unlegitGurke/RC-Car/Diplomarbeit/Athena/Eidesstattliche.tex

\vspace*{0cm}
\begin{center}
\textbf{\Huge{Eidesstattliche Erklärung}}
\end{center}
\vspace{1cm}
Wir erklären an Eides statt, dass wir die vorliegende Arbeit selbstständig und ohne fremde Hilfe verfasst, andere als die angegebenen Quellen nicht benutzt und die den benutzten Quellen wörtlich und inhaltlich entnommenen Stellen als solche kenntlich gemacht haben.\\
Wir versichern, dass wir dieses Diplomarbeitsthema bisher weder im In- noch im Ausland (einer Beurteilerin oder einem Beurteiler) in irgendeiner Form als Prüfungsarbeit vorgelegt haben.

% \usepackage{array} is required
\vspace*{3cm}
\begin{center}
\begin{tabular}{
	>{\centering\arraybackslash}p{4cm}
	>{\centering\arraybackslash}p{4cm}
	>{\centering\arraybackslash}p{4cm}}
            \hrulefill         &  & \hrulefill      \\
            Felix Sandri       &  & Philipp Kaltenleitner     \vspace*{1.5cm}\\ 
            \hrulefill         &  & \hrulefill      \\
            Mert Gürel         &  & David Petrovic            \vspace*{2cm}\\
            & \hrulefill & \\
            & Ort, Datum & \\
\end{tabular} 
\end{center}
