unlegitGurke/RC-Car/Diplomarbeit/Athena/Deckblatt.tex

% Beginn - Formatierung der Titelseite

\vspace*{3pt}
\parbox[c]{80mm}{
	\begin{Large}\textbf{HTBLuVA Salzburg }\end{Large} \newline
	\textbf{Höhere Lehranstalt für Elektrotechnik} \newline
	Ausbildungsschwerpunkt: \newline Energiesysteme und Industrieelektronik
}
\hfill
\parbox[c]{60mm}{  
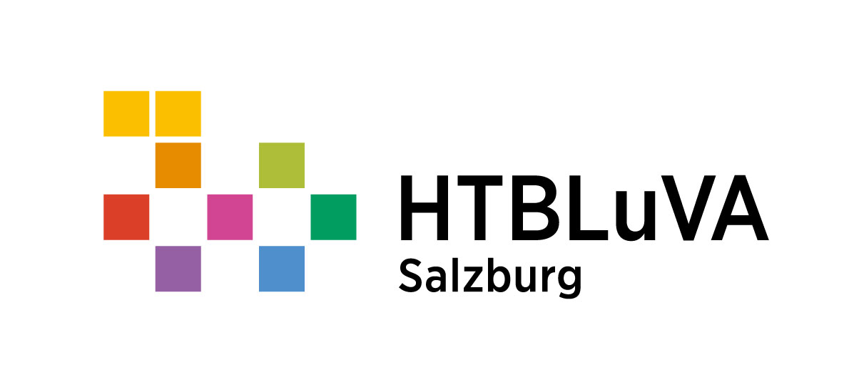
[picture p1: Diplomarbeit/Athena/Abbildungen/HTBLuVA_Salzburg_Logo_RGB.jpg]
	
}
\hrule\relax

\vspace*{30mm}
\begin{center} 
\begin{Huge}\textbf{Diplomarbeit}\end{Huge} \par \bigskip 
\begin{Large}5BHET 2023/24 \par \bigskip 
Höhere Technische Bundeslehr- und Versuchsanstalt Salzburg \par \bigskip 
Abteilung für Elektrotechnik\end{Large} 
\vspace*{20mm}

%		In der Hautpdatei nach \usepackage{a4} folgendes Einfügen:
%		\title{Entwicklung einer Diplomarbeitsvorlage}

\begin{huge}
	\makeatletter
	\textbf{\@title \\[1ex]}
	\makeatother
\end{huge}
\end{center}

\vspace{3cm}
\parbox[c]{60mm}{%
	\textbf{Ausgeführt von:}\par
	Felix Sandri\\
	Philipp Kaltenleitner\\	
	Mert Gürel\\
	David Petrovic\\
}%
\hfill%
\parbox[c]{70mm}{%
	\textbf{Betreuer}:\par
	Prof. Dipl.-Ing. Robert Fuchs\\
	Prof. Dipl.-Ing. Reinhold Benedikter\\
	BSc Simon Dantendorfer\\
	Prof. Dipl.-Ing. Timo Huemer\\
}%

\newpage
% Ende - Formatierung der Titelseite
