unlegitGurke/RC-Car/Diplomarbeit/Athena/3_Stand_der_Technik/9_Sensorik.tex

\newpage
\fancyfoot[C]{Gürel}
\section{Sensorik}
\input{./3_Stand_der_Technik/9.4_lidar.tex}

\input{./3_Stand_der_Technik/9.5_sonar.tex}

\input{./3_Stand_der_Technik/9.6_radar.tex}
	
\input{./3_Stand_der_Technik/9.7_kameras.tex}
