unlegitGurke/RC-Car/Diplomarbeit/Athena/0_Vorwort/Vorwort.tex

\chapter*{Vorwort}
	Im Rahmen der Ausbildung an der HTBLuVA Salzburg bietet die Diplomarbeit einen ersten umfassenden Einblick in wissenschaftliches und eigenständiges Arbeiten. Nur durch unser, im Laufe der letzten fünf Jahre erlentes, Wissen ist es uns möglich ein solch umfangreiches Projekt umzusetzten.  Wir sind dankbar für die herausragende Ausbildung, die uns in sämtlichen technischen Bereichen vermittelt wurde. \
			\
			Weiter bedanken wir uns bei allen Lehrpersonen, die uns im Laufe der Projektentwicklung geholfen und unterstützt haben. Besonders möchten Wir uns bei Herrn Dantendorfer sowie auch bei Herrn Maximilian Ernst Tschuchnig und Herrn Lukas Portenschlager aus der FH Salzburg für ihren Beitrag bei der Implementierung von den ROS und KI Applikationen bedanken.
			Wir hoffen, dass unsere Diplomarbeit dazu beitragen wird, das Interesse an technischen Projekten und der Elektromobilität zu wecken. Sie soll junge Menschen ermutigen, eine Ausbildung in diesem Bereich zu wählen.
