unlegitGurke/RC-Car/Diplomarbeit/Athena/3_Stand_der_Technik/11.1.4_GitHub.tex

\subsubsection{GitHub}
GitHub ist eine webbasierte Plattform für die Versionsverwaltung, die von Millionen von Entwicklern und Unternehmen weltweit genutzt wird.
Es bietet eine Vielzahl von Funktionen, darunter die Verwaltung von Repositories, Issue-Tracking, Pull-Requests, Wikis und vieles mehr. 
GitHub erleichtert die Zusammenarbeit und den Wissensaustausch zwischen Entwicklern und ermöglicht es ihnen, hochwertige Softwarelösungen effizient zu entwickeln.
