unlegitGurke/RC-Car/Diplomarbeit/Athena/3_Stand_der_Technik/9.6_radar.tex

\fancyfoot[C]{Gürel}
\subsection{Radar Sensoren}
Radar (Radio Detection and Ranging) Sensoren bestehen aus einer Sendeantenne und einer Empfangsantenne. Die Sendeantenne sendet hochfrequente elektromagnetische Wellen aus, die von Objekten reflektiert werden und von der Empfangsantenne erfasst werden. Die Zeitmessung zwischen Aussenden und Empfangen des Signals ermöglicht die Berechnung der Entfernung zum Objekt. 

Radar bietet eine effektive Möglichkeit, Entfernungen zu messen und Bewegungen zu verfolgen. Es wird häufig in der Luft- und Seefahrt, der Wetterbeobachtung, der Verkehrsüberwachung und der militärischen Anwendung eingesetzt. Im Vergleich zu LiDAR und Ultraschallsensoren bietet Radar eine größere Reichweite und ist weniger anfällig für Umwelteinflüsse wie Nebel oder Regen.
