unlegitGurke/RC-Car/Diplomarbeit/Athena/7_KI/KI.tex

\fancyfoot[C]{Gürel}
\chapter{Entwicklung KI und Sensorik}
	
	\input{./7_KI/ueberlegungen.tex}
	
	\input{./7_KI/sensorik.tex}
	
	\input{./7_KI/personenerkennung.tex}
	
	\input{./7_KI/ROS.tex}
