unlegitGurke/RC-Car/Diplomarbeit/Athena/3_Stand_der_Technik/7_Motoren.tex

\fancyfoot[C]{Sandri}
\section{Elektrische Antriebsmaschinen} \label{Motoren}
Elektrische Maschinen wandeln elektrische Energie in mechanische Energie um, indem sie das Prinzip der Lorenzkraft beziehungsweise Reluktanzkraft anwenden um einen Rotor zu rotieren. Der grundsätzliche Aufbau eines elektrischen Motors besteht grundsätzlich aus einem Stator, dem nicht-rotierendem Teil, und einem Rotor, dem sich rotierenden teil. Je nach Typ und Ausführung des Motors sind auf beiden Komponenten Wicklungen beziehungweise Dauermagnete befestigt. Bei einigen Motoren sind auch noch andere Bauteile verbaut.

\subsubsection{Lorentzkraft}
	Die Lorentzkraft wirkt auf bewegliche Lasungsträger in einem Magnetfeld. Sie wirkt senkrecht zur Bewegungsrichtung der Ladung und senkrecht zu den Feldlinien des Magnetfelds. Wie sich die Lorentzkraft verhält, lässt sich anhand folgendem Beispiel, einer Leiterschaukel erklären:

	\begin{figure}[H]
			\centering
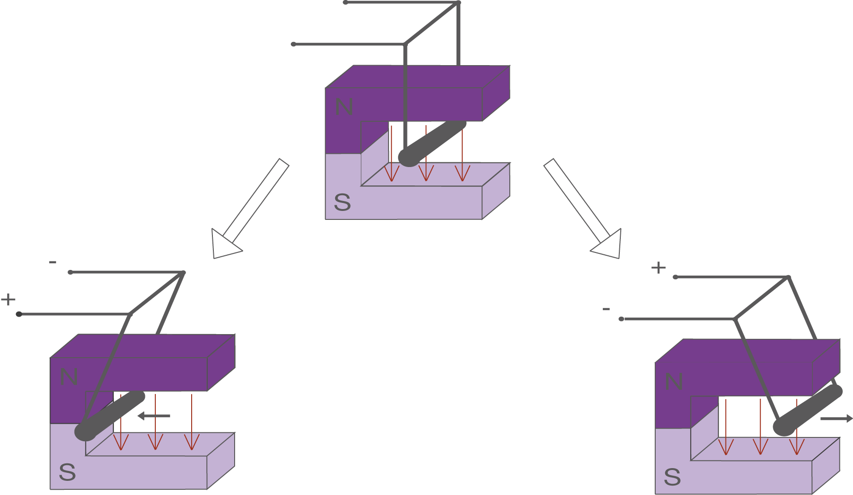
[picture p59: Diplomarbeit/Athena/3_Stand_der_Technik/Abbildungen/Leiterschaukel_1.png]
			
			\caption{Änderung der Stromrichtung Lorentzkraft\cite{schullv.de2024}}
	\end{figure}
	
	Die Richtung in welche die Leiterschaukel ausschlägt, ist zum einen Abhängig von der Richtung des Stroms und zum anderen von der Orientierung des Magnetfelds.
	
	\begin{figure}[H]
			\centering
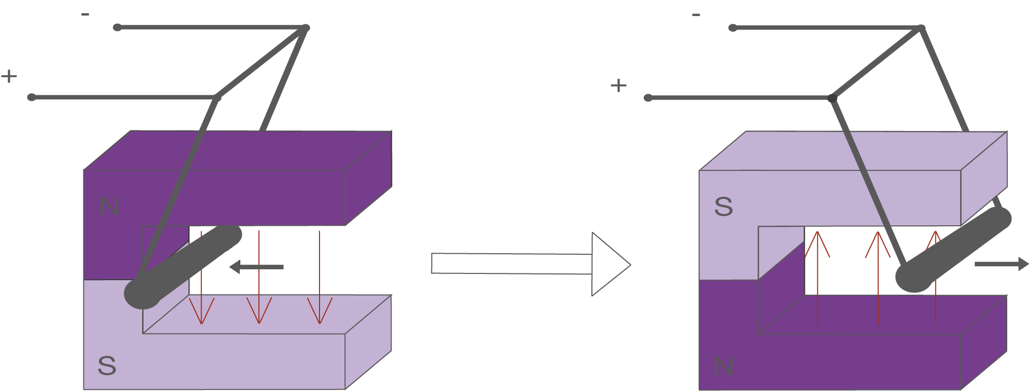
[picture p60: Diplomarbeit/Athena/3_Stand_der_Technik/Abbildungen/Leiterschaukel_2.png]
			
			\caption{Änderung des Magnetfelds Lorentzkraft\cite{schullv.de2024}}
	\end{figure}
	
	Die Richtung der Lorentzkraft kann auch durch einen einfachen Versuch, den linke Hand Versuch, ermittelt werden:
	
	\begin{figure}[H]
			\centering
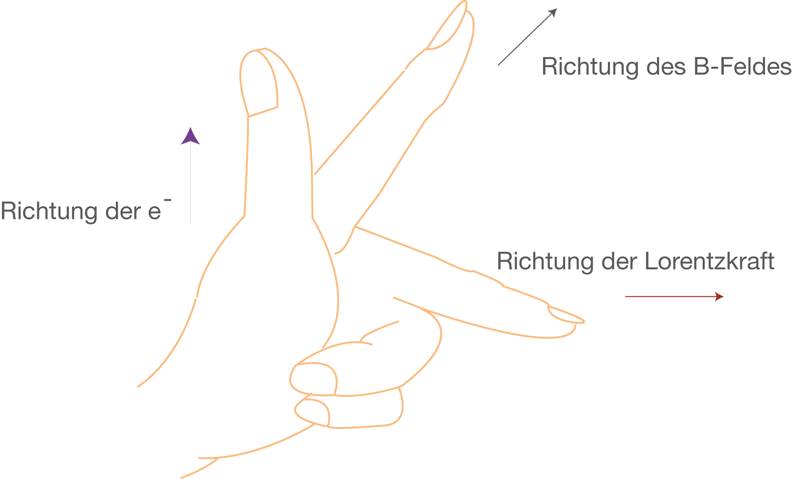
[picture p61: Diplomarbeit/Athena/3_Stand_der_Technik/Abbildungen/Lorentzkraft_1.png]
			
			\caption{Die linke Hand Regel\cite{schullv.de2024}}
	\end{figure}

	Mathematisch kann die Richtung der Lorentzkraft mihilfe des Kreuzprodukts aus der Magnetfeldrichtung und der Bewegungsrichtung der Elektronen errechnet werden:
	
	\begin{equation}
		\vec{F_{L}} = q * (\vec{v_{e}} \times \vec{B})
	\end{equation}
	
	Der Betrag kann wiefolgt errechnet werden:
	
	\begin{equation}
		F_{L} = q*v*B*\sin{\alpha}
	\end{equation}
	
	Wobei der Winkel $\alpha$ den Winkel zwischen der Bewegungsrichtung der Elektronen und der Bewegungsrichtung des Magnetfelds entspricht. Auch kann man anhand dieser Formel erkennen, dass die Lorentzkraft null wird, wenn die Bewegungsrichtung der Elektronen und die des Magnetfelds parallel verläuft.\cite{schullv.de2024}
	
	Die meisten elektrischen Maschinen funktionieren grundsätzlich aufgrund der Lorentzraft, es gibt jedoch vereinzelt Maschinen, die nur aufgrund der Reluktanzkraft funktionieren.

\subsubsection{Reluktanzkraft}

	Die Reluktanzkraft (auch Maxwellsche Kraft genannt) entsteht durch Änderung des magnetischen Widerstands. Sie wirkt immer so, dass sich der magnetische Widerstand verringert und die Induktivität steigt. Diese Kraft kann durch Veränderung des Luftspalts im magnetischen Kreis erzeugt werden.\cite{biancahoegel.de/2021}
	
	\input{./3_Stand_der_Technik/7.1_Asynchronmaschine}
	
	\input{./3_Stand_der_Technik/7.2_Gleichstrommaschine}
	
	\input{./3_Stand_der_Technik/7.3_Synchronmaschine}
	
	\input{./3_Stand_der_Technik/7.4_Positionsmessung}
	
	\input{./3_Stand_der_Technik/7.5_BLDC_Regelung}
	
	\input{./3_Stand_der_Technik/7.6_FOC_Regelung}
