unlegitGurke/RC-Car/Diplomarbeit/Athena/3_Stand_der_Technik/7.1_Asynchronmaschine.tex

\subsection{Asynchronmaschine}
	Die Asynchronmaschine ist die einfachste Form einer elektrischen Maschine. Sie wird angetrieben durch ein Drehfeld, welches durch eine mehrsträngige Wicklung im Stator erzeugt wird. Der große Vorteil des Asynchronmaschine ist ihre einfache Bauform und Funktionsweise. Auch bedarf sie nur geringer Wartung. Der große Nachteil hingegen ist jedoch seine startk an die Frequenz der Eingangsspannung gebundene Drehzahl. Im gebräuchlichen 50-Hz-Betrieb sind nur Drehzahlen von 3000U/min, 1500U/min, 1000U/min, abhängig von der Anzahl der Polpaare.
	
	\begin{equation}
		n \thickapprox f / p
	\end{equation}
	
	n $\cdots$ Motordrehzahl \newline
	f $\cdots$ Frequenz vom Netz	\newline
	p $\cdots$ Anzahl der Polpaare \newline
	
	Es gibt hauptsächlich zwei Typen der Asynchronmaschine, den Käfigläufer und den Schleifringläufer. Der Käfigläufer verwendet also Rotor eines Stahlkäfig, der Schleifringläufer hat Schleifringe, über die Wicklungen im Rotor bestromt werden.
	
	\begin{figure}[H]
			\centering
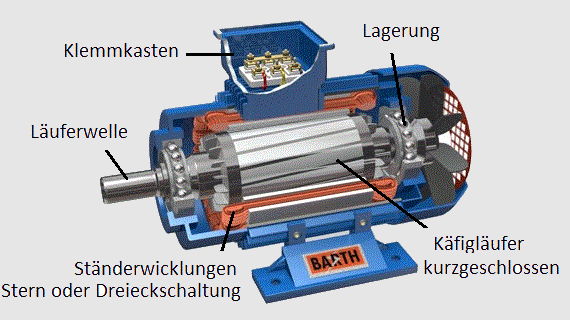
[picture p71: Diplomarbeit/Athena/3_Stand_der_Technik/Abbildungen/Asynchronmaschine_2.png]
			
			\caption{Aufbau Käfigläufer\cite{kfzaufgaben.de2024}}
	\end{figure}
	
	\begin{figure}[H]
			\centering
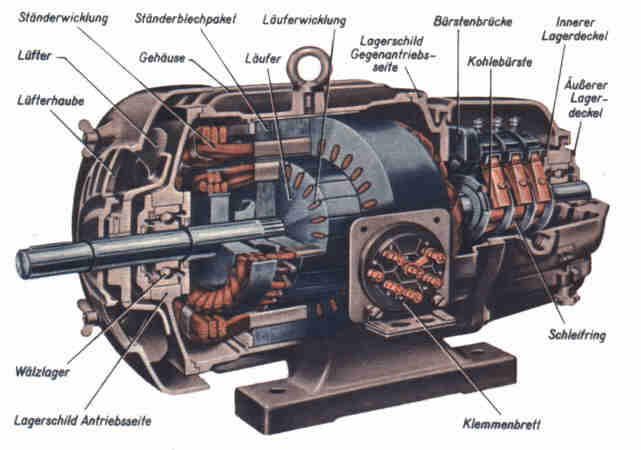
[picture p72: Diplomarbeit/Athena/3_Stand_der_Technik/Abbildungen/Asynchronmaschine_3.jpg]
			
			\caption{Aufbau Schleifringläufer\cite{wupperindustrie.de2024}}
	\end{figure}

	Betrieben wird die Asynchronmaschine indem sie an das 3-phasige 50Hz-Netz angeschlossen wird. Sie dreht sich dadurch fast synchron mit der Netzfrequenz. Asynchronmaschinen laufen ihrem Feld jedoch immer etwas hinterher, diese Eigenschaft nennt man Schlupf. Das Drehmoment- und Drehzahlverhalten kann sehr gut mittels eines Kreisdiagramms dargestellt werden.\cite{Fischer2017}
	
	\begin{figure}[H]
			\centering
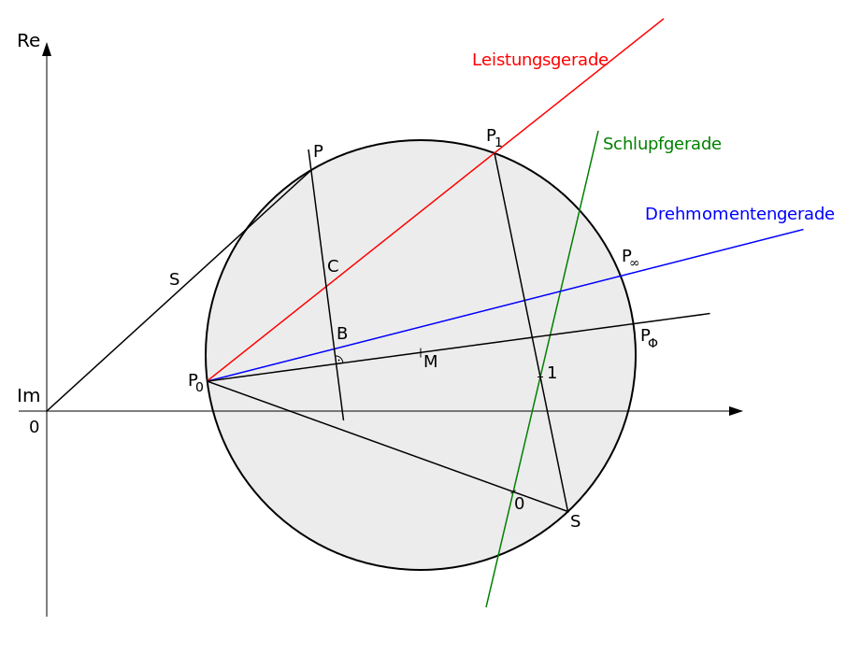
[picture p73: Diplomarbeit/Athena/3_Stand_der_Technik/Abbildungen/Kreisdiagramm_1.png]
			
			\caption{Kreisdiagram einer Asynchronmaschine\cite{Wikipedia2024}}
	\end{figure}
