unlegitGurke/RC-Car/Diplomarbeit/Athena/3_Stand_der_Technik/7.3_Synchronmaschine.tex

\subsection{Synchronmaschine}
	Die Synchronmaschien ist ähnlich wie die Asynchronmaschine aufgebaut, sie läuft jedoch immer synchron mit ihrem Drehfeld. Zur Regelung der Synchronmaschine ist ein Frequenzumrichter unbedingt nötig. Aufgrund der sinkenden Kosten von Frequenzumrichtern, wird die Synchronmaschine immer weiter verbreitet. Mithilfe eines guten Frequenzumrichters ist es möglich Drehmoment oder Drehzahl genau zu regeln. Synchronmaschinen erzeugen beim Betrieb eine elektromagnetische Kraft, welche wie ein Geneartor wirkt. Diese Kraft kann gemessen werden und nennt sich Back-EMF.\cite{zikodrive.com2024} Sie wird im sensorlosen Betrieb von Synchronmaschinen verwendet um die genaue Drehzahl der Maschien zu ermitteln. Die Synchronmaschine ist in einigen verschiedenen Bauformen verbreitet:
	
	\subsubsection{Bürstenlose Gleichstrommaschine (BLDC-Maschine)}
		Die BLDC-Maschine wird verwendet, wenn hohes Drehmoment und hohe Drehzahl benötigt wird. Der Rotor besteht aus Permanentmagneten. Die Maschine kann mithilfe einer simplen Schaltung besthend aus 6 MOSFETs einfach geregelt werden.(siehe \ref{Trapezfoermige Regelung}) Die BLDC-Maschine gibt ein Trapezförmiges Back-EMF zurück.\cite{Rode2023}
		
	\begin{figure}[H]
			\centering
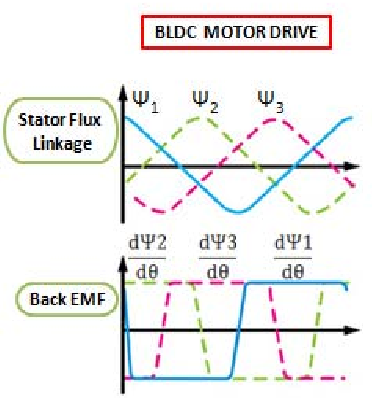
[picture p74: Diplomarbeit/Athena/3_Stand_der_Technik/Abbildungen/BLDC_Back-EMF_1.png]
			
			\caption{Back-EMF BLDC-Maschine\cite{Rode2023}}
	\end{figure}
		
	\subsubsection{Permanent erregte Synchronmaschine (PMSM-Maschine)}
		Die PMSM-Maschine isst vom Aufbau fast gleich wie die BLDC-Maschine, nur sind die Magneten im Rotor anders angeordnet. Diese Maschine kann nur mit FOC-Regelung(siehe \ref{Feldorientierte Regelung}) angesteuert werden, welche in der Regel etwas teuer und aufwändiger ist. Sie wird mithilfe von einem sinusförmigen Drehfeld geregelt und gibt auch ein sinusförmiges Back-EMF zurück. Sie ist effizienter als die BLDC Maschine und kann auch bei sehr niedrigen und sehr hohen Drehzahlen ohne Probleme verwendet werden. Sie wird verwendet wenn es nötig ist Drehzahl oder Drehmoment genau zu kontrollieren.\cite{Rode2023}
		
	\begin{figure}[H]
			\centering
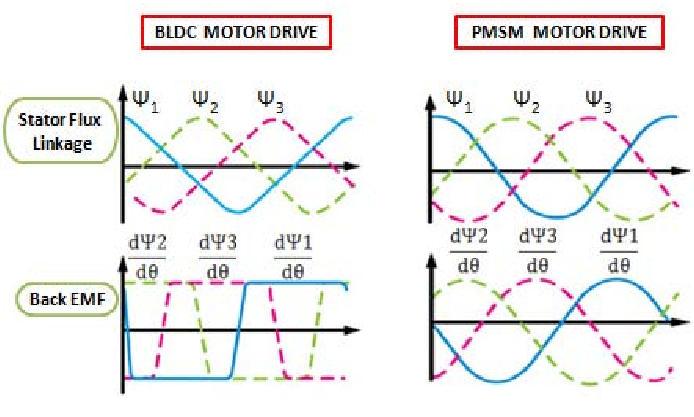
[picture p75: Diplomarbeit/Athena/3_Stand_der_Technik/Abbildungen/PMSM_Back-EMF_1.png]
			
			\caption{Back-EMF PMSM-Maschine\cite{Rode2023}}
	\end{figure}
		
	\subsubsection{Fremderregte Synchronmaschine (FSM-Maschine)}
		Die fremderregte Synchronmaschine hat nun im Rotor statt Permanentmagneten Erregerwicklungen, welche entweder durch Schleifringe oder über einen Luftspalt induziert Energie übertragen bekommen. Sie werden großteils im Generatorbetrieb eingesetzt, da die erzeugte Leistung einfach geregelt werden kann und sie über ihren gesamten Leistungsbereich sehr effizient sind.
	
	\subsubsection{Reluktanzmaschine}
		Bei der Reluktanzmaschine besteht der Rotor der Maschine aus Elektroblech. Es wird nicht wie bei üblichen Maschinen das Prinzip der Lorentzkraft sondern ausschließlich das der Reluktanzkraft angewandt. Aufgrund dessen hat dieser Motor eine eher geringe Leistungsdichte, ist aber im Gegenzug sehr günstig zu fertigen und zu kühlen.\cite{oswos.com2024}
