unlegitGurke/RC-Car/Diplomarbeit/Athena/3_Stand_der_Technik/3.1_Arten_von_Lasern.tex

\subsection{Arten von Lasern}
	Allgemein können Laser in fünf unterschiedliche Typen unterteilt werden:
	\begin{itemize}
		
		\item Gaslaser
		\item Festkörperlaser
		\item Diodenlaser
		\item Freie Elektronenlaser
		\item Farbstofflaser
		
	\end{itemize}
	Das Laseraktive Medium kann entweder durch das optische Pumpen (mit Licht), durch Strom oder durch einen chemischen Prozess angeregt werden.
	Es eignet sich jedoch nicht jeder Laser zur Materialverarbeitung.\cite{eval.at2024} Die in der Materialverarbeitung am verbreitensten Laser sind folgende:
	
	\subsubsection{CO2-Laser}
		Dies ist der in der Industrie am meist verbreiteste Gaslaser, andere Gaslaser z.B N2-Laser oder Excimerlaser haben eine ähnliche Funktionsweise, aber andere Eigenschafften. Durch Zufuhr von elektrischer Energie über Elektroden in ein Gasgemisch von ca. 70\% He, 20\% N2 und 10\% CO2 wird das Gas zunächst in ein elektrisch leitendes Plasma verwandelt, welches anschließend durch eine Reihe von Spiegeln konzentriert und fokussiert wird. Da diese Laser einen Wirkungsgrad von maximal 15\% haben, sie bei hohen Leistungen eine sehr hohe Verlustleistung, die abgeführt werden muss. sie werden deswegen im Bereich von 10 bis 200Watt zum Schneiden und gravieren von dünnen organischen Materialien wie Kunsstoffe, Holz oder Textilien verwendet.\cite{eval.at2024}
	
	\begin{figure}[H]
		\centering
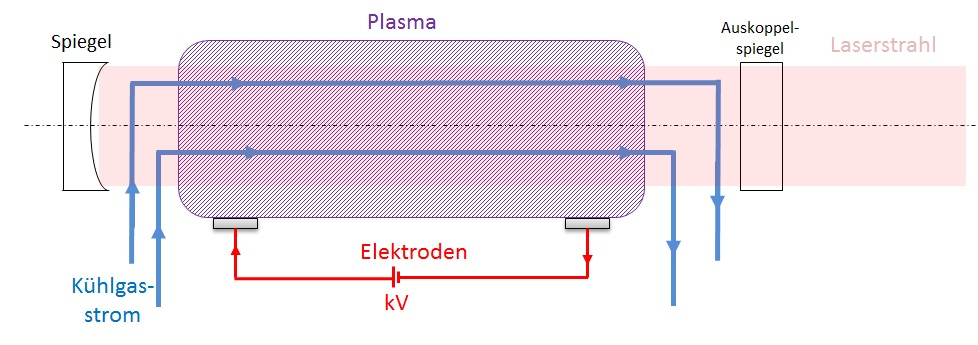
[picture p76: Diplomarbeit/Athena/3_Stand_der_Technik/Abbildungen/Gaslaser_1.jpg]
		
		\caption{Aufbau eines Gaslasers\cite{eval.at2024}}
	\end{figure}
	
	\subsubsection{HeNe-Laser}
		Der HeNe Laser ist ein Gaslaser mit ähnlicher Funktionsweise zum CO2-Laser. Ér wird meistens als Justierlaser verwendet, da er mit einer Leistung von unter 5mW einen sehr gut sichtbaren roten Laser erzeugt. Es sind auch andere Farben bzw Wellenlängen möglich.\cite{eval.at2024}
		
	\subsubsection{Nd:YAG-Laser}
		Bei diesem Laser besteht das Lasermedium aus einem Kristall, die Energiezufuhr erfolgt durch Licht. Ein Nd:YAG-Laser(Neodym-dotierter Yttrium-Aluminium-Granat-Laser) emittiert meist eine infrarote Strahlung. Die Form dieses Kristalls ist meist in Stabform z.B. mit Durchmesser von 1cm und einer Länge von 10cm. Er wird zwichen zwei Spiegeln positioniert und durch Blitzlampen oder Laserdionden angepumpt. Der mit Blitzlampen angepumpte Nd:YAG Laser is weiterhin der am meist verbreitete Festkörperlaser. Ein großer Vorteil dieses Lasers ist auch, dass er sich im Gegensatz zum CO2-Laser durch eine Glasfaßer leiten lässt und so für den Einsatz auf Roboterarmen geeignet ist.\cite{eval.at2024}
		
		\begin{figure}[H]
			\centering
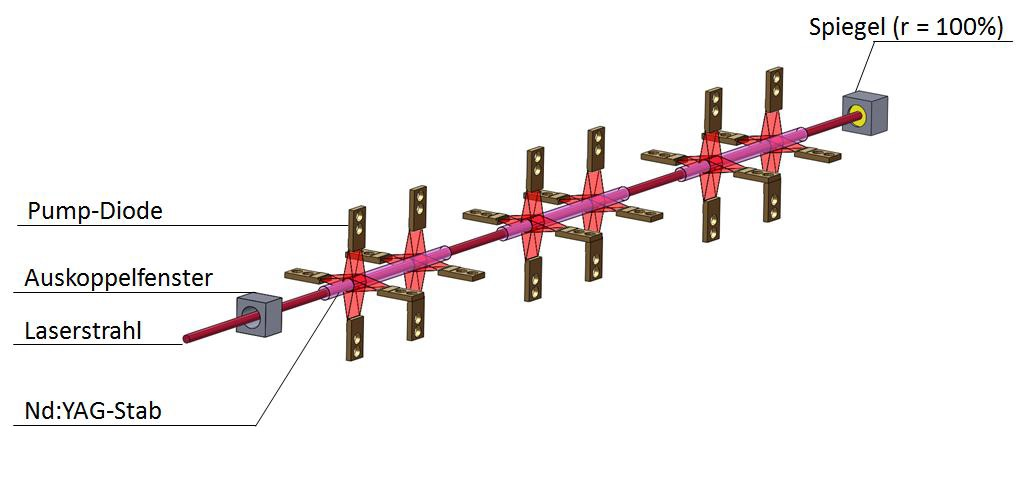
[picture p77: Diplomarbeit/Athena/3_Stand_der_Technik/Abbildungen/NdYAGlaser_1.jpg]
			
			\caption{Aufbau eines Nd:YAG-Lasers\cite{eval.at2024}}
		\end{figure}
		
	\subsubsection{Faserlaser}
		Der Faserlaser besteht aus mehreren Metern lichtleitenden Faser, die mit laseraktiven Atomen dotiert sind. Durch den geringen Durchmeser dieser,(<100micrometer) erzeugt er nur Licht höchster Strahlqualität und erreicht eine Effizienz von bis zu 30\%.\cite{eval.at2024}
		
	\subsubsection{Diodenlaser}
		Der Diodenlaser funktionier aufgrund vom Prinzip des pn-Übergangs von Halbleitern. Er hat eine sehr kompakte Bauweise und einen sehr hohen Wirkungsgrad von bis zu 50\%. Er besitzt im Vergleich zu anderen Lasern jedoch schlechter Strahlenqualität und eignet sich so eher nicht zum Schneiden.\cite{eval.at2024}
		
		\begin{figure}[H]
			\centering
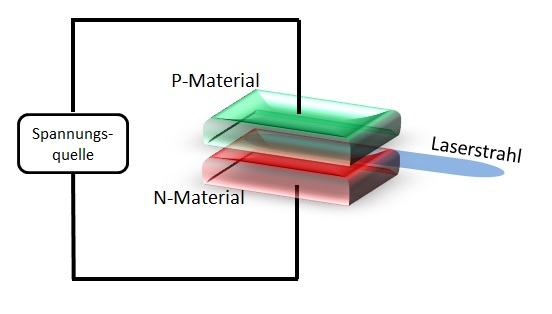
[picture p78: Diplomarbeit/Athena/3_Stand_der_Technik/Abbildungen/Diodenlaser_1.jpg]
			
			\caption{Aufbau eines Diodenlasers\cite{eval.at2024}}
		\end{figure}
