unlegitGurke/RC-Car/Diplomarbeit/Athena/3_Stand_der_Technik/3.3_Sicherheitsvorkehrungen.tex

\subsection{Sicherheitsvorkehrungen}
	Die Strahlung von Lasern kann sehr schnell für Auge und Haut gefährlich werden, deswegen gibt es einige wichtige Sicherheitsvorkehrungen, die eingehalten werden müssen.
	\begin{itemize}
		\item Laserstrahl nie auf andere Personen richten
		\item Laserstrahl nie auf direkt reflektierende Oberflächen richten
		\item Nicht in den direkten oder reflektierten Strahl blicken
		\item Keine optischen Instrumente(z.B. Lupe oder Fernglas) zur Beobachtung des Laserstrahl verwenden
		\item Niemals die Laserquelle manipulieren.
	\end{itemize}
	Lasergeräte werden außerdem vom Hersteller gemäß ihrem Gefährdungspotenzial in verschiedene Klassen eingeteilt. Maßgeblich dafür ist die DIN-Norm EN 60825-1. Die Klassen sind so eingeteilt, dass mit zunehmender Gefahr die Klassen höher wird. Diese Klassen reichen von 1 bis 4 und sind in 1, 1M, 1C, 2, 2M, 3A, 3R, 3B und 4 aufgeteilt.\cite{Strahlenschutz2024}
	
	\begin{figure}[H]
		\centering
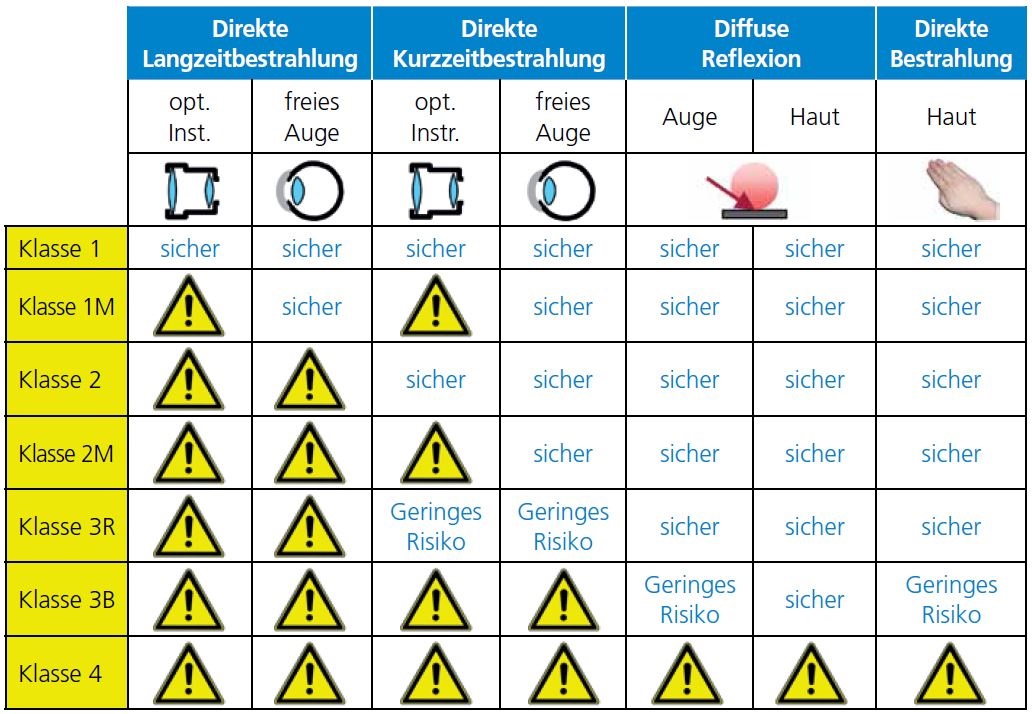
[picture p79: Diplomarbeit/Athena/3_Stand_der_Technik/Abbildungen/Laserklassen_1.jpg]
		
		\caption{Laser Sicherheitsklassen\cite{eval.at2024a}}
	\end{figure}
