unlegitGurke/RC-Car/Diplomarbeit/Athena/3_Stand_der_Technik/3_Laserschneiden.tex

\fancyfoot[C]{Sandri}
\section{Laserschneiden}
	Beim Laserschneiden können meist flache Werkstoffe verschiedenster Dicke mithilfe von einem konzentrierten Laserstrahl ohne Berührung geschnitten werden. Der Laserstrahl erhitzt dabei das Material an einem Punkt so stark, dass es sofort schmilzt oder verdampft. Mithilfe von einem Schneidgas kann das nun geschmolzene Material aus der Schnittfuge geblasen werden. Mit dieser Technik können eine Vielzahl an Materialien, wie zum Beispiel Holz, Acryl, Schaumstoff oder auch diverse Metalle wie Stahl, Edelstahl und Aluminium geschnitten werden. \cite{Trumpf2024}
	
	\input{./3_Stand_der_Technik/3.1_Arten_von_Lasern}
	
	\input{./3_Stand_der_Technik/3.2_Schneiden}
	
	\input{./3_Stand_der_Technik/3.3_Sicherheitsvorkehrungen}
