unlegitGurke/RC-Car/Daten und Überlegungen/Lipo Schutz.docx

Lipo Schutz

Lipo in Stahlbox. Aus Isolierung Lipobag.

Wenn möglich lüft dicht mit Einwegventile

Ausgang nach unten wegen druck

(wenns was bringt)
