unlegitGurke/RC-Car/Daten und Überlegungen/Sicherheitsabschaltung.docx

Antisparkswitch (https://flipsky.net/collections/new-arrival/products/flipsky-anti-spark-switch-aluminum-pcb-300a-for-electric-skateboard-ebike-scooter-robots) vor ESC schalten

Schalter von Antisparkswitch in Serie mit Optokuppler auf Raspberry PI Shield. Somit kann man alles abschalten bei Fehlfunktion.
