unlegitGurke/RC-Car/Diplomarbeit/Athena/Athena.tex

%%%%%%%%%%%%%%%%%%%%%%%%%%%%%%%%%%%%%%%%%%%%%%%%%%%%%%%%%%%%%
%% HEADER
%%%%%%%%%%%%%%%%%%%%%%%%%%%%%%%%%%%%%%%%%%%%%%%%%%%%%%%%%%%%%
\documentclass[a4paper,twoside,11pt]{report}
\usepackage{a4}

\title{Entwicklung und Fertigung eines selbstfahrenden Modellautos}
\author{Felix Sandri, Philipp Kaltenleitner, Mert Guerel, David Petrovic}

\usepackage[text={150mm,240mm},bindingoffset=1cm]{geometry}

%% Deutsche Anpassungen %%%%%%%%%%%%%%%%%%%%%%%%%%%%%%%%%%%%%
\usepackage[ngerman]{babel}
\usepackage[T1]{fontenc}
\usepackage[ansinew]{inputenc}

\usepackage{lmodern} %Type1-Schriftart für nicht-englische Texte
\usepackage{color}
\usepackage{xcolor}

\usepackage{array} %Für die Eidesstattliche Erklärung
\usepackage{float} %Fliegende Abbildungen / Objekte
\usepackage[margin=10pt,labelfont=bf,singlelinecheck=false]{caption}

\usepackage{hyperref}	%Querverweise
\usepackage{inputenc}
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

\definecolor{clr-background}{RGB}{255,255,255}
\definecolor{clr-text}{RGB}{0,0,0}
\definecolor{clr-string}{RGB}{163,21,21}
\definecolor{clr-namespace}{RGB}{0,0,0}
\definecolor{clr-preprocessor}{RGB}{128,128,128}
\definecolor{clr-keyword}{RGB}{0,0,255}
\definecolor{clr-type}{RGB}{43,145,175}
\definecolor{clr-variable}{RGB}{0,0,0}
\definecolor{clr-constant}{RGB}{111,0,138} % macro color
\definecolor{clr-comment}{RGB}{0,128,0}

\lstdefinestyle{VS2017}{
	backgroundcolor=\color{clr-background},
	basicstyle=\ttfamily\scriptsize\color{clr-text}, % any text
	stringstyle=\color{clr-string},
	identifierstyle=\color{clr-variable}, % just about anything that isn't a directive, comment, string or known type
	commentstyle=\color{clr-comment},
	%directivestyle=\color{clr-preprocessor}, % preprocessor commands
	% listings doesn't differentiate between types and keywords (e.g. int vs return)
	% use the user types color
	keywordstyle=\color{clr-type},
	keywordstyle={[2]\color{clr-constant}}, % you'll need to define these or use a custom language
	tabsize=4,
	numbers=left
}

%% Farbschema für C Code %%%%%%%%%%%%%%%%%%%%%%%%%%%%%%%%%%%%

\definecolor{gruen}{rgb}{0,0.6,0}
\definecolor{grau}{rgb}{0.5,0.5,0.5}
\definecolor{lila}{rgb}{0.58,0,0.82}
\definecolor{Hintergrund}{rgb}{0.95,0.95,0.92}
\definecolor{airforceblue}{rgb}{0.36, 0.54, 0.66}
\definecolor{brightgreen}{rgb}{0.4, 1.0, 0.0}
\definecolor{brilliantrose}{rgb}{1.0, 0.33, 0.64}

\lstdefinestyle{C_Code}{
    backgroundcolor=\color{Hintergrund},
    commentstyle=\color{gruen},
    keywordstyle=\color{magenta},
    numberstyle=\tiny\color{grau},
    stringstyle=\color{lila},
    basicstyle=\ttfamily\scriptsize,
    breakatwhitespace=false,
    breaklines=true,
    captionpos=b,
    keepspaces=true,
    numbers=left,
    numbersep=5pt,
    showspaces=false,
    showstringspaces=false,
}

%% Farbschema für Python Code %%%%%%%%%%%%%%%%%%%%%%%%%%%%%%%%

\lstdefinestyle{Python_Code}{
    backgroundcolor=\color{Hintergrund},
    commentstyle=\color{gruen},
    keywordstyle=\color{magenta},
    numberstyle=\tiny\color{grau},
    stringstyle=\color{lila},
    basicstyle=\ttfamily\scriptsize,
    breakatwhitespace=false,
    breaklines=true,
    captionpos=b,
    keepspaces=true,
    numbers=left,
    numbersep=5pt,
    showspaces=false,
    showstringspaces=false,
}

%% Farbschema für Konsole %%%%%%%%%%%%%%%%%%%%%%%%%%%%%%%%%%%%

\lstdefinestyle{Konsole}{
    backgroundcolor=\color{airforceblue},
    commentstyle=\color{green},
    keywordstyle=\color{orange},
    numberstyle=\tiny\color{brilliantrose},
    stringstyle=\color{brightgreen},
    basicstyle=\ttfamily\scriptsize,
    breakatwhitespace=false,
    breaklines=true,
    captionpos=b,
    keepspaces=true,
    numbers=left,
    numbersep=5pt,
    showspaces=false,
    showstringspaces=false,
}

\lstdefinelanguage{JavaScript}{
  keywords={typeof, new, true, false, catch, function, return, null, catch, switch, var, if, in, while, do, else, case, break},
  keywordstyle=\color{blue}\bfseries,
  ndkeywords={class, export, boolean, throw, implements, import, this},
  ndkeywordstyle=\color{darkgray}\bfseries,
  identifierstyle=\color{black},
  sensitive=false,
  comment=[l]{//},
  morecomment=[s]{/}{/},
  commentstyle=\color{purple}\ttfamily,
  stringstyle=\color{red}\ttfamily,
  morestring=[b]',
  morestring=[b]"
}

\lstdefinelanguage{CSS}{
  keywords={color,background,margin,padding,font,weight,display,position,top,left,right,bottom,list,style,border,size,white,space,min,width,height,transition,transform},
  sensitive=true,
  morecomment=[l]{//},
  morecomment=[s]{/}{/},
  morestring=[b]',
  morestring=[b]",
  alsoletter={-},
  alsodigit={.}
}

%% Rename listing to Code %%%%%%%%%%%%%%%%%%%%%%%%%%%%%%%%%%%
\renewcommand{\lstlistingname}{Code}
\renewcommand{\lstlistlistingname}{Codeverzeichnis}

%%%%%%%%%%%%%%%%%%%%%%%%%%%%%%%%%%%%%%%%%%%%%%%%%%%%%%%%%%%%%
%% DOKUMENT
%%%%%%%%%%%%%%%%%%%%%%%%%%%%%%%%%%%%%%%%%%%%%%%%%%%%%%%%%%%%%
\begin{document}

\fancyhead[RO,LE]{2023/24}
\fancyhead[C]{\leftmark} 
\fancyhead[RE,LO]{\parbox[c]{30mm}{%
    
}}

\fancyfoot[RO,LE]{\thepage}
\fancyfoot[C]{Sandri, Kaltenleitner, Gürel, Petrovic}
\fancyfoot[RE,LO]{5BHET}
\setlength{\headheight}{38pt}

%%%%%%%%%%%%%%%%%%%%%%%%% WICHTIG!
\fancypagestyle{plain}{}    %% Kapitel-Anfangsseiten habe einen Plain-Stil darum wird keine
														%% Kopf/Fußzeile angezeigt. Dieser Befehl verhindert dies
%%%%%%%%%%%%%%%%%%%%%%%%% WICHTIG!

\pagestyle{empty} %%Keine Kopf-/Fusszeilen auf den ersten Seiten.

%% Deckblatt %%%%%%%%%%%%%%%%%%%%%%%%%%%%%%%%%%%%%%%%%%%%%%%%
\input{Deckblatt} 

%% Eidesstattliche Erklärung %%%%%%%%%%%%%%%%%%%%%%%%%%%%%%%%
\newpage
\pagenumbering{Roman}
\input{Eidesstattliche}	

%% Vorwort %%%%%%%%%%%%%%%%%%%%%%%%%%%%%%%%%%%%%%%%%%%%%%%%%%
\newpage
\pagestyle{fancy}
\input{./0_Vorwort/Vorwort}

%% Abstract %%%%%%%%%%%%%%%%%%%%%%%%%%%%%%%%%%%%%%%%%%%%%%%%%
\newpage
\input{./0_Abstract/Abstract}

%% Inhaltsverzeichnis %%%%%%%%%%%%%%%%%%%%%%%%%%%%%%%%%%%%%%%
\clearpage
\tableofcontents %Inhaltsverzeichnis
\cleardoublepage %Das erste Kapitel soll auf einer ungeraden Seite beginnen.

\pagenumbering{arabic}

%% Einführung %%%%%%%%%%%%%%%%%%%%%%%%%%%%%%%%%%%%%%%%%%%%%%%
\newpage
\input{./1_Einfuehrung/Einfuehrung}

%% Einleitung %%%%%%%%%%%%%%%%%%%%%%%%%%%%%%%%%%%%%%%%%%%%%%%
\newpage
\input{./2_Einleitung/Einleitung}

%% Stand der Technik %%%%%%%%%%%%%%%%%%%%%%%%%%%%%%%%%%%%%%%%
\newpage
\input{./3_Stand_der_Technik/Stand_der_Technik}

%% Mechanik %%%%%%%%%%%%%%%%%%%%%%%%%%%%%%%%%%%%%%%%%%%%%%%%%
\newpage
\input{./4_Mechanik/Mechanik}

%% Elektronik %%%%%%%%%%%%%%%%%%%%%%%%%%%%%%%%%%%%%%%%%%%%%%%
\newpage
\input{./5_Elektronik/Elektronik}

%% Software %%%%%%%%%%%%%%%%%%%%%%%%%%%%%%%%%%%%%%%%%%%%%%%%%
\newpage
\input{./6_Software/Software}

%% Künstliche Intelligenz %%%%%%%%%%%%%%%%%%%%%%%%%%%%%%%%%%%
\newpage
\input{./7_KI/KI}

%% Ergebnisse %%%%%%%%%%%%%%%%%%%%%%%%%%%%%%%%%%%%%%%%%%%%%%%
\newpage
\input{./8_Ergebnisse/Ergebnisse}

%%%%%%%%%%%%%%%%%%%%%%%%%%%%%%%%%%%%%%%%%%%%%%%%%%%%%%%%%%%%%
%% LITERATUR UND ANDERE VERZEICHNISSE
%%%%%%%%%%%%%%%%%%%%%%%%%%%%%%%%%%%%%%%%%%%%%%%%%%%%%%%%%%%%%
\newpage
%% Ein kleiner Abstand zu den Kapiteln im Inhaltsverzeichnis (toc)
\addtocontents{toc}{\protect\vspace*{\baselineskip}}

%%%%%%%%%%%%%%%%%%%%%%%%%%%%%%%%%%%%%%%%%%%%%%%%%%%%%%%%%%%%%
%% LITERATUR UND ANDERE VERZEICHNISSE
%%%%%%%%%%%%%%%%%%%%%%%%%%%%%%%%%%%%%%%%%%%%%%%%%%%%%%%%%%%%%
%% Ein kleiner Abstand zu den Kapiteln im Inhaltsverzeichnis (toc)
\addtocontents{toc}{\protect\vspace*{\baselineskip}}

%% Literaturverzeichnis
\bibliographystyle{plain}
\bibliography{literatur}

%% Abbildungsverzeichnis
\clearpage
\addcontentsline{toc}{chapter}{Abbildungsverzeichnis}
\listoffigures

%% Tabellenverzeichnis
\clearpage
\addcontentsline{toc}{chapter}{Tabellenverzeichnis}
\listoftables

%%%%%%%%%%%%%%%%%%%%%%%%%%%%%%%%%%%%%%%%%%%%%%%%%%%%%%%%%%%%%
%% ANHÄNGE
%%%%%%%%%%%%%%%%%%%%%%%%%%%%%%%%%%%%%%%%%%%%%%%%%%%%%%%%%%%%%
\appendix
%% ==> Schreiben Sie hier Ihren Text oder fügen Sie externe Dateien ein.

%\input{Dateiname} %Eine Datei 'Dateiname.tex' wird hierfür benötigt.

\input{./9_Anhang/Anhang}

\end{document}
