unlegitGurke/RC-Car/Diplomarbeit/Athena/1_Einfuehrung/Einfuehrung.tex

\chapter{Einführung}
	
	\section{Projektteam}
	
		\begin{figure}[H]
    \centering
    \begin{minipage}[b]{0.48\textwidth}
        \centering
        
        \caption{Felix Sandri}
    \end{minipage}
    \begin{minipage}[b]{0.48\textwidth}
        \centering
        
        \caption{Philipp Kaltenleitner}
    \end{minipage}
	\end{figure}
	\begin{figure}[H]
    \centering
    \begin{minipage}[b]{0.48\textwidth}
        \centering
        
        \caption{Mert Gökay Gürel}
    \end{minipage}
    \begin{minipage}[b]{0.48\textwidth}
        \centering
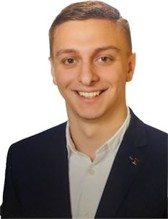
[picture p81: Diplomarbeit/Athena/1_Einfuehrung/Abbildungen/David_2.jpg]
        
        \caption{David Petrovic}
    \end{minipage}
	\end{figure}
\newpage

\section{Projektbetreuer}
	\begin{itemize}
		\item \textbf{Prof. Dipl.-Ing. Robert Fuchs} unterstützte Felix Sandri beim fertigen und implementieren des elektrischen Antriebssystems.
		\item \textbf{Prof. Dipl.-Ing. Reinhold Benedikter} war stets eine große Unterstützung während dem gesamten Verlauf des Projekts, er half beim Bestellen aller Komponenten und unterstützte Philipp Kaltenleitner erheblich beim Überarbeiten der Aufhängung und Lenkung.
		\item \textbf{BSc Simon Dantendorfer} unterstützte Mert Gürel bei Fragen bezüglich Optimierung der Software und Implementierung der ROS-Entwicklungsumgebung.
		\item \textbf{Prof. Dipl.-Ing. Timo Huemer} betreute David Petrovic bezüglich der Vorgehensweise während der Softwareentwicklung und dem Designprozess der Website.
	\end{itemize}

\section{Aufgabenteilung}

Felix Sandri
\begin{itemize}
\item Teamleitung
\item Entwicklung des Elektronischen Aufbaus
\item Antriebssystem
\item Platine
\item Softwareentwicklung Mikrocontroller
\item 3D-Druck der Bauteile
\end{itemize}

David Petrovic
\begin{itemize}
\item Kapitalbeschaffung
\item Benuteroberflächen
\item Websitendesign
\item Steuerung des Fahrzeuges
\item Interface 
\item Telemetriedatenverarbeitung
\end{itemize}

Philipp Kaltenleitner
\begin{itemize}
\item Mechanischer Aufbau
\item Design und Aufbau Antriebsstrang
\item Design und Aufbau Aufhängung
\item Design und Aufbau Lenkung
\item Design des Fharzeuges
\item  Fertigung und Zusammenbau mechanischer Bauteile
\end{itemize}

Mert Gürel
\begin{itemize}
\item Aufsetzen Hauptrechner
\item Software Entwicklung
\item ROS System
\item Kartographierung
\item Pathfinding
\item Personnenerkennung 
\end{itemize}
