unlegitGurke/RC-Car/Diplomarbeit/Athena/3_Stand_der_Technik/11.1.1_Software_Einleitung.tex

\fancyfoot[C]{Gürel}
\subsubsection{Softwareentwicklung Allgemein}
\paragraph{Planung und Entwurf: }
Die Planung und der Entwurf einer Softwarelösung bilden den Ausgangspunkt für jedes Entwicklungsprojekt.
Hierbei werden Anforderungen analysiert und spezifiziert, Architekturentscheidungen getroffen und das Design der Software definiert.
Techniken wie UML (Unified Modeling Language) werden häufig verwendet, um die Struktur und das Verhalten der Software zu modellieren und zu dokumentieren.

\paragraph{Programmiersprachen und Entwicklungsumgebungen: }
Die Wahl der Programmiersprache und der Entwicklungsumgebung beeinflusst maßgeblich die Art und Weise, wie eine Software entwickelt wird.
In Diplomarbeiten werden häufig Sprachen wie Python, Java, C++ oder JavaScript verwendet, je nach den Anforderungen des Projekts.
Entwicklungsumgebungen wie Visual Studio Code, IntelliJ IDEA oder Eclipse bieten Funktionen zur Entwicklung, Debugging und Versionsverwaltung von Softwareprojekten.
