unlegitGurke/RC-Car/Diplomarbeit/Athena/3_Stand_der_Technik/11.1.3_Versionsverwaltung.tex

\fancyfoot[C]{Gürel}
\subsubsection{Versionsverwaltung}
Versionsverwaltungssysteme ermöglichen Entwicklern, den Verlauf ihres Codes zu verfolgen, Änderungen zu verwalten und problemlos zusammenzuarbeiten. Unter den verschiedenen Optionen für Versionsverwaltung ist GitHub eine der am weitesten verbreiteten Plattformen, die von Millionen von Entwicklern weltweit genutzt wird.

\paragraph{Historie und Rückverfolgbarkeit: }
Ein zentrales Merkmal von Versionsverwaltungssystemen ist die Fähigkeit, den Verlauf aller Änderungen am Code zu verfolgen. Entwickler können durch die gesamte Historie des Projekts navigieren, um zu sehen, wer welche Änderungen vorgenommen hat und wann diese durchgeführt wurden. Dies ermöglicht eine detaillierte Rückverfolgbarkeit und erleichtert das Debugging und die Fehlerbehebung. Da nur die Veränderung am Code gespeichert wird, ist diese Art der Versionsverwaltung besonders effizient, da nicht für jede Version die komplette Datei neu gespeichert werden muss.

\paragraph{Zusammenarbeit und Teamarbeit: }
Versionsverwaltungssysteme ermöglichen eine effiziente Zusammenarbeit zwischen Entwicklern, auch wenn sie an verschiedenen Standorten arbeiten. Mehrere Entwickler können gleichzeitig am gleichen Projekt oder Code arbeiten, ohne sich gegenseitig zu stören. Durch die Möglichkeit, Branches zu erstellen und Merge-Anfragen zu stellen, können Entwickler ihre Arbeit isoliert voneinander durchführen und dann problemlos in den Hauptcode integrieren.

\paragraph{Branches und Forks: }
\textbf{Branches} sind Kopien des Codes, die unabhängig voneinander entwickelt werden können. Benutzer können Branches erstellen, um neue Funktionen zu implementieren oder Fehler zu beheben, ohne den Hauptcode zu modifizieren. Der Hauptcode wird in einem sogenannten "Master" -Branch verwaltet, während Entwickler für jede neue Funktion oder Änderung einen eigenen Branch erstellen können. Dies ermöglicht es, dass mehrere Entwickler gleichzeitig an verschiedenen Funktionen arbeiten können, ohne sich gegenseitig zu stören. Nachdem die Arbeit an einem Branch abgeschlossen ist und alle Tests erfolgreich durchgeführt wurden, kann der Branch mit dem Hauptcode (Master-Branch) fusioniert werden, um die Änderungen zu integrieren. Dieser Prozess wird als "Merge" bezeichnet und ermöglicht eine geordnete und effiziente Entwicklung von Softwareprojekten.
\begin{figure}[H]
    \centering
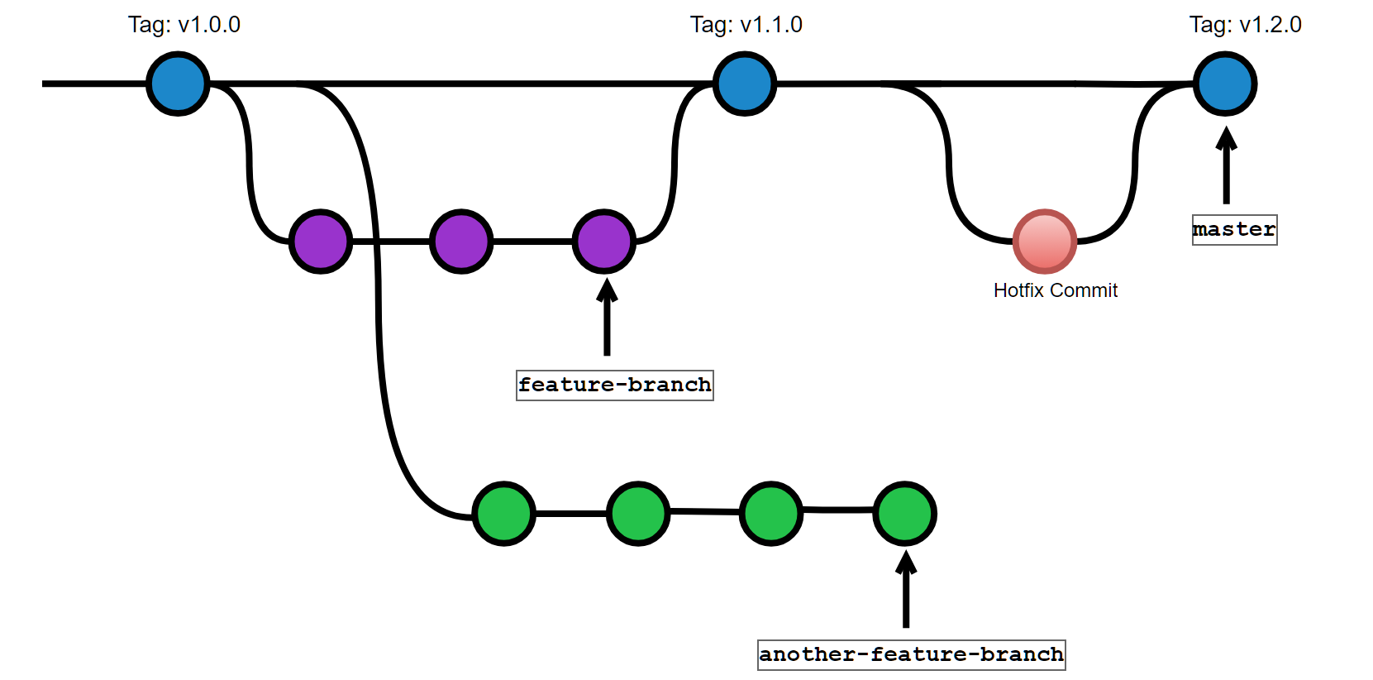
[picture p92: Diplomarbeit/Athena/3_Stand_der_Technik/Abbildungen/git_branch.png]
    
    \caption{Illustration vom aufbau einer Branch \cite{Capes2018}}
\end{figure}
\textbf{Forks} sind Kopien des gesamten Repositorys, die von einem anderen Entwickler erstellt werden. Sie ermöglichen es Entwicklern, Änderungen vorzunehmen und dann eine Merge-Anfrage zu stellen, um ihre Änderungen in das ursprüngliche Repository einzubringen. Oft werden Forks auch dafür genutzt um ein neues Projekt basierend auf dem Basisprojekt zu erstellen. Hierbei muss wieder die Lizenz beachtet werden.
