unlegitGurke/RC-Car/Diplomarbeit/Athena/3_Stand_der_Technik/11.8_CSS.tex

\subsection{CSS}

\begin{figure}[H]
			\centering
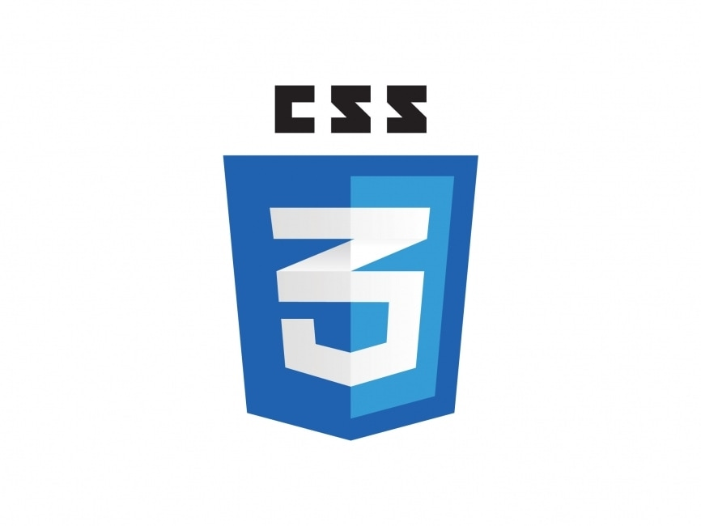
[picture p95: Diplomarbeit/Athena/3_Stand_der_Technik/Abbildungen/CSS_LOGO.jpg]
			
			\caption{CSS-Logo \cite{Wikipedia2024d}}
		\end{figure}

CSS, oder Cascading Style Sheets, ist eine Stylesheet-Sprache, die verwendet wird, um das Aussehen und die Formatierung von Webseiten zu definieren. Mit CSS können Entwickler das Layout, die Farben, Schriftarten und andere visuelle Aspekte einer Webseite gestalten. Durch die Trennung von Inhalt und Darstellung ermöglicht CSS eine konsistente und effiziente Gestaltung von Webseiten. CSS wird zusammen mit HTML verwendet, um ansprechende und benutzerfreundliche Webseiten zu erstellen.

	\subsubsection{Syntax und Struktur von CSS-Regeln} 
CSS-Regeln bestehen aus einem Selektor und einer Deklaration.
Der Selektor wählt das HTML-Element aus, das gestylt werden soll.
Die Deklaration besteht aus Eigenschaften und Werten, die das Aussehen des ausgewählten Elements definieren.\cite{ionos.de2024}

	\subsubsection{Verwendung von Selektoren zur Gestaltung von HTML-Elementen} 
Selektoren identifizieren die HTML-Elemente, auf die die CSS-Stile angewendet werden sollen.
Es gibt verschiedene Arten von Selektoren, darunter Elementselektoren, Klassenselektoren, ID-Selektoren und kombinierte Selektoren.\cite{ionos.de2024}

	\subsubsection{Grundlegende Eigenschaften und Werte für die Gestaltung von Layout und Design} 
CSS bietet eine Vielzahl von Eigenschaften und Werten zur Gestaltung von Layout und Design, wie zum Beispiel color, font-size, margin, padding, background-color usw.
Diese Eigenschaften und Werte ermöglichen es Entwicklern, die Größe, Farbe, Schriftart, Abstände und Hintergründe von HTML-Elementen anzupassen.\cite{ionos.de2024}

	\subsubsection{Layout und Positionierung} 
Positionierung von Elementen auf der Seite:
CSS ermöglicht die Positionierung von Elementen auf einer Webseite relativ zum Bildschirm oder zu anderen Elementen.
Die Positionierung kann mithilfe von Eigenschaften wie position, top, bottom, left und right gesteuert werden.
Einfache Layouttechniken wie Flexbox oder Floats:
Flexbox ist eine CSS-Layout-Technik, die das Erstellen von flexiblen und responsiven Layouts ermöglicht. Sie ermöglicht das einfache Anordnen von Elementen in einer Zeile oder Spalte und die dynamische Anpassung der Größe und Reihenfolge.
Floats sind eine ältere Layout-Technik, die verwendet werden kann, um Elemente zu einem bestimmten Bereich zu verschieben und den Textfluss um sie herum zu steuern. Sie werden oft für das Erstellen von Spaltenlayouts verwendet, obwohl Flexbox jetzt oft bevorzugt wird.
Diese einfachen Layout-Techniken ermöglichen es Entwicklern, das Design und die Anordnung von Elementen auf Webseiten zu steuern und ansprechende Layouts zu erstellen.\cite{ionos.de2024}

	\subsubsection{Stilisierung von Elementen} 
Anpassung von Farben, Schriftarten und Hintergründen:
Mit CSS können Farben, Schriftarten und Hintergründe von HTML-Elementen angepasst werden, um das Aussehen der Webseite zu verbessern.
Die Eigenschaften color, font-family, background-color und background-image sind einige Beispiele für Stileigenschaften, die verwendet werden können.
Einfache Animationen und Übergänge:
CSS ermöglicht es, Elemente auf der Seite zu animieren oder Übergänge zwischen Zuständen zu erstellen, um eine ansprechendere Benutzererfahrung zu schaffen.
Die animation- und transition-Eigenschaften werden verwendet, um einfache Animationen und Übergänge zu definieren, wie z.B. das Verschieben, Drehen oder Verblassen von Elementen.\cite{ionos.de2024}

	\subsubsection{Responsives Design} 
Grundlegende Anpassung des Layouts an verschiedene Bildschirmgrößen:
Responsives Design passt das Layout einer Webseite automatisch an verschiedene Bildschirmgrößen an.
Media Queries ermöglichen es, CSS-Regeln basierend auf den Eigenschaften des Geräts zu definieren.
Flexible Einheiten wie Prozentangaben oder relative Einheiten ermöglichen eine skalierbare Gestaltung.
Elemente können je nach Bildschirmgröße angezeigt, ausgeblendet oder umgestaltet werden.\cite{ionos.de2024}

	\subsubsection{Zusammenfassung und Zukunft} 
Zusammenfassung der wichtigsten CSS-Konzepte für die Telemetrie-Website:
Grundlegende CSS-Konzepte wie Layout, Stilisierung von Elementen und responsives Design wurden angewendet.
Mögliche Erweiterungen und Optimierungen für zukünftige Entwicklungen:
Fortgeschrittenere CSS-Techniken wie Grid Layouts könnten für komplexere Layouts verwendet werden.
Optimierung des CSS-Codes durch Bündelung und Minifizierung für verbesserte Ladezeiten.\cite{ionos.de2024}
