unlegitGurke/RC-Car/Diplomarbeit/Athena/3_Stand_der_Technik/11.5_Python.tex

\fancyfoot[C]{Gürel}
\subsection{Python}
Python ist eine interpretierte, hochrangige Programmiersprache, die für ihre Einfachheit, Vielseitigkeit und Lesbarkeit bekannt ist. Entwickelt von Guido van Rossum in den späten 1980er Jahren und erstmals veröffentlicht im Jahr 1991, hat sich Python zu einer der beliebtesten Programmiersprachen weltweit entwickelt.

\paragraph{Merkmale von Python:}

\begin{itemize}
    \item \textbf{Einfachheit:} Python legt großen Wert auf eine einfache und gut lesbare Syntax, die es Entwicklern ermöglicht, 
		Code schnell zu schreiben und zu verstehen. Dies macht Python besonders für Anfänger attraktiv. Diese Art Code zu schreiben wird auch als \textit{Pythonic} beschrieben.
		Diese kann man in jeder Pythonkonsole einsehen, indem man \textit{\textbf{import this}} eingibt.
\begin{figure}[H]
    \centering
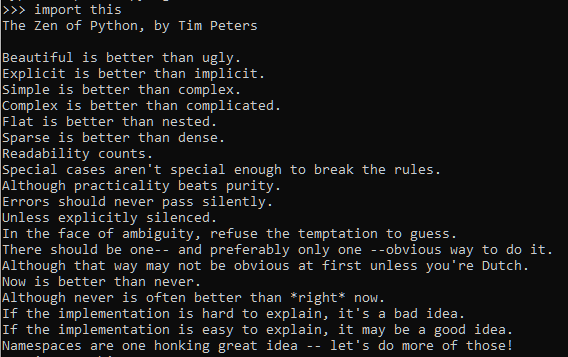
[picture p96: Diplomarbeit/Athena/3_Stand_der_Technik/Abbildungen/pythonic_way.png]
    
    \caption{Konsole, Pythonic Code}
\end{figure}
    \item \textbf{Vielseitigkeit:} Python wird in einer Vielzahl von Anwendungsbereichen eingesetzt, darunter Webentwicklung, Datenanalyse, künstliche Intelligenz, wissenschaftliches Rechnen, Automatisierung, Spieleentwicklung und mehr. Seine Vielseitigkeit und Flexibilität machen es zu einer äußerst nützlichen Programmiersprache.
    
    \item \textbf{Interpretation:} Python ist eine interpretierte Sprache, was bedeutet, dass der Code zur Laufzeit von einem Interpreter ausgeführt wird, anstatt im Voraus in Maschinencode übersetzt zu werden. Dies ermöglicht eine schnelle Entwicklung und einfache Fehlerbehebung.
    
    \item \textbf{Plattformunabhängigkeit:} Python-Code ist plattformunabhängig und läuft auf verschiedenen Betriebssystemen wie Windows, macOS und Linux. Dies bedeutet, dass Programme, die in Python geschrieben sind, ohne Änderungen auf verschiedenen Plattformen ausgeführt werden können.
    
    \item \textbf{Umfangreiche Standardbibliothek:} Python verfügt über eine umfangreiche Standardbibliothek, die eine Vielzahl von Funktionen und Modulen für verschiedene Zwecke bietet. Dadurch wird es einfacher, verschiedene Aufgaben zu erledigen, ohne zusätzliche Bibliotheken installieren zu müssen.
    
    \item \textbf{Dynamische Typisierung:} Python ist dynamisch typisiert, was bedeutet, dass Variablen nicht explizit typisiert werden müssen. Der Typ einer Variablen wird zur Laufzeit bestimmt, was die Flexibilität des Codes erhöht.
    
    \item \textbf{Aktive Community:} Python hat eine große und aktive Entwicklergemeinschaft, die ständig neue Bibliotheken, Frameworks und Werkzeuge entwickelt. Dieses reichhaltige Ökosystem trägt dazu bei, dass Python stets relevant und auf dem neuesten Stand der Technik bleibt.
\end{itemize}
