unlegitGurke/RC-Car/Diplomarbeit/Athena/3_Stand_der_Technik/6.4_Fertigung_Platine.tex

\fancyfoot[C]{Gürel}
\paragraph{Fertigung der Platine}

Die Herstellung von Platinen für den Anschluss der Elektronischen Geräte und Sensoren im Auto ist unvermeidlich. 
Die Verwendung von Platinen bietet zahlreiche Vorteile, da sie eine Vielzahl von Steckverbindungen und Komponenten aufnehmen können, 
die mit herkömmlicher Drahtverbindungen technisch nur schwer realisierbar wären.

\begin{figure}[H]
    \centering
    \begin{minipage}[b]{0.45\textwidth}
        \centering
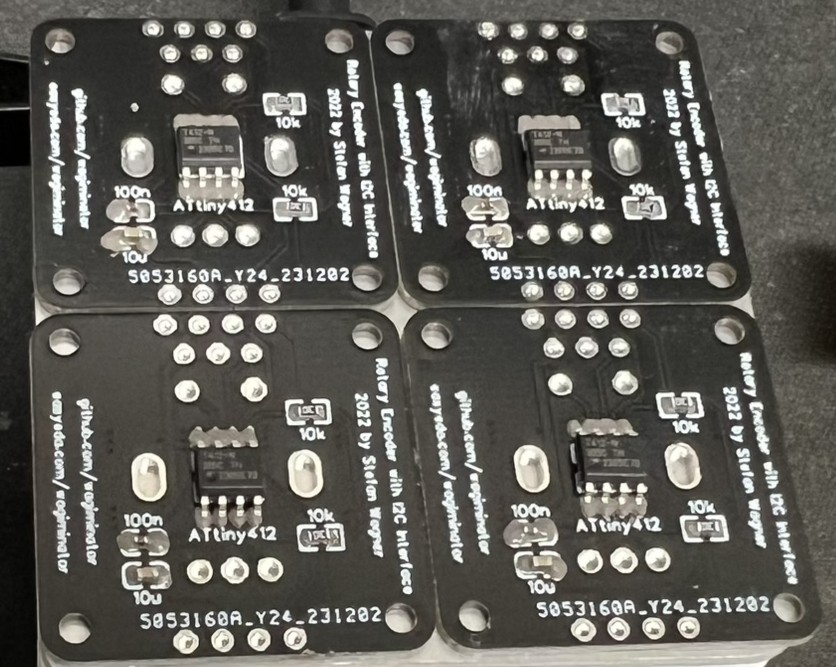
[picture p100: Diplomarbeit/Athena/3_Stand_der_Technik/Abbildungen/beispiel_bild_anfertigung_reflow.JPEG]
        
        \caption{Symbolfoto, anfertigung von bestückten Platinen}
    \end{minipage}
    \hfill
    \begin{minipage}[b]{0.45\textwidth}
        \centering
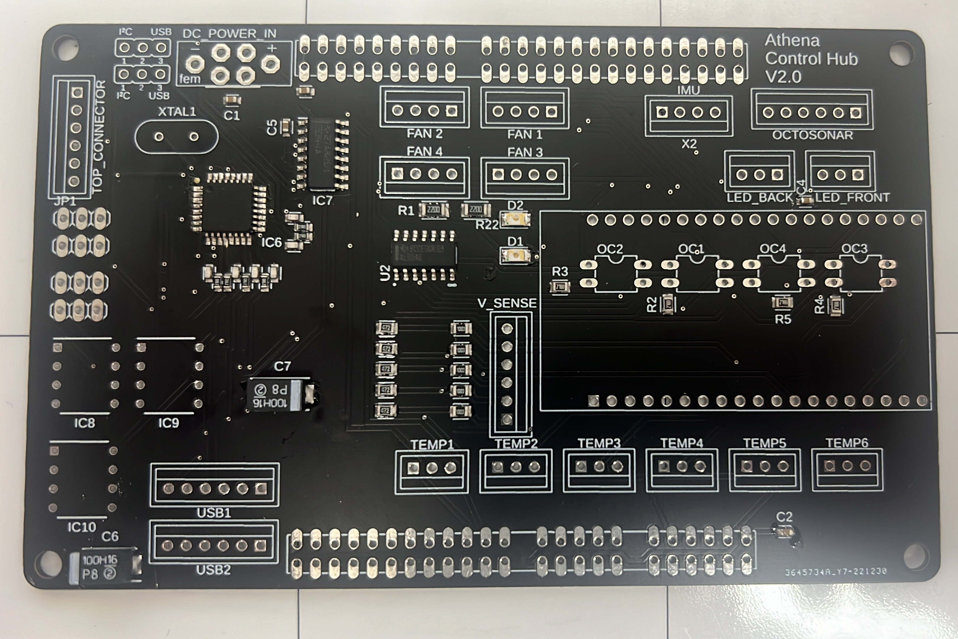
[picture p101: Diplomarbeit/Athena/3_Stand_der_Technik/Abbildungen/shield_done.jpg]
        \rotatebox{90}{}
        \caption{Symbolfoto, fertig verlötete Platine für den Bordcomputer.}
    \end{minipage}
\end{figure}
