unlegitGurke/RC-Car/Diplomarbeit/Athena/3_Stand_der_Technik/6.5_Loten_Lotkolben.tex

\fancyfoot[C]{Gürel}
\paragraph{Löten mit Lötkolben}

Beim traditionellen Löten mit einem Lötkolben können erfolgreich Komponenten bis zu der Größe 0603 (0,06 x 0,03 Zoll) verlötet werden. Allerdings gestaltet sich das Verlöten von SMD ICs als schwierig. Die Hitze des Lötkolbens führt teilweise zu Beschädigungen der ICs und zu visuellen sowie qualitativen Unregelmäßigkeiten an den Lötstellen, was die Qualität und Zuverlässigkeit der Verbindungen beeinträchtigt. Diese Probleme verdeutlichten die Notwendigkeit einer präziseren und schonenderen Löttechnik, insbesondere für empfindliche Bauteile wie SMD ICs.

Es gibt grundsätzlich zwei Unterschiede beim Lötzinn: bleihaltig und bleifrei. Bleihaltiges Lötzinn hat eine niedrigere Schmelztemperatur von etwa 190°C, was eine einfachere Handhabung ermöglicht und gute Flusseigenschaften bietet. Jedoch birgt bleihaltiges Lötzinn Gesundheitsrisiken aufgrund der Freisetzung von Bleidämpfen während des Lötprozesses.

Im Gegensatz dazu erfordert bleifreies Lötzinn eine höhere Schmelztemperatur von etwa 220°C. Diese erhöhte Temperatur kann dazu führen, dass empfindliche Komponenten während des Lötprozesses leichter beschädigt werden. Dennoch bietet bleifreies Lötzinn eine sicherere Alternative für die Gesundheit von Mensch und Umwelt, da es keine Toxine enthält.
