unlegitGurke/RC-Car/Diplomarbeit/Athena/3_Stand_der_Technik/9.5_sonar.tex

\fancyfoot[C]{Gürel}
\subsection{Ultraschallsensoren}
Ultraschallsensoren bestehen aus einem Schallwandler und einer Empfangseinheit. Der Schallwandler sendet Ultraschallwellen aus, die an Objekten reflektiert werden und von der Empfangseinheit erfasst werden. 
Tonwellen ab 20 kHz gelten als Ultraschall und können demnach nicht vom Menschen gehört werden, die Sensoren operieren unter diesem Bereich \cite{Frantzen2024}. 
Die Zeitmessung zwischen Aussenden und Empfangen des Schallsignals ermöglicht die Berechnung der Entfernung zum Objekt. 

Ultraschallsensoren bieten eine kostengünstige Lösung für die Abstandsmessung und werden häufig als Fahrzeugparkassistenz oder in der Robotik verwendet. Der generelle Anwendungsbereich ist jener, bei dem eine grobe Annäherung der Entfernung ausreicht.
