unlegitGurke/RC-Car/Diplomarbeit/Athena/3_Stand_der_Technik/9.7_kameras.tex

\fancyfoot[C]{Gürel}
\subsection{Kameras}
Kameras haben eine entscheidende Rolle in der Personenerkennung und im Bereich der Künstlichen Intelligenz (KI), insbesondere in Anwendungen wie Videoüberwachung, Gesichtserkennung und biometrischer Authentifizierung. Verschiedene Aspekte der Kamera, wie Objektiv, Fokus und Blende, beeinflussen die Leistung und Genauigkeit dieser Anwendungen.

\paragraph{Objektiv: } Das Objektiv einer Kamera bestimmt, wie Licht auf den Bildsensor fällt und beeinflusst somit die Bildqualität und Schärfe. In Anwendungen der Personenerkennung ist ein hochwertiges Objektiv wichtig, um klare und detaillierte Bilder aufzunehmen. Die Wahl des Objektivs hängt von den spezifischen Anforderungen der Anwendung ab, wie zum Beispiel dem Blickwinkel und der Entfernung zum zu erfassenden Objekt.

\paragraph{Fokus: } Der Fokus einer Kamera bestimmt, welche Teile eines Bildes scharfgestellt werden und welche unscharf bleiben. In der Personenerkennung ist ein breiter Fokusbereich von entscheidender Bedeutung, um Personen klar und deutlich zu erfassen, unabhängig von ihrer Entfernung zur Kamera. Ausserdem kann ein schneller Autofokus es der Kamera ermöglichen, sich schnell an sich bewegende Personen anzupassen und klare Bilder aufzunehmen.

\paragraph{Blende: } Die Blende einer Kamera reguliert die Menge an Licht, die auf den Bildsensor fällt, und beeinflusst somit die Belichtung und Tiefenschärfe eines Bildes. In Anwendungen der Personenerkennung ist eine angemessene Belichtung entscheidend, um klare und gut sichtbare Bilder zu gewährleisten, insbesondere bei unterschiedlichen Lichtverhältnissen. Eine variable Blende kann dabei helfen, sich an wechselnde Lichtbedingungen anzupassen und optimale Ergebnisse zu erzielen.

\paragraph{Anwendung im KI-Bereich: } Im Bereich der Künstlichen Intelligenz werden Kameras häufig für die Erfassung von Trainingsdaten verwendet, um KI-Modelle für die Personenerkennung zu trainieren. Hochauflösende Bilder, die von Kameras aufgenommen werden, dienen als Eingabe für diese Modelle, um Personen zu identifizieren und zu klassifizieren. Die Qualität der aufgenommenen Bilder, die durch die oben genannten Faktoren beeinflusst wird, trägt wesentlich zur Leistungsfähigkeit und Genauigkeit der KI-Modelle bei.
