unlegitGurke/RC-Car/Diplomarbeit/Athena/3_Stand_der_Technik/8.1_Energiespeicher.tex

\subsection{Energiespeicher}
	Das Ziel eines Energiespeichers ist es möglichst viel Energie in einem möglichst kleinen Volumen zu speichern und diese effizient aufzunehmen und abzugeben. Der Aufbau dieser Batterien besteht meistens aus zwei unterschiedlichen Elektroden und aus einem dazwischen befindlichen Elektrolyt. Die Spannung einer solchen Zelle hängt von  der Differenz der Elektronegativität der beiden Elektroden ab. Die wichtigsten Eckdaten eines Akkus sind seine Spannung in V, sein Energieinhalt in Wh, die Ladung in Ah und die Entlade- und Laderate in C($\frac{Entladestrom}{Ladung}$). Die meisten Akkus bestehen aus mehreren Zellen die in Serie oder parallel geschalten sind, um entweder Spannung oder Kapazität zu erhöhen. Daraus entstehen Bezeichnungen für Akkus wie zum Beispiel 4S2P, welches für 4 Serielle Zellen, 2 mal parallel geschalten steht. 
	
	\begin{figure}[H]
		\centering
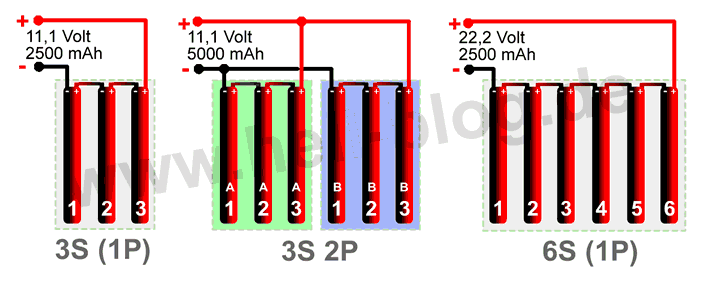
[picture p103: Diplomarbeit/Athena/3_Stand_der_Technik/Abbildungen/Akku_3.png]
		
		\caption{Serien- und Parallelschaltung von Akkuzellen\cite{heliplanet.com2024}}
	\end{figure}
	
	Bei Akkus mit mehreren Zellen ist es wichtig darauf zu achten, dass die Zellspannung der unterschiedlichen Zellen nicht variiert. Wenn eine Zelle voll geladen und eine zweite komplett entladen ist, wirkt der Akku anhand der gesamten Spannung wie als zur Hälfte geladen. Wenn jedoch eine Entladestrom fließt, wird eine Zelle unter ihre Abschaltspannung geladen, was zum Schaden der Zelle oder wie im Fall von Lithium Zellen auch zum Brand oder zur Explosion führen kann. Um diesem Problem vorzubeugen sind auf Akkus mit mehreren Zellen Balance Stecker angebracht, mithilfe von welchen die einzelnen Zellspannungen gemessen und ausgeglichen werden können. Der Ausgleich der Zellspannungen findet meistens bei jedem Ladevorgang statt.
	
	\begin{figure}[H]
		\centering
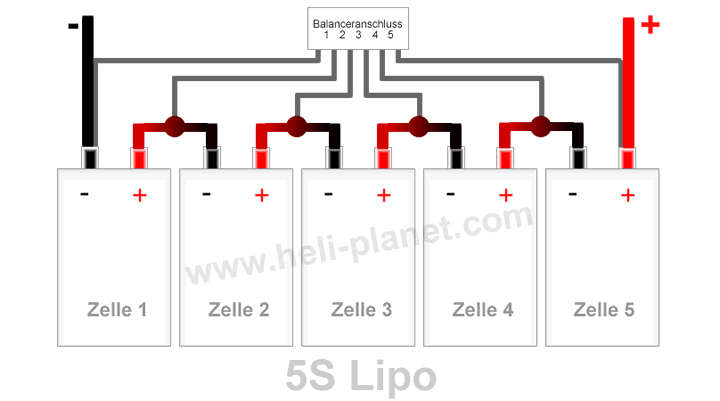
[picture p104: Diplomarbeit/Athena/3_Stand_der_Technik/Abbildungen/Akku_4.png]
		
		\caption{Balance-Stecker\cite{heliplanet.com2024}}
	\end{figure}

	\subsubsection{Alkali-Mangan-Zelle(AlMn)}
		Alkali-Mangan Batterien sind das am häufigsten verwendete Batteriesystem, sie überzeugen vorallem mit ihrer hohen Verfügbarkeit und günstigen Herstellung. Sie haben auch eine lange Haltbarkeit und ein niedrige Selbstentladung. Zu den Nachteilen zählt die geringe Entladerate, die oft unter 0,1C liegt und die begrenzte Wideraufladbarkeit. Die häufigste Form dieser Batterie ist die AA und AAA Batterie.\cite{Fricke2007} Die Zellspannung einer Alkali-Mangan-Zelle beträgt 1,5V.
		
		\begin{figure}[H]
			\centering
			
			\caption{Aufbau einer Alkali-Mangan-Zelle\cite{Fricke2007}}
		\end{figure}
	
	\subsubsection{Silberoxid-Zelle(AgO)}
		Silberoxid Zellen werden vorwiergend für sehr kleine Knopfzellen verwendet, wo hohe Energiedichte ebenso wie geringes Volumen hohe Priorität hat. Ihr Aufbau ist sehr ähnlich zu dem der Alkali-Mangan-Zelle. Da die Materialien in großen Mengen sehr teuer sind, wird sie meistens nur in geringen Kapazitäten verwendet. Die Zellspannung einer Silberoxid-Zelle beträgt 1,6V.\cite{Fricke2007} 
		
		\begin{figure}[H]
			\centering
			
			\caption{Aufbau einer Silberoxid-Zelle\cite{Fricke2007}}
		\end{figure}
	
	\subsubsection{Nickel-Cadmium-Zelle(NiCd)}
		Nicke-Cadmium-Zellen überzeugen vorallem durch ihre hohe Belastbarkeit, Schnellladefähigkeit und Kälteresistenz. Sie haben jedoch eine relativ geringe Energiedichte im Vergleich zu Lithium- oder Alkalizellen. Ein ebenso großer Nachteil is das Auftreten des Memory-Effekts, wenn die Zelle vor dem vollständigen Entladen wieder aufgeladen wird, können sich Kristalle bilden, die die Kapazität wesentlich verringern. Nickel-Cadmium-Zellen haben eine Zellspannung von 1,2V.
		
		\begin{figure}[H]
			\centering
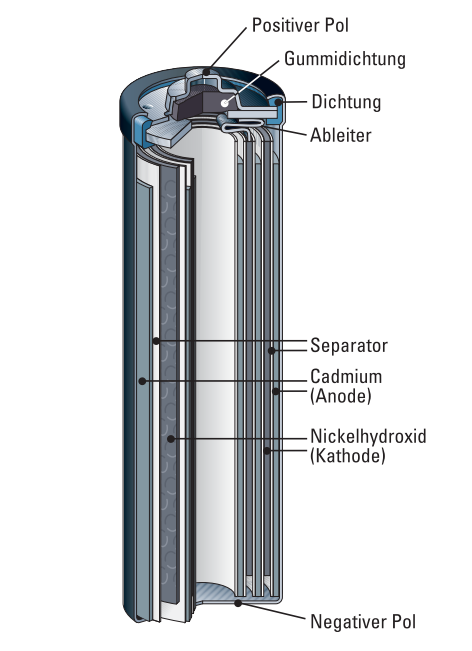
[picture p105: Diplomarbeit/Athena/3_Stand_der_Technik/Abbildungen/Akku_5.png]
			
			\caption{Aufbau einer Nickel-Cadmium-Zelle\cite{Fricke2007}}
		\end{figure}
	
	\subsubsection{Nickel-Metallhybrid-Zelle(NiMH)}
		Nickel-Metallhybrid-Zellen unterscheiden sich von Nickel-Cadmium-Zellen nur durch die negative Elektrode, welche aus einer Wasserstoff-speichernden Legierung besteht. Mittlerweile ist die Energiediche von NiMH-Zellen aufgrund von ständigen Innovationszyklen deutlich höher als die von NiCd-Zellen. NiMH-Zellen haben eine Zellspannung von 1,2V.\cite{Fricke2007}
	
	\subsubsection{Lithium-Ion-Zelle(Li-Ion)}
		Lithium-Ion-Zellen sind mittlerweile in allen Geräten von E-Autos bis zu Laptops vertreten und zählen damit zu einem der meist verbreitesten Batterie-Typen. Sie überzeugen vorallem mit ihrer extrem hohen Energiedichte und hoher Entladerate. Es sind teilweise Entladeraten von mehreren Dutzend C möglich. Die Zellspannung einer Lithium-Ion-Zelle beträgt 3,7V. Ein großer Nachteil von Lithium-Ionen Zellen ist, dass sie im Fall von Beschädigung(zum Beispiel durch externe Kräfte, Tiefentladung, oder extreme Temperaturen) entflammen können. Dabie ensteht ein sehr heiß brennender Metallbrand, welcher nur mit spezieller Ausrüstung gelöscht werden kann. Deshalb ist es bei solchen Zellen nötig die einzelnen Zellspannungen genau zu überwachen und auf einen geschützten Verbau zu setzen.
		
		\begin{figure}[H]
			\centering
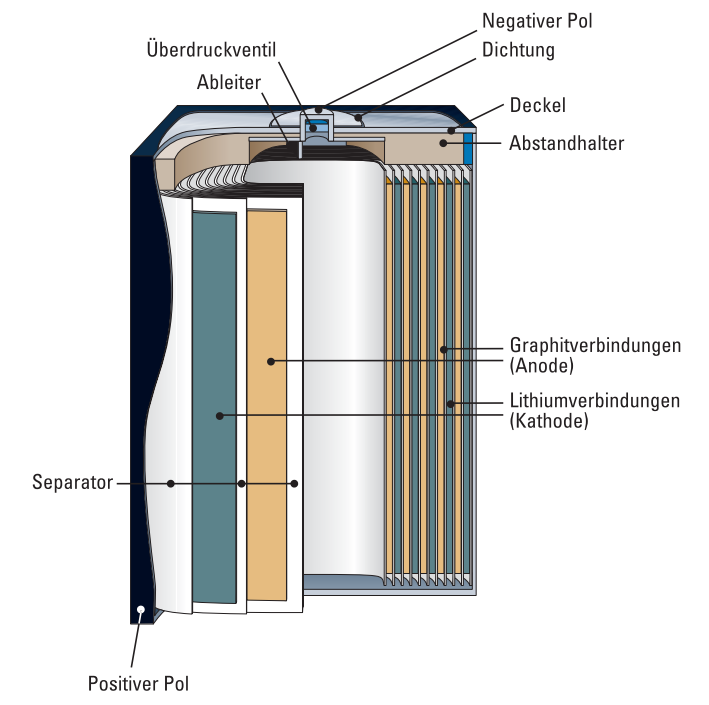
[picture p106: Diplomarbeit/Athena/3_Stand_der_Technik/Abbildungen/Akku_6.png]
			
			\caption{Aufbau einer Lithium-Ion-Zelle\cite{Fricke2007}}
		\end{figure}
	
	\subsubsection{Lithium-Polymer-Zelle(LiPo)}
		Lithium-Polymer-Zellen verfügen über eine flache Bauweise, wobei das Elektrolyt ein nicht-leitendes Polymer, welches jedoch Ionenaustausch gestattet, ist. LiPo-Zellen haben eine flachen Aufbau und eine sehr hohe Energiedichte, vergleichbar oder sogar höher als die von Li-Ion-Zellen. Auch sind sehr hohe Entladeraten möglich, weshalb sie anfangs im Modellsport sehr beliebt waren. Bei Beschädigung reagieren LiPo-Akkus oft noch schlechter als Li-Ion-Akkus. Es kann also bei falschem Gebrauch auch hier zu einem Brand kommen. Mittlerweile wurden Sicherheitstechnologien so verbessert, dass LiPos immer mehr Gebrauch in herrkömmlichen Geräten mit hoher Leistung finden.(zum Beispiel E-Bikes)
		
		\begin{figure}[H]
			\centering
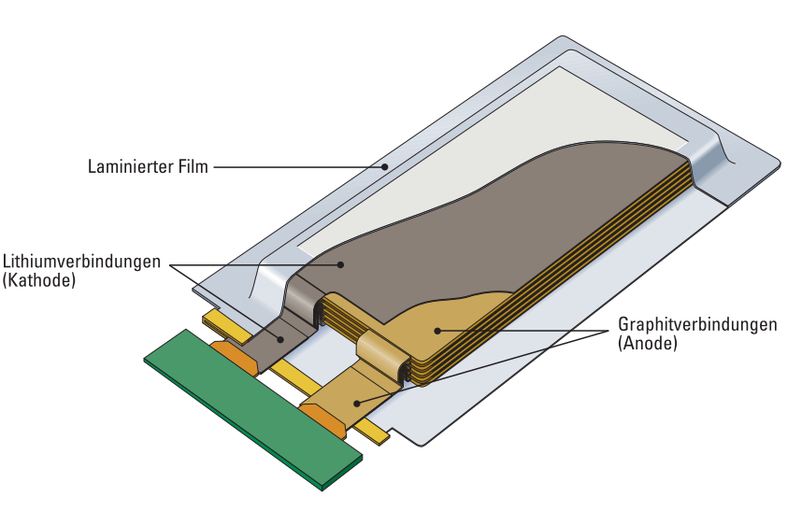
[picture p107: Diplomarbeit/Athena/3_Stand_der_Technik/Abbildungen/Akku_7.png]
			
			\caption{Aufbau einer Lithium-Polymer-Zelle\cite{Fricke2007}}
		\end{figure}
		
		\subsubsection{Lithium-Eisenphosphat(LiFePO4)}	
			LiFePo4-Akkus zeichnen sich vorallem durch ihre extrem lange Lebensauder und ihre Widerstandsfähigkeit aus. Das Risiko von Entflammung ist im Gegensatz zu anderen Lithium-Batterien auch bei den extremsten Bedingungen gering. Ihre Energiediche ist auch hoch, jedoch nicht mit der von Li-Ion oder LiPo zu vergleichen. Auch die Entladerate ist niedriger. Die Zellspannung einer LifePO4 Zelle beträgt in der Regel 3,2V.\cite{lithiumbatterytech.com2024}
