unlegitGurke/RC-Car/Diplomarbeit/Athena/3_Stand_der_Technik/2_Fraesen.tex

\fancyfoot[C]{Kaltenleitner}
\section{Fräsen und Drehen}
	Test
