unlegitGurke/RC-Car/Diplomarbeit/Athena/3_Stand_der_Technik/5.1_Aufhaengung.tex

\subsection{Aufhängung}
	Wird bei Autos über die Aufhängung oder das Fahrwerk gesprochen, so meint man damit ein System von Komponenten, welches das Fahrzeug mit den Rädern verbindet. Die Hauptaufgaben einer Aufhängung sind:
	\begin{itemize}
	\item Führung: 	Die Aufhängung ist mitverantwortlich für die richtige Führung der Räder. Bei den meisten Automobilen sind nur die Vorderreifen gelenkt. Die Hinterreifen sollten möglichst gerade geführt sein. Es muss sichergestellt sein, dass die Räder in Kurven und bei Geradeausfahrt die richtige Richtung halten.
	\item Federung: 	Die Federung sorgt dafür, dass das Auto auch bei unebenen Straßenoberflächen stabil und kontrollierbar bleibt. Sie absorbiert die Stöße und Vibrationen, die von Bodenunebenheiten hervorgerufen werden und verringert dadurch die Übertragung dieser Bewegungen auf die Karosserie des Fahrzeugs und der Insassen. Bei vereinzelten Fahrzeugen mit einer Starrachse gibt es diese nicht. 
	\item Dämpfung: Die Dämpfung reduziert die Schwingungen der Federung und verhindert, dass das Auto nach einer Unebenheit auf der Straße weiter schwingt. Sie sorgt für eine schnellere Rückkehr des Rades in seine normale Position und hilft dabei, die Kontrolle über das Fahrzeug zu behalten.
	\item Lastenverteilung: Eine gute Aufhängung hilft auch dabei, das Gewicht des Fahrzeugs gleichmäßig auf alle Räder zu verteilen, was zu einer verbesserten Traktion und einem besseren Handling führt.
	\end{itemize}
	Zusammengefasst ist die Aufgabe einer Aufhängung, eine sichere und komfortable Verbindung zur Straße herzustellen.
	
	\subsubsection{Arten von Aufhängungen}
		\paragraph{Starrachse}
		Die wohl älteste Aufhängung ist eine Starrachse. Bei einer Starrachsen-Aufhängung sind die Räder an einer einzigen Achse miteinander verbunden. Das bedeutet, dass beide Räder an der Vorder- oder Hinterachse zusammen auf- und abfedern. In den ersten Ausführungen wurde auf eine Federung komplett verzichtet. In späteren Jahren wurden zusätzlich Blattfedern verbaut. Heute wird sie Großteiles in Kombination mit einer Luftfederung gebaut. Diese Art der Aufhängung wird noch heute in vielen LKWs, Traktoren und Geländefahrzeugen verwendet. Diese Art der Aufhängung ist bekannt für ihre Einfachheit, Robustheit und gute Traktion, aber sie bietet oft einen geringeren Fahrkomfort im Vergleich zu moderneren unabhängigen Aufhängungssystemen. Die Starrachsen-Aufhängung ist also kostengünstig, einfach zu warten und bietet gute Traktion, jedoch oft auf Kosten des Fahrkomforts.\cite{Fahrwerktechnik_Grundlagen_2005} \cite{Palla2021}
	
		\begin{figure}[H]
			\centering
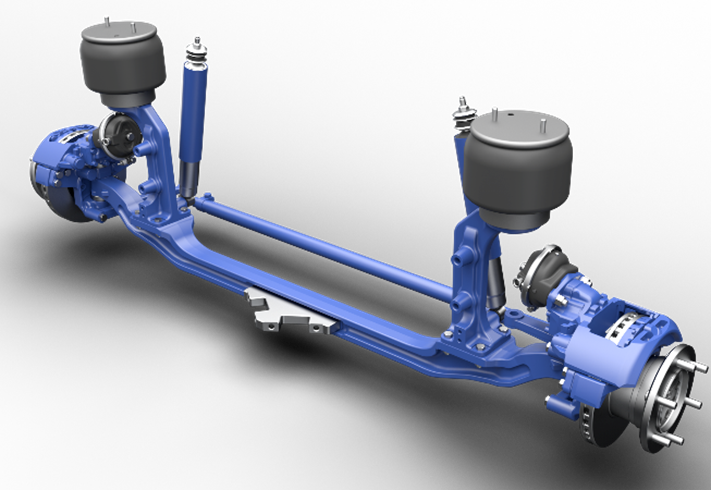
[picture p108: Diplomarbeit/Athena/3_Stand_der_Technik/Abbildungen/Starrachse_1.png]
			
			\caption{ BRIST RDD 45-175 Starrachse \cite{Bristaxle.com2023}}
		\end{figure}
		
		\begin{figure}[H]
			\centering
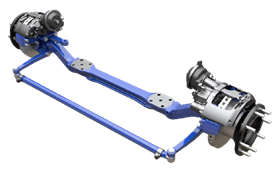
[picture p109: Diplomarbeit/Athena/3_Stand_der_Technik/Abbildungen/Starrachse_2.png]
			
			\caption{BRIST RFS 60-175 Starrachse\cite{Bristaxle.com2023}}
		\end{figure}
		
		\paragraph{Trailing Arm Suspension / Schräglenkerachse}
		Die Schräglenkerachse ist am einfachsten zu beschreiben, in dem man sie mit der Schwinge eines Motorrads vergleicht. Sie besteht aus zwei Schwingen, welche ein Stück vor der Achse drehend gelagert und mit dem Chassis verbunden sind. Ein Stoßdämpfer ist in der Nähe der Achse mit der Schwinge und dem Radkasten verbunden. Diese Art der Aufhängung wurde hauptsächlich für die Hinterachse benutzt.
Sie ist günstig in der Entwicklung und Produktion neigt jedoch dazu bei zu starken Seitenkräften zu Übersteuern, weshalb sie heute als veraltet gilt. \cite{Fahrwerktechnik_Grundlagen_2005} \cite{Palla2021}

		\paragraph{Doppelquerlenker-Radaufhängung}
		Die Doppelquerlenker-Radaufhängung ist das kostenintensivste Fahrwerkskonzept, welches oft in Fahrzeugen mit höheren Leistungsanforderungen oder einem Fokus auf Komfort und Fahrdynamik verwendet wird. Diese Aufhängung besteht aus zwei Querlenkern, die über und unter dem Radträger befestigt sind. Der Stoßdämpfer mit außenliegender Feder (manchmal auch mit Luftfederung gefertigt) wird am unteren Querlenker und an dem Domlager (Montagepunkt im Radkasten) montiert. 
In vereinzelten Fällen gibt es auch ein sogenannte Push oder Pull-Rod Systeme. Diese werden nur im Rennsport oder bei Sportwagen benutzt. Hierbei liegen die Dämpfer im inneren des Autos und werden mit Hilfe einer Umlenkung und einer Stange zu den Querdenkern geführt. Sie wird besonders gerne bei sogenannten „open-wheel-cars“ benutzt. Damit sind Fahrzeuge gemeint wo die Reifen freistehen ohne Kotflügel sind.  Eine Push oder Pull-Rod-Aufhängung ist im Bereich des Fahrwerks platzsparender, ermöglicht präzise Einstellung des Fahrwerks und besitzt bessere aerodynamische Eigenschaften. Die Produktions- und Entwicklungskosten sind jedoch sehr hoch.
Die Doppelquerlenker-Aufhängung ermöglicht die unabhängige Arbeit jedes Lenkers. Dadurch bietet sie eine präzise Steuerung der Raddynamik. Die Räder können einzeln auf Unebenheiten reagieren, ohne dass die Bewegung des einen Rades die des anderen beeinflusst. Dies verbessert nicht nur die Straßenlage und das Handling des Fahrzeugs, sondern auch den Fahrkomfort, da Stöße und Unebenheiten besser absorbiert werden.
Die Anpassungsmöglichkeiten sind ebenfalls ein Pluspunkt dieser Aufhängung. Sie unterliegt zwar der Multi-Link-Aufhängung, jedoch kann man trotzdem Parametern wie Spur, Sturz und Nachlauf verändern. Dadurch kann das Fahrzeug für verschiedene Bedingungen optimiert werden. Dies ist besonders wichtig für Fahrzeuge, die für sportliches Fahren oder Rennsportanwendungen ausgelegt sind. Ein großer Vorteil gegenüber der Macpherson-Aufhängung ist, dass sich die Doppelquerlenker-Aufhängung vollständig vertikal bewegen. Das Macpherson-System ist hierzu nicht in der Lage. Genauer erklärt im Punkt: Macpherson Aufhängung. Allerdings ist die Doppelquerlenker-Aufhängung etwas komplexer als diese und benötigt mehr Platz im Fahrzeug. Dies kann zu höheren Produktionskosten führen. Insgesamt bietet die Doppelquerlenker-Radaufhängung eine ausgezeichnete Kombination aus Fahrkomfort, Fahrdynamik und Präzision. Sie ist in Fahrzeugen zu finden, bei denen Wert auf eine hohe Leistung und eine präzise Fahrzeugkontrolle gelegt wird, wie beispielsweise Sportwagen oder Fahrzeugen der Oberklasse.\cite{Fahrwerktechnik_Grundlagen_2005} \cite{Palla2021}

	\paragraph{Macpherson Aufhängung}
	Die MacPherson-Federbein-Aufhängung ist eines der weitverbreitetsten Systeme in modernen Automobilen, das für seine Effizienz und Zuverlässigkeit bekannt ist. Bei diesem System ist jedes Rad an einem Federbein befestigt, das sowohl die Federung als auch die Dämpfungsfunktionen in einem kompakten Bauteil vereint. Im Gegensatz zur Doppelquerlenker-Radaufhängung, besitzt die MacPherson-Aufhängung nur einen Querlenker. Für die restliche Stabilisierung ist das Federbein zuständig. Durch diese Bauweise spart die MacPherson-Aufhängung Platz im Fahrzeug und reduziert gleichzeitig die Herstellungskosten. 
Jedoch weist diese Art der Aufhängung auch einige Nachteile auf. Ein Beispiel ist die konstruktionsbedingte Einschränkung, dass das Rad sich nicht vollständig vertikal bewegen kann. Die Aufhängung ist an einem unteren Arm befestigt, der seinerseits an einer Achse am Fahrzeug montiert ist und während der Bewegung seinen vertikalen Winkel ändert. Einfach ausgedrückt bedeutet dies, dass der Arm, da er an einem festen Punkt befestigt ist, sich nur in einem Bogen bewegen kann. Die Aufhängung, die am anderen Ende des Querlenkers befestigt ist, ändert ihre Neigung entsprechend, abhängig davon, wo sie sich auf dem Bogen befindet. Dies ist besonders für Sportwagen nicht von Vorteil.
Die MacPherson-Aufhängung ermöglicht eine ausgewogene Kombination aus Komfort und Fahrstabilität. Sie ist in einer Vielzahl von Fahrzeugen anzutreffen, angefangen bei kleinen Stadtautos bis hin zu größeren Limousinen und sogar in dem ein oder anderen Sportwagen, auch wenn es in diesem Fall nicht die beste Wahl ist.\cite{Fahrwerktechnik_Grundlagen_2005} \cite{Palla2021}

	\paragraph{Multi-Link-Aufhängung / Mehrlenkerachse}
	Die Multi-Link-Aufhängung besteht aus mehreren Querlenkern, die an der Radnabe und am Fahrzeugrahmen befestigt sind. Diese Lenker sind in einem komplexen System miteinander verbunden, wodurch jedes Rad unabhängig geführt und gefedert wird. Die genaue Anzahl der Querlenker kann variieren.
Dieses System ermöglicht eine präzise Einstellung der Fahrzeugdynamik. Durch die verschiedenen Lenker und die Möglichkeit, die Geometrie der Aufhängung zu optimieren, können Hersteller das Fahrverhalten leichter abstimmen. Dies führt zu verbessertem Handling, stabilerem Kurvenverhalten und einer insgesamt besseren Fahrzeugkontrolle.
Im Vergleich zur Doppelquerlenker-Aufhängung gibt es einige Unterschiede. Die Doppelquerlenker-Aufhängung verwendet ebenfalls mehrere Lenker, um jedes Rad individuell zu führen. Allerdings sind die Lenker in einem anderen geometrischen Muster angeordnet. Während die Multi-Link-Aufhängung oft mit mehreren seitlichen Lenkern arbeitet, besteht die Doppelquerlenker-Aufhängung typischerweise aus einem oberen und einem unteren Querlenker.
Ein Vorteil der Doppelquerlenker-Aufhängung ist ihre einfache Geometrie, die eine effektive Kontrolle über das Rad ermöglicht. Sie ist oft in der Lage, höhere Belastungen zu bewältigen und kann eine bessere Stabilität in geraden Linien bieten. Allerdings kann sie in der Regel nicht so fein eingestellt werden wie die Multi-Link-Aufhängung, was zu etwas eingeschränkteren Fahreigenschaften in extremen Situationen führen kann.
Zusammenfassend bietet die Multi-Link-Aufhängung eine ausgezeichnete Balance zwischen Fahrkomfort und Performance. Ihre komplexere Geometrie erlaubt eine präzisere Anpassung und bessere Traktion, während die Doppelquerlenker-Aufhängung eine robuste und effektive Lösung für viele Fahrzeugtypen darstellt, die eine zuverlässige Fahrzeugkontrolle bei höheren Belastungen erfordern. \cite{Fahrwerktechnik_Grundlagen_2005} \cite{Palla2021}

	\begin{figure}[H]
			\centering
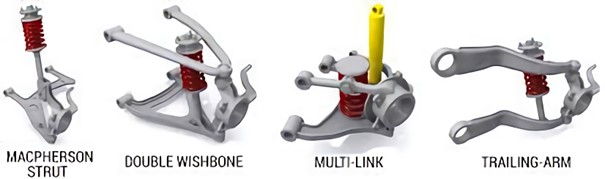
[picture p110: Diplomarbeit/Athena/3_Stand_der_Technik/Abbildungen/Aufheangungsarten_1.jpg]
			
			\caption{Verschiedene Arten von Aufhängungen \cite{Ren2021}}
		\end{figure}
