unlegitGurke/RC-Car/Diplomarbeit/Athena/3_Stand_der_Technik/7.2_Gleichstrommaschine.tex

\subsection{Gleichstrommaschine}
	Die Gleichstrommascheine besteht im Stator entweder aus Permanetmagneten, oder aus einer permanent-erregten Erregerwicklung. Der Rotor besteht aus Wicklungen, welche durch einen Kommutator (auch Stromwender genannt) und Bürsten mithilfe von Gleichspannung versorgt werden. Die Drehzahl der Maschine kann hierbei ganz einfach durch Verändern der Versorgungsspannung linear geregelt werden.\cite{Fischer2017}
	
	\begin{figure}[H]
			\centering
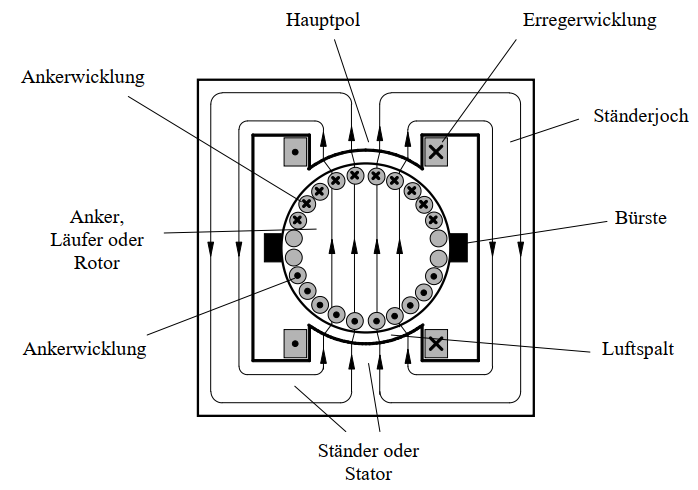
[picture p111: Diplomarbeit/Athena/3_Stand_der_Technik/Abbildungen/Gleichstrommaschine_1.png]
			
			\caption{Aufbau Gleichstrommaschine\cite{Pischtschan2024}}
	\end{figure}
	
	Vorteil der Gleichstrommaschine ist die einfache Drehzahlregelung durch Veränderung der Spannung und relativ günstige Bauweise, da keine Frequenzumrichter nötig ist. Zu den Nachteilen zählt der hohe Wartungsaufwand und Verschleiß der Maschine. Er wird aufgrund von sinkenden Preisen von Frequenzumrichtern immer weniger verwendet.
