unlegitGurke/RC-Car/Präsentation/Kurzberichte/Kurzbericht_KW23-24.docx

Kurzbericht Kalenderwoche: 23-24

Projekt: RC-Auto

Aufwand in KW: | 100 Stunden | Aufwand Vorwoche: | 75 Stunden
| | Offener Restaufwand: | 0 Stunden

Geplante Aktivitäten: Was und Wer | - Philipp Kaltenleitner: - Felix Sandri: - David Petrovic: - Mert Gürel:
Durchgeführte Aktivitäten: Was und Wer | - Philipp Kaltenleitner: 1. Bemaßung von diversen Teilen 2. Kontrolle aller Bemaßungen 3. Planung der Weiterentwicklung (nach Abgabe) - Felix Sandri: 1. Bemaßen von diversen Teilen 2. Kontrolle Bemaßungen 3. Hintergrundbilder für PowerPoint gerendert 4. Ausdrucken der Projektmappe 5. Planung der Weiterentwicklung (nach Abgabe) - David Petrovic: 1. Bemaßen von diversen Teilen 2. Projektabschlussbericht geschrieben 3. Planung der Weiterentwicklung (nach Abgabe) - Mert Gürel: 1. Bemaßen von diversen Teilen 2. PowerPoint erstellt 3. Planung der Weiterentwicklung (nach Abgabe)
Fällige / erledigte Meilensteine: | 1. 7.
Aufgetretene Probleme: | 1. Manche Dateien waren für kurze Zeit verloren, konnten wiederhergestellt werden.

Sachbestand: | Projekt läuft planmäßig ab | x
| Schwierigkeiten sind erkennbar
| Schwierigkeiten sind aufgetaucht, aber beherrscht
| Schwierigkeiten sind aufgetaucht, keine Lösung erkennbar

Termine: | Projekt läuft planmäßig ab | x
| Termine, die nicht am kritischen Weg liegen, müssen verschoben werden
| Termine, die am kritischen Weg liegen, müssen verschoben werden; Aufgabenstellung kann vermutlich zeitgerecht erledigt werden
| Aufgabenstellung kann vermutlich zeitgerecht erledigt werden

Salzburg, 21.06.2021 _________________________

Unterschrift PL

Version: V3.69-V4.11 vom 06/2021
