unlegitGurke/RC-Car/Bilder/Plakat_Athena.pdf

ABTEILUNG FÜR ELEKTROTECHNIK | 2023/24

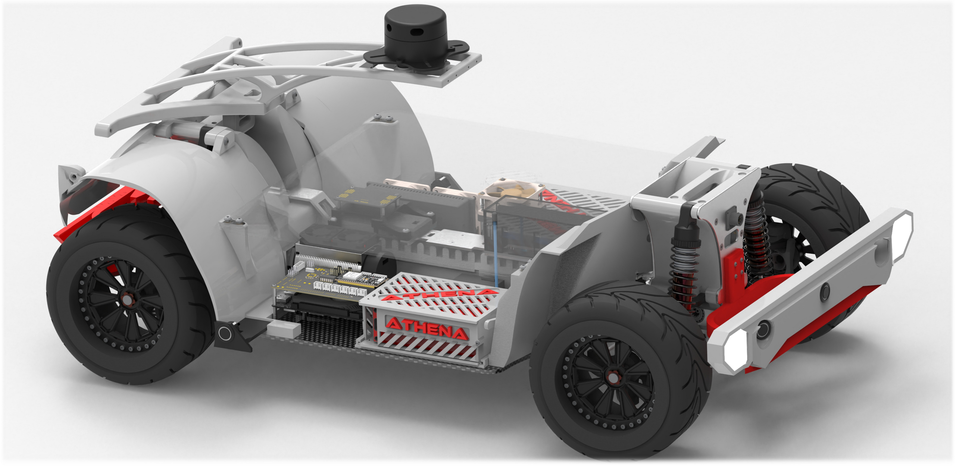
[picture p112: figure]

Felix Sandri | | Prof. Dipl.-Ing. Robert Fuchs
Philipp Kaltenleitner | Prof. Dipl.-Ing Reinhold Benedikter
Mert Gürel | | BSc Simon Dantendorfer
David Petrovic | | Prof. Dipl.-Ing Timo Huemer

# Athena
