unlegitGurke/RC-Car/Rechnungen/Ausgaben/JLCPCB_Rechnung_3.pdf

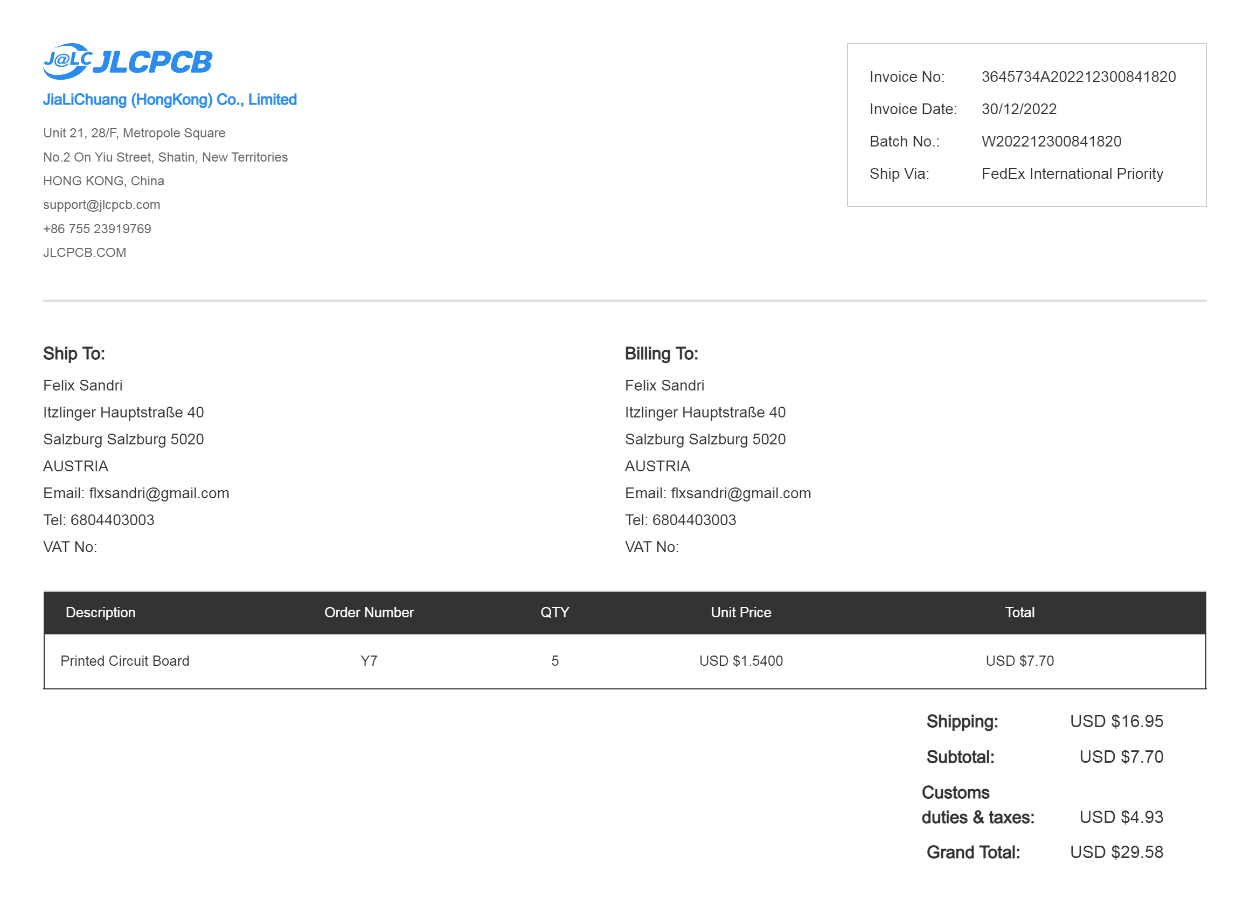
[picture p113: figure]
