unlegitGurke/RC-Car/Rechnungen/Ausgaben/JLCPCB_Rechnung_2.pdf

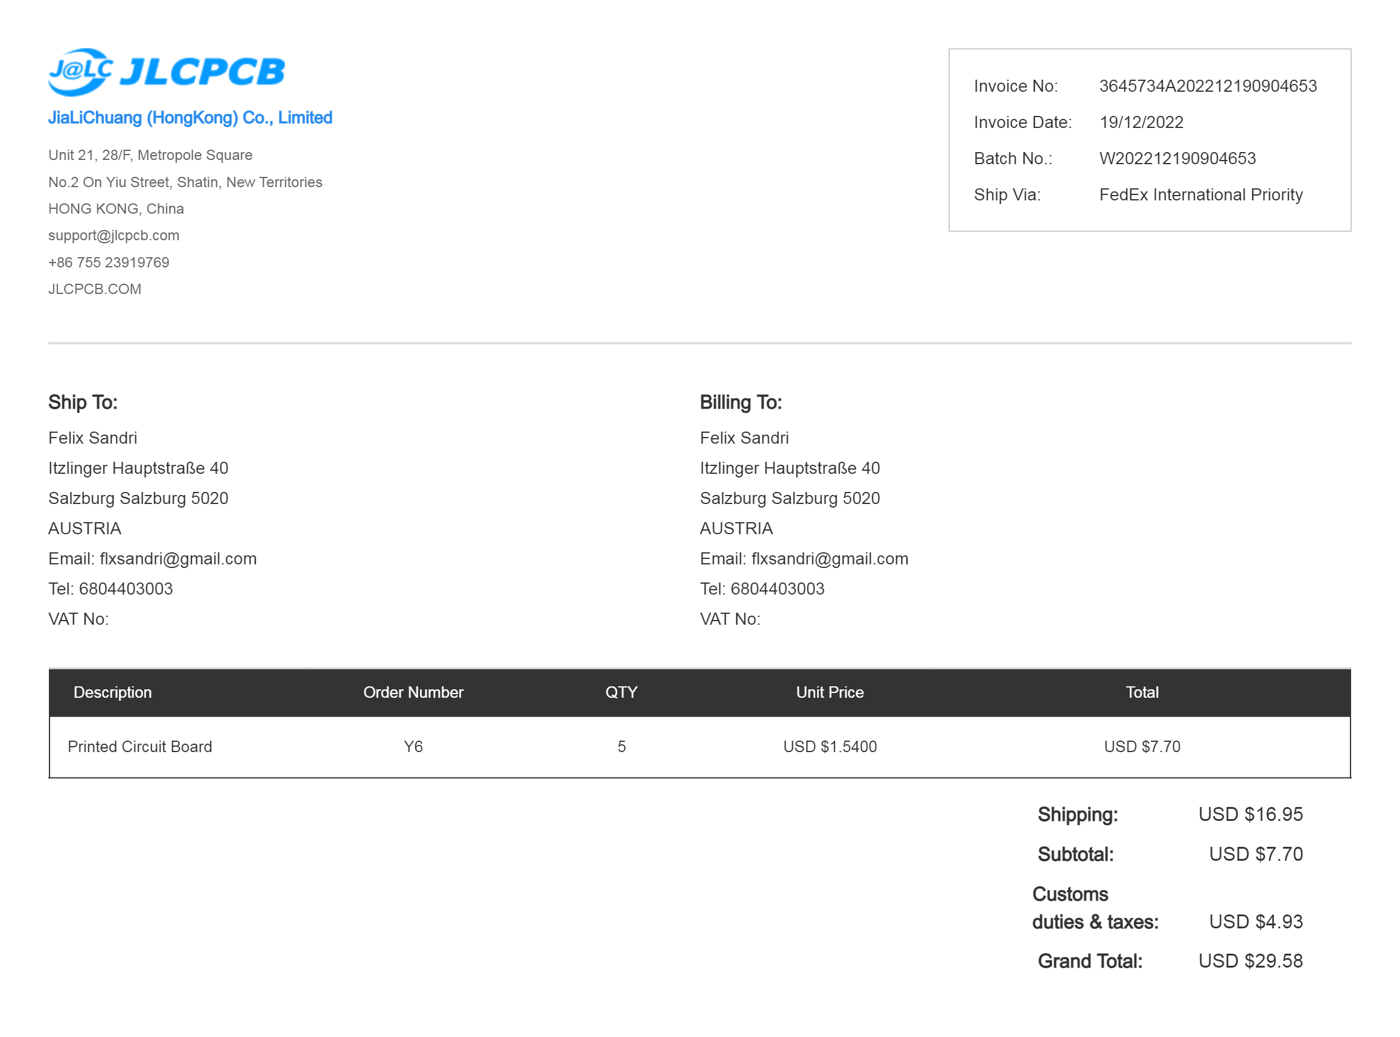
[picture p114: figure]
