unlegitGurke/RC-Car/Rechnungen/Ausgaben/Modellbau_Berlinski_Rechnung_1_08_12_2022.pdf

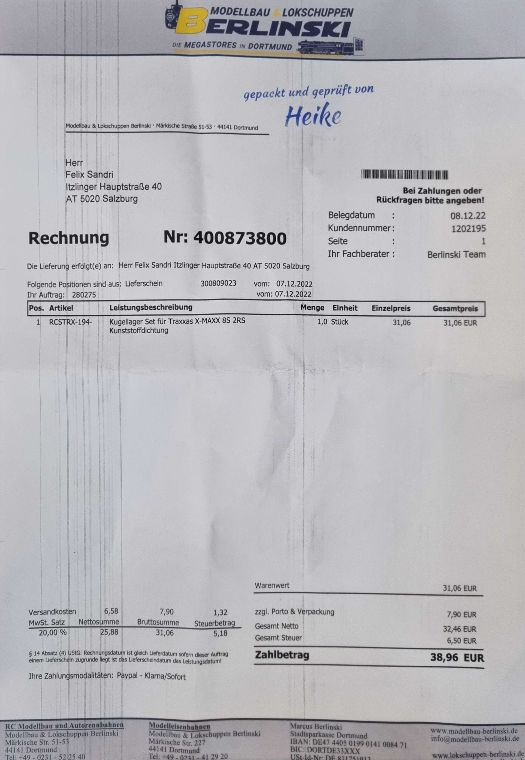
[picture p115: page 1]
