unlegitGurke/RC-Car/Rechnungen/Ausgaben/JLCPCB_Rechnung_1.pdf

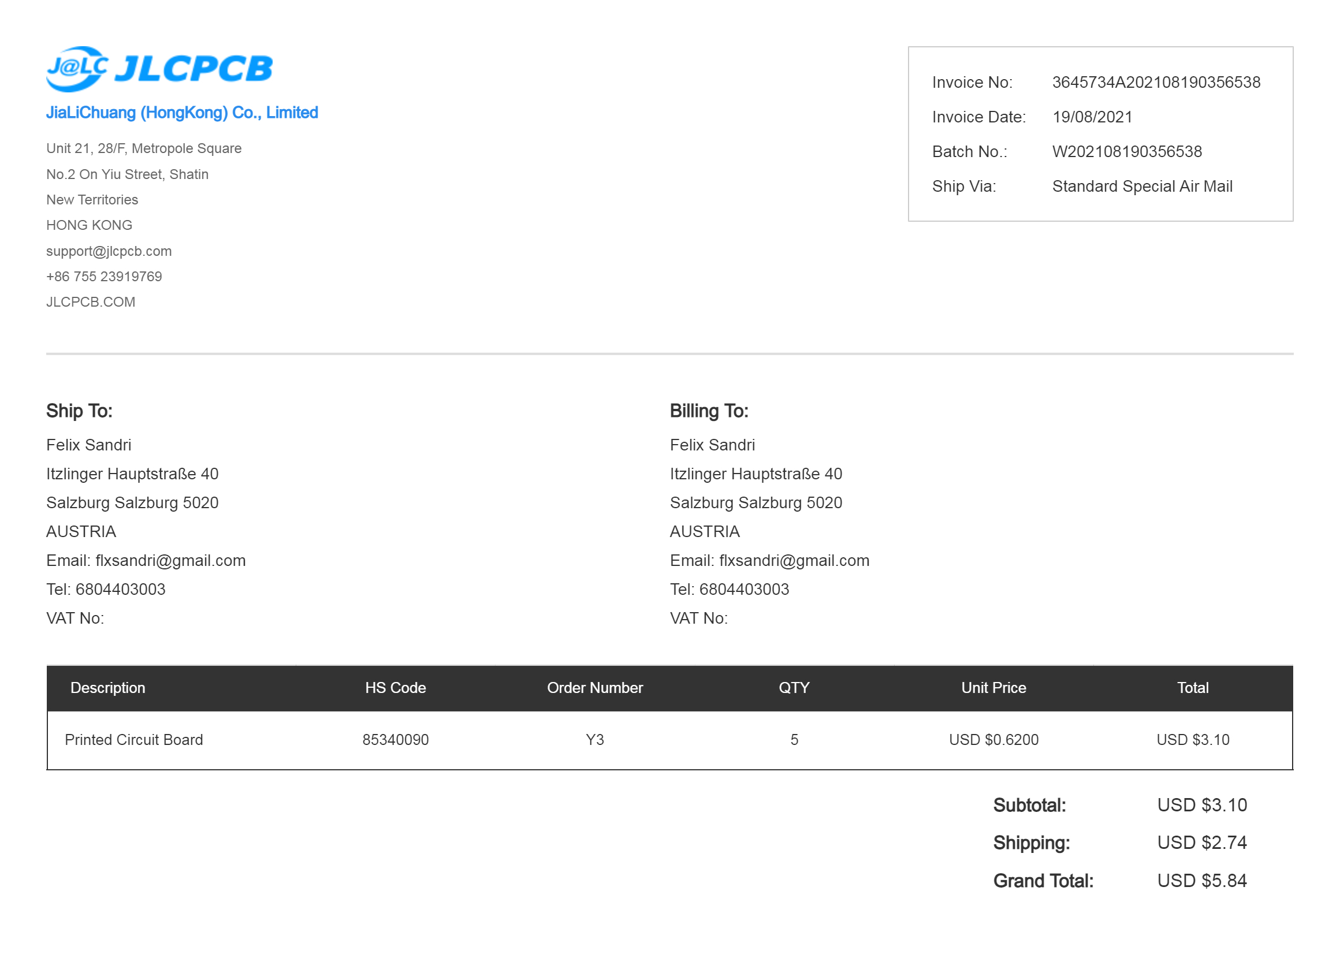
[picture p116: figure]
