unlegitGurke/RC-Car/Diplomarbeit/Athena/9_Anhang/Stromlaufplaene/Shield_0.pdf

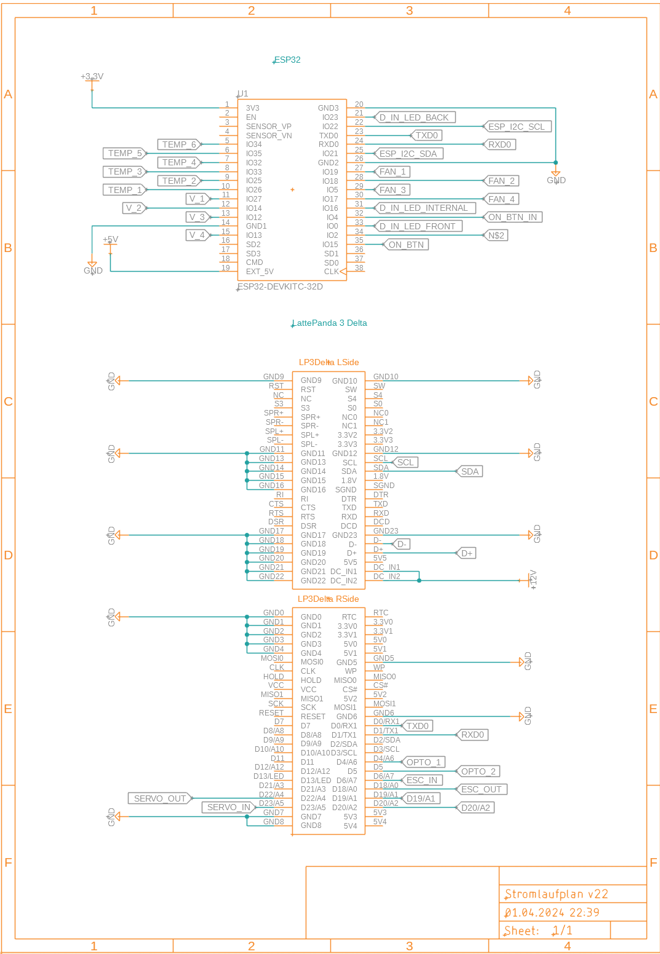
[picture p117: page 1]
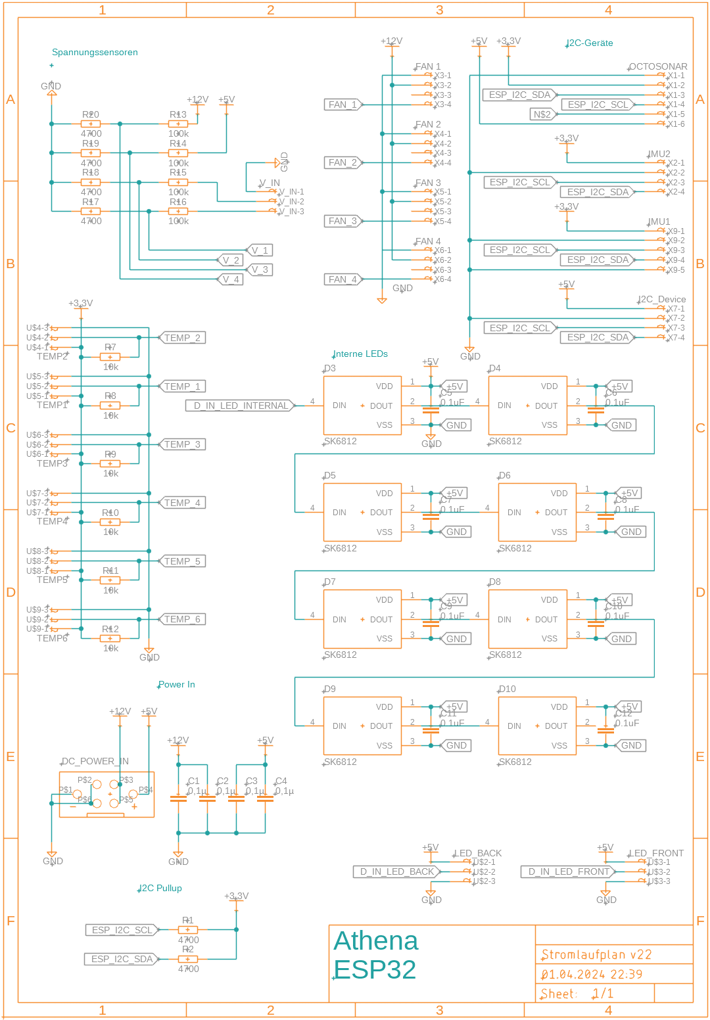
[picture p118: page 2]
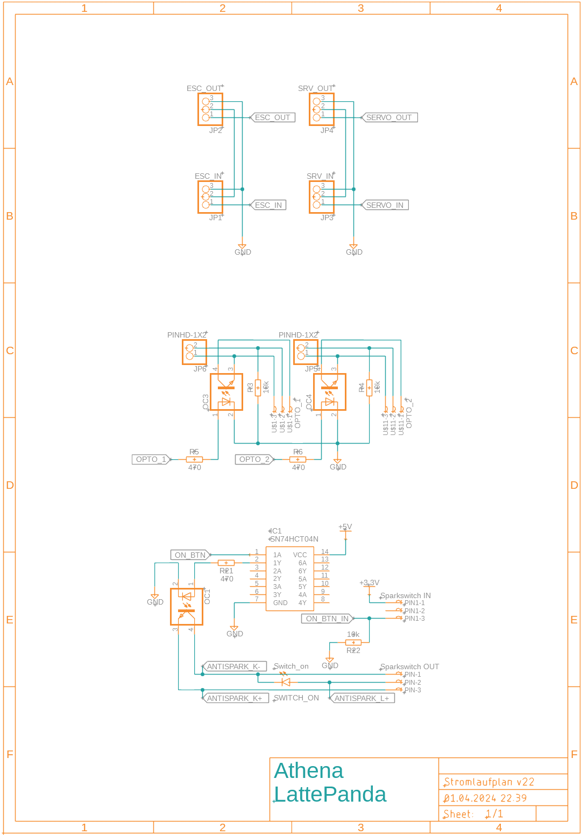
[picture p119: page 3]
