unlegitGurke/RC-Car/Chassis/Code/Python/csv-to-img/pts.xlsx

x | y
0 | 0
0 | 0
5.807796227 | 0.1600072524
5.798913012 | 0.1122946877
5.782638514 | 0.06465854154
5.776973959 | 0.01732921268
5.77092244 | -0.02990209191
5.766485316 | -0.07706096008
0 | 0
0 | 0
0 | 0
5.725095415 | -0.2812561995
0 | 0
0 | 0
5.736236269 | -0.4388621254
5.702030766 | -0.4894636978
5.668524541 | -0.5380175488
5.522215321 | -0.5743191281
5.670665795 | -0.6429587223
0 | 0
0 | 0
5.599535921 | -0.7900790112
5.589232134 | -0.8399926138
5.579228902 | -0.8914628049
5.5808404 | -0.9433020192
5.571140782 | -0.9933128798
5.56169159 | -1.044924282
0 | 0
0 | 0
5.535041031 | -1.197034251
5.468442992 | -1.2342474
5.508706668 | -1.295542721
5.484802237 | -1.343708141
5.474426317 | -1.393506151
5.442327432 | -1.437607467
5.447087762 | -1.493029216
5.451709318 | -1.547175631
5.425616746 | -1.594274222
5.429229764 | -1.648556262
5.396998779 | -1.691963868
0 | 0
1.300053142 | -0.4508192055
1.29876884 | -0.4635087478
0 | 0
0 | 0
0 | 0
0 | 0
0.8673637372 | -0.3623260174
0.8779587939 | -0.3757836138
0 | 0
0 | 0
0.5863859645 | -0.2781231498
0.5746346066 | -0.2794925171
0.5729136266 | -0.2852541993
0.5802063723 | -0.2952314267
0 | 0
0 | 0
0 | 0
0 | 0
0 | 0
5.194355907 | -2.81480561
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
