unlegitGurke/RC-Car/Chassis/Code/Python/training data/datensatz leg alt/Mappe1(Automatisch wiederhergestellt).xlsx

x | y
 |  | x | y | x | y | x | y | x | y | x | y | x | y | x | y | x | y | x | y | x | y | x | y | x | y
 |  | 0.5300206389 | 3.7052837072 | -2.046101208 | -4.163386876 | -2.586768922 | -3.711496203 | -3.064189576 | -3.21315153 | -3.475118305 | 2.380020139 | -5.92278441 | -0.6650002137 | -3.693658461 | -2.677448287 | -4.451991084 | -2.04210114 | -0.6032452311 | -5.578478007 | 1.460724679 | -5.267204219 | 3.918533522 | -1.985836132 | 5.254147573 | 0.5884761525
 |  | 0.5804310253 | 3.6582394395 | -2.098073964 | -4.109389273 | -2.642561313 | -3.670748775 | -3.112036883 | -3.16683232 | -3.435102694 | 2.430500982 | -5.841672657 | -0.5657040522 | -3.751304606 | -2.632794035 | -4.528417262 | -1.994026241 | -0.679653838 | -5.498151529 | 1.34981955 | -5.172785058 | 3.881555854 | -2.042185477 | 5.357362763 | 0.5143810817
 |  | 0.6315904136 | 3.6223504643 | -2.155433293 | -4.067151071 | -2.697116363 | -3.628360993 | -3.165728591 | -3.124558541 | -3.393548778 | 2.479725039 | -5.784844832 | -0.471152965 | -3.80442984 | -2.58579054 | -4.867678816 | -2.05837954 | -0.7581621546 | -5.448503496 | 1.281126282 | -5.235533785 | 3.995961229 | -2.340610016 | 5.45605487 | 0.4428780982
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
