unlegitGurke/RC-Car/Chassis/Code/Python/training data/datensatz leg alt/pts_1.xlsx

x | y
0 | 0
0 | 0
0 | 0
5.800223573 | 0.09491509108
5.788806298 | 0.04736070573
5.762999797 | 0.001571359341
5.780819354 | -0.04571853563
5.767253525 | -0.09280213032
5.78329599 | -0.1403948853
5.684055549 | -0.182973265
5.741320339 | -0.2318504208
5.723250489 | -0.2780360698
5.704898352 | -0.3223869857
5.686103037 | -0.3680159447
5.632037028 | -0.4108114715
5.719189352 | -0.4642372124
5.691434168 | -0.5073220732
5.672163593 | -0.5524127344
5.534196242 | -0.5847200965
5.733087385 | -0.6516201435
5.637233799 | -0.687484521
5.469786186 | -0.7125256566
5.536083223 | -0.7672718344
5.602069394 | -0.821623111
5.871114244 | -0.9085694004
5.577020194 | -0.9113983828
5.582450831 | -0.9576737992
5.552777352 | -0.9994147871
5.556207123 | -1.047032096
5.56315391 | -1.095545269
0 | 0
0 | 0
0 | 0
0 | 0
5.512473439 | -1.318659582
5.486941301 | -1.360103957
5.401046622 | -1.385811594
5.510746527 | -1.460505444
5.446530355 | -1.491279398
5.440883678 | -1.537692624
5.447322708 | -1.58774963
5.426556458 | -1.633209089
5.414426569 | -1.676368527
5.400530588 | -1.720609159
0 | 0
1.299886722 | -0.4543384642
1.297067477 | -0.465295623
1.297101349 | -0.4769192868
0 | 0
0 | 0
0 | 0
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
