unlegitGurke/RC-Car/Chassis/Code/Python/training data/datensatz leg alt/pts_2.xlsx

x | y
5.828432188 | 0.2767736886
5.816574451 | 0.2269445088
5.814382853 | 0.1744706711
5.800720948 | 0.1218237096
5.786583587 | 0.06943679674
5.711974194 | 0.01713423262
5.780896089 | -0.03468415163
5.776350131 | -0.08664634195
0 | 0
0 | 0
0 | 0
0 | 0
0 | 0
0 | 0
5.701492186 | -0.4471535307
5.6773134 | -0.4967013259
5.67759054 | -0.5482532377
5.540997575 | -0.5869669239
5.707357273 | -0.6565795019
5.63274353 | -0.6994123722
5.622256163 | -0.7495457652
5.612313378 | -0.7996882088
5.602911829 | -0.8498623205
5.581214683 | -0.8980257713
5.57192138 | -0.9480482956
5.557970313 | -0.9987858359
5.547774418 | -1.048577116
0 | 0
0 | 0
5.5194009 | -1.198380171
5.511319003 | -1.248664929
5.503752008 | -1.299130941
5.480184118 | -1.345746056
5.480066476 | -1.399717463
5.462414942 | -1.447696191
5.344058511 | -1.467923908
5.466254552 | -1.554526027
5.44532818 | -1.601679855
5.407730873 | -1.643639328
5.408940743 | -1.697328112
0 | 0
0 | 0
1.296632554 | -0.4635439017
1.298039961 | -0.4772643965
0 | 0
0 | 0
0.8668846254 | -0.3529972048
0.8664410217 | -0.3619405692
0.8669268832 | -0.3710617393
0 | 0
0 | 0
0 | 0
0.5750151647 | -0.2787087341
0.5715878231 | -0.2834279011
0.5725815388 | -0.290369431
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
