unlegitGurke/RC-Car/Chassis/Code/Python/csv-to-img/images/m1.png

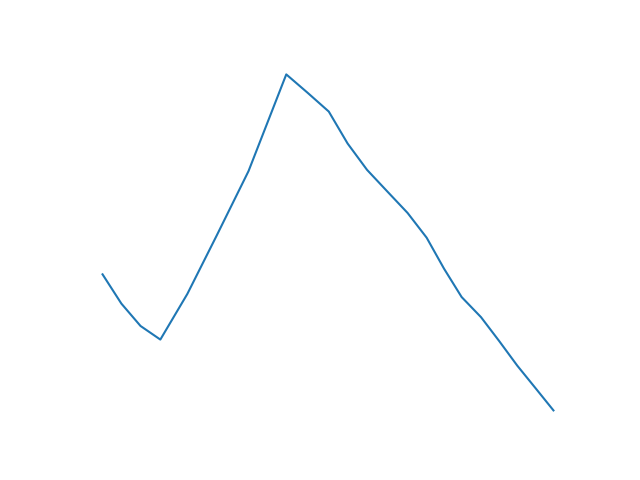
Chassis/Code/Python/csv-to-img/images/m1.png
