unlegitGurke/RC-Car/Chassis/Code/Python/csv-to-img/images/m2.png

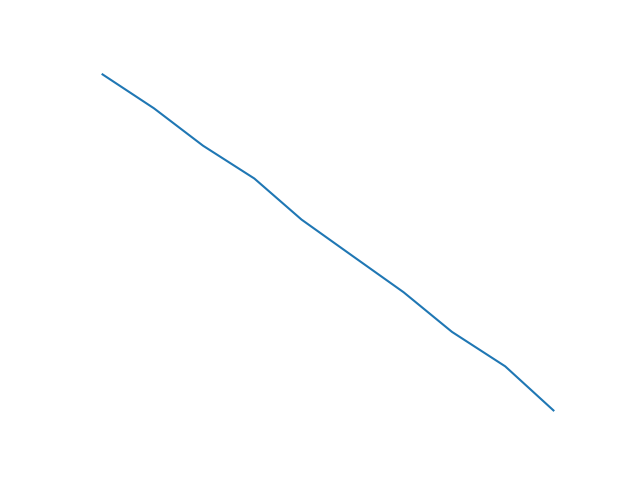
Chassis/Code/Python/csv-to-img/images/m2.png
