unlegitGurke/RC-Car/Chassis/Code/Python/csv-to-img/images/m3.png

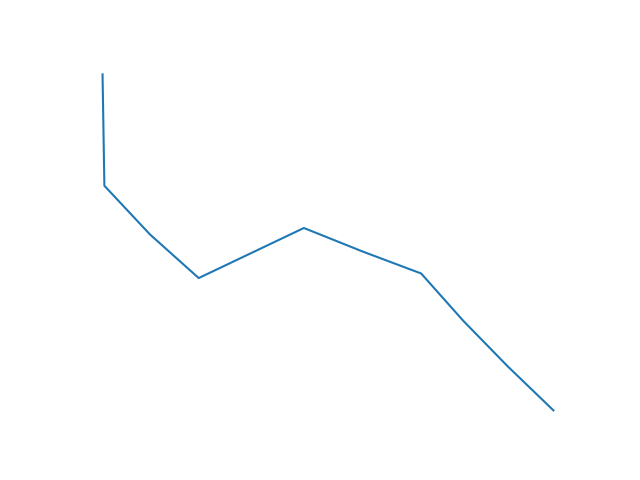
Chassis/Code/Python/csv-to-img/images/m3.png
