unlegitGurke/RC-Car/Chassis/Code/Python/csv-to-img/images/m5.png

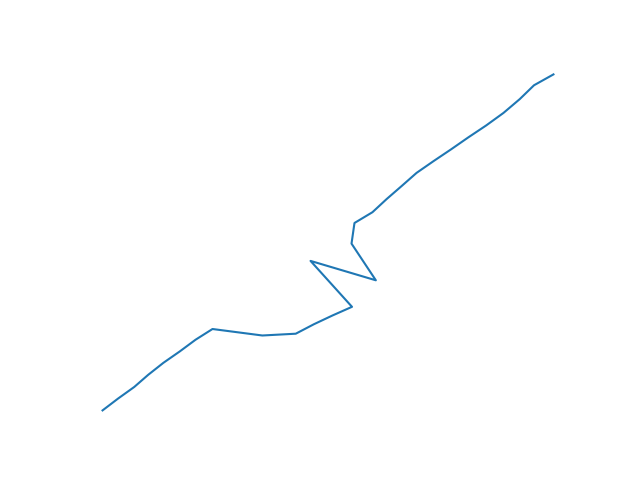
Chassis/Code/Python/csv-to-img/images/m5.png
