unlegitGurke/RC-Car/Chassis/Code/Python/csv-to-img/images/m6.png

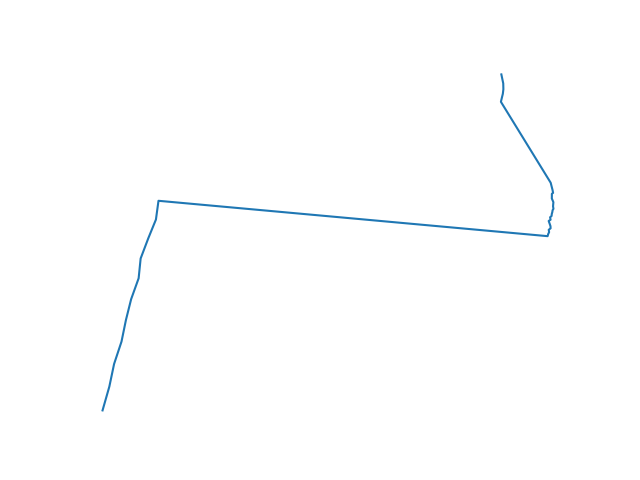
Chassis/Code/Python/csv-to-img/images/m6.png
