unlegitGurke/RC-Car/Chassis/Code/Python/csv-to-img/images/m8.png

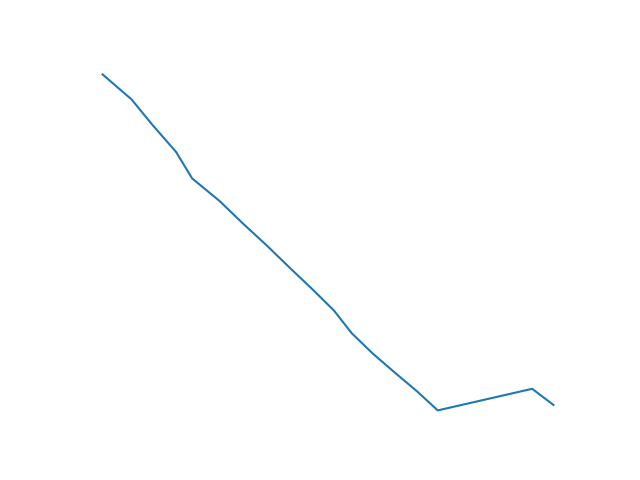
Chassis/Code/Python/csv-to-img/images/m8.png
