unlegitGurke/RC-Car/Chassis/Code/Python/csv-to-img/images/m11.png

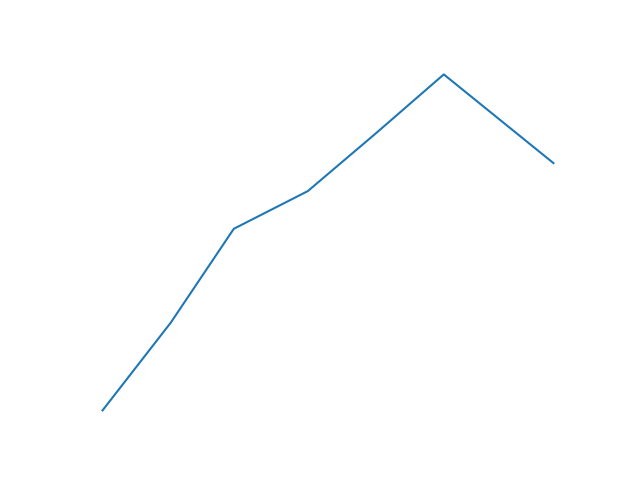
Chassis/Code/Python/csv-to-img/images/m11.png
