unlegitGurke/RC-Car/Chassis/Code/Python/csv-to-img/images/m12.png

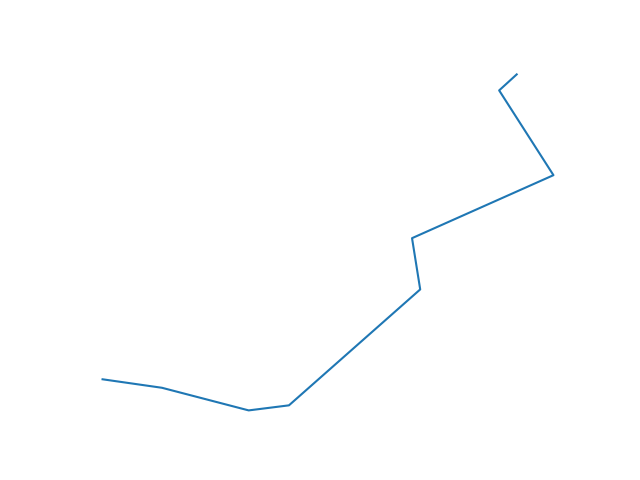
Chassis/Code/Python/csv-to-img/images/m12.png
