unlegitGurke/RC-Car/Chassis/Code/Python/training data/images_leg/train/image_12.png

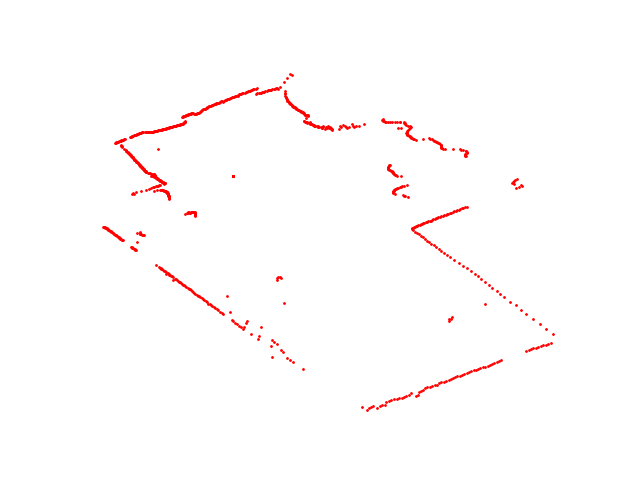
Chassis/Code/Python/training data/images_leg/train/image_12.png
