unlegitGurke/RC-Car/Chassis/Code/Python/training data/images_leg/train/image_16.png

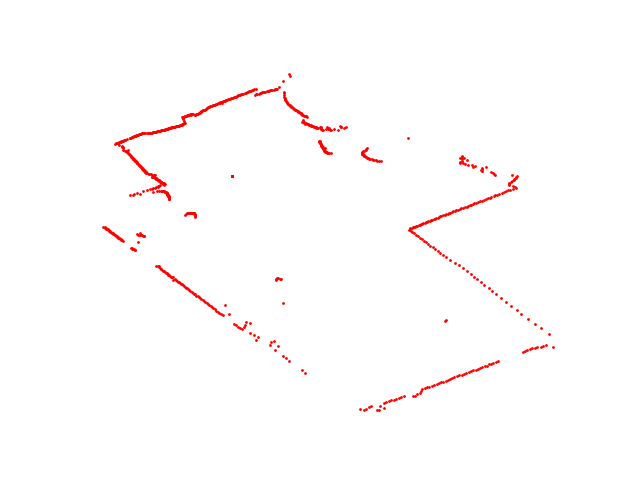
Chassis/Code/Python/training data/images_leg/train/image_16.png
