unlegitGurke/RC-Car/Chassis/Code/Python/training data/images_leg/train/image_61.png

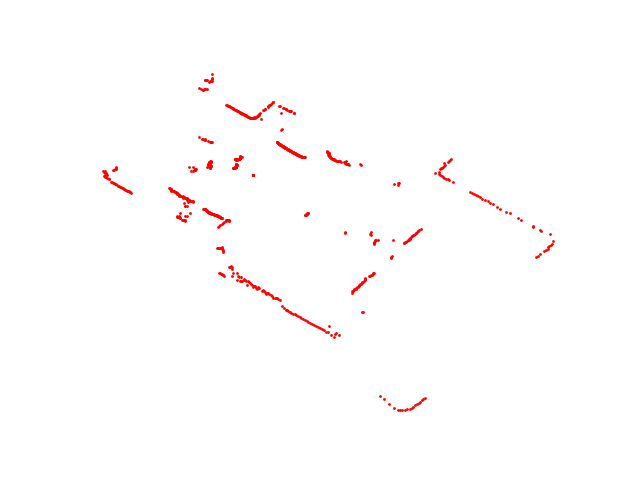
Chassis/Code/Python/training data/images_leg/train/image_61.png
