unlegitGurke/RC-Car/Chassis/Code/Python/training data/images_leg/train/image_70.png

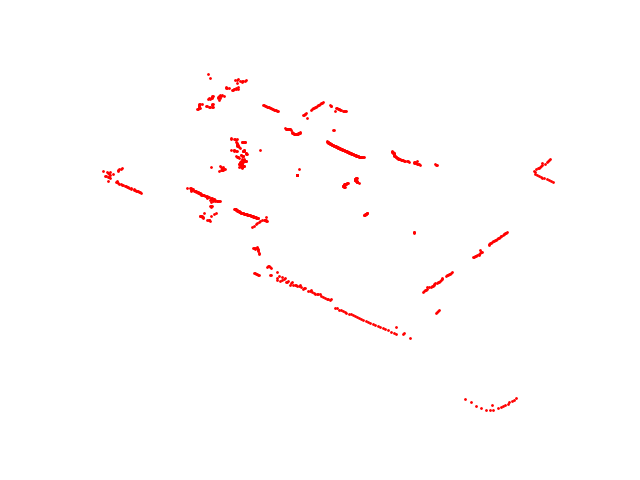
Chassis/Code/Python/training data/images_leg/train/image_70.png
