unlegitGurke/RC-Car/Chassis/Textures/Carbon_Textur.jpg

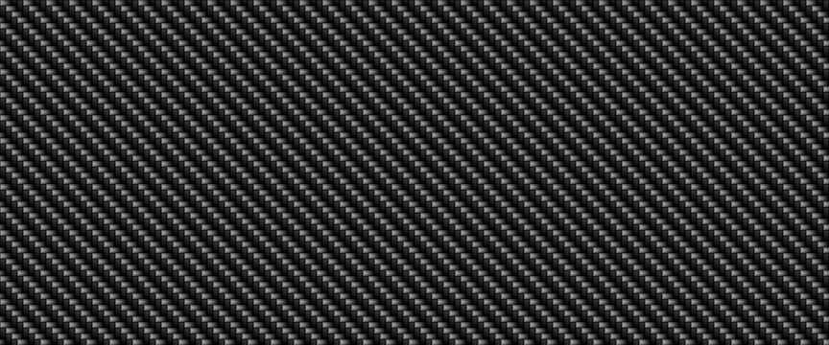
Chassis/Textures/Carbon_Textur.jpg
