unlegitGurke/RC-Car/Electronics/4-pin-pwm-connector-1.snapshot.1/4-Pin-PWM.jpg

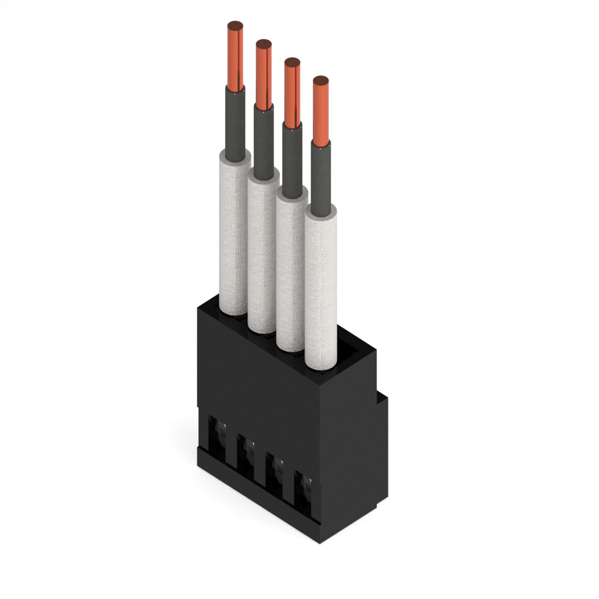
Electronics/4-pin-pwm-connector-1.snapshot.1/4-Pin-PWM.jpg
