unlegitGurke/RC-Car/Electronics/Akku/nf-a6x25-noctua-fan-60mm-1.snapshot.3/NF A6x25-1.jpg

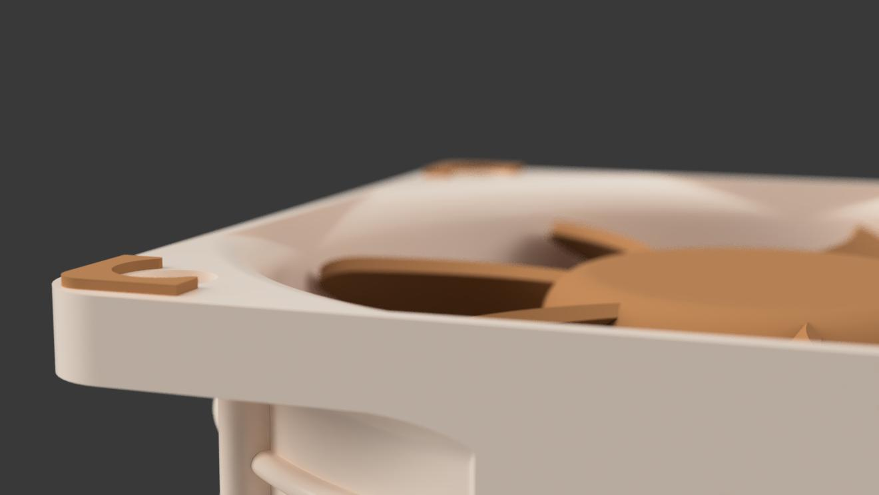
Electronics/Akku/nf-a6x25-noctua-fan-60mm-1.snapshot.3/NF A6x25-1.jpg
