unlegitGurke/RC-Car/Electronics/Akku/Zelle/Sony US21700VTC6A photo.JPG

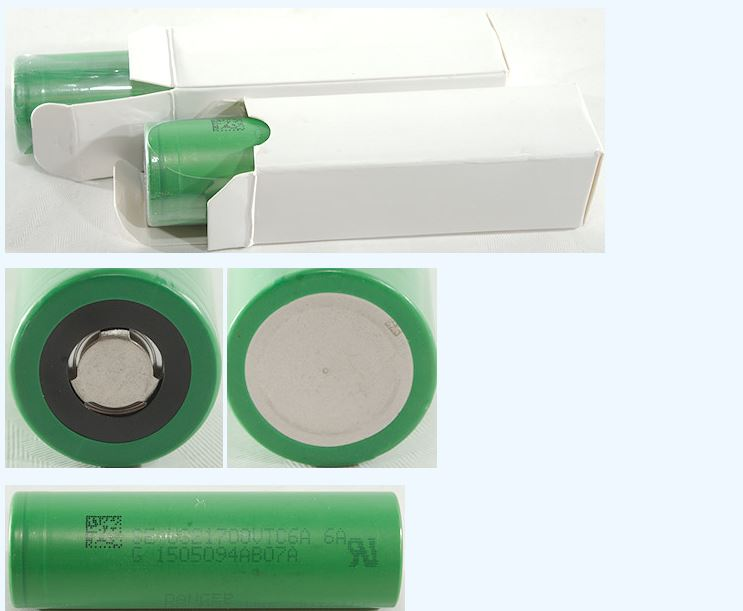
Electronics/Akku/Zelle/Sony US21700VTC6A photo.JPG
