unlegitGurke/RC-Car/Electronics/LattePanda_Shield/Platine_1.png

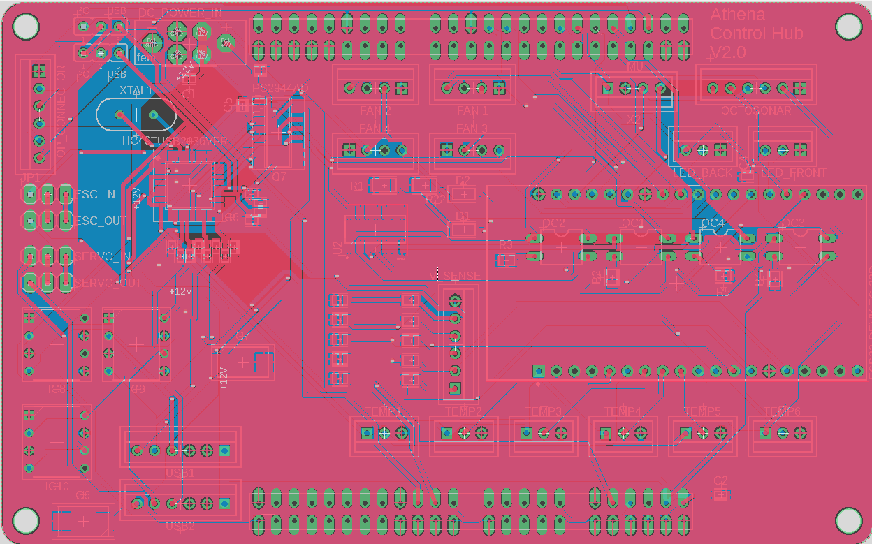
Electronics/LattePanda_Shield/Platine_1.png
