unlegitGurke/RC-Car/Electronics/LattePanda_Shield/Stromlaufplan_1.png

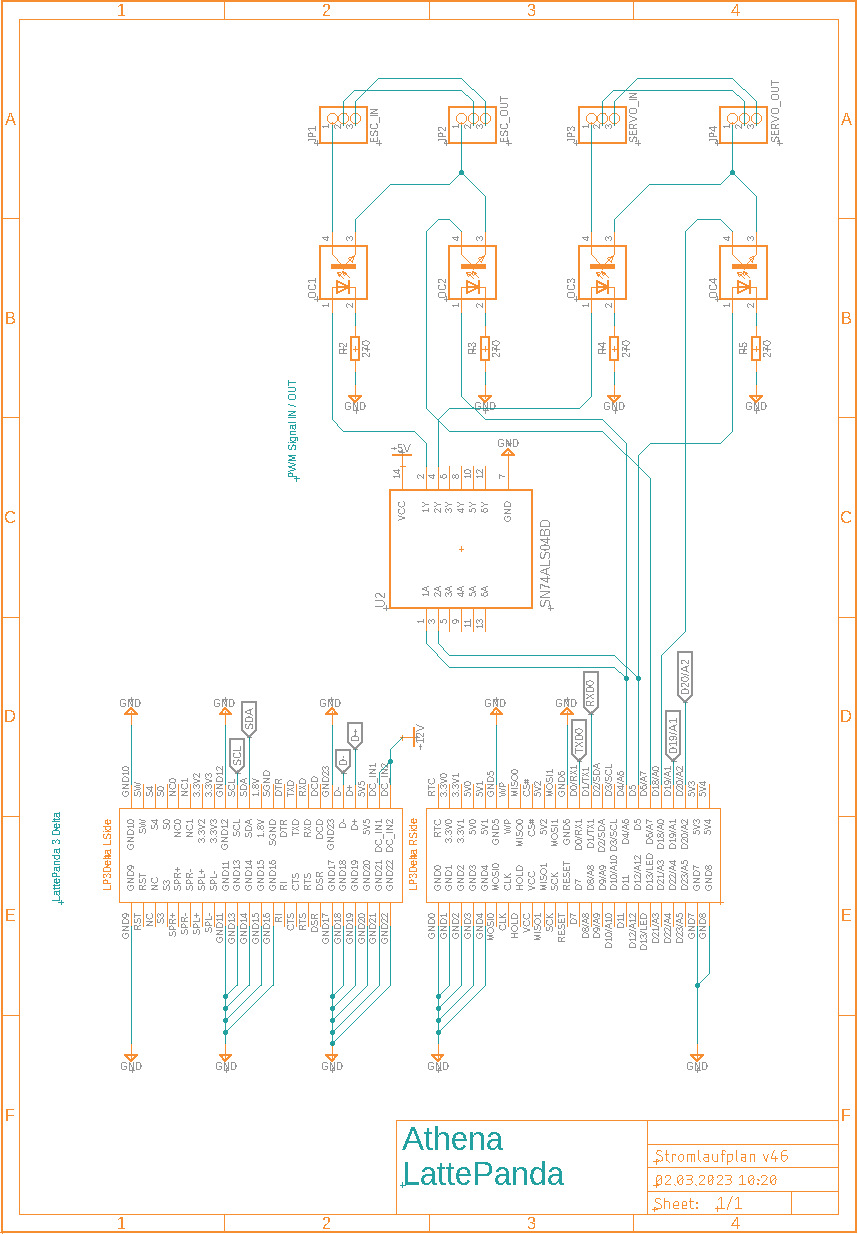
Electronics/LattePanda_Shield/Stromlaufplan_1.png
