unlegitGurke/RC-Car/Electronics/LED/Renderings/WS2812B_BLACK_60leds_per_meter_single.png

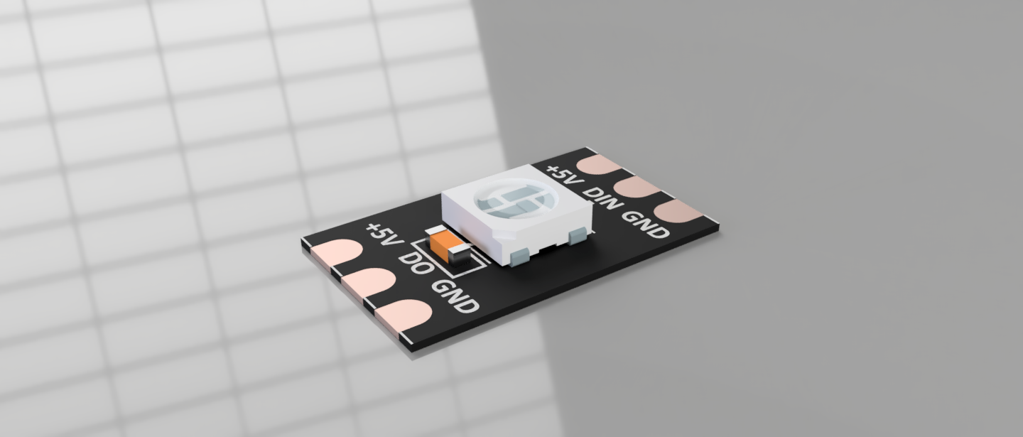
Electronics/LED/Renderings/WS2812B_BLACK_60leds_per_meter_single.png
