unlegitGurke/RC-Car/Electronics/Motor/Motor_Maße.jpg

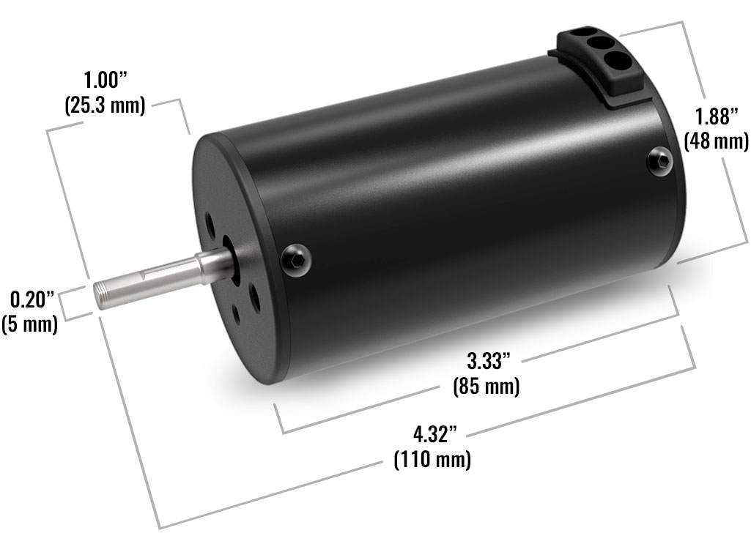
Electronics/Motor/Motor_Maße.jpg
