unlegitGurke/RC-Car/Electronics/RaspberryPI_Shield/Arduino Nano/Arduino Nano R3 ATmega 328P 3DView.JPG

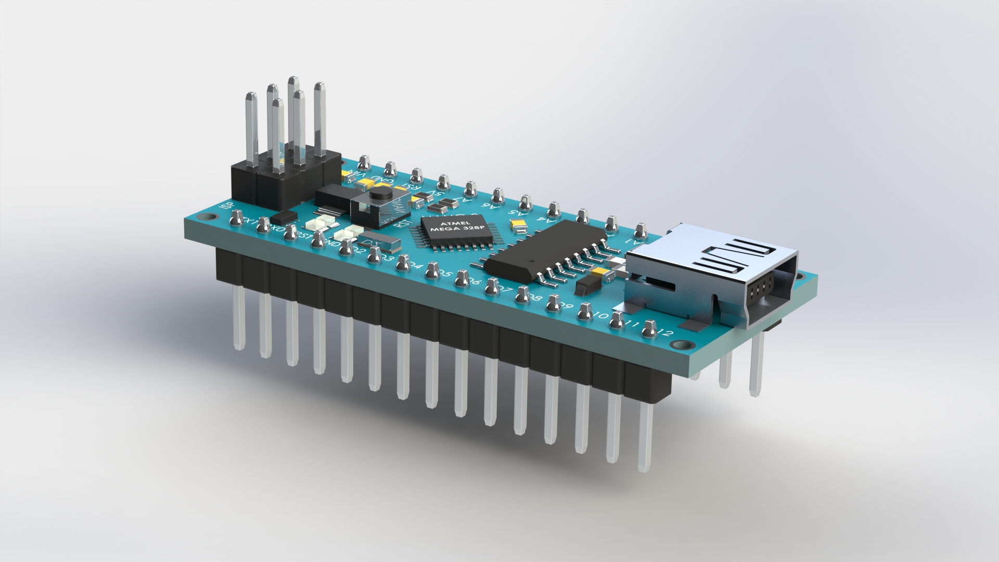
Electronics/RaspberryPI_Shield/Arduino Nano/Arduino Nano R3 ATmega 328P 3DView.JPG
