unlegitGurke/RC-Car/Electronics/RaspberryPI_Shield/Connector Pi/PBD-R.png

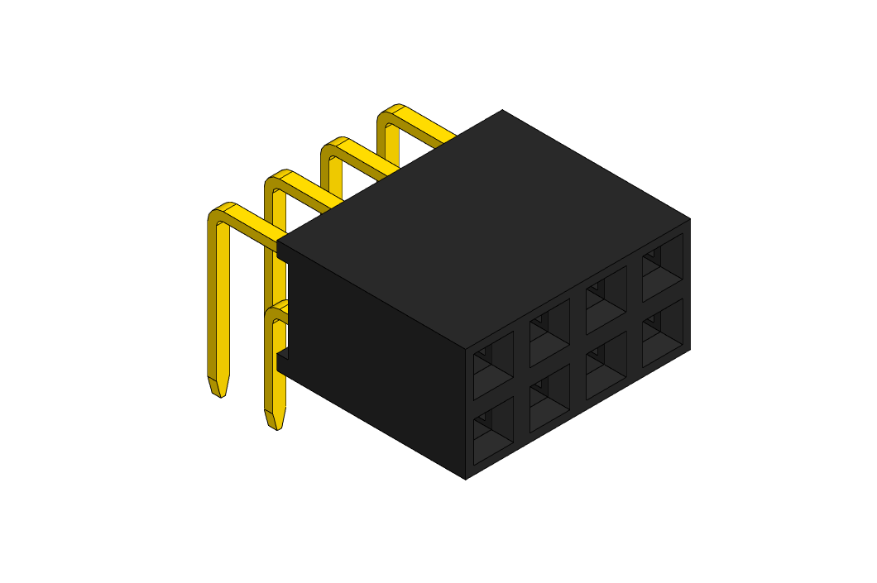
Electronics/RaspberryPI_Shield/Connector Pi/PBD-R.png
