unlegitGurke/RC-Car/Electronics/RaspberryPI_Shield/Connector Pi/PBD.png

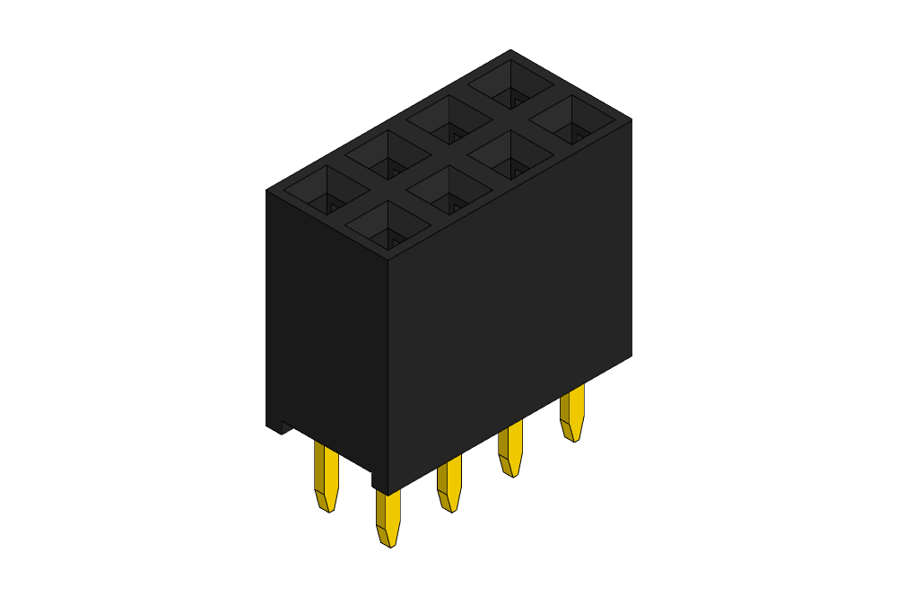
Electronics/RaspberryPI_Shield/Connector Pi/PBD.png
