unlegitGurke/RC-Car/Electronics/RaspberryPI_Shield/NEW_Shield/molex-2-54-mm-6-pines-1.snapshot.1/Molex6.jpg

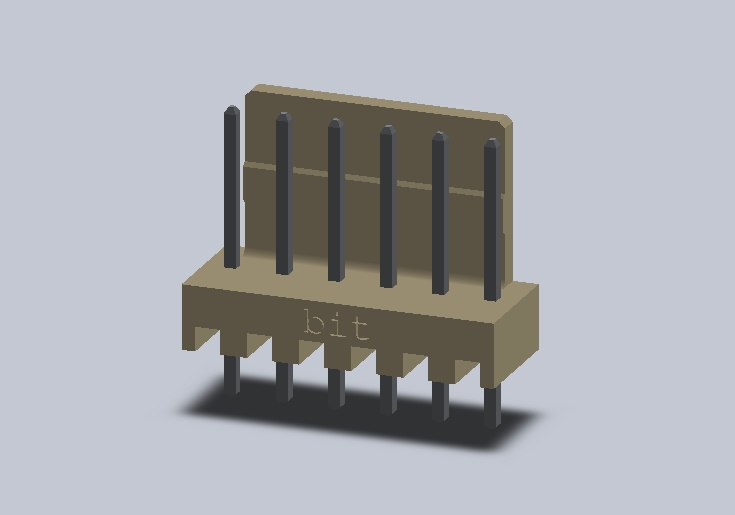
Electronics/RaspberryPI_Shield/NEW_Shield/molex-2-54-mm-6-pines-1.snapshot.1/Molex6.jpg
