unlegitGurke/RC-Car/Electronics/USB/USB Connector_Exploded.jpg

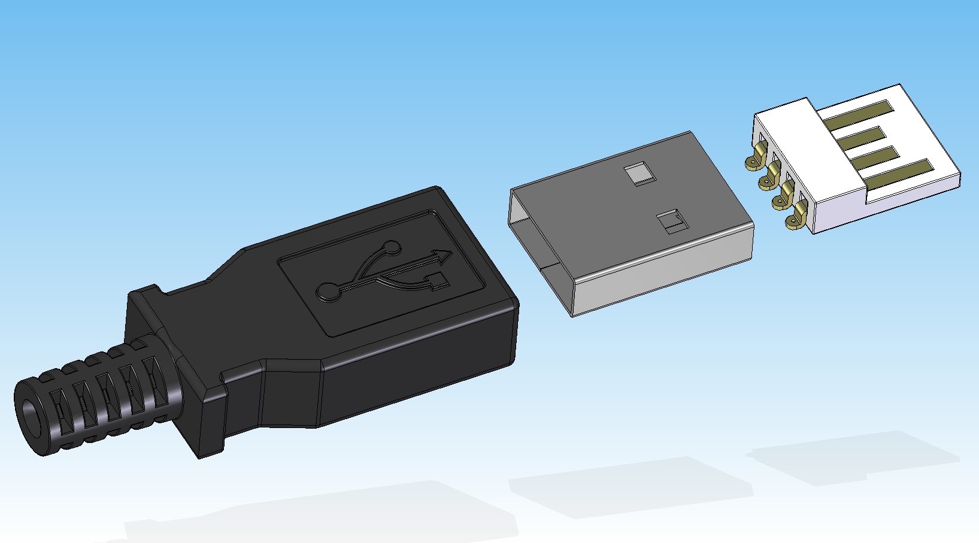
Electronics/USB/USB Connector_Exploded.jpg
