unlegitGurke/RC-Car/dataTypen_Arduino_Comms.xlsx

name | TYP | valCount | valNames | access | expected data | array data[n] | error
IMU1 6DoF | 1 | 6 | float ax, float ay, float az, float gx, float gy, float gz | 1 | float |  | 0
IMU2 3DoF | 2 | 3 | float mx, float my, float mz | 1 | float |  | 0
16 x sonar | 3 | 16 | int n_distanz | 1 | int |  | 0
volts | 4 | 5 | int n_volt | 1 | int |  | 0
temp | 5 | 6 | float? n_temp | 1 | float |  | 0
FAN | 6 | 5 | int n_pwm | 2 | int |  | 0
LED | 7 | 4 | int 00000000b,int effect, hex clr_1, hex clr_2 | 2 | int |  | 0
ERR | 0 | 4 | n/a | 2 | n/a |  | 0
IMU3 Quat | 8 | 4 | float quat1, float quat2, float quat3, float quat4 | 1 | float |  | 0
 |  |  |  | 0 |  | Read only || to ESP only | 0 | no fault
 |  |  |  | 1 |  | Write only || to LattePanda only | 1 | warning
 |  |  |  | 2 |  | Read and Write || to both | 2 | fatal error
