unlegitGurke/RC-Car/Bestellliste_Schule_V3.0.xlsx

Bestellliste
Teil | Link | Anzahl | Preis inkl. MwSt / € | Preis insg. / € | Unbedingt nötig | Notiz
8AWG Silicone Wire 2x 3m | Amazon (https://www.amazon.de/-/en/Makerfire-Silicone-Electrical-Flexible-Temperature/dp/B0B21DB6TP) | 1 | 27.22 | 27.22 | 1.00 |  | 27.22
14AWG Silicone Wire | Amazon (https://www.amazon.de/8AWG-Silicone-Electrical-Temperature-Resistant/dp/B0C53DH8W7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) | 1 | 19.15 | 19.15 | 1.00 |  | 19.15
10x 8mm Bullet Connector | Amazon (https://www.amazon.de/-/en/VUNIVERSUM-Contact-Connector-Polyolefine-Battery/dp/B08NFCBFJV) | 1 | 10.07 | 10.07 | 1.00 |  | 10.07
6x XT150 Connector | Amazon (https://www.amazon.de/-/en/Pairs-Adapter-Female-Connector-Battery/dp/B078R5RFBJ) | 1 | 12.10 | 12.10 | 1.00 |  | 12.1
8x XT90 Connector | Amazon (https://www.amazon.de/Connector-Battery-Helicopter-Quadcopter-Insulation-8-Pairs-Xt90H-Connectors/dp/B0BM9M3BCS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) | 1 | 10.07 | 10.07 | 1.00 |  | 10.07
 |  |  | Summe: | 78.61
