unlegitGurke/RC-Car/Bestellung_WG_Global.xlsx

Bestellliste
Teil | Link | Anzahl | Preis inkl. MwSt & Versand / € | Versand | Preis insg. / € | Artikelnummer | Notiz
TPPower TP5860-Sensor | TPPower (https://www.tppowerusa.com/index.php?route=product/product&path=20_27_63&product_id=311) | 1 | 295.00 | 54.95 | 349.95 | TP 5860 | Add Sensor, open vents, flat spot on shaft, 8D, 30mm shaft length
Flipsky FSESC 75200-Pro | Flipsky (https://flipsky.net/products/flipsky-75200-pro-84v-high-current-with-aluminum-pcb-based-on-vesc-for-fighting-robot-surfboard-agv-robot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) | 1 | 186.23 | 41.61 | 227.84 | Flipsky 75200 Pro
Flipsky Antisparkswitch | Flipsky (https://flipsky.net/products/flipsky-anti-spark-switch-smart-enhanced-300a-for-electric-skateboard-ebike-scooter-robots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) | 1 | 50.44 | 0.00 | 50.44 | Flipsky Anti Spark Switch Smart Enhanced 300A | Versand bei Flipsky FSESC 75200-Pro inkludiert, Style 12mm Button
Noctua NF-A6x25 5V PWM | Amazon (https://www.amazon.de/-/en/Noctua-NF-A6x25-Premium-Quiet-Version/dp/B01G20PGOQ) | 2 | 17.04 | 0.00 | 34.08 | NF-A6x25
Noctua NF-A4x20 5V PWM | Amazon (https://www.amazon.de/-/en/NF-A4x20-5V-PWM-Premium-Version/dp/B071FNHVXN) | 3 | 16.03 | 0.00 | 48.09 | NF-A4x20
Gens Ace 4s Lipo | Amazon (https://www.amazon.de/Gens-6750mAh-Steck-Hardcase-Batterie/dp/B01GDQAMA2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) | 2 | 94.78 | 0.00 | 189.56 | B-70C-6750-4S1P-HARDCASE-14
ISDT K1 Lipo Charger | Amazon (https://www.amazon.de/ISDT-Ladeger%C3%A4t-250WX2-Balance-Batterien/dp/B0919KGZ8M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) | 1 | 98.72 | 0.00 | 98.72 | B0919KGZ8M
Sunlu Filament Dryer | Amazon (https://www.amazon.de/-/en/Official-Improved-Filament-All-Round-Efficiently/dp/B09Q32FNN4) | 1 | 58.99 | 0.00 | 58.99
BambuLab PET-CF Filament 1kg | BambuStore (https://eu.store.bambulab.com/en-at/products/pet-cf?variant=44012072763611) | 2 | 91.75 | 0.00 | 183.50 | PET-CF
BambuLab PAHT-CF Filament 1kg | BambuStore (https://eu.store.bambulab.com/products/paht-cf?variant=43923846889691) | 2 | 101.99 | 0.00 | 203.98 | PAHT-CF
BambuLab TPU95A-HF Filament 1kg | BambuStore (https://eu.store.bambulab.com/en-at/products/tpu-95a-hf?variant=47305218785628) | 1 | 44.36 | 0.00 | 44.36 | TPU95-HF | Farbe: Grey
Sunlu PLA Matte | Sunlu Store (https://www.sunlu.com/collections/10th-fdm-filament-sales/products/over-6kg-bulk-sale-pla-matte-filament-neatly-wound-filament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) | 6 | 14.09 | 0.00 | 84.54 | PLA Matte Filament | 3x PLA Matte Black, 3x PLA Matte Grey, over 6kg Bundle Deal verwenden!
M.2E to B Adapter | Makerfabs (https://www.makerfabs.com/dual-edge-tpu-adapter-m2-2280-b-m-key.html) | 1 | 30.00 | 5.80 | 35.80 | MBS.MBM20102.3
 |  |  | Summe: |  | 1609.85
