unlegitGurke/RC-Car/Bestellung_Partsforstudents.xlsx

Bestellliste
Teil | Link | Anzahl | Preis inkl. MwSt & Versand / € | Preis insg. / € | Preis lt. Angebot | Preis lt Angeobt inkl MwSt | % Erhöhung | Notiz
TPPower TP5860-Sensor | TPPower (https://www.tppowerusa.com/index.php?route=product/product&path=20_27_63&product_id=311) | 1 | 346.10 | 346.10 | 480.00 | 576.00 | 66.43% | Add Sensor, open vents, flat spot on shaft, 8D, 30mm shaft length
Flipsky FSESC 75200-Pro | Flipsky (https://flipsky.net/products/flipsky-75200-pro-84v-high-current-with-aluminum-pcb-based-on-vesc-for-fighting-robot-surfboard-agv-robot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) | 1 | 235.00 | 235.00 | 280.00 | 336.00 | 42.98% | Versandkosten inkludiert
Flipsky Antisparkswitch | Flipsky (https://flipsky.net/products/flipsky-anti-spark-switch-smart-enhanced-300a-for-electric-skateboard-ebike-scooter-robots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) | 1 | 52.00 | 52.00 | 60.00 | 72.00 | 38.46%
Noctua NF-A6x25 5V PWM | Amazon (https://www.amazon.de/-/en/Noctua-NF-A6x25-Premium-Quiet-Version/dp/B01G20PGOQ) | 2 | 17.04 | 34.08 | 40.00 | 48.00 | 40.85%
Noctua NF-A4x20 5V PWM | Amazon (https://www.amazon.de/-/en/NF-A4x20-5V-PWM-Premium-Version/dp/B071FNHVXN) | 3 | 16.03 | 48.09 | 57.00 | 68.40 | 42.23%
Gens Ace 4s Lipo | Amazon (https://www.amazon.de/Gens-6750mAh-Steck-Hardcase-Batterie/dp/B01GDQAMA2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) | 2 | 80.66 | 161.32 | 190.00 | 228.00 | 41.33%
ISDT K1 Lipo Charger | Amazon (https://www.amazon.de/ISDT-Ladeger%C3%A4t-250WX2-Balance-Batterien/dp/B0919KGZ8M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) | 1 | 98.72 | 98.72 | 100.00 | 120.00 | 21.56%
Sunlu Filament Dryer | Amazon (https://www.amazon.de/-/en/Official-Improved-Filament-All-Round-Efficiently/dp/B09Q32FNN4) | 1 | 56.46 | 56.46 | 0.00 | 0.00 | -100.00%
Traxxas Dämpfer | TRAShop (https://www.trashop.eu/traxxas-daempfer-gtx-alu-rot-eloxiert-montiert-ohne-federn-trx7761r.html) | 2 | 74.95 | 149.90 | 150.00 | 180.00 | 20.08%
Traxxas Motorritzel 11Z | TRAShop (https://www.trashop.eu/traxxas-motorritzel-11-zaehne-1-0-modul-fuer-5mm-welle-trx6484x.html) | 1 | 4.95 | 4.95 | 5.00 | 6.00 | 21.21%
Traxxas Motorritzel 26Z | TRAShop (https://www.trashop.eu/traxxas-motorritzel-26-zaehne-1-0-modul-fuer-5mm-welle-trx6497.html) | 1 | 6.95 | 6.95 | 7.00 | 8.40 | 20.86%
Traxxas Differential hinten | TRAShop (https://www.trashop.eu/traxxas-differential-hinten-komplett-fuer-x-maxx-trx7881.html) | 1 | 54.95 | 54.95 | 55.00 | 66.00 | 20.11%
Traxxas Motorzahnrad 54Z | TRAShop (https://www.trashop.eu/traxxas-zahnrad-54-zaehne-stahl-breit-trx6449r.html) | 1 | 18.95 | 18.95 | 18.50 | 22.20 | 17.15%
Traxxas Antriebswellen | TRAShop (https://www.trashop.eu/traxxas-stahl-antriebswellen-set-rot-x-maxx-8s-x-maxx-antriebswellen-set-rot.htmlhttps:/www.trashop.eu/traxxas-stahl-antriebswellen-set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) | 1 | 169.95 | 169.95 | 170.00 | 204.00 | 20.04%
Traxxas Zentraldifferential | TRAShop (https://www.trashop.eu/traxxas-center-drive-torque-biasing-trx7796.html) | 1 | 68.95 | 68.95 | 70.00 | 84.00 | 21.83%
GPMRacing Cush Drive Gehäuse | TRAShop (https://www.trashop.eu/gpm-racing-alu-cush-drive-gehaeuse-schwarz-gpmer2035bk.html) | 1 | 18.95 | 18.95 | 18.50 | 22.20 | 17.15%
Traxxas Cush Drive Dämpfer | TRAShop (https://www.trashop.eu/traxxas-cush-drive-daempfer-trx7794.html) | 1 | 3.95 | 3.95 | 4.00 | 4.80 | 21.52%
BambuLab PET-CF Filament 1kg | BambuStore (https://eu.store.bambulab.com/en-at/products/pet-cf?variant=44012072763611) | 2 | 91.47 | 182.94 | 220.00 | 264.00 | 44.31%
BambuLab PAHT-CF Filament 1kg | BambuStore (https://eu.store.bambulab.com/products/paht-cf?variant=43923846889691) | 2 | 101.99 | 203.98 | 244.00 | 292.80 | 43.54%
BambuLab TPU95A Filament 1kg | BambuStore (https://eu.store.bambulab.com/en-at/collections/bambu-lab-3d-printer-filament/products/tpu-filament) | 1 | 46.38 | 46.38 | 54.00 | 64.80 | 39.72%
Sunlu PLA Matte | Sunlu Store (https://www.sunlu.com/collections/10th-fdm-filament-sales/products/over-6kg-bulk-sale-pla-matte-filament-neatly-wound-filament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) | 6 | 14.27 | 85.62 | 102.00 | 122.40 | 42.96% | 3x PLA Matte Black, 3x PLA Matte Grey, over 6kg Bundle Deal verwenden!
M.2E to B Adapter | Makerfabs (https://www.makerfabs.com/dual-edge-tpu-adapter-m2-2280-b-m-key.html) | 1 | 30.00 | 30.00 | 50.00 | 60.00 | 100.00%
 |  |  | Summe: | 2078.19 | 2375.00 | 2850.00 | 35.44%
