unlegitGurke/RC-Car/Einkaufsliste.xlsx

Teil: | Typ: | Link: | Menge: | Preis: | Preis insg.: | Gekauft:
Elektronik:
Motor: | TPPower 5860-Sensor | TPPower (https://tppower.de/epages/bd5f179c-685e-4a79-bbe0-e825a2cc9e1a.sf/sec058311cd1b/?ObjectID=32916168) | 1 | 346.1 | 346.1
ESC: | Flipsky FSESC 75200 Pro | Flipsky (https://flipsky.net/products/flipsky-75200-pro-84v-high-current-with-aluminum-pcb-based-on-vesc-for-fighting-robot-surfboard-agv-robot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) | 1 | 297.8 | 297.8
Antisparkswitch: | Flipsky Antisparkswitch | Flipsky (https://flipsky.net/products/flipsky-anti-spark-switch-smart-enhanced-300a-for-electric-skateboard-ebike-scooter-robots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) | 1 | 0 | 0
Servo: | Savöx SB-2290SG | Lindinger (https://www.lindinger.at/de/RC-Elektronik/RC-Anlagen/Servos/SAVOEX-SB-2290SG-BRUSHLESS-SERVO-7-4V-SCHWARZ-BLACK-LINE-50KG-0-11SEK/9738545) | 1 | 119.99 | 119.99
Reciever: |  |  | 1
Fernbedienung: |  |  | 1
Raspberry Pi | Raspberry Pi 4 B 4GB | Buyzero (https://buyzero.de/products/raspberry-pi-4-model-b-8gb) | 1 | 78.39 | 78.39
Ultraschallsensor | JSN-SR04T | Amazon (https://www.amazon.de/gp/product/B07Z915YCY/ref=ppx_yo_dt_b_asin_title_o00_s00?ie=UTF8&psc=1) | 8 | 9.95 | 79.6
Octosonar: | PCB | JLCPCB (https://jlcpcb.com/orderDetails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) | 1 | 5.84 | 5.84
 | SMDs | Mouser.at | 1 | 62.35 | 62.35
Linear Actuator: | Machfit 6V/9,5mm/s | Banggood (https://www.banggood.com/de/Machifit-DC-6-or-12V-21mm-Stroke-Mini-Electric-Linear-Actuator-Motor-Aluminum-Alloy-Linear-Actuators-Linear-Motor-Telescopic-Rod-L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) | 1 | 23.53 | 23.53
Motorlüfter: | AVC DV05028B12U | Banggood (https://de.aliexpress.com/item/1501415431.html?pdp_ext_f=%7B%22sku_id%22%3A%2254971727917%22%7D) | 2 | 12.59 | 25.18
Step-Down | 15A 200W | Banggood (https://de.aliexpress.com/item/32895999061.html?pdp_ext_f=%7B%22sku_id%22%3A%2265740838912%22%7D) | 1 | 4.8 | 4.8
Getriebe:
Motorritzel 26Z: | TRX6497 | TRXShop (https://www.trxshop.eu/traxxas-motorritzel-26-zaehne-1-0-modul-fuer-5mm-welle-trx6497.html) | 1 | 6.95 | 6.95
Motorritzel 18Z: | TRX6487R | TRXShop (https://www.trxshop.eu/traxxas-zahnrad-18-ritzel-1-0-modul-5mm-welle-extra-hart-trx6491r.html) | 0 | 11.95 | 0
Hauptzahnrad 54Z: | TRX6449R | TRXShop (https://www.trxshop.eu/traxxas-zahnrad-54-zaehne-stahl-breit-trx6449r.html) | 1 | 18.95 | 18.95 | plastik von philipp
Slipclutch: | TRX7789 | TRXShop (https://www.trxshop.eu/traxxas-rebuild-kit-slipper-clutch-trx7789.html) | 1 | 11.95 | 11.95 | philipp
 | TRX7788 | TRXShop (https://www.trxshop.eu/traxxas-slipper-druckplatte-und-mitnehmer-trx7788.html) | 1 | 11.95 | 11.95 | philipp
 | TRX4611 | TRXShop (https://www.trxshop.eu/traxxas-kugellager-5x11x4mm-trx4611.html) | 1 | 6.95 | 6.95
 | TRX5180 | TRXShop (https://www.trxshop.eu/traxxas-kugellager-6x13x5mm-schwarz-gummidichtung-trx5180a.html) | 1 | 4.95 | 4.95
 | TRX2576 | TRXShop (https://www.trxshop.eu/traxxas-rundkopfschrauben-3x8mm-trx2576.html) | 1 | 2.95 | 2.95 | schraubenking
 | TRX7786X | TRXShop (https://www.trxshop.eu/traxxas-input-welle-getriebe-slipper-welle-trx7786x.html) | 1 | 6.95 | 6.95 | philipp
 | TRX7785X | TRXShop (https://www.trxshop.eu/traxxas-input-zahnrad-getriebe-20-zaehne-trx7785x.html) | 1 | 4.95 | 4.95 | philipp
Center Drive | TRX7796 | TRXShop (https://www.trxshop.eu/traxxas-center-drive-torque-biasing-trx7796.html) | 1 | 68.95 | 68.95 | bearings fehlen
Zentral Kardan | TRX7755 | TRXShop (https://www.trxshop.eu/traxxas-zentral-kardan-alu-trx7755.html) | 1 | 13.95 | 13.95
Differntial Hinten | TRX7781 | TRXShop (https://www.trxshop.eu/traxxas-differential-hinten-komplett-fuer-x-maxx-trx7881.html) | 1 | 54.95 | 54.95 | innneleben und abdeckung
Differntial Vorne | TRX7780 | TRXShop (https://www.trxshop.eu/traxxas-differential-vorne-komplett-fuer-x-maxx-trx7880.html) | 1 | 59.95 | 59.95 | bearings fehlen
Drive Cup | TRX7754X | TRXShop (https://www.trxshop.eu/traxxas-drive-cup-trx7754x.html) | 4 | 13.95 | 55.8 | philipp
Antriebswelle | TRX7750X | TRXShop (https://www.trxshop.eu/traxxas-antriebswelle-stahl-constant-velocity-nur-welle-160mm-trx7750x.html) | 4 | 17.95 | 71.8 | philipp
 | TRX7751X | TRXShop (https://www.trxshop.eu/traxxas-rebuild-kit-stahl-constant-velocity-antriebswelle-trx7751x.html) | 2 | 4.95 | 9.9 | philipp
 | TRX7768A | TRXShop (https://www.trxshop.eu/traxxas-stub-achse-alu-schwarz-trx7768a.html) | 4 | 16.95 | 67.8 | philipp
 | TRX5182A | TRXShop (https://www.trxshop.eu/traxxas-kugellager-20x27x4mm-schwarz-gummidichtung-trx5182a.html) | 2 | 11.95 | 23.9
 | TRX8106A | TRXShop (https://www.trxshop.eu/traxxas-kugellager-15x24x5mm-schwarz-gummidichtung-trx5106a.html) | 2 | 8.95 | 17.9
 | TRX7756 | TRXShop (https://www.trxshop.eu/traxxas-radmitnehmer-sechskant-trx7756.html) | 2 | 3.95 | 7.9
Dämpfer | TRX7761R | TRXShop (https://www.trxshop.eu/traxxas-daempfer-gtx-alu-rot-eloxiert-montiert-ohne-federn-trx7761r.html) | 2 | 74.95 | 149.9
Federn | TRX7858 | TRXShop (https://www.trxshop.eu/traxxas-daempfer-feder-gtx-1-538-rate-trx7858.html) | 2 | 17.95 | 35.9
 |  |  |  |  | 1758.73
