unlegitGurke/RC-Car/KyoceraAVX.xlsx

Kyocera AVX RC-Car Teile
Teil | Link | Konfiguration / Angebot | Anzahl | Preis inkl. MwSt & Versand / € | Preis insg. / € | Notiz
TPPower TP5860-Sensor | tppower.de (https://tppower.de/epages/bd5f179c-685e-4a79-bbe0-e825a2cc9e1a.sf/secd70b6b8a86/) |  | 1 | 342.13 | 342.13
Flipsky 75200 ESC | flipsky.net (https://flipsky.net/products/flipsky-75200-84v-high-currentwith-aluminum-pcb-based-on-vesc-for-for-e-foil-fighting-robot-surfboard-agv-robot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) |  | 1 | 268.06 | 268.06 | Preise könnten sich laut aktuellem USD/Euro Kurs ändern, da flipsky.net in USD verrechnet, verwendeter Kurs: 1 USD = 1,02€, Stand: 02.10.2022. Es wurden 20% VAT dazugerechnet.
Flipsky Anti-Spark-Switch | flipsky.net (https://flipsky.net/products/flipsky-anti-spark-switch-aluminum-pcb-300a-for-electric-skateboard-ebike-scooter-robots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) |  | 1 | 88.37 | 88.37 | Preise könnten sich laut aktuellem USD/Euro Kurs ändern, da flipsky.net in USD verrechnet, verwendeter Kurs: 1 USD = 1,02€, Stand: 02.10.2022. Es wurden 20% VAT dazugerechnet.
Bluetooth Module VESC | flipsky.net (https://flipsky.net/products/core51822-ble4-0-bluetooth-2-4g-wireless-module-nrf51822-onboard-ws82013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) |  | 1 | 30.23 | 30.23 | Preise könnten sich laut aktuellem USD/Euro Kurs ändern, da flipsky.net in USD verrechnet, verwendeter Kurs: 1 USD = 1,02€, Stand: 02.10.2022. Es wurden 20% VAT dazugerechnet.
Versand flipsky.net | flipsky.net |  | 1 | 41.00 | 41.00 | Versandkosten für alle auf flipsky.net bestelten Teile
JSN-SR04T Ultraschallsensor | amazon.de (https://www.amazon.de/gp/product/B07Z915YCY/ref=ox_sc_act_title_1?smid=AETO64PHCI4NL&psc=1) |  | 4 | 9.95 | 39.80
Lattepanda 3 Delta | dfrobot.com (https://www.dfrobot.com/product-2594.html) |  | 1 | 370.00 | 370.00 | 370€ setzen sich aus dem Preis inkl. Versand + 20% VAT zusammen
300W 20A DC-DC Buck Converter | amazon.de (https://www.amazon.de/gp/product/B07RGWJHPZ/ref=ox_sc_act_title_1?smid=AETO64PHCI4NL&psc=1) |  | 2 | 13.10 | 26.20
30-75V - 12V Buck Converter 20A | aliexpress.com (https://de.aliexpress.com/item/1005002295226200.html?curPageLogUid=Txbkd3vq2pag) |  | 1 | 26.71 | 26.71
Differntial TRX7881 | trashop.eu (https://www.trashop.eu/product_info.php?no_boost=1) |  | 1 | 54.95 | 54.95
JetKo Tomahawk Belted Reifen | trashop.eu (https://www.trashop.eu/jetko-tomahawk-belted-extreme-reifen-auf-schwarzen-felgen-jk5801cbxmaxx.html) |  | 2 | 52.95 | 105.90
Versand trashop.eu | trashop.eu |  | 1 | 4.95 | 4.95 | Versandkosten für alle auf trashop.eu bestelten Teile
 |  |  |  | Summe: | 1398.30
