unlegitGurke/RC-Car/Schweighofer.xlsx

Der Schweighofer RC-Car Teile
Teil | Link | Anzahl | Preis / € | Preis insg. / €
Lipo 4s 4500 mAh | Schweighofer (https://www.der-schweighofer.at/LiPo-Akku-4S-148V-4500-mAh-50C-XT60-MODSTER-PowerPack-a293945) | 4 | 99.99 | 399.96
4-Kanal Fernbedienung | Schweighofer (https://www.der-schweighofer.at/MODSTER-XC4-4-Kanal-Fernsteuerung-inkl.-MODSTER-MR4R-Empfaenger-a282469) | 1 | 24.99 | 24.99
Lipo Tasche | Schweighofer (https://www.der-schweighofer.at/MODSTER-LiPo-Bag-Akku-Tasche-205-x16-x-14cm-schwarz-a293862) | 1 | 19.99 | 19.99
Savöx SB-2290SG | Savöx Shop (https://www.savox-shop.com/de/sb.html) | 1 | 119.90 | 119.90
Lipo Ladegerät | Schweighofer (https://www.der-schweighofer.at/Ladegeraet-AC-DC-SkyRC-Q200-LiPo-1-6S-10A-2x100W-2x50W-a283751) | 1 | 189.99 | 189.99
Dämpfer | Schweighofer (https://www.der-schweighofer.at/TRAXXAS-XMAXX-Daempfer-GTX-Alu-rot-eloxiert-kpl.-montiert-ohne-Federn-a228047) | 2 | 73.83 | 147.66
Federn | Schweighofer (https://www.der-schweighofer.at/XMAXX-Daempfer-Feder-natural-finish-GTX-1.199-rate-2-a228077) | 2 | 15.98 | 31.96
Motorritzel 26Z | Schweighofer (https://www.der-schweighofer.at/Ritzel-26-Zaehne-48dp-2.3mm-a116491) | 1 | 3.52 | 3.52
Kugelager | Schweighofer (https://www.der-schweighofer.at/Kugellagersatz-a181963) | 1 | 41.79 | 41.79
Radmitnehmer | Schweighofer (https://www.der-schweighofer.at/TRAXXAS-XMAXX-Radmitnehmer-Sechskant-Alu-rot-eloxiert-4-a228042) | 1 | 20.43 | 20.43
Kardanwelle TRX7755 | Trashop (https://www.trashop.eu/traxxas-zentral-kardan-alu-trx7755.html) | 1 | 13.95 | 13.95
 |  |  | Summe: | 1014.14
