unlegitGurke/RC-Car/Diplomarbeit/Athena/4_Mechanik/Abbildungen/Aufbau_Anleitung_render/Antriebsstrang_Stückliste.png

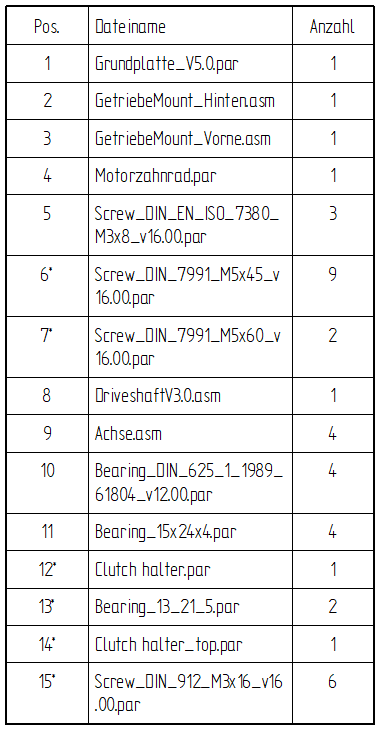
Diplomarbeit/Athena/4_Mechanik/Abbildungen/Aufbau_Anleitung_render/Antriebsstrang_Stückliste.png
