unlegitGurke/RC-Car/Electronics/Akku/Cell Cage/holder 3cell.SLDASM

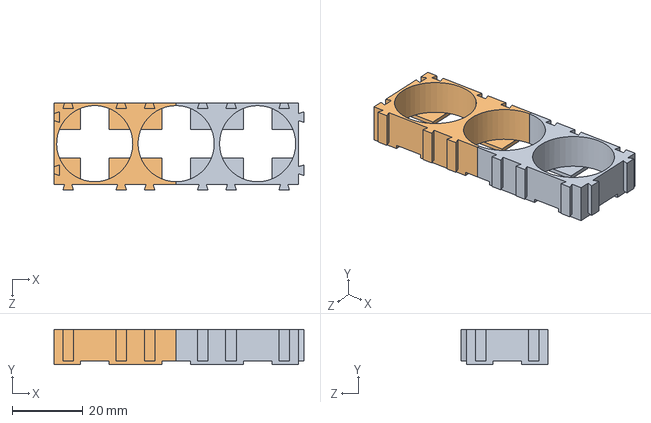
[picture p175: CAD file, 2022-01-23]
Electronics/Akku/Cell Cage/holder 3cell.SLDASM
70.6 x 10.0 x 24.6 mm
holder 21250
holder 21 hf
