unlegitGurke/RC-Car/Electronics/Buck Converter/LM2596 DC to DC Buck Converter 3 A/converterLM2596.SLDASM

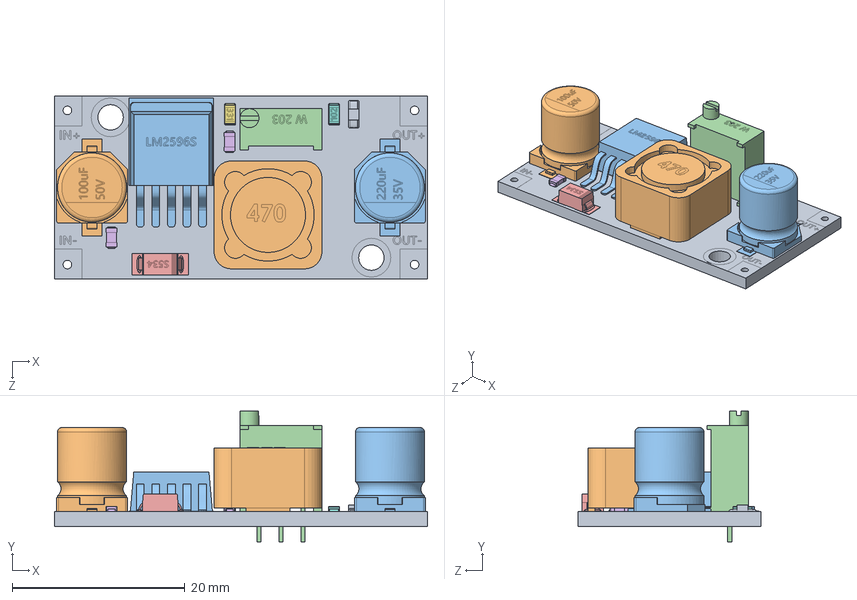
[picture p177: CAD file, 2021-02-09]
Electronics/Buck Converter/LM2596 DC to DC Buck Converter 3 A/converterLM2596.SLDASM
43.2 x 15.1 x 21.2 mm
lm2596board
smd100uF
smd220uF
TrimmerW203
smdS537diode
smdceramiccapacitor x 2
smdResistor331
smdResistor102
smdLED
smbInductor470
LM2596S
