unlegitGurke/RC-Car/Electronics/4-pin-pwm-connector-1.snapshot.1/4-Pin-PWM-female.SLDASM

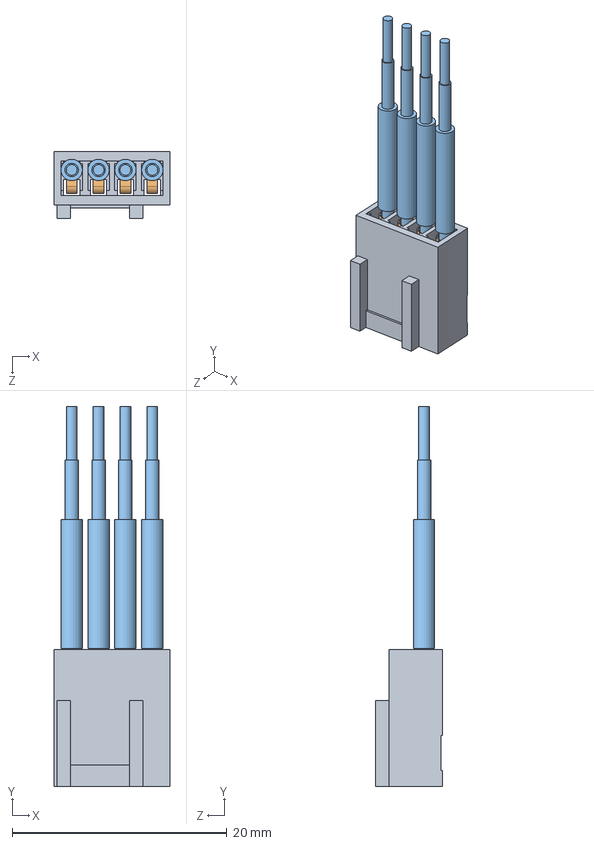
[picture p178: CAD file, 2021-12-27]
Electronics/4-pin-pwm-connector-1.snapshot.1/4-Pin-PWM-female.SLDASM
10.8 x 35.4 x 6.25 mm
4-PIN-PWM-female
PWM-Crimp x 4
Kabelstueck-500µm x 4
