unlegitGurke/RC-Car/Aufhängung/Feder_Mount_Final.stl

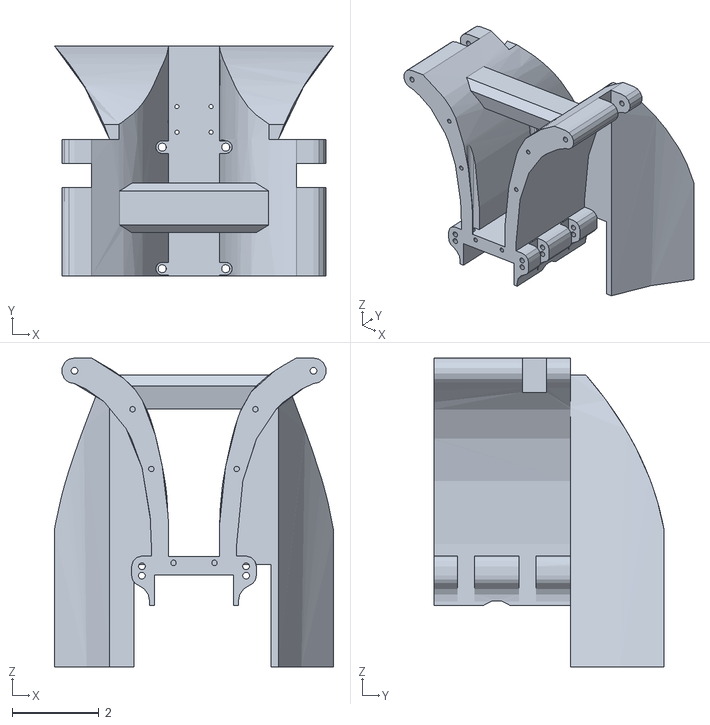
[picture p179: CAD file, 2021-04-24]
Aufhängung/Feder_Mount_Final.stl
6.44 x 5.31 x 7.13
