unlegitGurke/RC-Car/Chassis/Mounting/ruthex+Step-Data+threaded+inserts+M2-M8/files/RX-M8x12.7.step

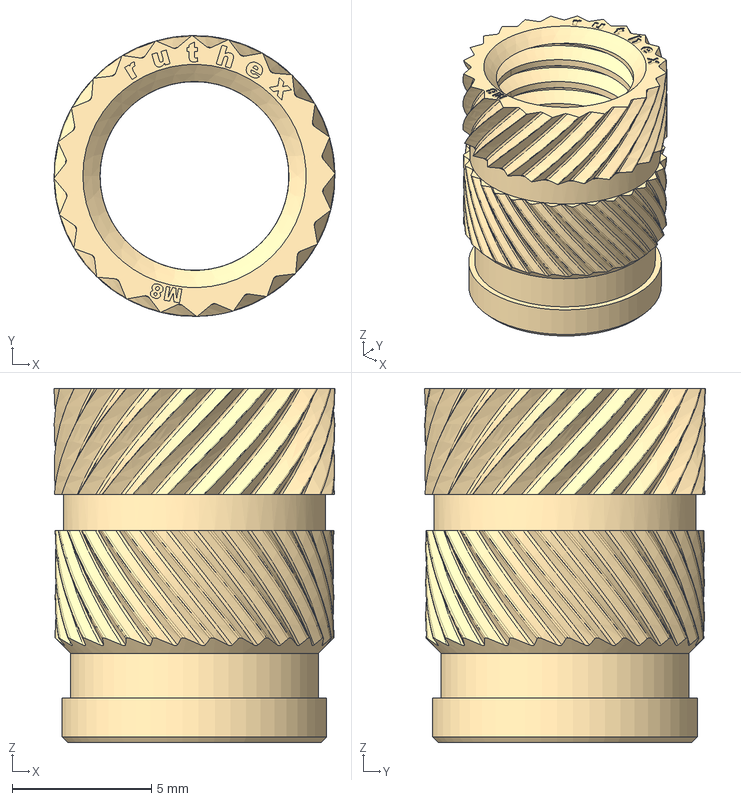
[picture p180: CAD file, 2021-10-26]
Chassis/Mounting/ruthex+Step-Data+threaded+inserts+M2-M8/files/RX-M8x12.7.step
10.1 x 10.1 x 12.7 mm
