unlegitGurke/RC-Car/Drafts/Aufhängung/Abdeckplatte_Hinten2.dxf

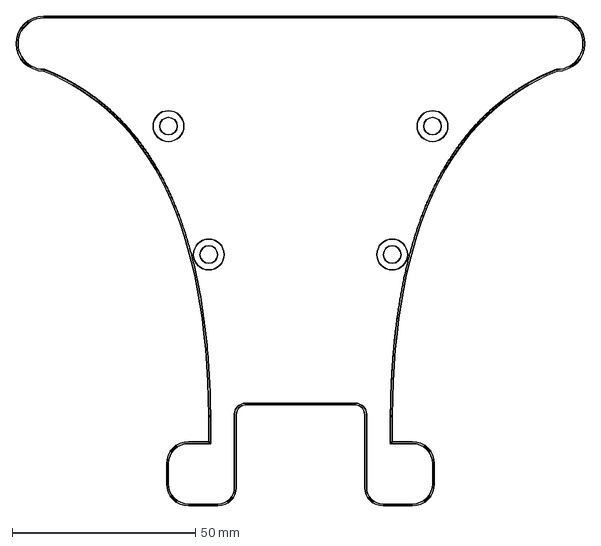
[picture p181: CAD file, 2021-06-23]
Drafts/Aufhängung/Abdeckplatte_Hinten2.dxf
155.0 x 133.5 mm
