unlegitGurke/RC-Car/Drafts/Chassis/Grundplatte_V4.0.3mf

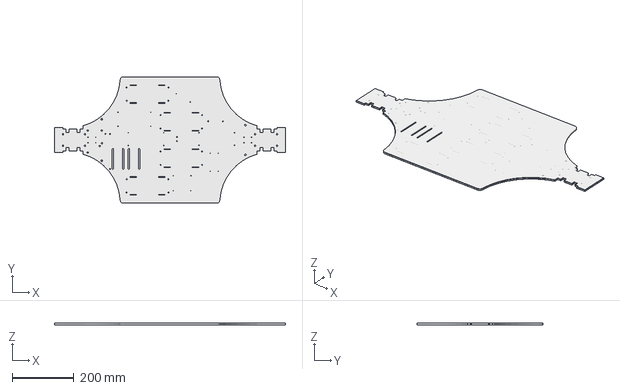
[picture p182: CAD file, 2021-06-23]
Drafts/Chassis/Grundplatte_V4.0.3mf
750.0 x 410.0 x 5.00 mm
