unlegitGurke/RC-Car/Electronics/12mm_push_button/12mm_push_button.step

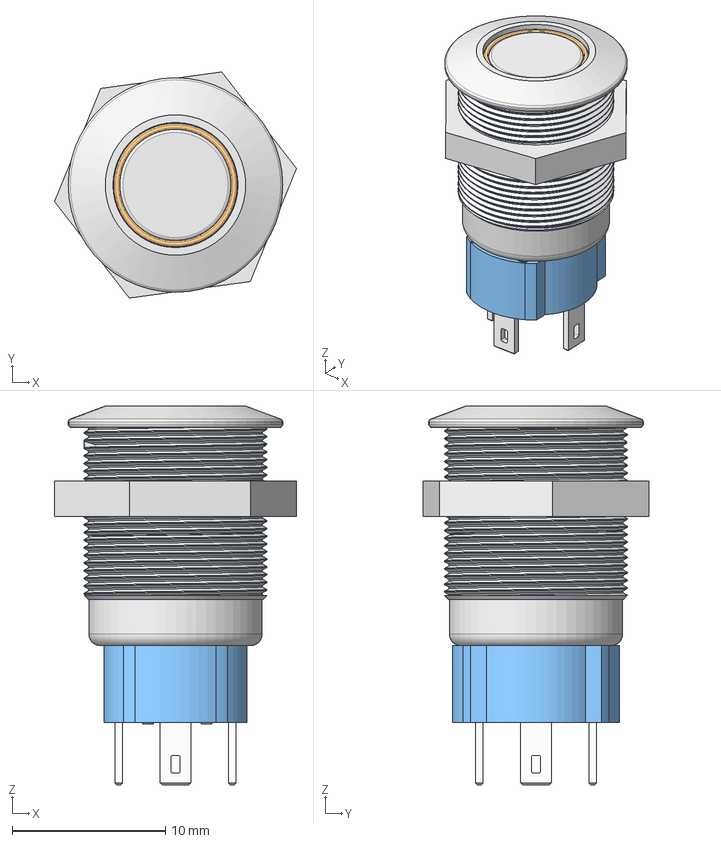
[picture p183: CAD file, 2022-01-05]
Electronics/12mm_push_button/12mm_push_button.step
15.8 x 14.8 x 24.7 mm
button
Nut
solderlug x 4
