unlegitGurke/RC-Car/Electronics/3-pin-fan-connector/fan header 2.54 3pin.STEP

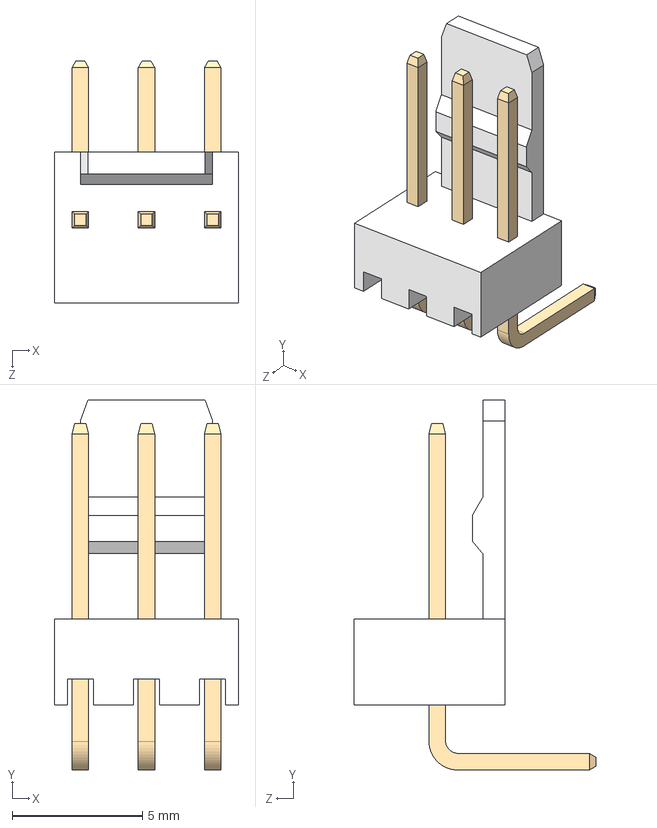
[picture p184: CAD file, 2021-12-29]
Electronics/3-pin-fan-connector/fan header 2.54 3pin.STEP
7.08 x 14.2 x 9.30 mm
