unlegitGurke/RC-Car/Electronics/4-pin-pwm-connector-1.snapshot.1/PWM-Crimp.SLDPRT

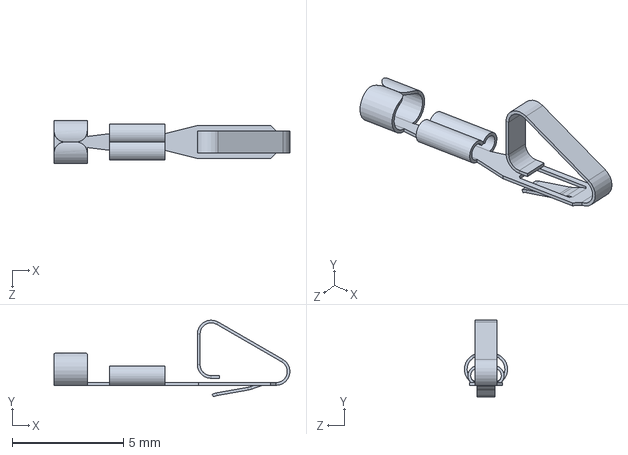
[picture p185: CAD file, 2021-12-27]
Electronics/4-pin-pwm-connector-1.snapshot.1/PWM-Crimp.SLDPRT
10.6 x 3.46 x 1.95 mm
