unlegitGurke/RC-Car/Electronics/4pin-magnetic-pogo-connector-plug-female-1.snapshot.2/Pogo_$pin_Female.step

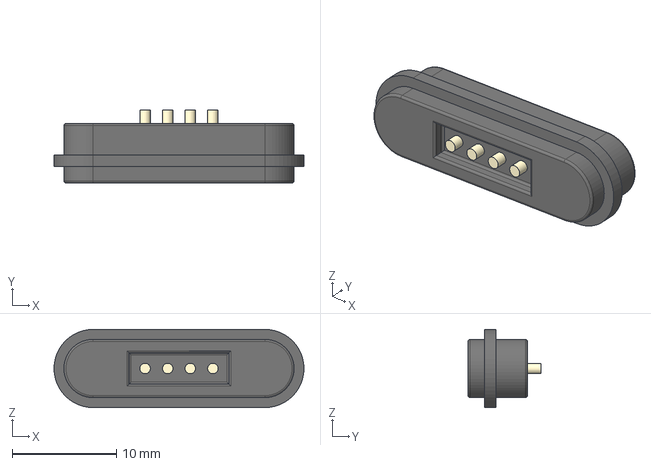
[picture p186: CAD file, 2021-10-27]
Electronics/4pin-magnetic-pogo-connector-plug-female-1.snapshot.2/Pogo_$pin_Female.step
24.0 x 7.00 x 7.50 mm
