unlegitGurke/RC-Car/Electronics/Akku/92mm-case-fan-1.snapshot.2/F9.STEP

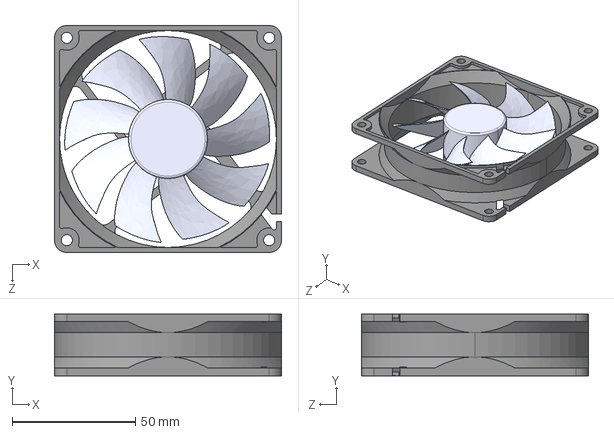
[picture p187: CAD file, 2022-01-26]
Electronics/Akku/92mm-case-fan-1.snapshot.2/F9.STEP
92.0 x 25.0 x 92.0 mm
F9 body
F9 fan
