unlegitGurke/RC-Car/Electronics/Akku/nf-a6x25-noctua-fan-60mm-1.snapshot.3/NF A6x25.step

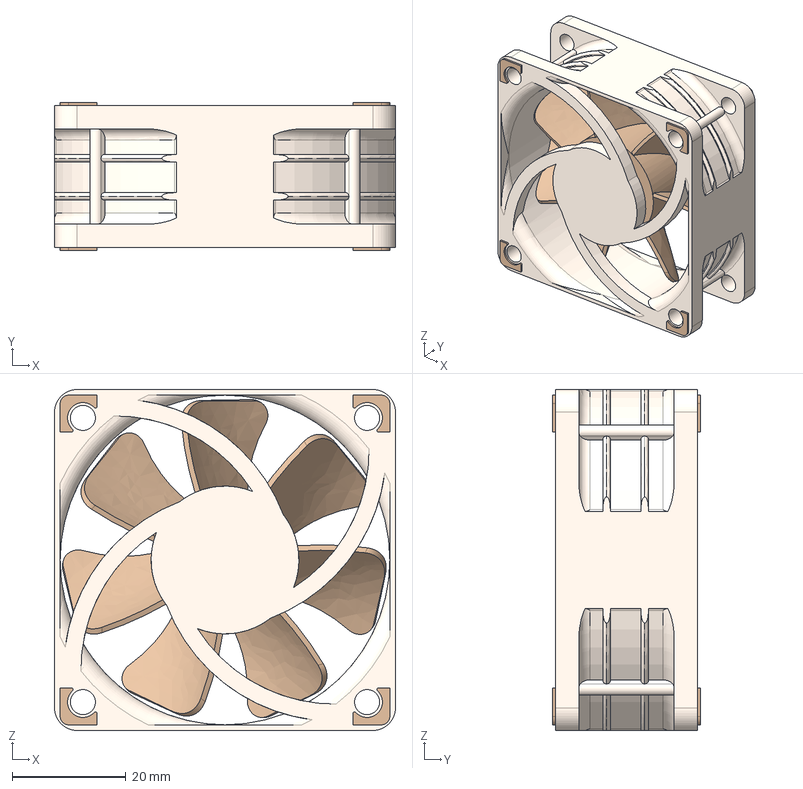
[picture p188: CAD file, 2022-01-26]
Electronics/Akku/nf-a6x25-noctua-fan-60mm-1.snapshot.3/NF A6x25.step
60.0 x 26.0 x 60.0 mm
