unlegitGurke/RC-Car/Electronics/Akku/Zelle/Sony US21700VTC6A.STEP

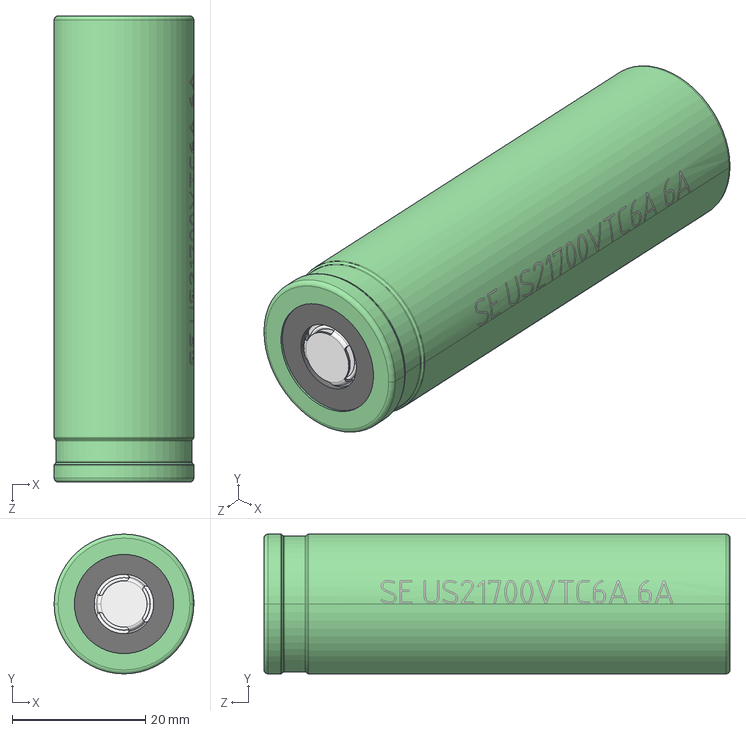
[picture p189: CAD file, 2022-01-23]
Electronics/Akku/Zelle/Sony US21700VTC6A.STEP
21.0 x 21.0 x 70.0 mm
