unlegitGurke/RC-Car/Electronics/Buck Converter/dc-dc-buck-converter-step-down-15-90vdc-in-out-12vdc-20a-1.snapshot.1/FULREE DC-DC CONVERTER 15-90V IN 12V 20A OUT.STEP

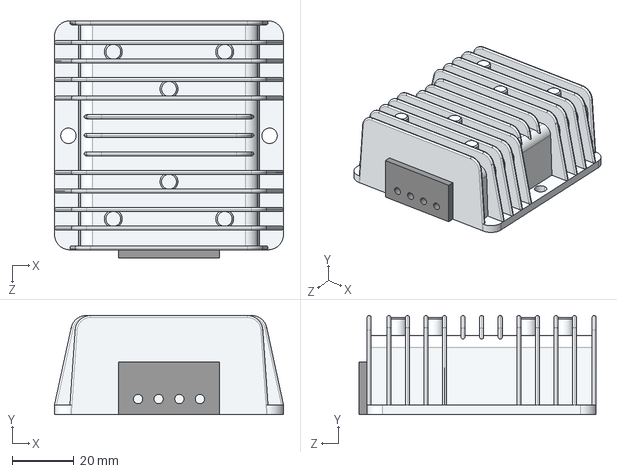
[picture p190: CAD file, 2022-09-18]
Electronics/Buck Converter/dc-dc-buck-converter-step-down-15-90vdc-in-out-12vdc-20a-1.snapshot.1/FULREE DC-DC CONVERTER 15-90V IN 12V 20A OUT.STEP
74.0 x 32.0 x 76.7 mm
