unlegitGurke/RC-Car/Electronics/Buck Converter/dc-dc-step-down-buck-converter-cc-cv-300w-20a-1.snapshot.2/DC-DC Step Down Buck Converter CC-CV 300W 20A.step

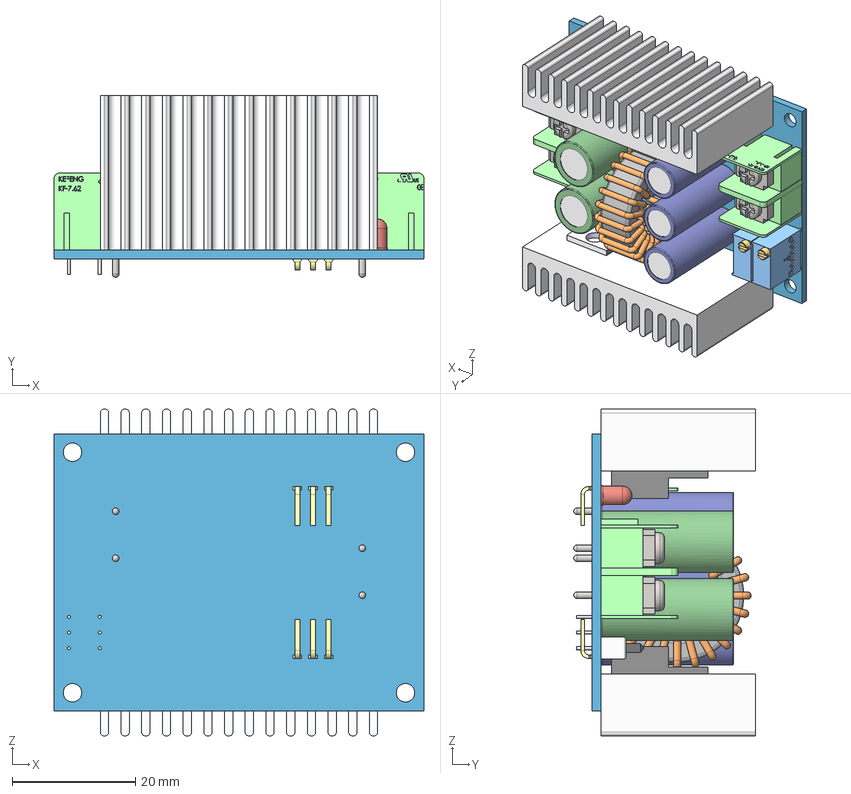
[picture p191: CAD file, 2022-09-18]
Electronics/Buck Converter/dc-dc-step-down-buck-converter-cc-cv-300w-20a-1.snapshot.2/DC-DC Step Down Buck Converter CC-CV 300W 20A.step
60.0 x 29.5 x 53.0 mm
heatsink x 2
pcb board
Base x 2
Arandela x 4
Tornillo x 4
Terminal x 4
potentiometer x 2
elco-a x 2
elco-b x 3
transistor x 2
led
switch
