unlegitGurke/RC-Car/Electronics/ESC/Maytech VESC6 200a.stp

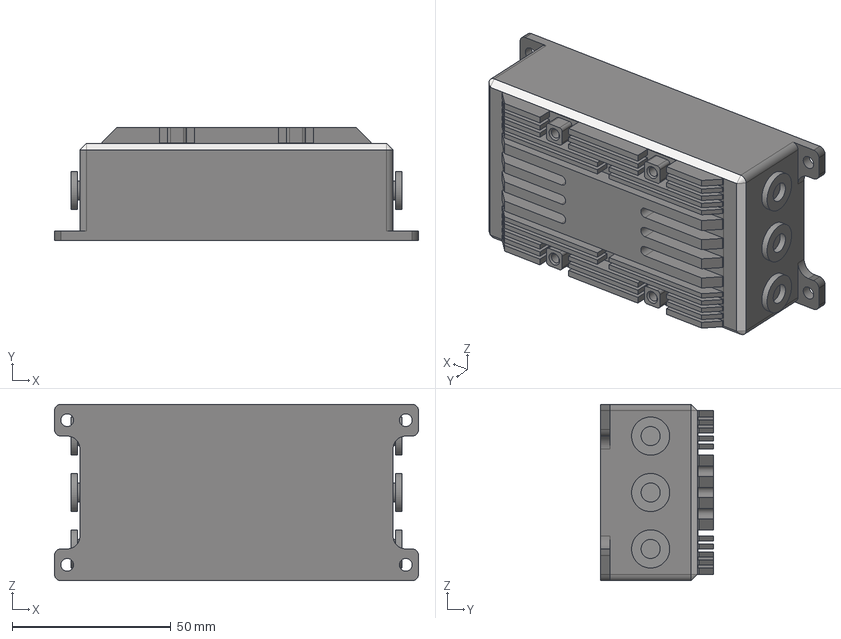
[picture p192: CAD file, 2021-06-20]
Electronics/ESC/Maytech VESC6 200a.stp
114.5 x 35.5 x 55.5 mm
