unlegitGurke/RC-Car/Electronics/jst-xh-2-54mm-generic-connector-set-1.snapshot.31/SMD Horizontal/JST - XH - SMD (R) - 9Pin - 2.54mm.stp

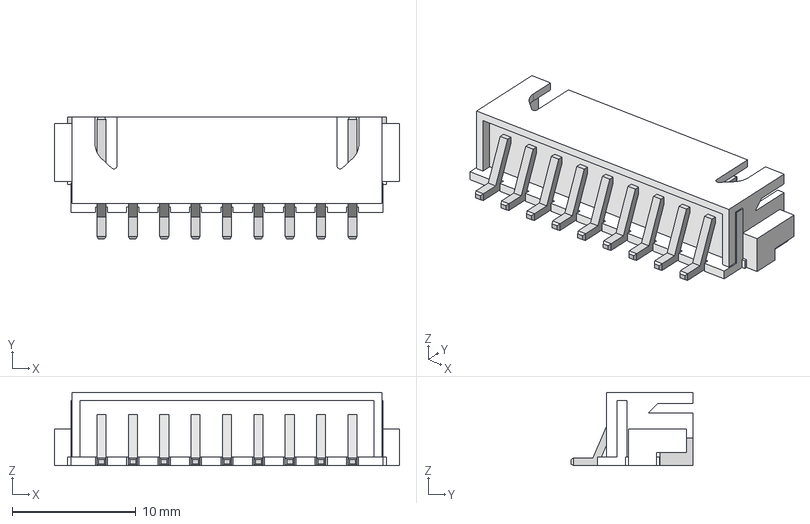
[picture p195: CAD file, 2022-01-05]
Electronics/jst-xh-2-54mm-generic-connector-set-1.snapshot.31/SMD Horizontal/JST - XH - SMD (R) - 9Pin - 2.54mm.stp
27.9 x 9.91 x 5.92 mm
