unlegitGurke/RC-Car/Electronics/jst-xh-2-54mm-generic-connector-set-1.snapshot.31/Thru Horizontal/JST - XH - Thru (R) - 7Pin - 2.54mm.stp

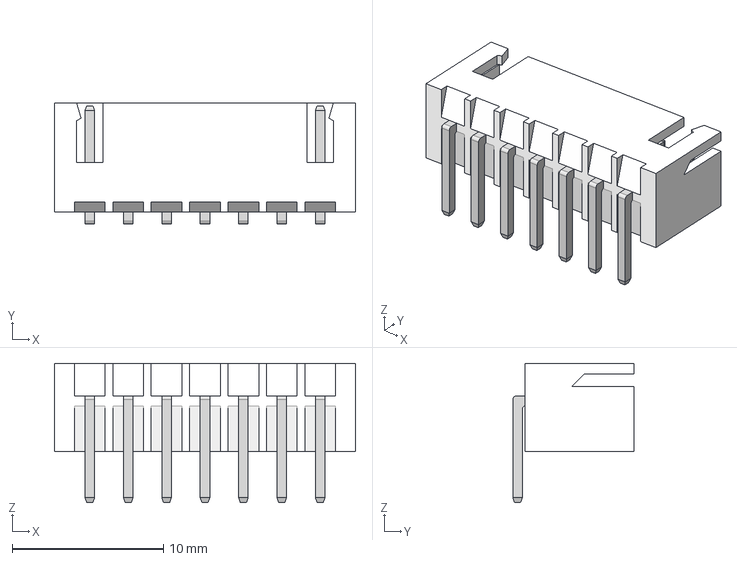
[picture p196: CAD file, 2022-01-05]
Electronics/jst-xh-2-54mm-generic-connector-set-1.snapshot.31/Thru Horizontal/JST - XH - Thru (R) - 7Pin - 2.54mm.stp
19.9 x 8.04 x 9.22 mm
