unlegitGurke/RC-Car/Electronics/LattePanda_3_Delta/LatteCase/top.stp

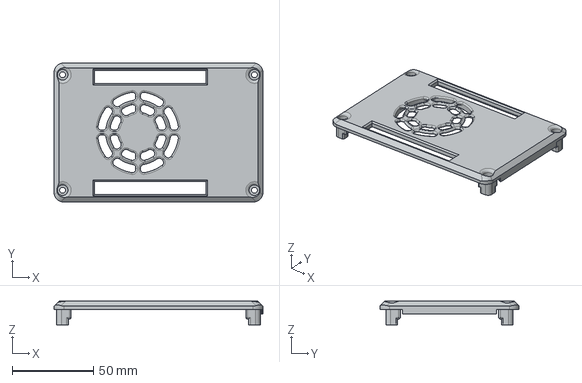
[picture p198: CAD file, 2022-12-28]
Electronics/LattePanda_3_Delta/LatteCase/top.stp
128.6 x 85.6 x 14.6 mm
