unlegitGurke/RC-Car/Electronics/LED/WS2812B Black 60leds_m v7.step

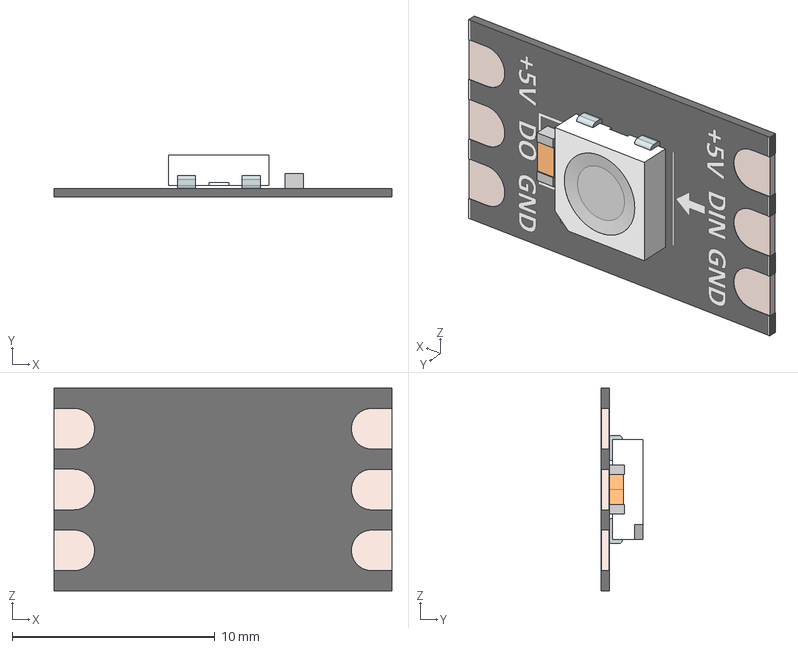
[picture p199: CAD file, 2021-04-20]
Electronics/LED/WS2812B Black 60leds_m v7.step
16.7 x 2.05 x 10.0 mm
