unlegitGurke/RC-Car/Electronics/LiDAR/lidar mount alt gopro adapter/Part3.3mf

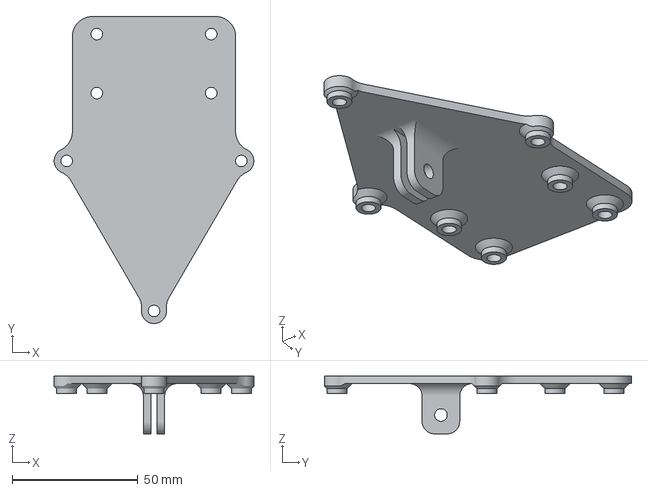
[picture p200: CAD file, 2024-04-25]
Electronics/LiDAR/lidar mount alt gopro adapter/Part3.3mf
79.5 x 122.2 x 23.0 mm
