unlegitGurke/RC-Car/Electronics/LiDAR/YDLidar G2.step

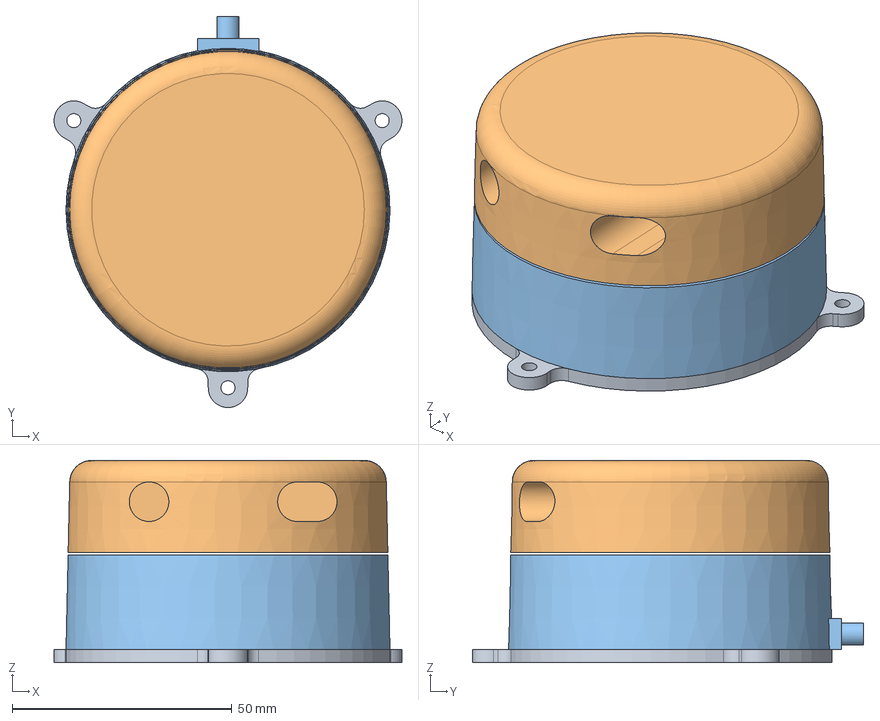
[picture p201: CAD file, 2023-11-16]
Electronics/LiDAR/YDLidar G2.step
79.1 x 88.9 x 46.0 mm
Mounting Plate
Scanner
Base (1)
