unlegitGurke/RC-Car/Electronics/micro-usb-b-female-5pin-smd-1.snapshot.2/Micro USB-B Female 5Pin SMD.STEP

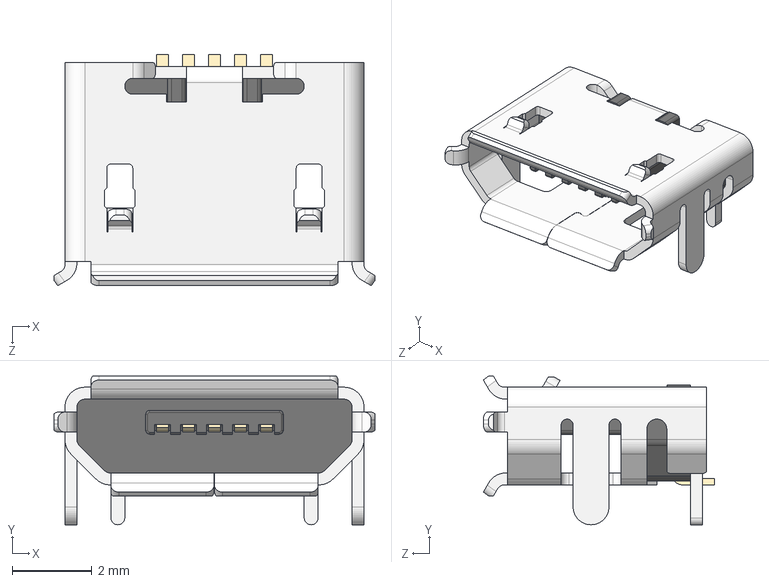
[picture p202: CAD file, 2022-01-05]
Electronics/micro-usb-b-female-5pin-smd-1.snapshot.2/Micro USB-B Female 5Pin SMD.STEP
8.05 x 3.73 x 5.80 mm
