unlegitGurke/RC-Car/Electronics/Motor_2028/Castle Neu 2028 Motor.STEP

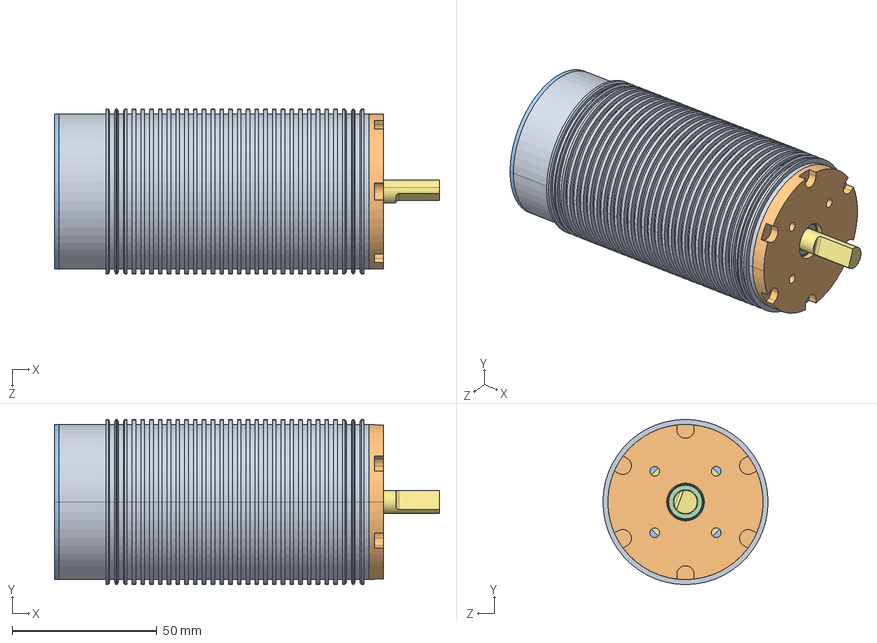
[picture p203: CAD file, 2021-06-20]
Electronics/Motor_2028/Castle Neu 2028 Motor.STEP
132.9 x 57.0 x 57.0 mm
Castle Neu 2028 Can
Castle Neu 2028 Front Plate
Castle Neu 2028 End Cap
Inner Race 8x16x5mm x 2
Outer Race 8x16x5mm x 2
2mm ball x 24
Castle Neu 2028 Rotor
