unlegitGurke/RC-Car/Electronics/Raspberry pi 3 cam V2,1/Cam V2.1 v1.step

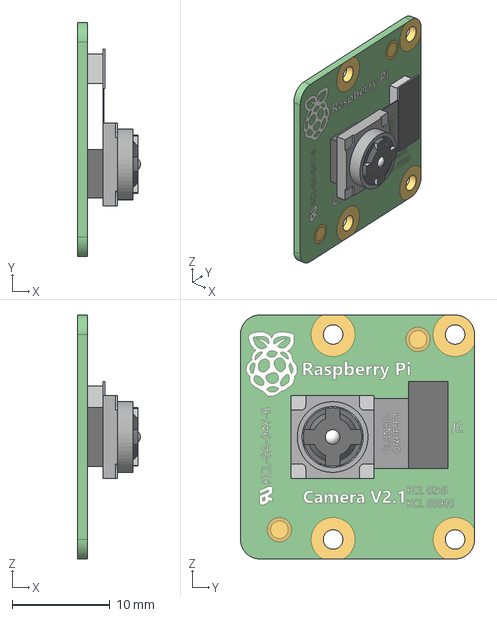
[picture p204: CAD file, 2021-12-10]
Electronics/Raspberry pi 3 cam V2,1/Cam V2.1 v1.step
6.45 x 24.0 x 25.0 mm
