unlegitGurke/RC-Car/Electronics/RaspberryPI_Shield/Connector Pi/models3d/PBD/PBD-42.step

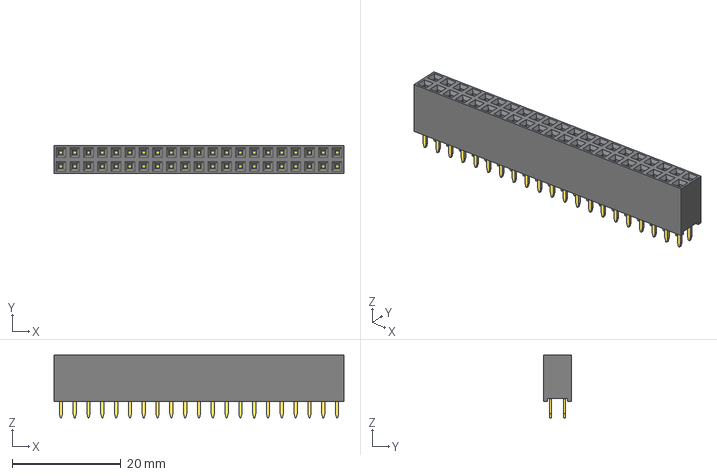
[picture p205: CAD file, 2021-04-19]
Electronics/RaspberryPI_Shield/Connector Pi/models3d/PBD/PBD-42.step
53.3 x 5.08 x 11.5 mm
