unlegitGurke/RC-Car/Electronics/RaspberryPI_Shield/Connector Pi/models3d/PBS/PBS-14R.step

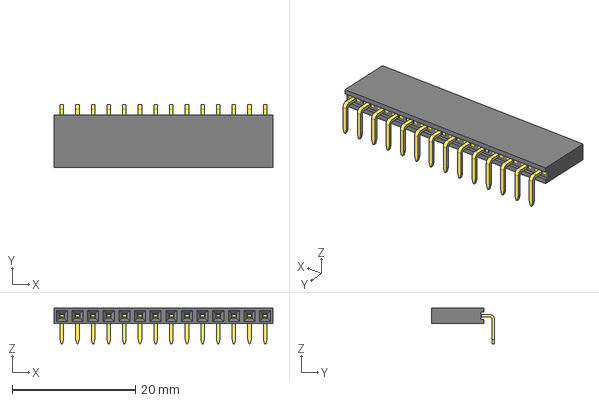
[picture p206: CAD file, 2021-04-19]
Electronics/RaspberryPI_Shield/Connector Pi/models3d/PBS/PBS-14R.step
35.6 x 10.2 x 5.84 mm
