unlegitGurke/RC-Car/Electronics/RaspberryPI_Shield/Connector Pi/xhp-3.stl

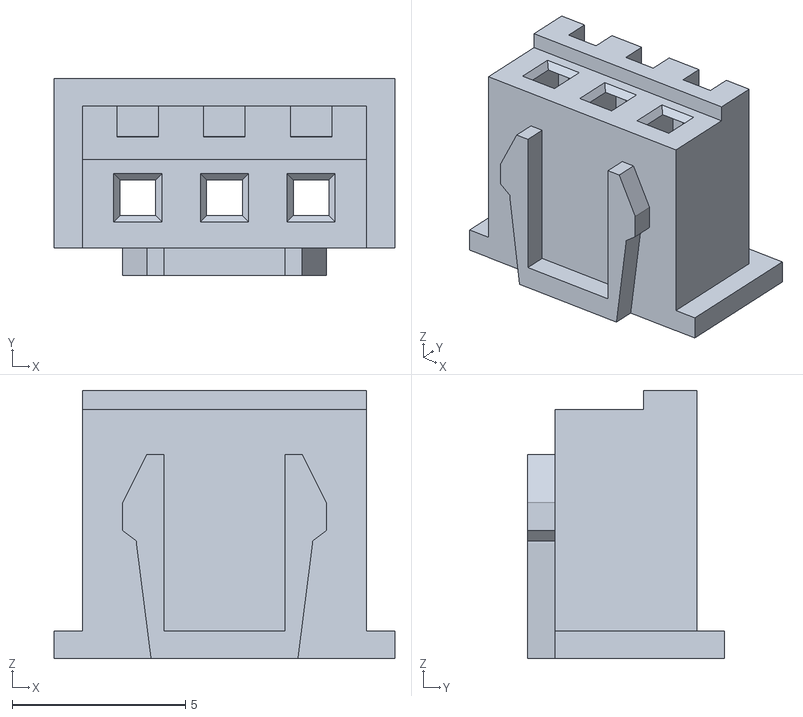
[picture p207: CAD file, 2021-04-19]
Electronics/RaspberryPI_Shield/Connector Pi/xhp-3.stl
9.85 x 5.70 x 7.75
