unlegitGurke/RC-Car/Electronics/RaspberryPI_Shield/NEW_Shield/fan-header-4pin-2-54mm-1.snapshot.6/Fan Header/Fan Header 4Pin-Body.SLDPRT

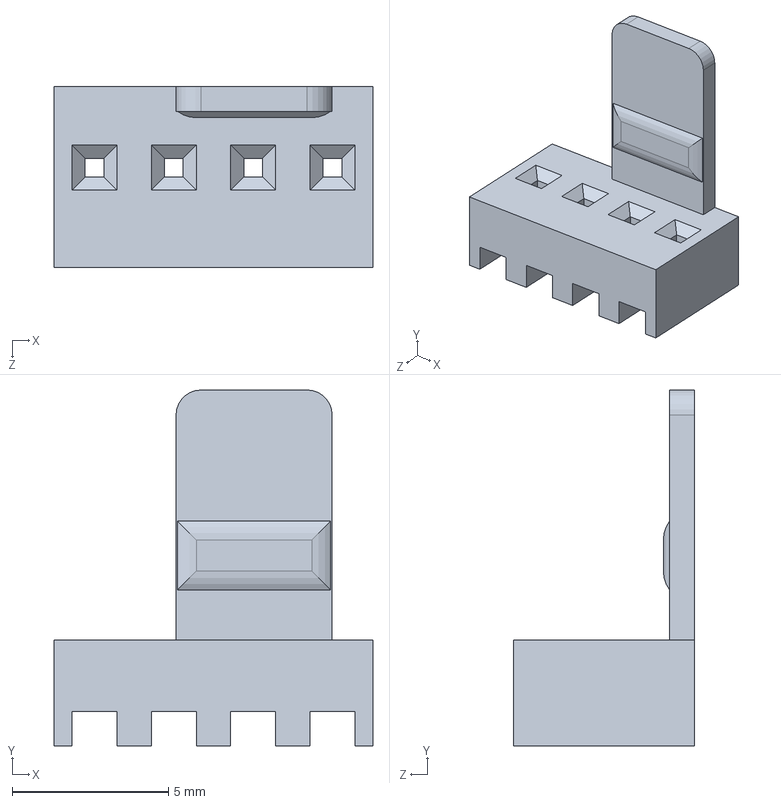
[picture p208: CAD file, 2021-12-27]
Electronics/RaspberryPI_Shield/NEW_Shield/fan-header-4pin-2-54mm-1.snapshot.6/Fan Header/Fan Header 4Pin-Body.SLDPRT
10.2 x 11.4 x 5.80 mm
