unlegitGurke/RC-Car/Electronics/RaspberryPI_Shield/NEW_Shield/molex-2-54-mm-6-pines-1.snapshot.1/Molex-2.54-6pin.STEP

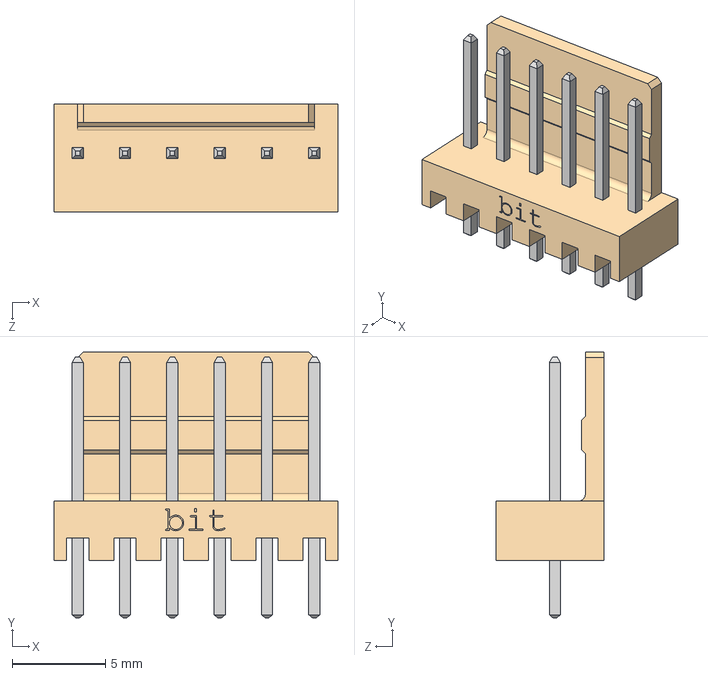
[picture p209: CAD file, 2021-12-27]
Electronics/RaspberryPI_Shield/NEW_Shield/molex-2-54-mm-6-pines-1.snapshot.1/Molex-2.54-6pin.STEP
15.2 x 14.3 x 5.80 mm
Pieza6
pin x 6
