unlegitGurke/RC-Car/Electronics/RaspberryPI_Shield/NEW_Shield/molex-5-2-54-mm-1.snapshot.1/Molex-2.54-5pin.STEP

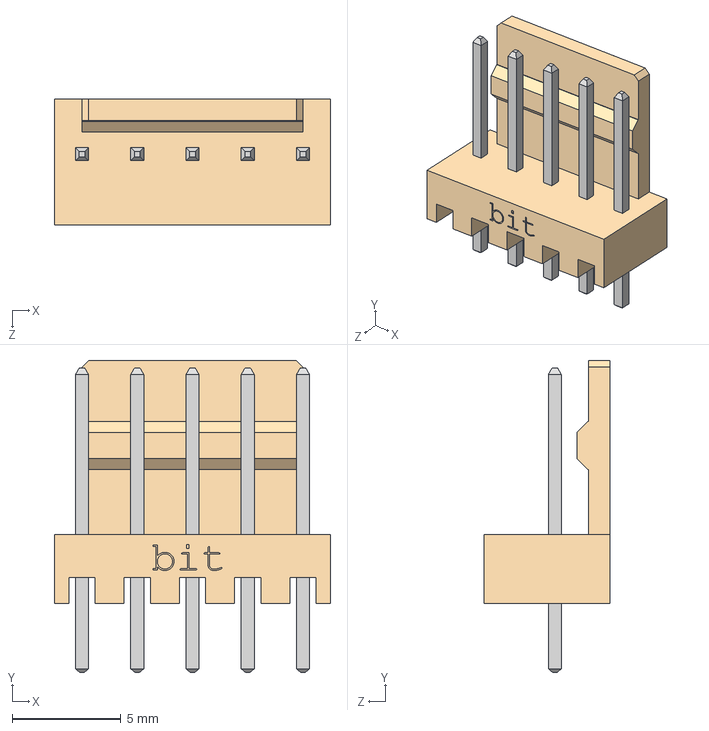
[picture p210: CAD file, 2021-12-27]
Electronics/RaspberryPI_Shield/NEW_Shield/molex-5-2-54-mm-1.snapshot.1/Molex-2.54-5pin.STEP
12.7 x 14.3 x 5.80 mm
molex_5
pin x 5
