unlegitGurke/RC-Car/Electronics/Ultrasonic Sensor/jsn-sr04t-2-0-ultrasonic-sensor-1.snapshot.1/JSN20.stp

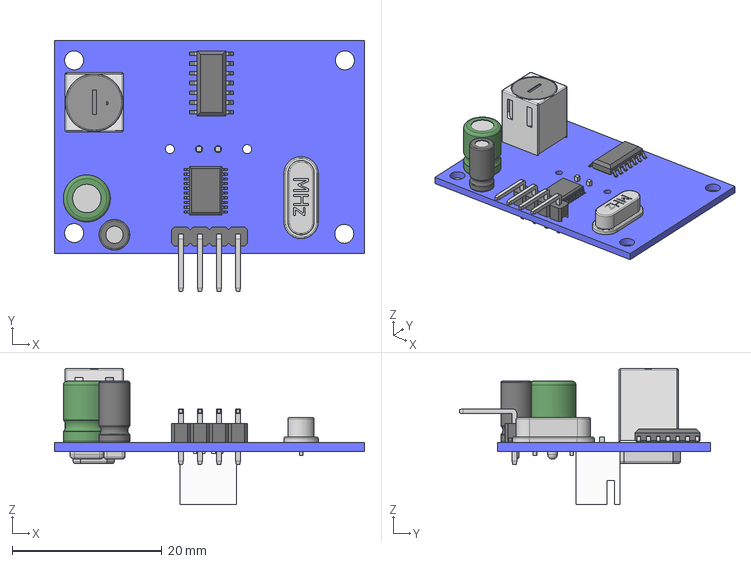
[picture p212: CAD file, 2021-12-17]
Electronics/Ultrasonic Sensor/jsn-sr04t-2-0-ultrasonic-sensor-1.snapshot.1/JSN20.stp
41.4 x 33.5 x 18.1 mm
