unlegitGurke/RC-Car/Electronics/Ultrasonic Sensor/jst-xhp-2-housing-1.snapshot.1/JST XHP-2 Housing.step

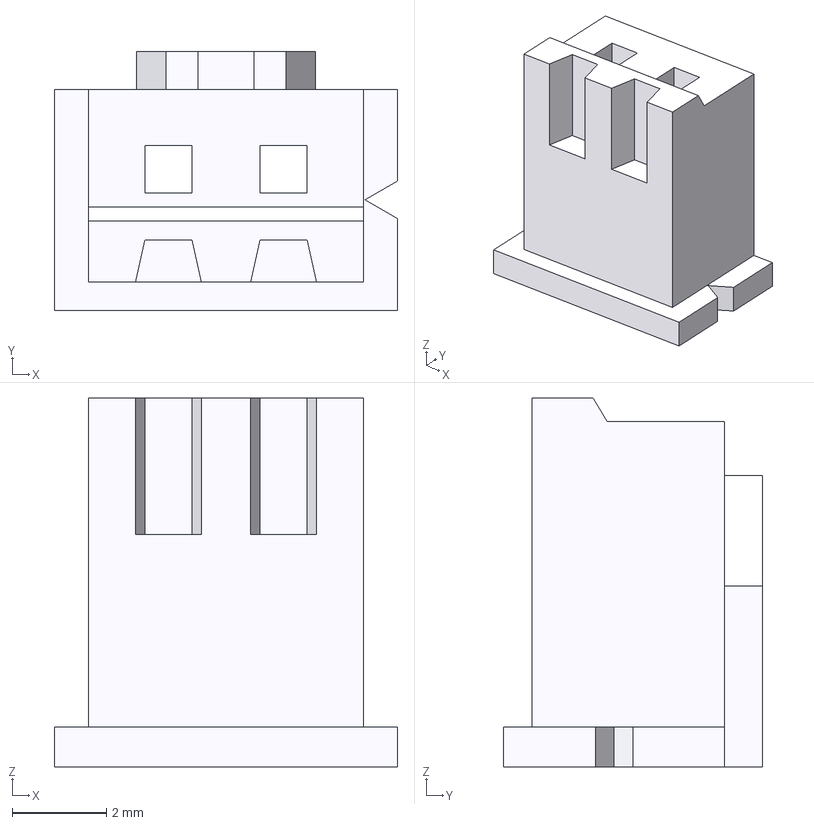
[picture p213: CAD file, 2021-12-16]
Electronics/Ultrasonic Sensor/jst-xhp-2-housing-1.snapshot.1/JST XHP-2 Housing.step
7.30 x 5.50 x 7.85 mm
