unlegitGurke/RC-Car/Electronics/Ultrasonic Sensor/Sensorcase.stp

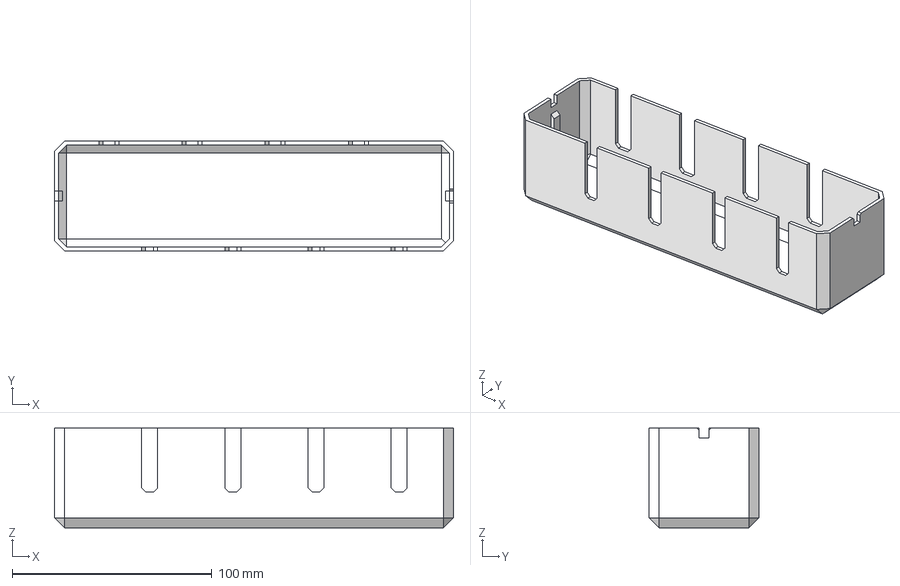
[picture p214: CAD file, 2024-03-10]
Electronics/Ultrasonic Sensor/Sensorcase.stp
200.0 x 55.0 x 50.0 mm
