unlegitGurke/RC-Car/Electronics/USB/Mini USB/USB Mini Male.STEP

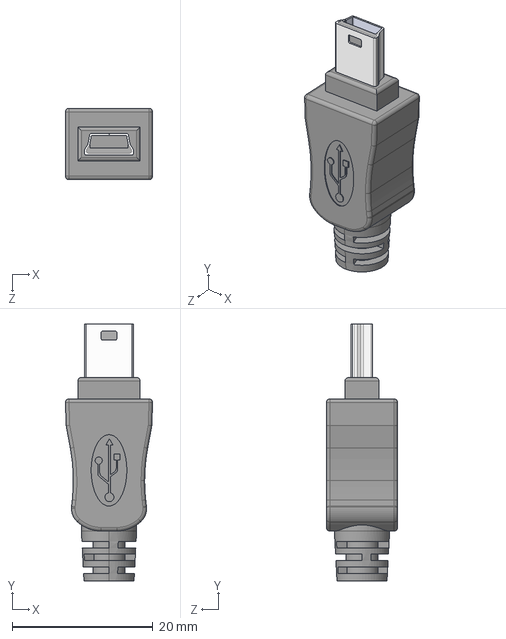
[picture p215: CAD file, 2021-04-19]
Electronics/USB/Mini USB/USB Mini Male.STEP
12.4 x 36.6 x 10.2 mm
