unlegitGurke/RC-Car/Electronics/USB/USB Connector.stp

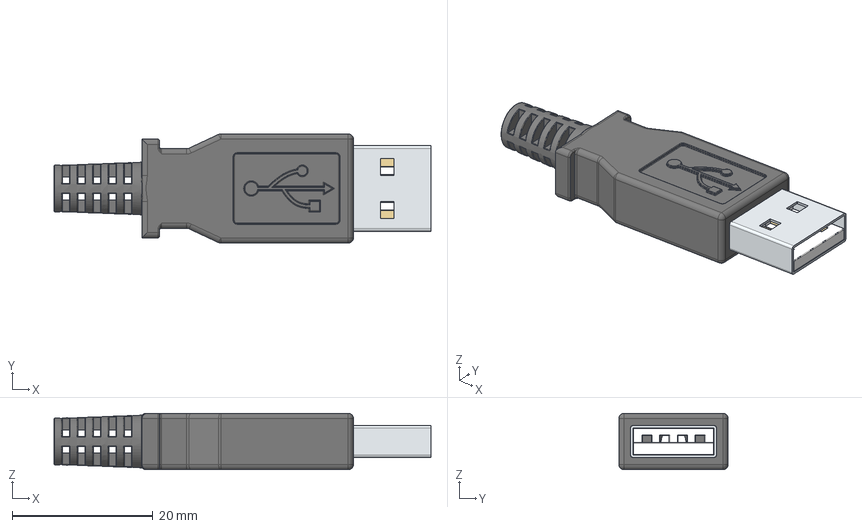
[picture p216: CAD file, 2021-04-19]
Electronics/USB/USB Connector.stp
53.5 x 15.5 x 8.00 mm
Main Body
Engagement
Suport Contacts
Contacts x 2
Contacts_1 x 2
