unlegitGurke/RC-Car/Exportierte Dateien/Aufhängung/3-teilige-Felge/Felgen Horn.3mf

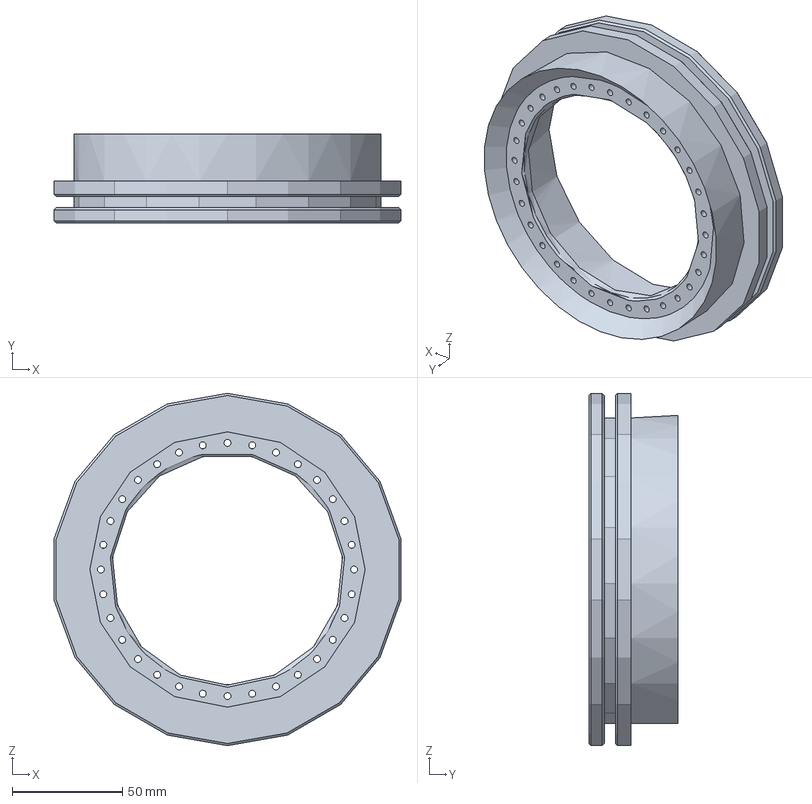
[picture p217: CAD file, 2021-10-25]
Exportierte Dateien/Aufhängung/3-teilige-Felge/Felgen Horn.3mf
157.6 x 40.5 x 160.0 mm
