unlegitGurke/RC-Car/Exportierte Dateien/Aufhängung/Feder_Spacer.stp

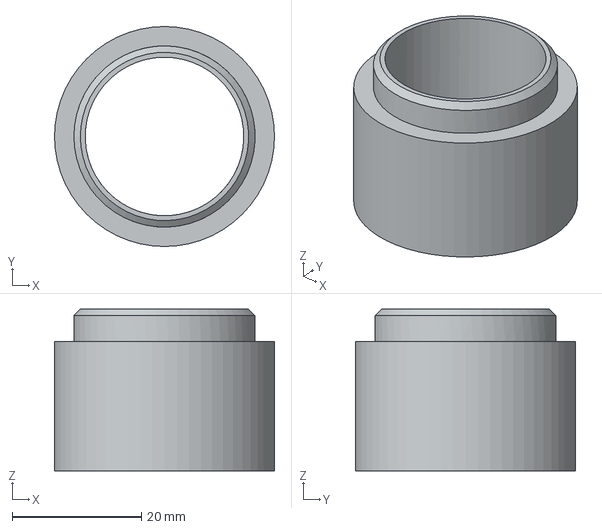
[picture p218: CAD file, 2024-03-08]
Exportierte Dateien/Aufhängung/Feder_Spacer.stp
34.0 x 34.0 x 25.0 mm
