unlegitGurke/RC-Car/Exportierte Dateien/Body/Body 3d print/Body_rearend_right_print.stp

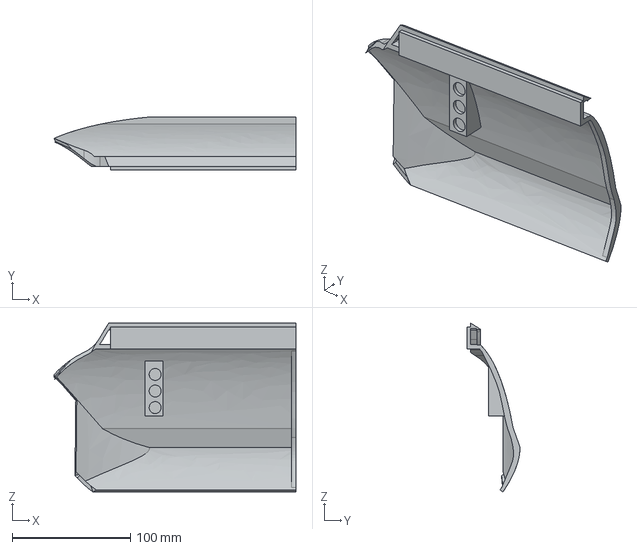
[picture p219: CAD file, 2024-03-08]
Exportierte Dateien/Body/Body 3d print/Body_rearend_right_print.stp
204.5 x 44.7 x 142.7 mm
