unlegitGurke/RC-Car/Exportierte Dateien/Body/Body_Bambulab/Body_front_mount.stp

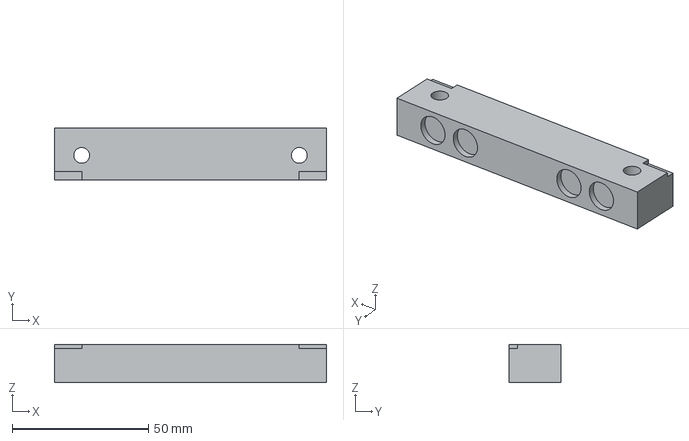
[picture p220: CAD file, 2024-05-14]
Exportierte Dateien/Body/Body_Bambulab/Body_front_mount.stp
100.0 x 19.0 x 14.0 mm
