unlegitGurke/RC-Car/Exportierte Dateien/Body/Bodymount_hinten_print/Bodymount_hinten_2.stp

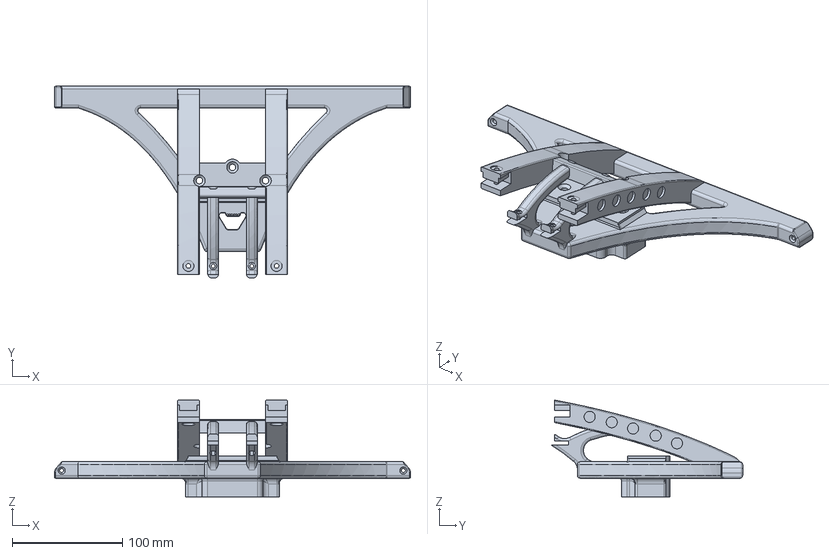
[picture p221: CAD file, 2024-05-13]
Exportierte Dateien/Body/Bodymount_hinten_print/Bodymount_hinten_2.stp
323.0 x 173.8 x 87.8 mm
