unlegitGurke/RC-Car/Exportierte Dateien/Body/Bodymount_hinten_print/Bodymount_hinten_adapter/Adapter_1_2.stp

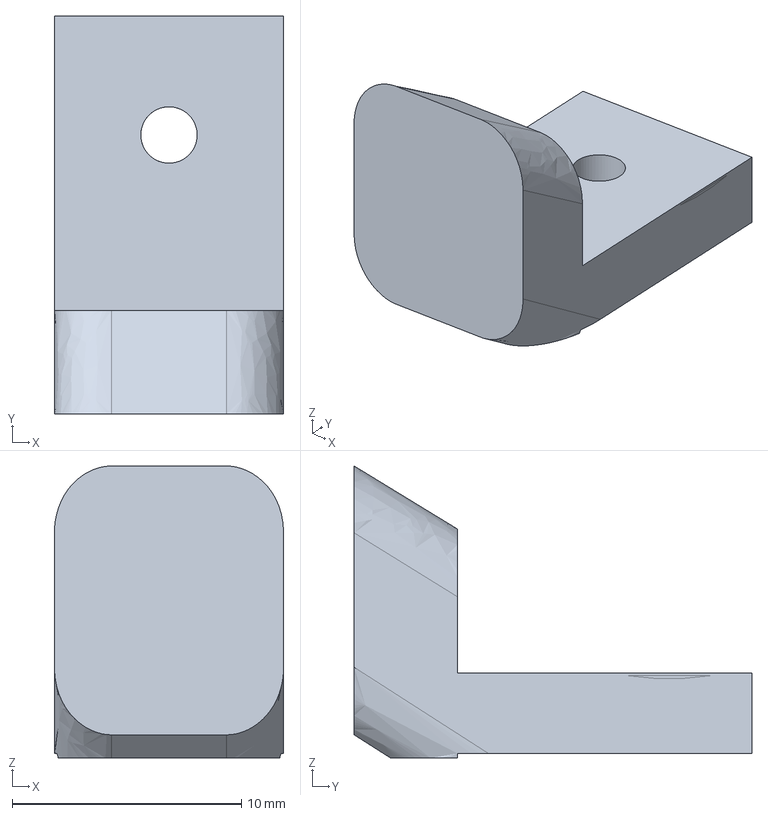
[picture p222: CAD file, 2024-02-23]
Exportierte Dateien/Body/Bodymount_hinten_print/Bodymount_hinten_adapter/Adapter_1_2.stp
10.0 x 17.3 x 12.7 mm
