unlegitGurke/RC-Car/Exportierte Dateien/Body/Heck_Glasscheibe.stp

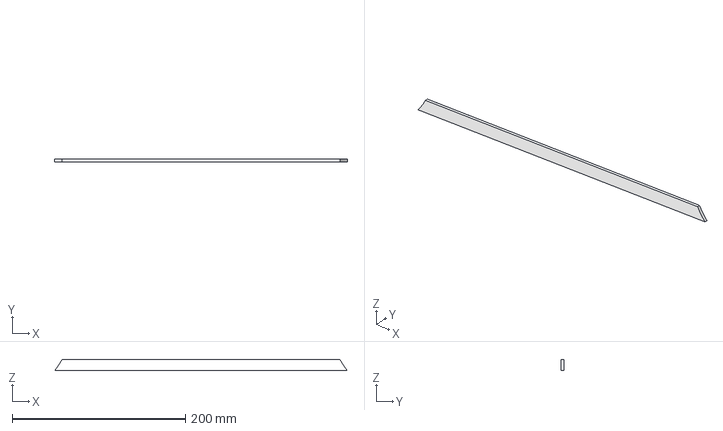
[picture p223: CAD file, 2024-05-13]
Exportierte Dateien/Body/Heck_Glasscheibe.stp
338.6 x 3.00 x 13.2 mm
