unlegitGurke/RC-Car/Exportierte Dateien/Body/Kotflügel/Extreme_Kotflügel_richtig_ausschnitt.stp

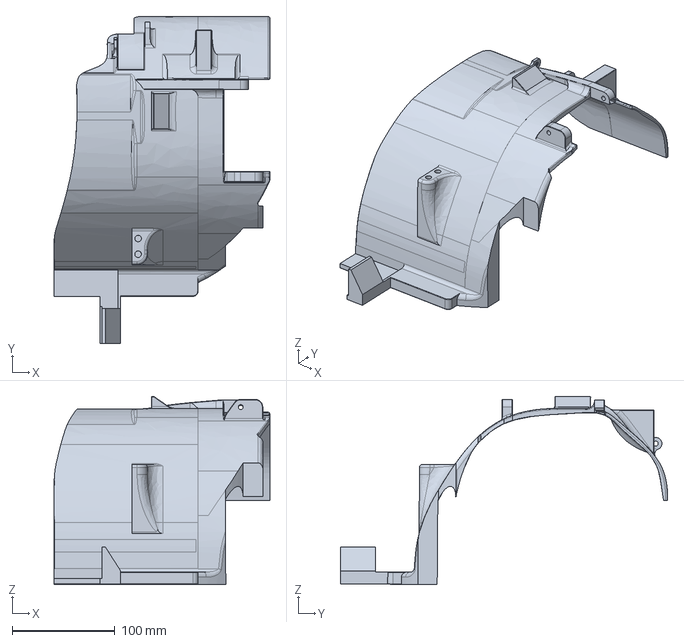
[picture p224: CAD file, 2024-05-13]
Exportierte Dateien/Body/Kotflügel/Extreme_Kotflügel_richtig_ausschnitt.stp
210.5 x 319.1 x 183.5 mm
