unlegitGurke/RC-Car/Exportierte Dateien/Body/SensorMount/Sensor mount seitlichlinks_mir2.3mf

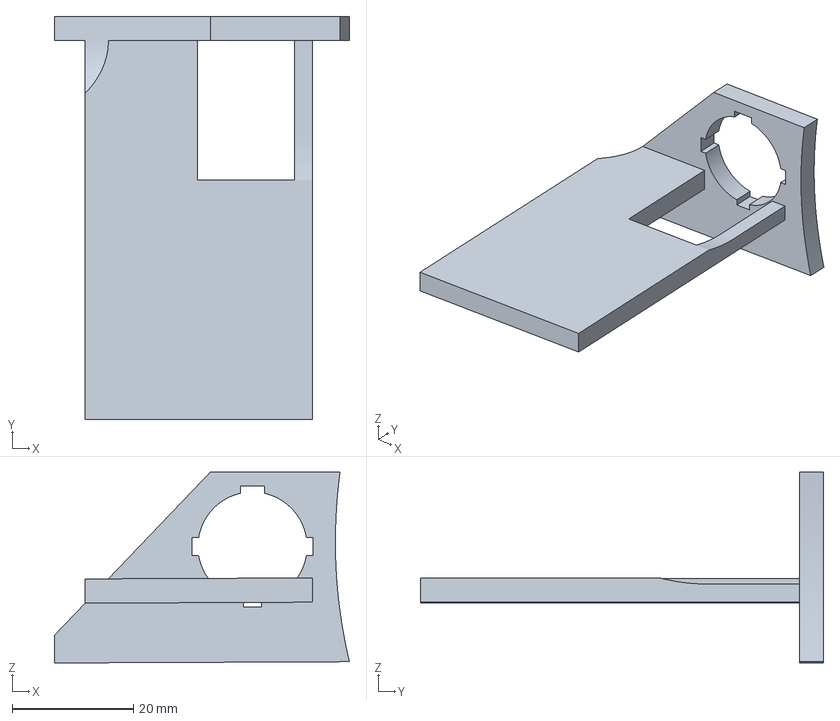
[picture p225: CAD file, 2023-01-08]
Exportierte Dateien/Body/SensorMount/Sensor mount seitlichlinks_mir2.3mf
48.7 x 66.5 x 31.5 mm
