unlegitGurke/RC-Car/Exportierte Dateien/Buck Converter/Fanmount_Buck_Converter.3mf

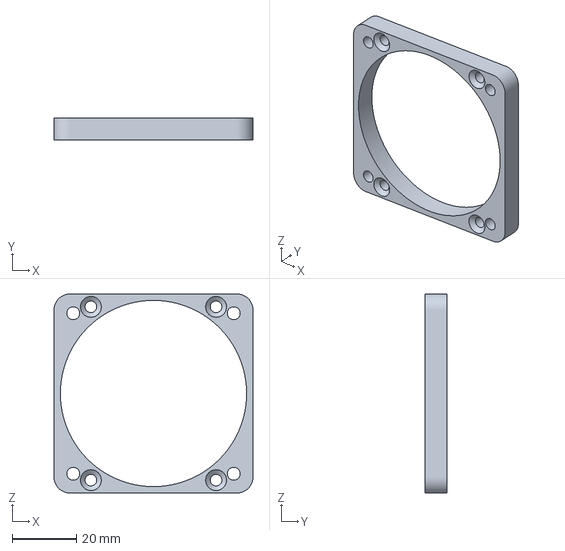
[picture p226: CAD file, 2022-12-10]
Exportierte Dateien/Buck Converter/Fanmount_Buck_Converter.3mf
62.0 x 7.00 x 62.0 mm
