unlegitGurke/RC-Car/Exportierte Dateien/Chassis/Grundplatte_V5.0_Laser.dxf

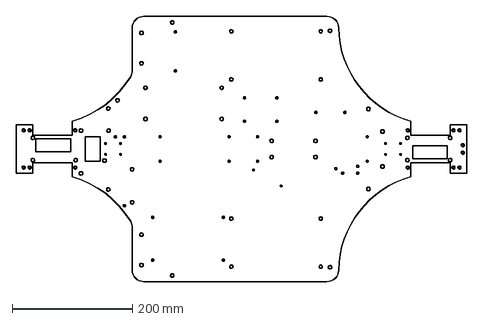
[picture p227: CAD file, 2023-11-05]
Exportierte Dateien/Chassis/Grundplatte_V5.0_Laser.dxf
750.0 x 442.0 mm
