unlegitGurke/RC-Car/Exportierte Dateien/Chassis/Mounting/Button_IMU_Mount_1.stp

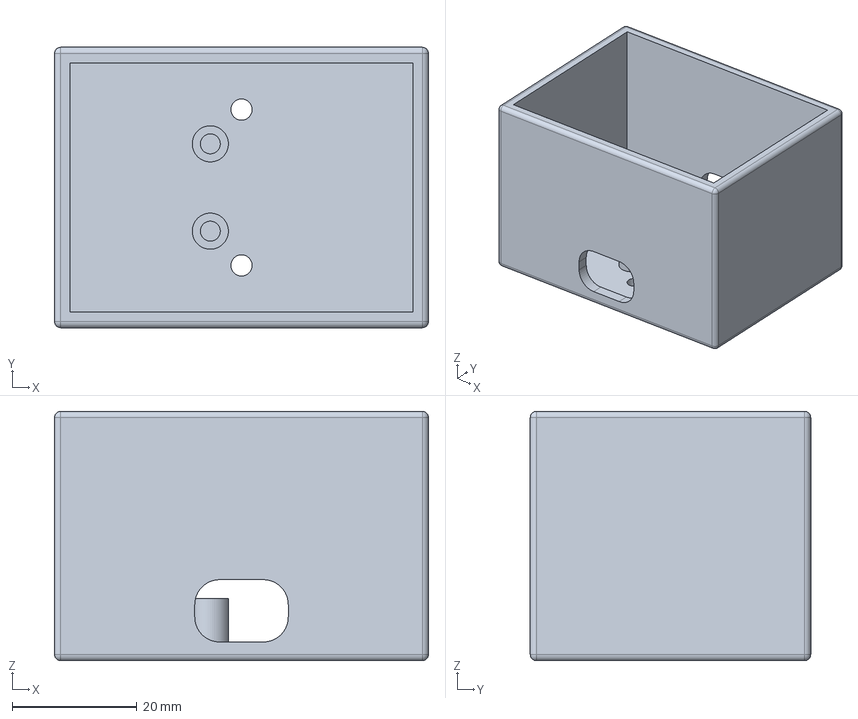
[picture p228: CAD file, 2024-05-13]
Exportierte Dateien/Chassis/Mounting/Button_IMU_Mount_1.stp
60.0 x 45.0 x 40.0 mm
