unlegitGurke/RC-Car/Exportierte Dateien/Chassis/Mounting/Getriebe_Mount_V3/GetriebeMount_Vorne_Oben_mir.3mf

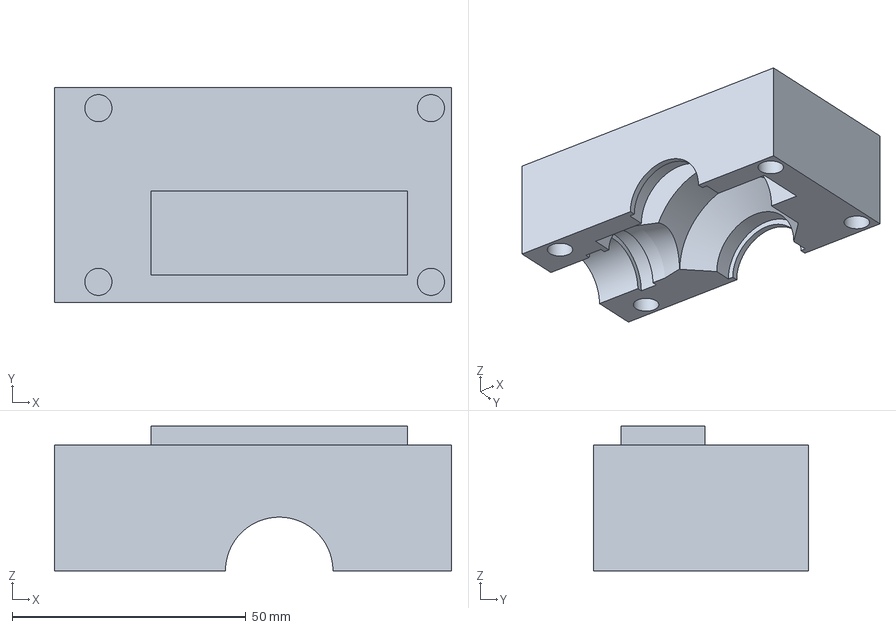
[picture p229: CAD file, 2023-11-30]
Exportierte Dateien/Chassis/Mounting/Getriebe_Mount_V3/GetriebeMount_Vorne_Oben_mir.3mf
85.0 x 46.0 x 31.0 mm
