unlegitGurke/RC-Car/Exportierte Dateien/Chassis/Mounting/Lipo_Mount/LipoMount_V2.0_Orca_Slicer.3mf

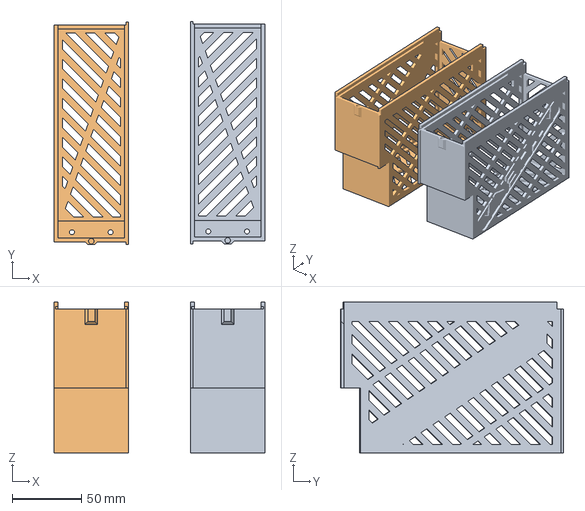
[picture p230: CAD file, 2024-02-23]
Exportierte Dateien/Chassis/Mounting/Lipo_Mount/LipoMount_V2.0_Orca_Slicer.3mf
152.6 x 161.6 x 109.0 mm
LipoMount_V2.0
LipoMount_V2.0_mirrored_2
