unlegitGurke/RC-Car/Exportierte Dateien/Electronics/Buck Converter/Buck_converter_Adapter.3mf

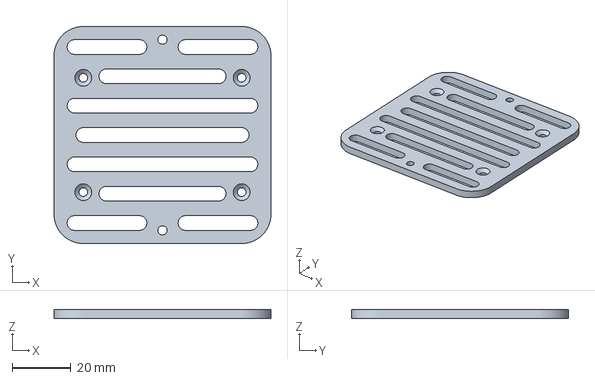
[picture p231: CAD file, 2022-12-10]
Exportierte Dateien/Electronics/Buck Converter/Buck_converter_Adapter.3mf
74.0 x 74.0 x 3.00 mm
