unlegitGurke/RC-Car/Exportierte Dateien/Electronics/Motor/Motor_Halterung_Fix.3mf

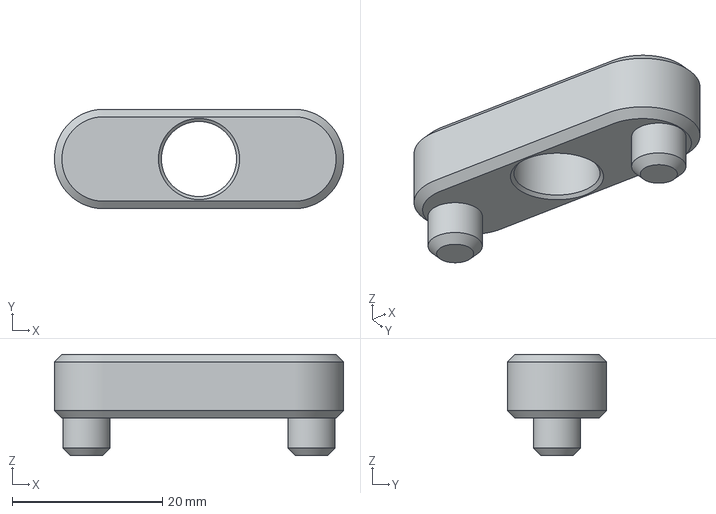
[picture p232: CAD file, 2024-01-04]
Exportierte Dateien/Electronics/Motor/Motor_Halterung_Fix.3mf
38.5 x 13.2 x 13.5 mm
