unlegitGurke/RC-Car/Exportierte Dateien/Electronics/Reciever/Reciever_Box_Bottom.3mf

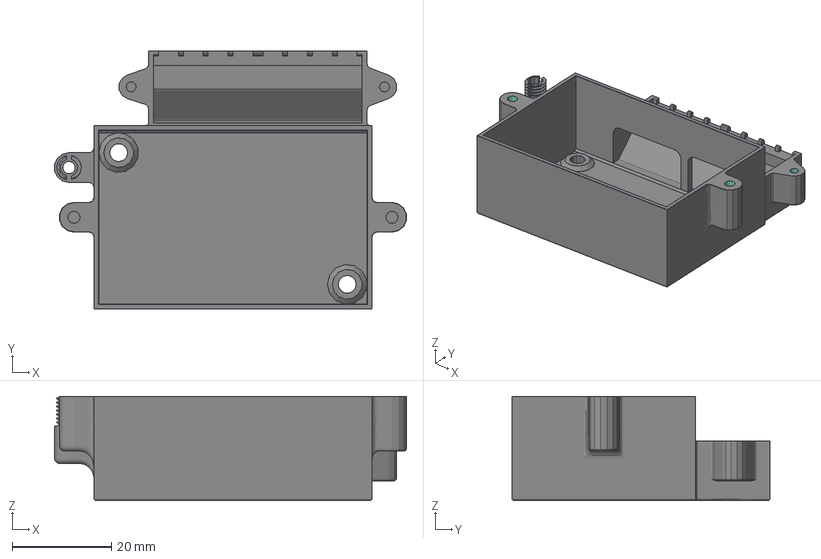
[picture p233: CAD file, 2021-10-25]
Exportierte Dateien/Electronics/Reciever/Reciever_Box_Bottom.3mf
70.8 x 52.0 x 21.0 mm
