unlegitGurke/RC-Car/Exportierte Dateien/Electronics/Servo/Servo_Mount.3mf

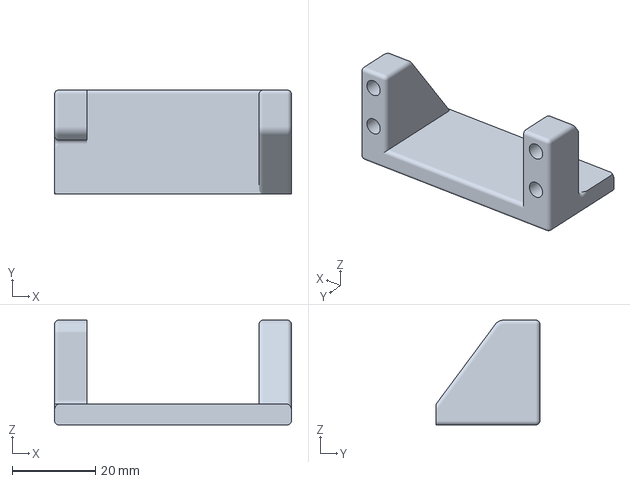
[picture p234: CAD file, 2023-12-16]
Exportierte Dateien/Electronics/Servo/Servo_Mount.3mf
57.0 x 25.0 x 25.2 mm
