unlegitGurke/RC-Car/Exportierte Dateien/Electronics/Ultrasonic_Sensor/Sensor_Size_Test.3mf

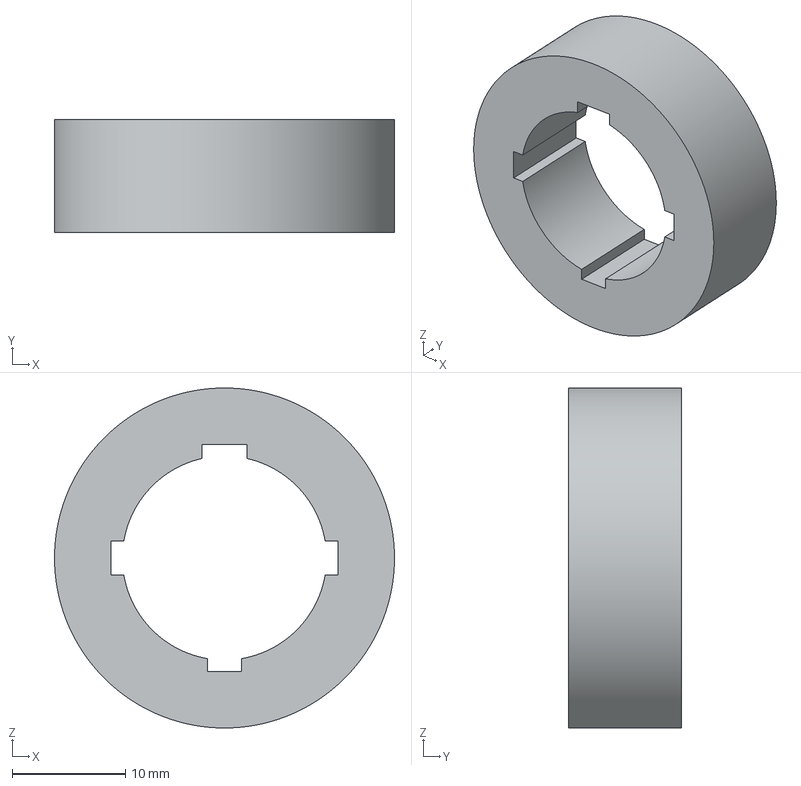
[picture p235: CAD file, 2022-12-14]
Exportierte Dateien/Electronics/Ultrasonic_Sensor/Sensor_Size_Test.3mf
30.0 x 10.0 x 30.0 mm
