unlegitGurke/RC-Car/Exportierte Dateien/Getriebe/Clutch/Clutch halter_top.3mf

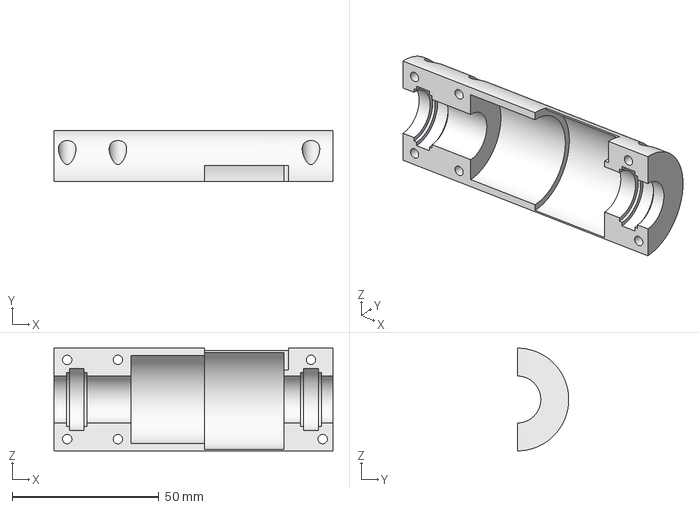
[picture p236: CAD file, 2023-01-08]
Exportierte Dateien/Getriebe/Clutch/Clutch halter_top.3mf
95.0 x 17.5 x 35.0 mm
