unlegitGurke/RC-Car/Exportierte Dateien/Getriebe/Driveshaft_ausschnitt1.3mf

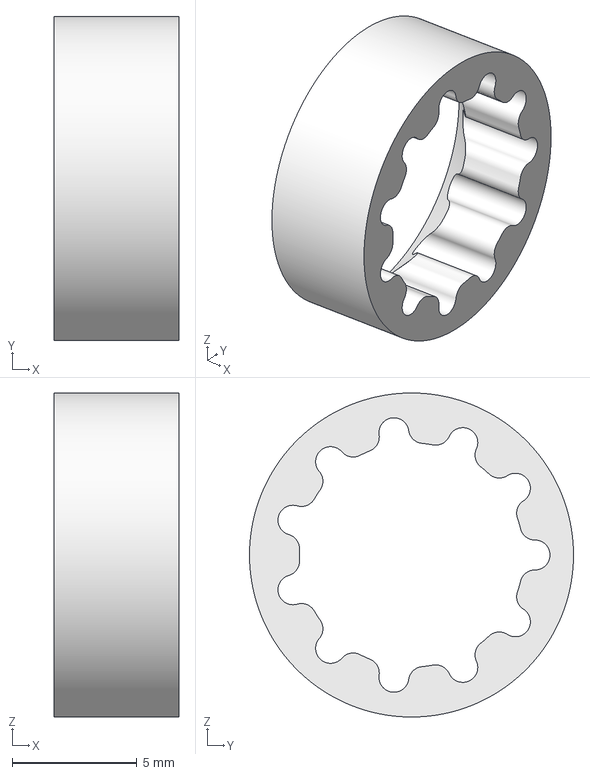
[picture p237: CAD file, 2022-11-17]
Exportierte Dateien/Getriebe/Driveshaft_ausschnitt1.3mf
5.00 x 13.0 x 13.0 mm
