unlegitGurke/RC-Car/Exportierte Dateien/Lenkung/Lenkung_print_1/Bearing_fake_14_9_3,5.3mf

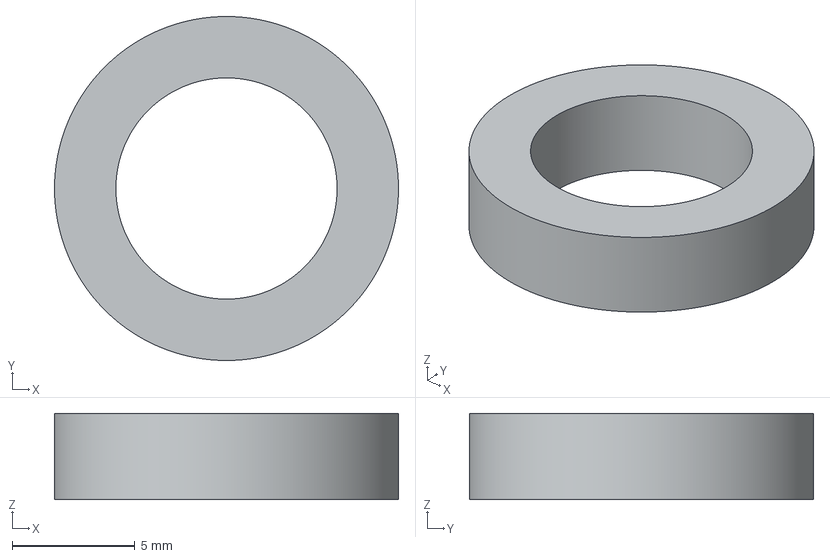
[picture p238: CAD file, 2022-09-18]
Exportierte Dateien/Lenkung/Lenkung_print_1/Bearing_fake_14_9_3,5.3mf
14.0 x 14.0 x 3.50 mm
