unlegitGurke/RC-Car/Exportierte Dateien/Lenkung/Lenkung_print_2/Lenkwinkel2.2.3mf

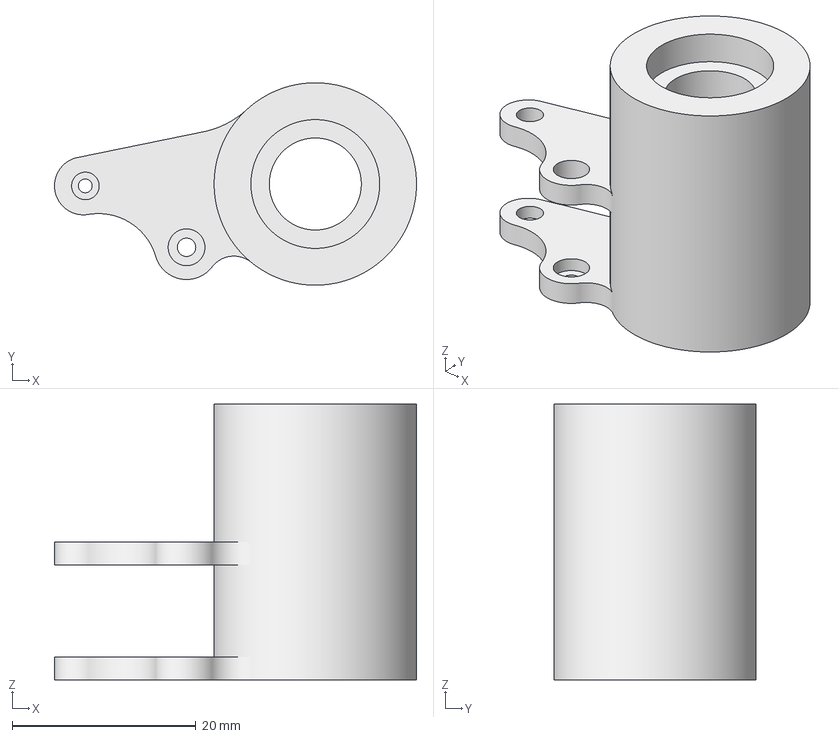
[picture p239: CAD file, 2022-09-18]
Exportierte Dateien/Lenkung/Lenkung_print_2/Lenkwinkel2.2.3mf
39.4 x 22.0 x 30.0 mm
