unlegitGurke/RC-Car/Exportierte Dateien/Lenkung/Lenkung_print_3/Lemkmittelarm.3mf

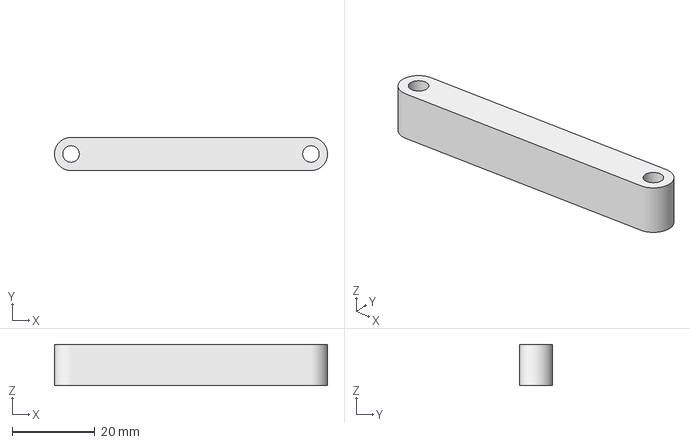
[picture p240: CAD file, 2023-10-02]
Exportierte Dateien/Lenkung/Lenkung_print_3/Lemkmittelarm.3mf
66.0 x 8.00 x 10.0 mm
