unlegitGurke/RC-Car/Exportierte Dateien/Lenkung/Lenkung_print_4/Servosave_rad.stp

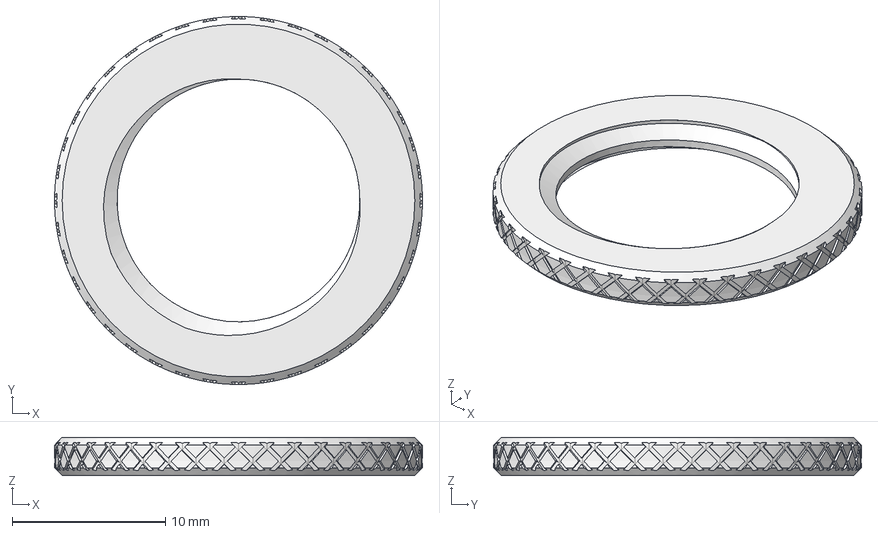
[picture p241: CAD file, 2024-02-23]
Exportierte Dateien/Lenkung/Lenkung_print_4/Servosave_rad.stp
24.0 x 24.0 x 2.50 mm
