unlegitGurke/RC-Car/Exportierte Dateien/Lenkung/Lenkung_Print_5_05_03_24/Lenkwinkel_3.0_non_save_verbessert.stp

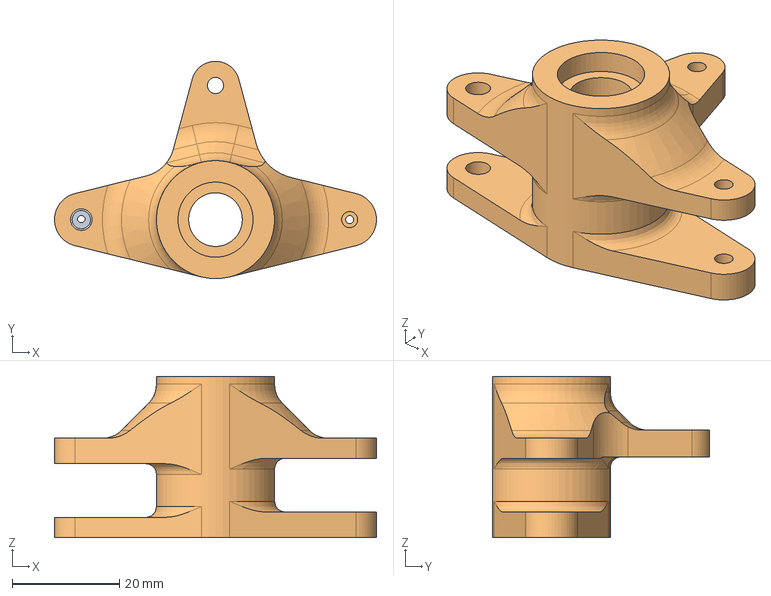
[picture p242: CAD file, 2024-03-08]
Exportierte Dateien/Lenkung/Lenkung_Print_5_05_03_24/Lenkwinkel_3.0_non_save_verbessert.stp
60.0 x 40.5 x 30.0 mm
