unlegitGurke/RC-Car/Exportierte Dateien/Ultrasonic_Sensor/PcbMount.3mf

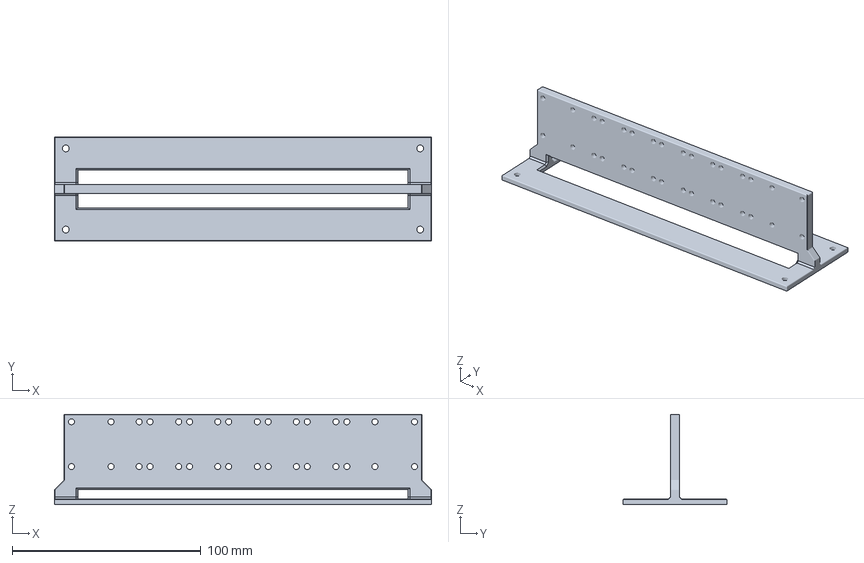
[picture p243: CAD file, 2022-11-17]
Exportierte Dateien/Ultrasonic_Sensor/PcbMount.3mf
200.0 x 55.0 x 48.0 mm
