unlegitGurke/RC-Car/Getriebe/clutch/claw-clutch/SPRZĘGŁO KŁOWE GE-T 48-A 60-B Fi35.SLDPRT

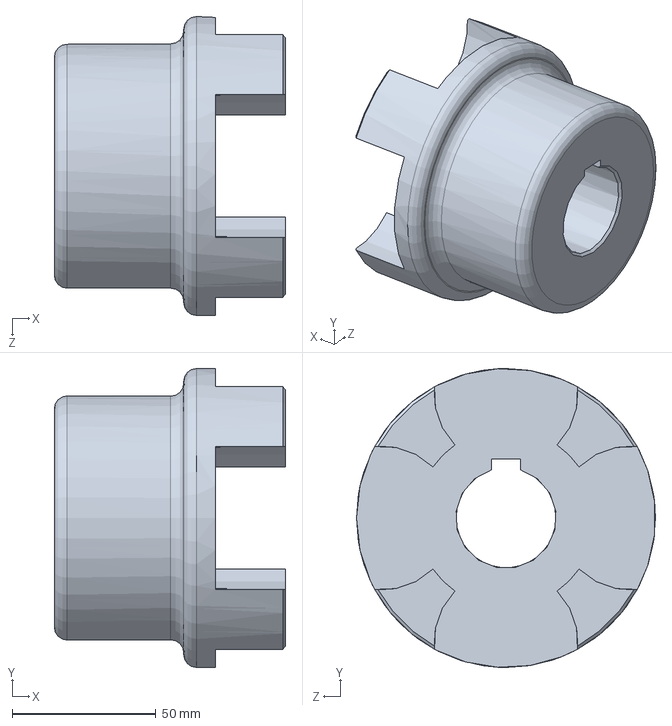
[picture p244: CAD file, 2021-12-27]
Getriebe/clutch/claw-clutch/SPRZĘGŁO KŁOWE GE-T 48-A 60-B Fi35.SLDPRT
80.5 x 104.0 x 104.0 mm
