unlegitGurke/RC-Car/Test_Car/Seitenplatte.dxf

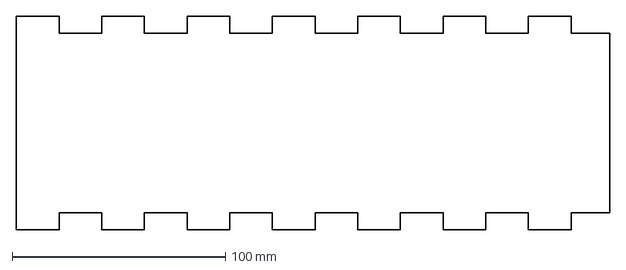
[picture p245: CAD file, 2022-02-09]
Test_Car/Seitenplatte.dxf
278.0 x 100.0 mm
