unlegitGurke/RC-Car/Chassis/Mounting/ruthex+Step-Data+threaded+inserts+M2-M8/files/ruthex_RX-M2x4.step

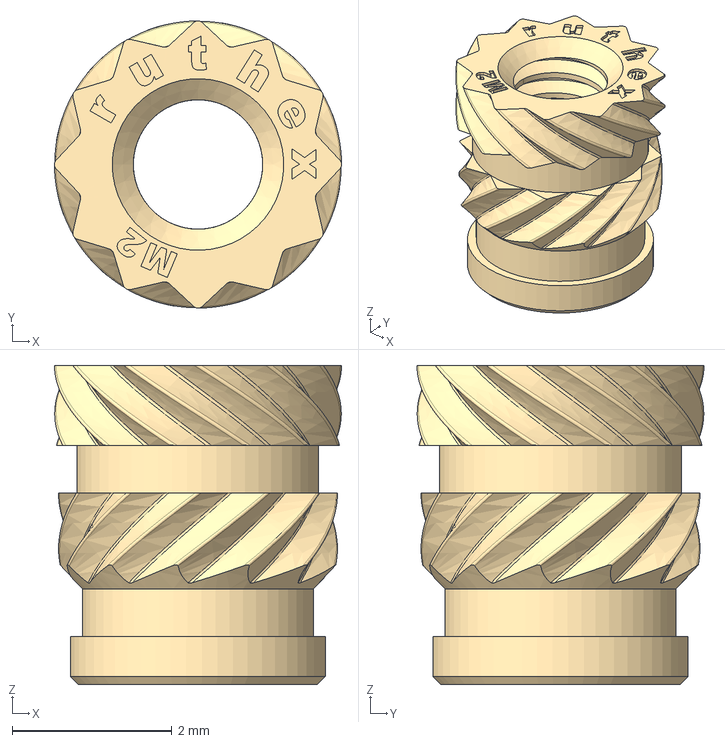
[picture p246: CAD file, 2021-10-26]
Chassis/Mounting/ruthex+Step-Data+threaded+inserts+M2-M8/files/ruthex_RX-M2x4.step
3.60 x 3.60 x 4.00 mm
