unlegitGurke/RC-Car/Drafts/Aufhängung/Abdeckplatte_Hinten1.dxf

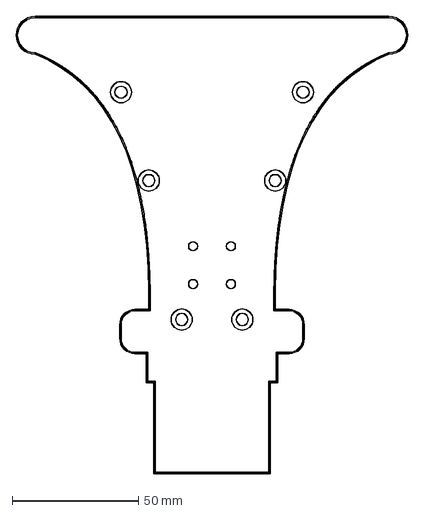
[picture p247: CAD file, 2021-06-23]
Drafts/Aufhängung/Abdeckplatte_Hinten1.dxf
155.0 x 181.0 mm
