unlegitGurke/RC-Car/Electronics/12mm_push_button/12mm_Switch.step

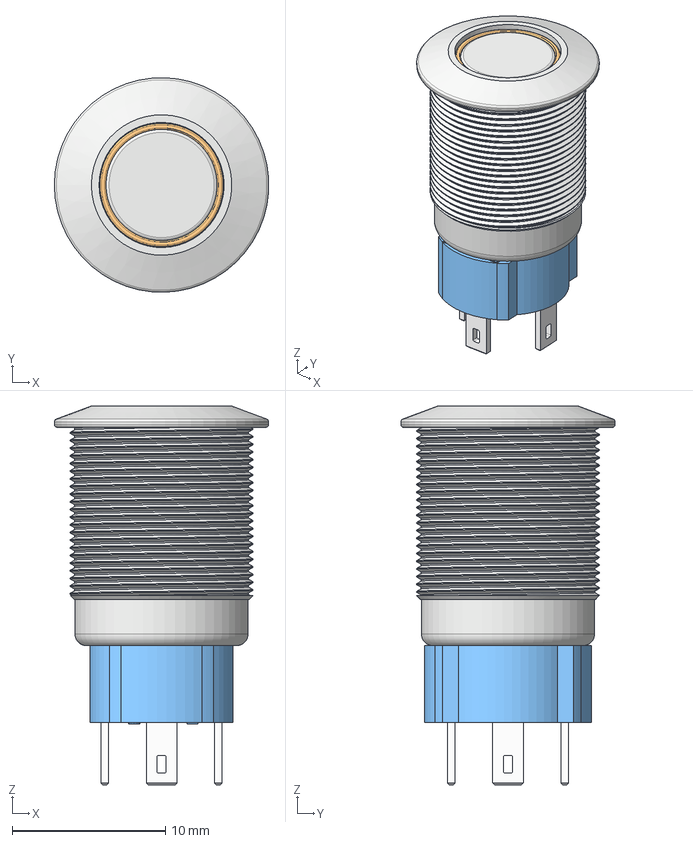
[picture p248: CAD file, 2022-01-05]
Electronics/12mm_push_button/12mm_Switch.step
14.0 x 14.0 x 24.7 mm
button
solderlug x 4
