unlegitGurke/RC-Car/Electronics/4-pin-pwm-connector-1.snapshot.1/Kabelstueck-500┬Ám.SLDPRT

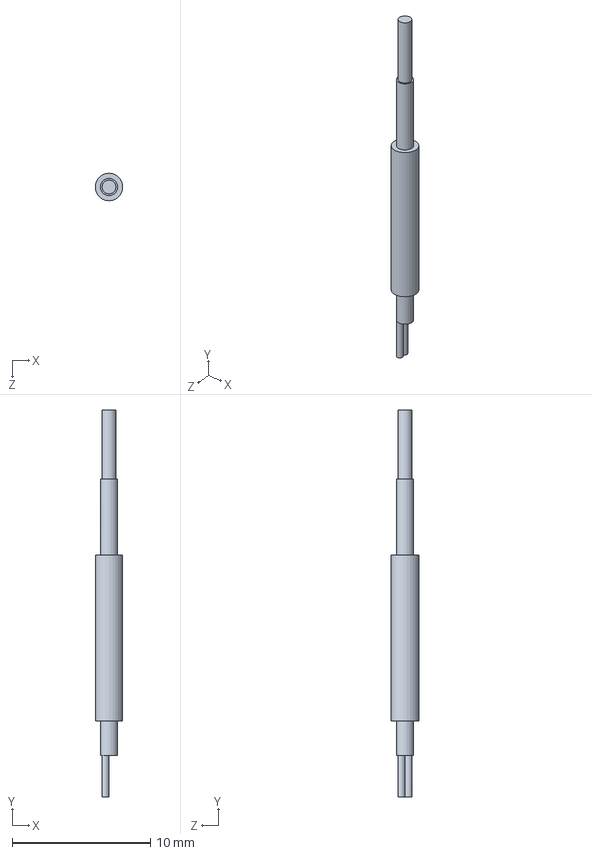
[picture p249: CAD file, 2021-12-27]
Electronics/4-pin-pwm-connector-1.snapshot.1/Kabelstueck-500┬Ám.SLDPRT
1.99 x 28.0 x 2.00 mm
