unlegitGurke/RC-Car/Electronics/4pin-magnetic-pogo-connector-plug-female-1.snapshot.2/Pogo_$pin_Male.step

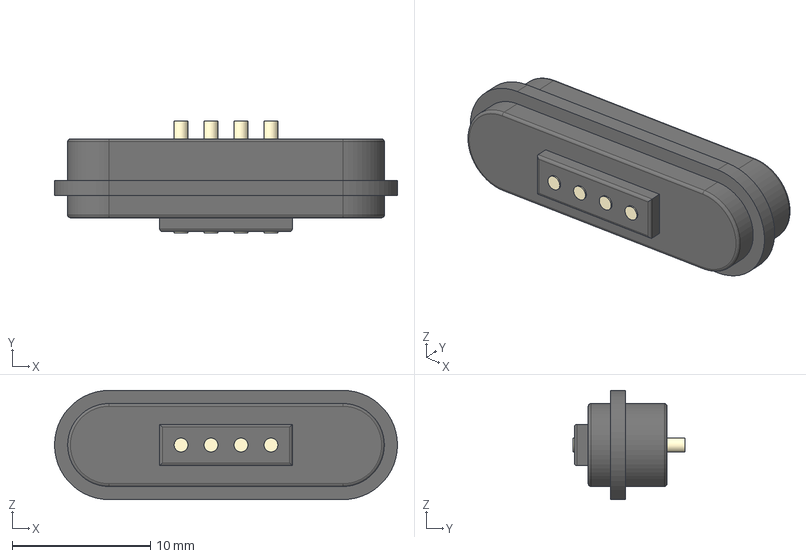
[picture p250: CAD file, 2021-10-27]
Electronics/4pin-magnetic-pogo-connector-plug-female-1.snapshot.2/Pogo_$pin_Male.step
24.8 x 8.10 x 7.90 mm
