unlegitGurke/RC-Car/Electronics/Akku/Cell Cage/holder 21250.SLDPRT

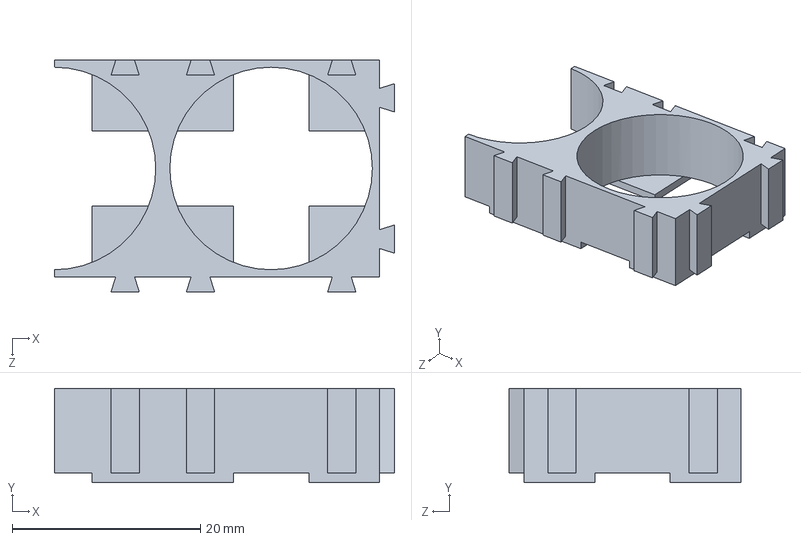
[picture p251: CAD file, 2022-01-23]
Electronics/Akku/Cell Cage/holder 21250.SLDPRT
36.1 x 10.0 x 24.6 mm
