unlegitGurke/RC-Car/Electronics/jst-ph-2-00mm-connector-set-1.snapshot.63/JST - PH - Thru - Vertical - 2.00mm/JST - PH - Thru (V) - 13Pin - 2.00mm.stp

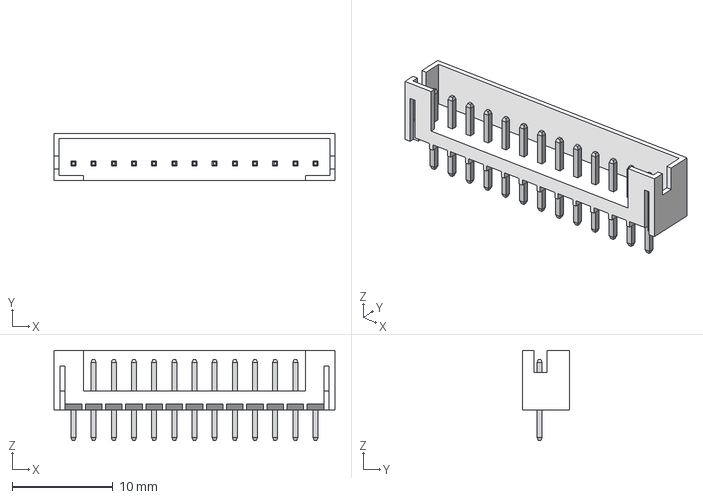
[picture p253: CAD file, 2022-01-05]
Electronics/jst-ph-2-00mm-connector-set-1.snapshot.63/JST - PH - Thru - Vertical - 2.00mm/JST - PH - Thru (V) - 13Pin - 2.00mm.stp
27.9 x 4.67 x 8.94 mm
