unlegitGurke/RC-Car/Electronics/jst-xh-2-54mm-generic-connector-set-1.snapshot.31/SMD Horizontal/JST - XH - SMD (R) - 8Pin - 2.54mm.stp

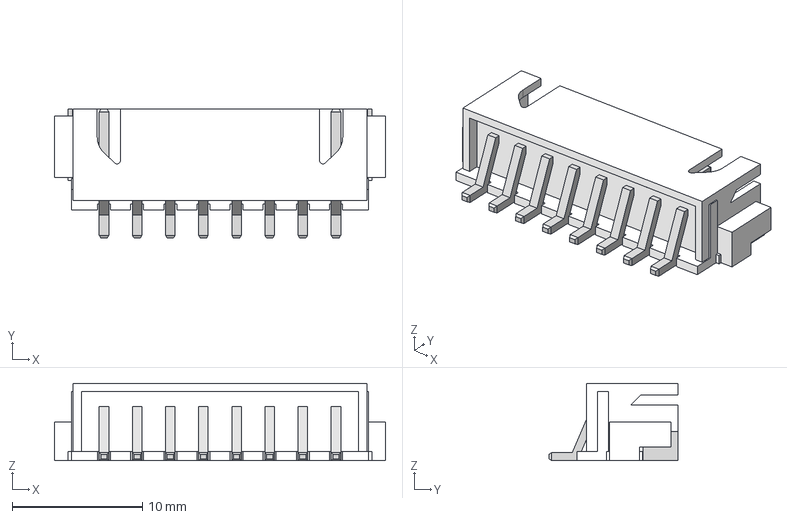
[picture p254: CAD file, 2022-01-05]
Electronics/jst-xh-2-54mm-generic-connector-set-1.snapshot.31/SMD Horizontal/JST - XH - SMD (R) - 8Pin - 2.54mm.stp
25.4 x 9.91 x 5.92 mm
