unlegitGurke/RC-Car/Electronics/LattePanda_3_Delta/LatteCase/bottom.stp

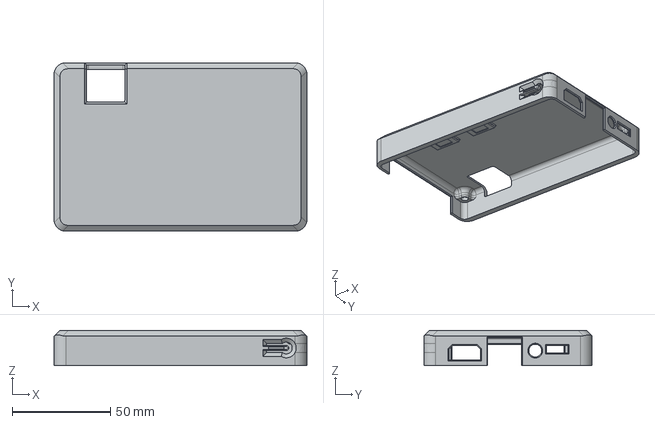
[picture p257: CAD file, 2022-12-28]
Electronics/LattePanda_3_Delta/LatteCase/bottom.stp
128.6 x 85.6 x 18.0 mm
