unlegitGurke/RC-Car/Electronics/LattePanda_3_Delta/LattePanda-3D-Models-master/LattePanda-3D-Models-master/stand.dxf

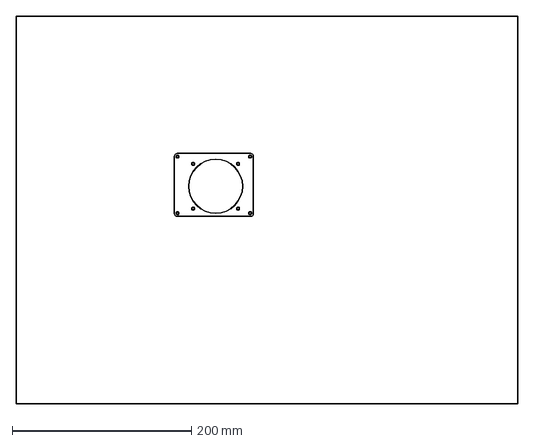
[picture p258: CAD file, 2022-10-17]
Electronics/LattePanda_3_Delta/LattePanda-3D-Models-master/LattePanda-3D-Models-master/stand.dxf
558.8 x 431.8 mm
