unlegitGurke/RC-Car/Electronics/LiDAR/lidar mount alt gopro adapter/lidar mount done .3mf

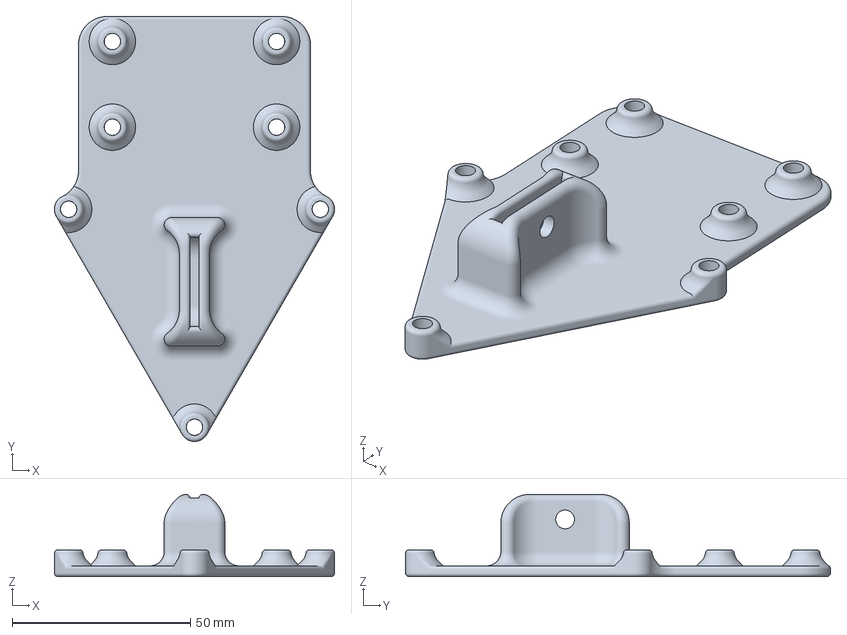
[picture p259: CAD file, 2024-04-25]
Electronics/LiDAR/lidar mount alt gopro adapter/lidar mount done .3mf
78.5 x 119.1 x 23.0 mm
