unlegitGurke/RC-Car/Electronics/Raspberry Pi/Raspberry Pi 4 3D Model/2.54 mm DUPONT MALE PIN HEADER, POE, 2X2, RPi4ModelB.SLDPRT

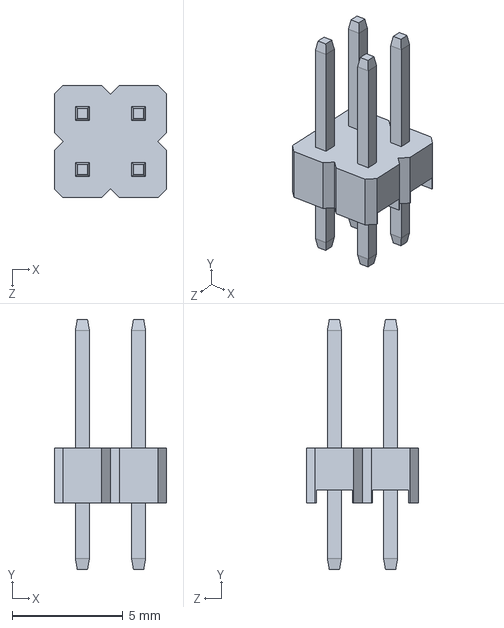
[picture p260: CAD file, 2021-02-07]
Electronics/Raspberry Pi/Raspberry Pi 4 3D Model/2.54 mm DUPONT MALE PIN HEADER, POE, 2X2, RPi4ModelB.SLDPRT
5.08 x 11.3 x 5.08 mm
