unlegitGurke/RC-Car/Electronics/RaspberryPI_Shield/Connector Pi/models3d/PBD/PBD-22.step

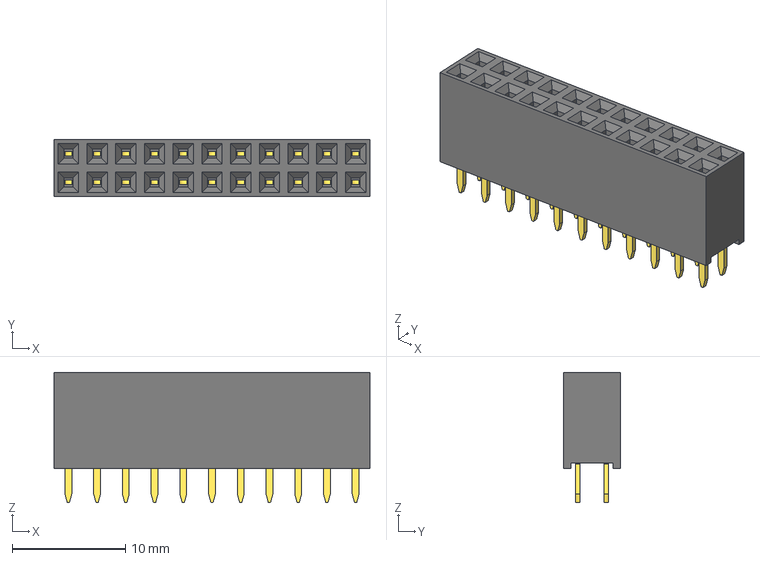
[picture p261: CAD file, 2021-04-19]
Electronics/RaspberryPI_Shield/Connector Pi/models3d/PBD/PBD-22.step
27.9 x 5.08 x 11.5 mm
