unlegitGurke/RC-Car/Electronics/RaspberryPI_Shield/Connector Pi/models3d/PBS/PBS-12R.step

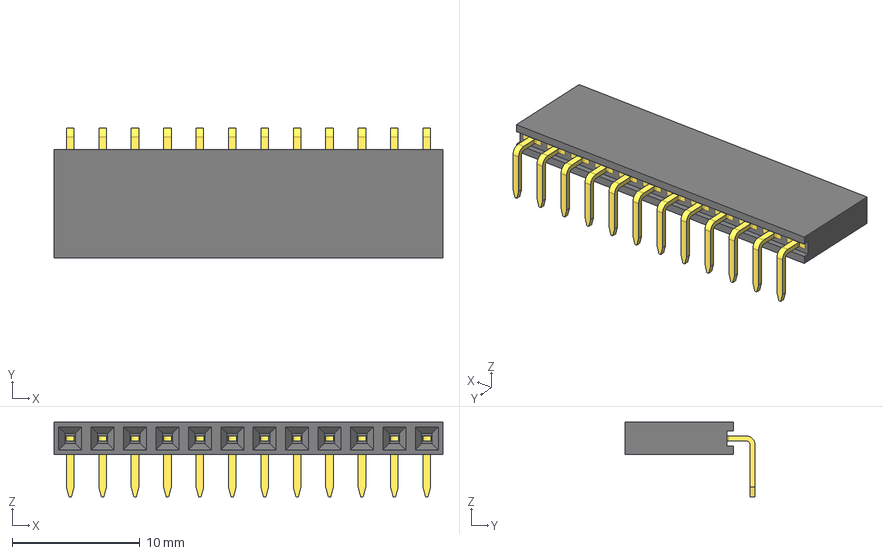
[picture p262: CAD file, 2021-04-19]
Electronics/RaspberryPI_Shield/Connector Pi/models3d/PBS/PBS-12R.step
30.5 x 10.2 x 5.84 mm
