unlegitGurke/RC-Car/Electronics/RaspberryPI_Shield/NEW_Shield/fan-header-4pin-2-54mm-1.snapshot.6/Fan Header/Fan Header-Pin Horizontal.SLDPRT

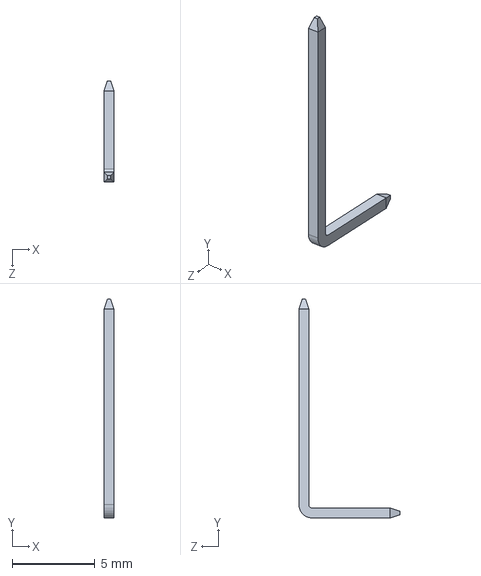
[picture p263: CAD file, 2021-12-27]
Electronics/RaspberryPI_Shield/NEW_Shield/fan-header-4pin-2-54mm-1.snapshot.6/Fan Header/Fan Header-Pin Horizontal.SLDPRT
0.6 x 13.2 x 6.10 mm
