unlegitGurke/RC-Car/Electronics/spacers-m2-male-female-1.snapshot.4/Spacer M2 M F 10mm.stp

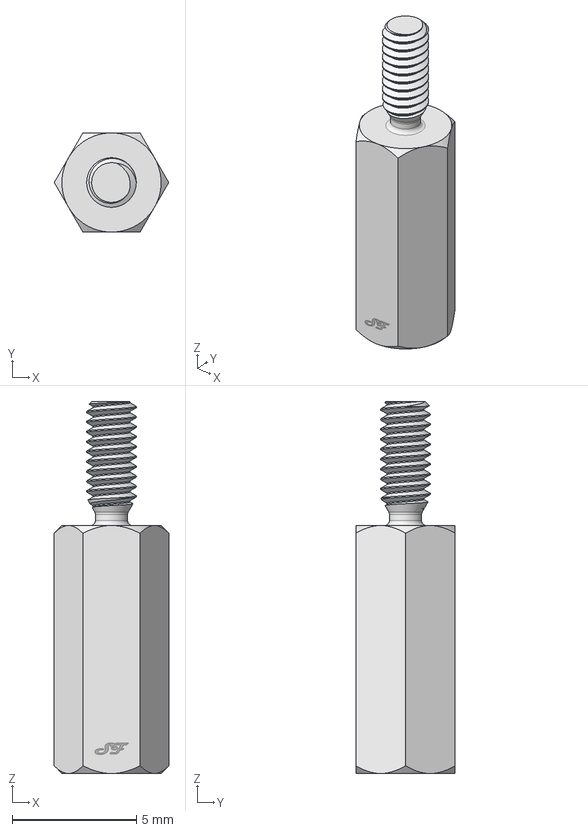
[picture p264: CAD file, 2021-12-12]
Electronics/spacers-m2-male-female-1.snapshot.4/Spacer M2 M F 10mm.stp
4.62 x 4.00 x 15.0 mm
