unlegitGurke/RC-Car/Electronics/Ultrasonic Sensor/PcbMount.stp

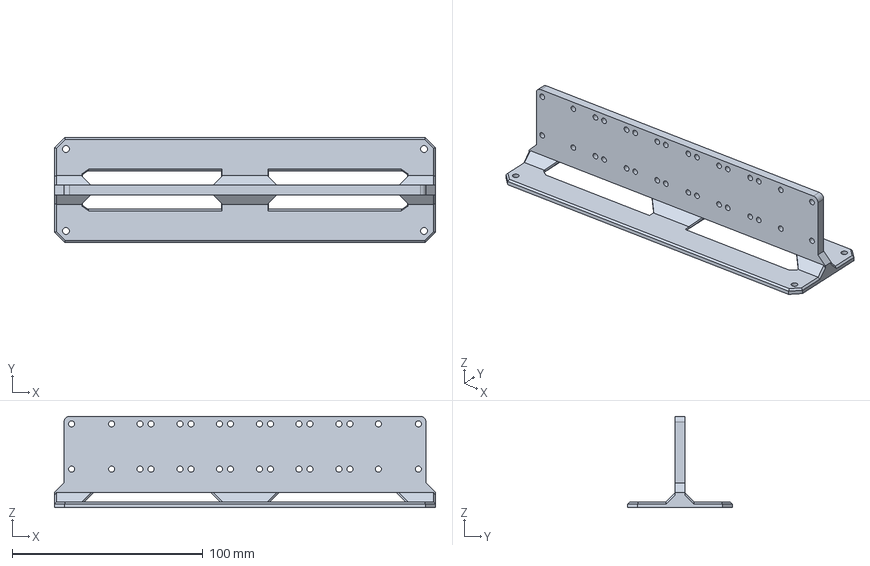
[picture p265: CAD file, 2024-03-10]
Electronics/Ultrasonic Sensor/PcbMount.stp
200.0 x 55.0 x 48.0 mm
