unlegitGurke/RC-Car/Exportierte Dateien/Aufhängung/3-teilige-Felge/Felgen Rohr.3mf

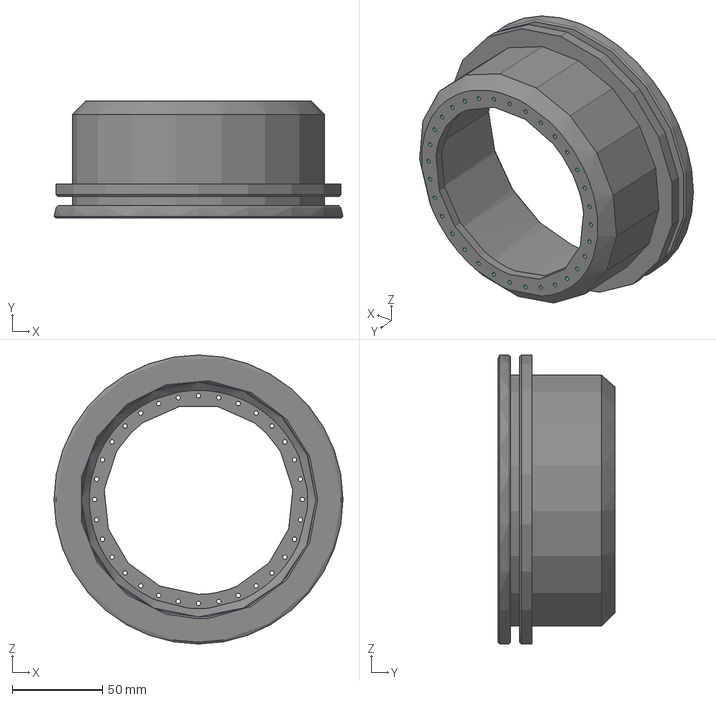
[picture p266: CAD file, 2021-10-25]
Exportierte Dateien/Aufhängung/3-teilige-Felge/Felgen Rohr.3mf
160.0 x 65.0 x 160.0 mm
