unlegitGurke/RC-Car/Exportierte Dateien/Aufhängung/A-Arm_Mount_Hinten_Links.stp

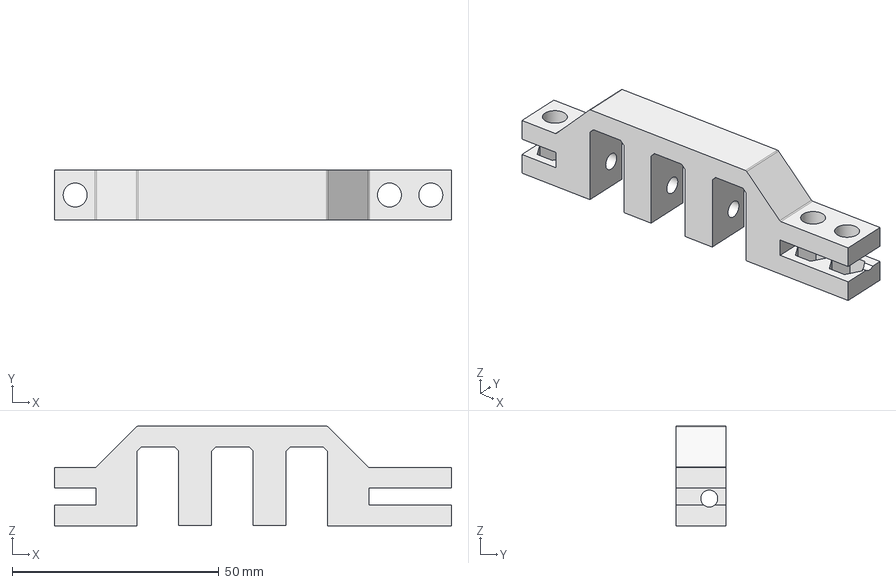
[picture p267: CAD file, 2024-03-07]
Exportierte Dateien/Aufhängung/A-Arm_Mount_Hinten_Links.stp
96.0 x 12.0 x 24.1 mm
