unlegitGurke/RC-Car/Exportierte Dateien/Body/Body 3d print/Body_2_links.stp

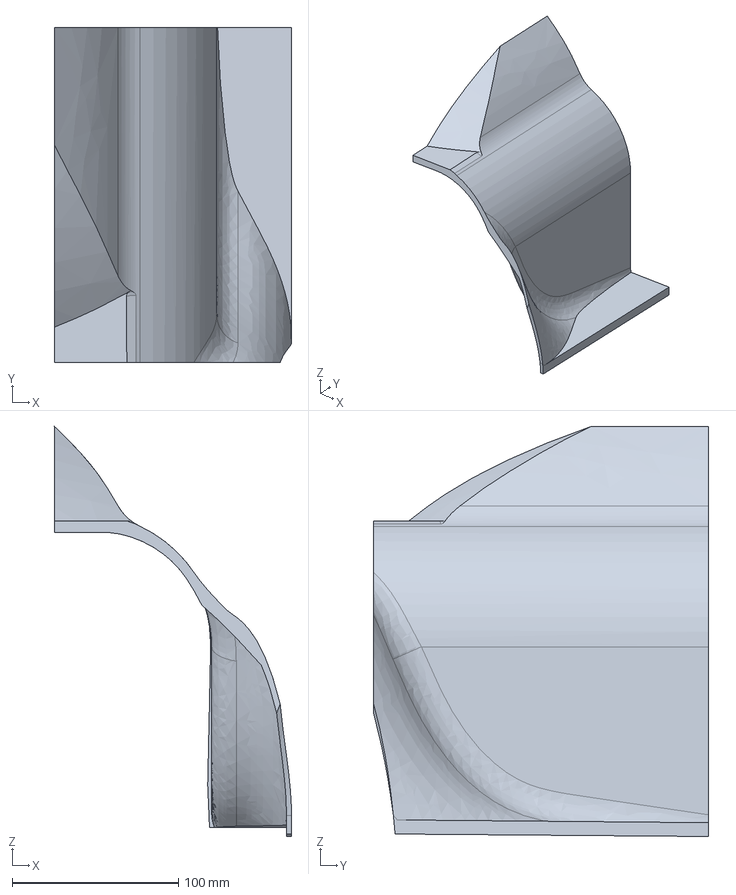
[picture p268: CAD file, 2024-03-08]
Exportierte Dateien/Body/Body 3d print/Body_2_links.stp
142.5 x 201.3 x 246.5 mm
