unlegitGurke/RC-Car/Exportierte Dateien/Body/Body_Bambulab/Body_2_mitte_Bambu.stp

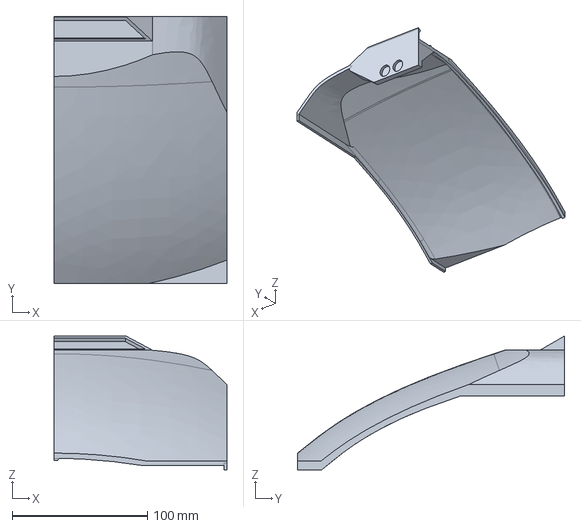
[picture p269: CAD file, 2024-05-14]
Exportierte Dateien/Body/Body_Bambulab/Body_2_mitte_Bambu.stp
127.5 x 197.3 x 98.8 mm
