unlegitGurke/RC-Car/Exportierte Dateien/Body/Bodymount_hinten_print/Bodymount_hinten_1.stp

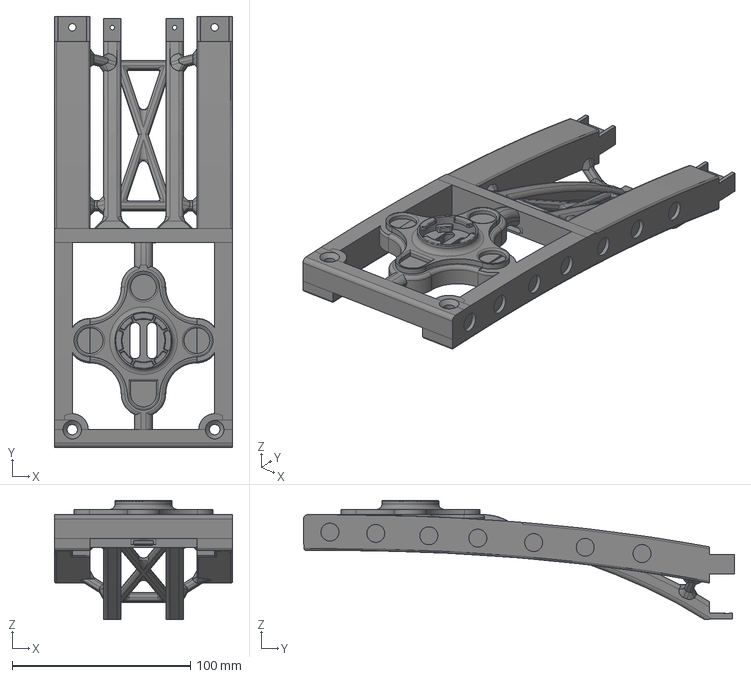
[picture p270: CAD file, 2024-05-13]
Exportierte Dateien/Body/Bodymount_hinten_print/Bodymount_hinten_1.stp
100.0 x 242.1 x 67.0 mm
