unlegitGurke/RC-Car/Exportierte Dateien/Body/Bodymount_hinten_print/Bodymount_hinten_adapter/Adapter_2_1.stp

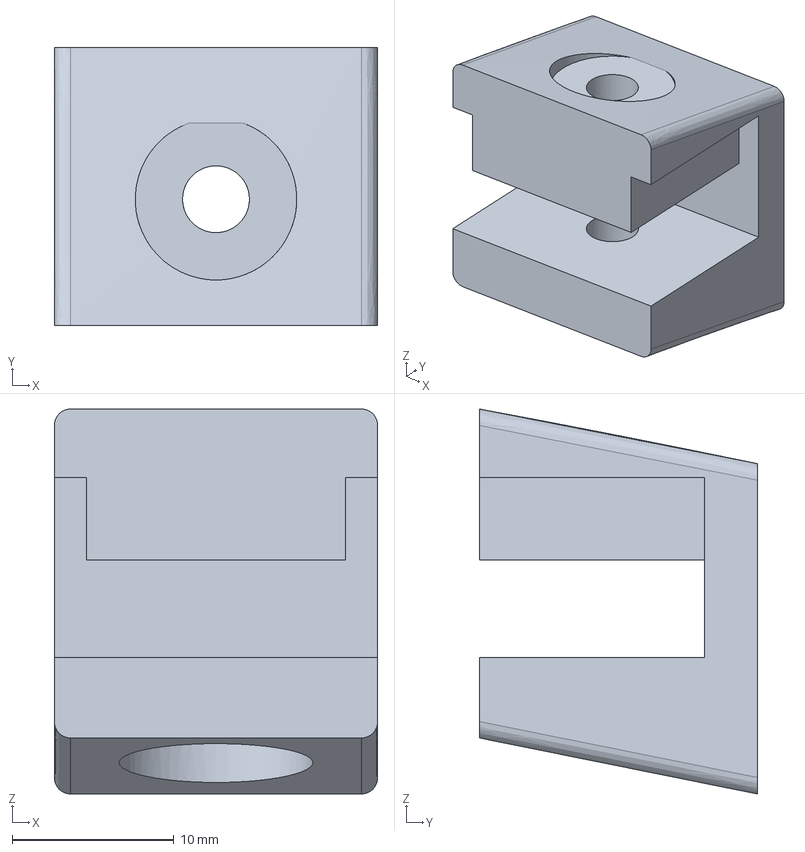
[picture p271: CAD file, 2024-02-23]
Exportierte Dateien/Body/Bodymount_hinten_print/Bodymount_hinten_adapter/Adapter_2_1.stp
20.0 x 17.2 x 23.8 mm
