unlegitGurke/RC-Car/Exportierte Dateien/Body/Bumper_front_2_4.stp

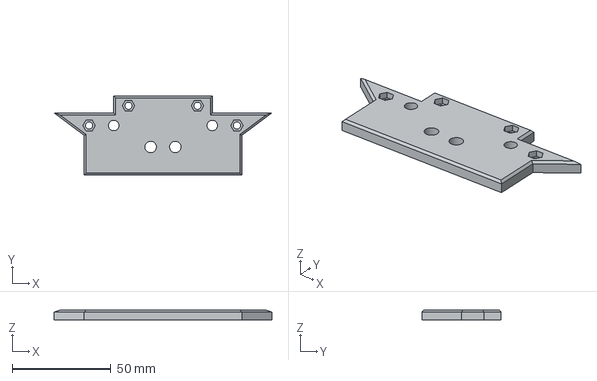
[picture p272: CAD file, 2024-03-13]
Exportierte Dateien/Body/Bumper_front_2_4.stp
110.6 x 40.1 x 5.00 mm
