unlegitGurke/RC-Car/Exportierte Dateien/Body/Kotflügel/Extreme_Kotflügel 2 gespiegelt_ORCA.3mf

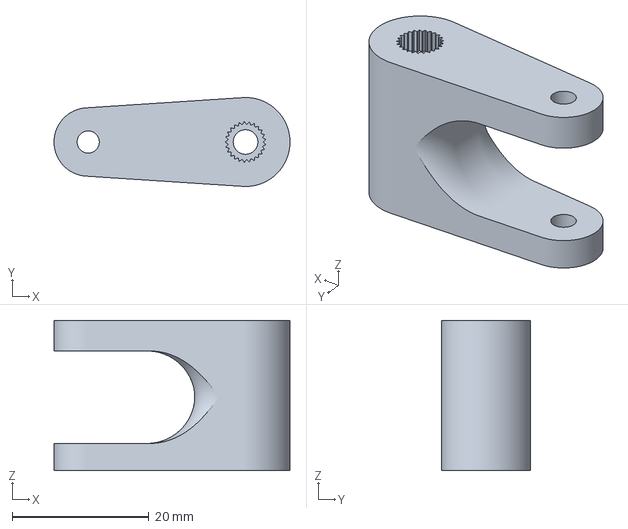
[picture p273: CAD file, 2024-03-08]
Exportierte Dateien/Body/Kotflügel/Extreme_Kotflügel 2 gespiegelt_ORCA.3mf
34.5 x 13.0 x 22.0 mm
