unlegitGurke/RC-Car/Exportierte Dateien/Body/SensorMount/Sensor hinten.3mf

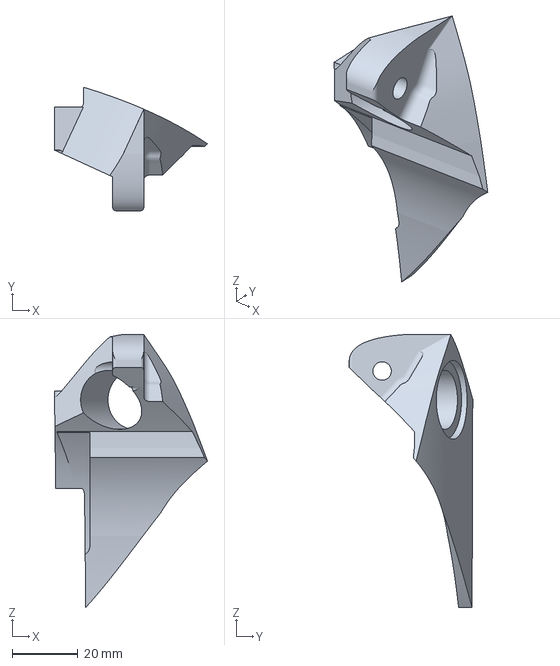
[picture p274: CAD file, 2023-01-08]
Exportierte Dateien/Body/SensorMount/Sensor hinten.3mf
46.7 x 37.7 x 83.3 mm
