unlegitGurke/RC-Car/Exportierte Dateien/Chassis/Grundplatte_V4.0.dxf

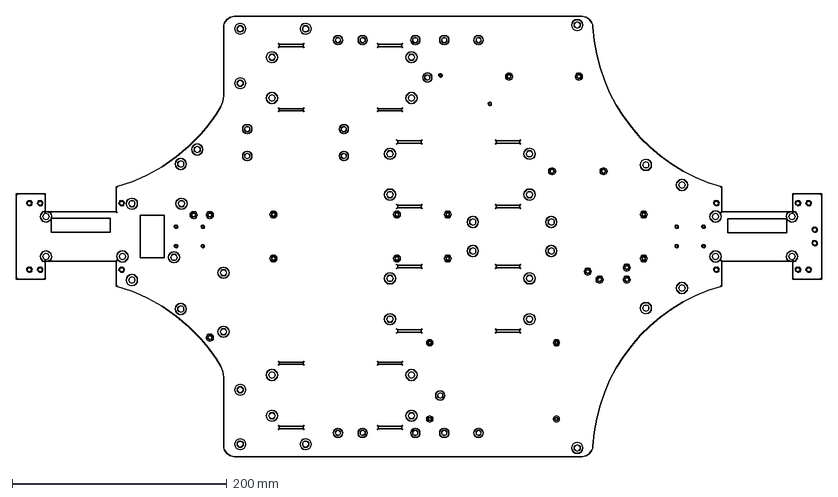
[picture p275: CAD file, 2023-01-17]
Exportierte Dateien/Chassis/Grundplatte_V4.0.dxf
750.0 x 410.0 mm
