unlegitGurke/RC-Car/Exportierte Dateien/Chassis/Mounting/Lipo_Mount/LipoMount_V2.0_Deckel.3mf

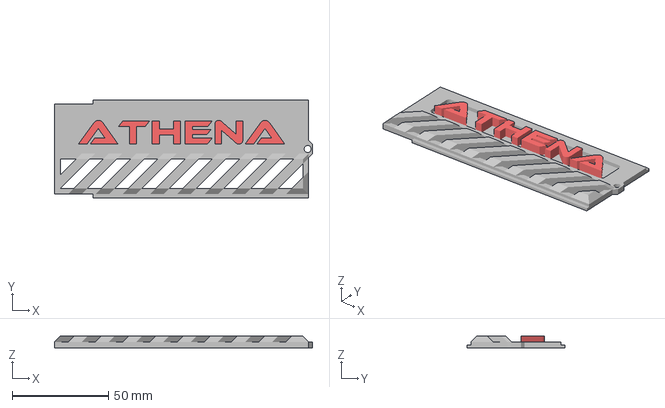
[picture p276: CAD file, 2023-12-20]
Exportierte Dateien/Chassis/Mounting/Lipo_Mount/LipoMount_V2.0_Deckel.3mf
134.0 x 51.0 x 6.00 mm
