unlegitGurke/RC-Car/Exportierte Dateien/Chassis/Mounting/Lüfter_mount_latepanda.stp

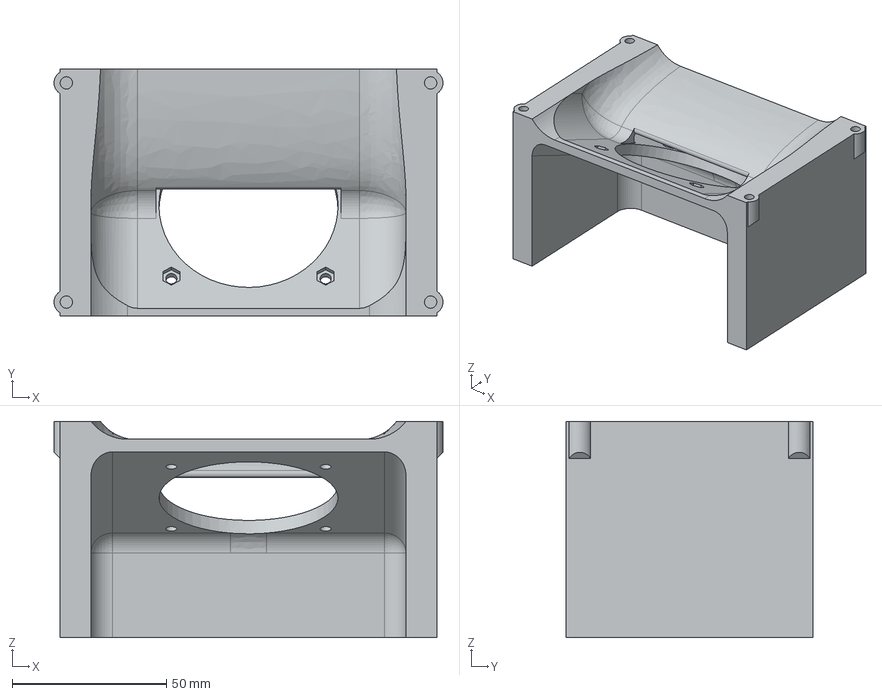
[picture p277: CAD file, 2024-03-17]
Exportierte Dateien/Chassis/Mounting/Lüfter_mount_latepanda.stp
126.0 x 80.0 x 70.0 mm
