unlegitGurke/RC-Car/Exportierte Dateien/Electronics/Reciever/Cable_Box_Top.3mf

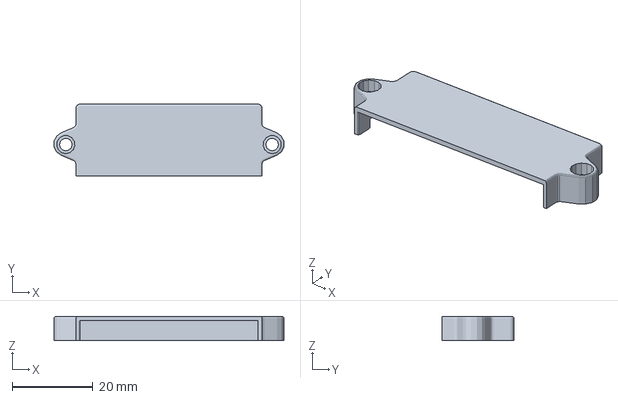
[picture p278: CAD file, 2020-10-28]
Exportierte Dateien/Electronics/Reciever/Cable_Box_Top.3mf
56.8 x 17.8 x 6.00 mm
