unlegitGurke/RC-Car/Exportierte Dateien/Getriebe/Bearing_Fake_24_15_5.3mf

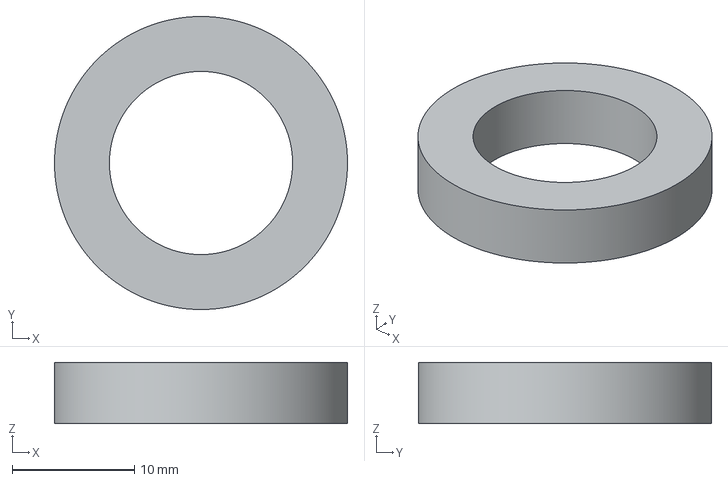
[picture p279: CAD file, 2022-07-28]
Exportierte Dateien/Getriebe/Bearing_Fake_24_15_5.3mf
24.0 x 24.0 x 5.00 mm
