unlegitGurke/RC-Car/Exportierte Dateien/Getriebe/Clutch/Clutch halter_3DPrint.3mf

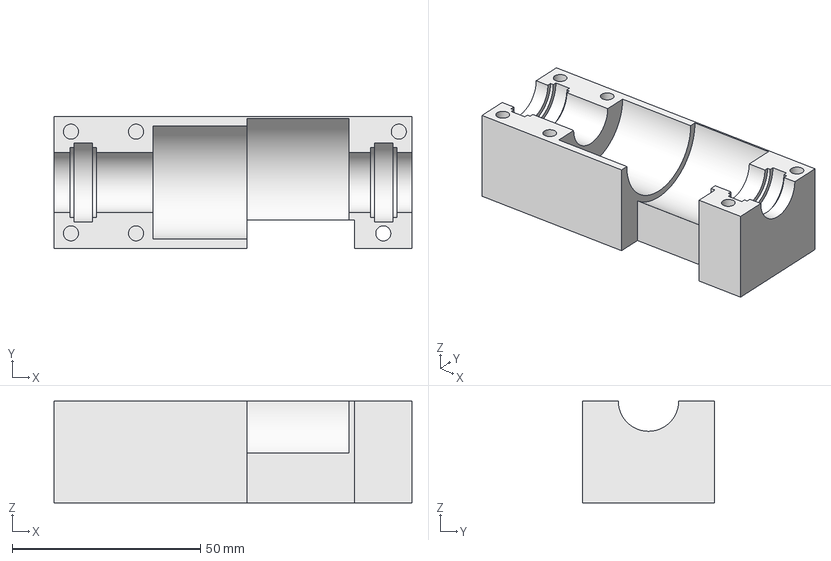
[picture p280: CAD file, 2023-01-08]
Exportierte Dateien/Getriebe/Clutch/Clutch halter_3DPrint.3mf
95.0 x 35.0 x 27.0 mm
