unlegitGurke/RC-Car/Exportierte Dateien/Lenkung/Lenkung_print_1/Servoarm.3mf

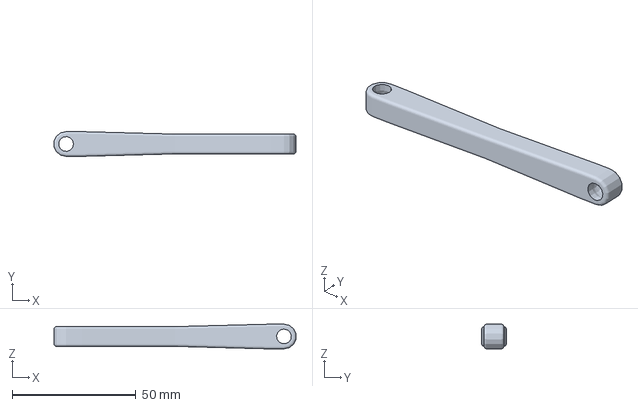
[picture p281: CAD file, 2021-05-11]
Exportierte Dateien/Lenkung/Lenkung_print_1/Servoarm.3mf
97.8 x 10.0 x 10.0 mm
