unlegitGurke/RC-Car/Exportierte Dateien/Lenkung/Lenkung_print_2/Lenkwinkel.3mf

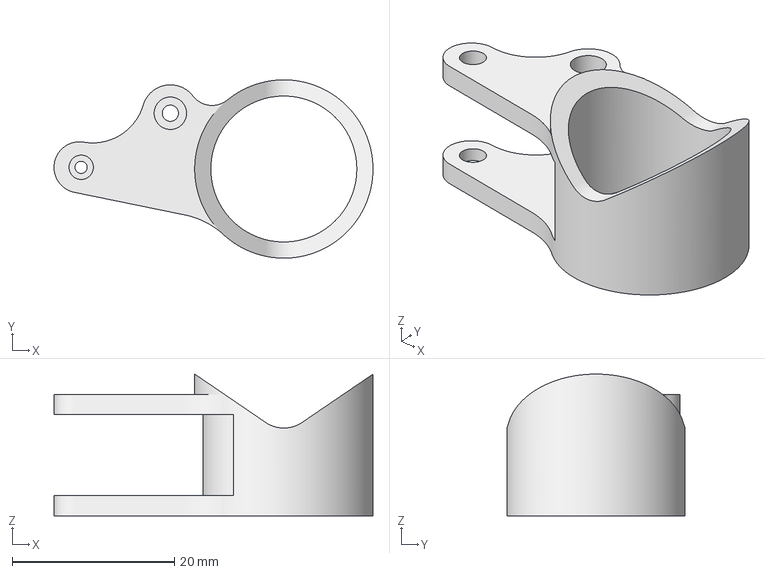
[picture p282: CAD file, 2022-09-18]
Exportierte Dateien/Lenkung/Lenkung_print_2/Lenkwinkel.3mf
39.4 x 22.0 x 17.5 mm
