unlegitGurke/RC-Car/Exportierte Dateien/Lenkung/Lenkung_print_3/Lenkung_BambuStudio.3mf

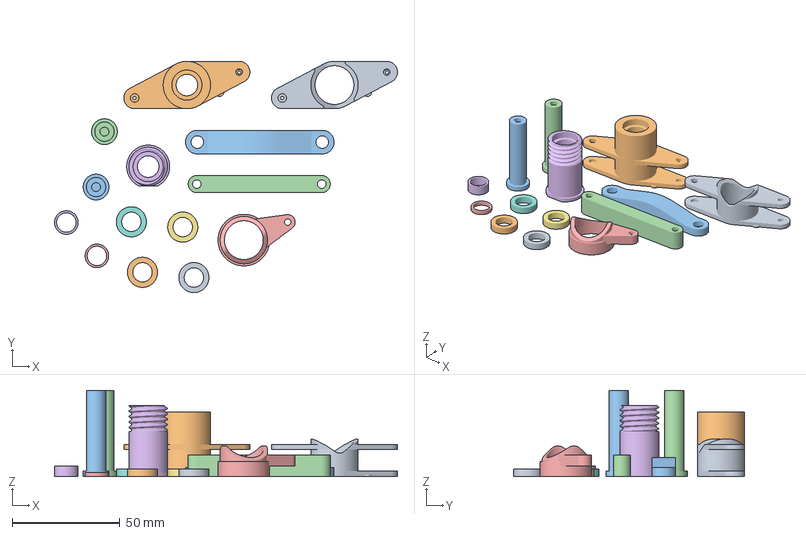
[picture p283: CAD file, 2023-10-02]
Exportierte Dateien/Lenkung/Lenkung_print_3/Lenkung_BambuStudio.3mf
159.3 x 107.4 x 40.0 mm
Lenkwinkel2.0
Lenkwinkel2.20.2_verbessert
Halterung
Lemkmittelarm
Servosaver top
Servosaver_Hülse
Bearing_fake_14_9_3,5 x 4
Drehbolzen x 2
Servosleeve1
Servosleeve2
