unlegitGurke/RC-Car/Exportierte Dateien/Lenkung/Lenkung_print_4/Servosaver top.stp

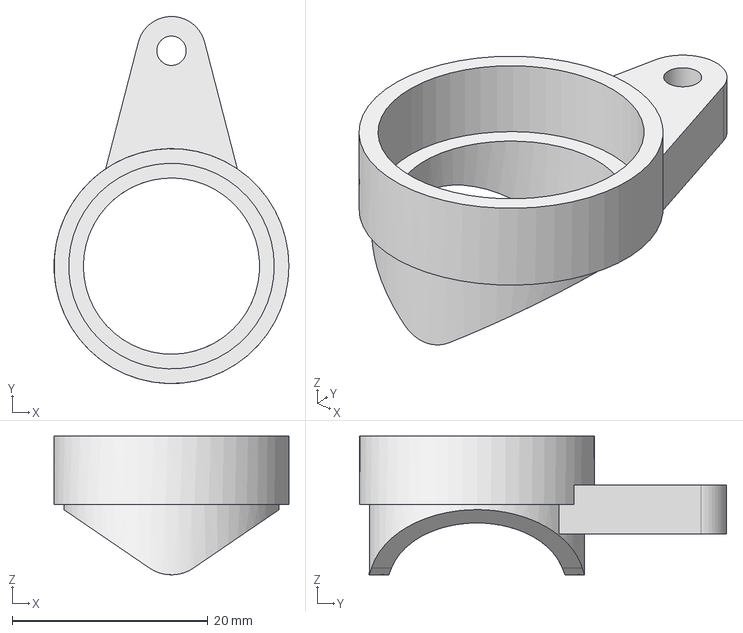
[picture p284: CAD file, 2024-01-18]
Exportierte Dateien/Lenkung/Lenkung_print_4/Servosaver top.stp
24.0 x 37.5 x 14.2 mm
