unlegitGurke/RC-Car/Exportierte Dateien/Lenkung/Lenkung_Print_5_05_03_24/Lenkwinkel2.20.2_verbessert.stp

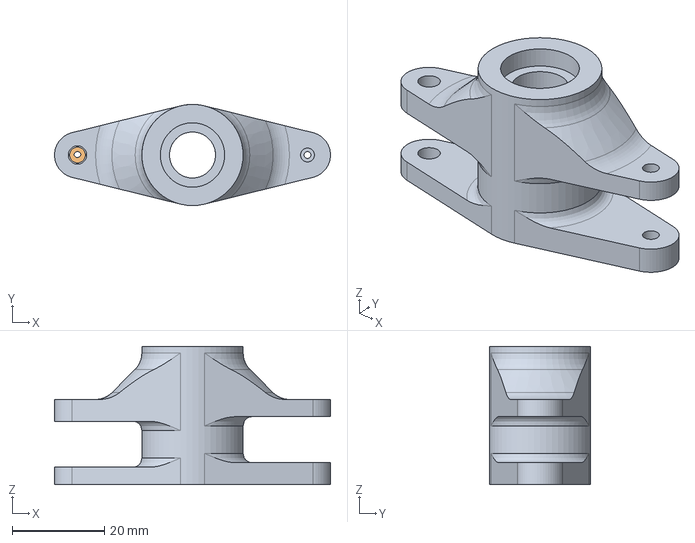
[picture p285: CAD file, 2024-03-05]
Exportierte Dateien/Lenkung/Lenkung_Print_5_05_03_24/Lenkwinkel2.20.2_verbessert.stp
60.0 x 22.0 x 30.0 mm
