unlegitGurke/RC-Car/Test_Car/Sensor_Mount.dxf

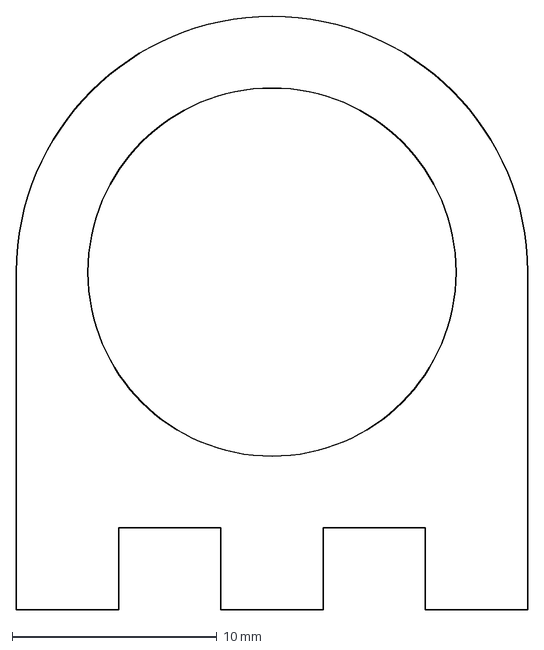
[picture p286: CAD file, 2022-02-09]
Test_Car/Sensor_Mount.dxf
25.0 x 29.0 mm
