unlegitGurke/RC-Car/Chassis/Mounting/ruthex+Step-Data+threaded+inserts+M2-M8/files/ruthex_RX-M4x8.1.step

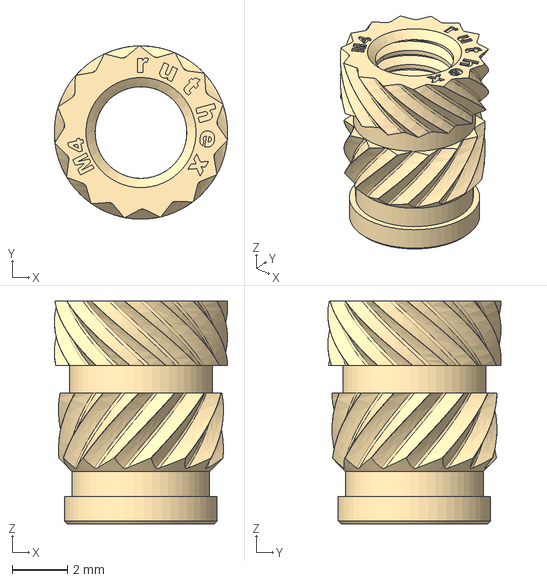
[picture p287: CAD file, 2021-10-26]
Chassis/Mounting/ruthex+Step-Data+threaded+inserts+M2-M8/files/ruthex_RX-M4x8.1.step
6.30 x 6.30 x 8.10 mm
