unlegitGurke/RC-Car/Electronics/Akku/Cell Cage/holder 21 hf.SLDPRT

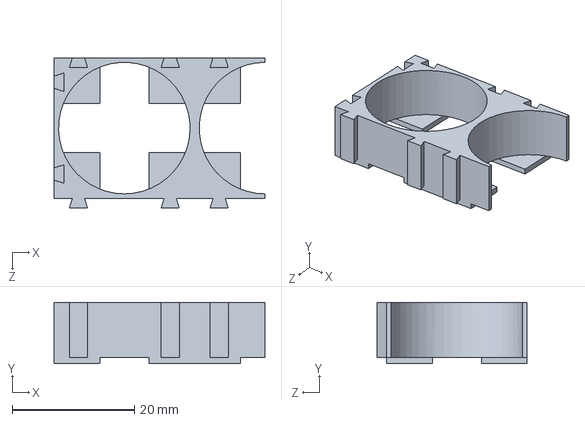
[picture p288: CAD file, 2022-01-23]
Electronics/Akku/Cell Cage/holder 21 hf.SLDPRT
34.5 x 10.0 x 24.6 mm
