unlegitGurke/RC-Car/Electronics/Buck Converter/LM2596 DC to DC Buck Converter 3 A/lm2596board.SLDPRT

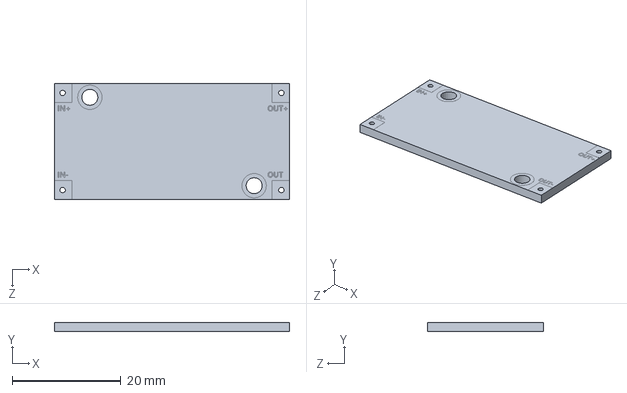
[picture p289: CAD file, 2021-02-09]
Electronics/Buck Converter/LM2596 DC to DC Buck Converter 3 A/lm2596board.SLDPRT
43.2 x 1.71 x 21.2 mm
