unlegitGurke/RC-Car/Electronics/jst-ph-2-00mm-connector-set-1.snapshot.63/JST - PH - SMD - Right - 1.25mm/JST - PH - SMD (R) - 4Pin - 2.00mm.stp

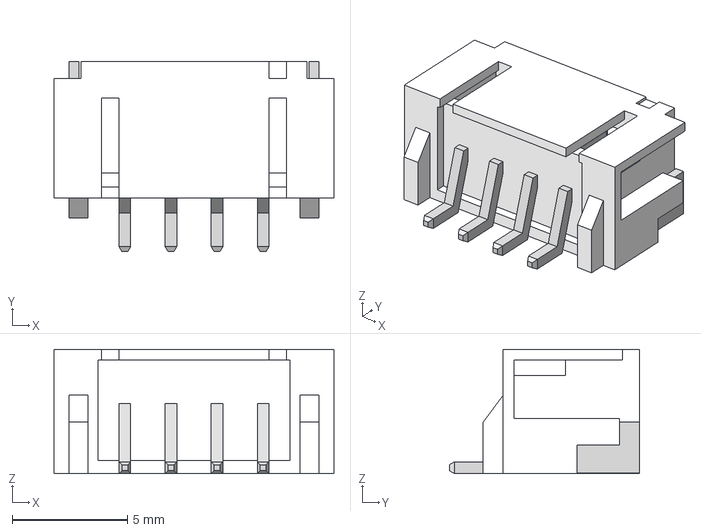
[picture p290: CAD file, 2022-01-05]
Electronics/jst-ph-2-00mm-connector-set-1.snapshot.63/JST - PH - SMD - Right - 1.25mm/JST - PH - SMD (R) - 4Pin - 2.00mm.stp
12.1 x 8.26 x 5.38 mm
