unlegitGurke/RC-Car/Electronics/jst-xh-2-54mm-generic-connector-set-1.snapshot.31/SMD Horizontal/JST - XH - SMD (R) - 2Pin - 2.54mm.stp

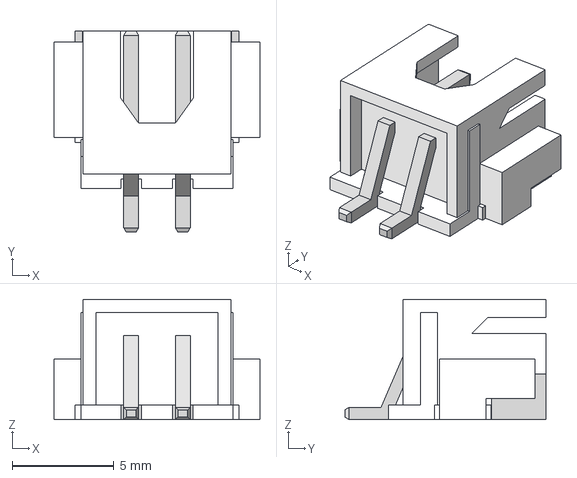
[picture p292: CAD file, 2022-01-05]
Electronics/jst-xh-2-54mm-generic-connector-set-1.snapshot.31/SMD Horizontal/JST - XH - SMD (R) - 2Pin - 2.54mm.stp
10.1 x 9.91 x 5.92 mm
