unlegitGurke/RC-Car/Electronics/jst-xh-2-54mm-generic-connector-set-1.snapshot.31/Thru Horizontal/JST - XH - Thru (R) - 3Pin - 2.54mm.stp

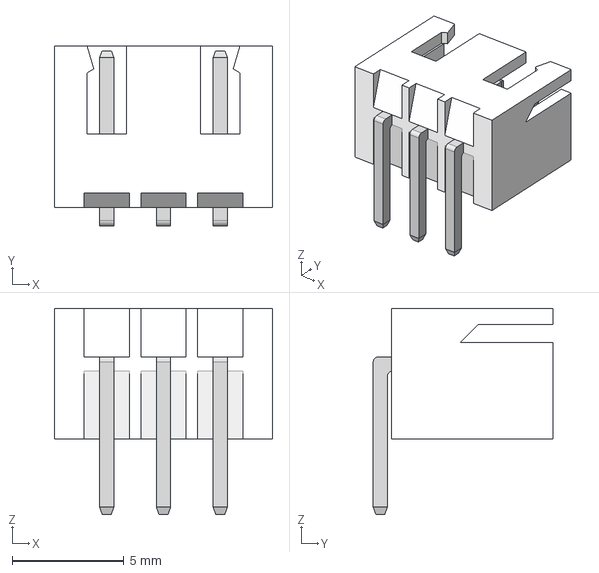
[picture p293: CAD file, 2022-01-05]
Electronics/jst-xh-2-54mm-generic-connector-set-1.snapshot.31/Thru Horizontal/JST - XH - Thru (R) - 3Pin - 2.54mm.stp
9.75 x 8.04 x 9.22 mm
