unlegitGurke/RC-Car/Electronics/jst-xh-2-54mm-generic-connector-set-1.snapshot.31/Thru Vertical/JST - XH - Thru (V) - 4Pin - 2.54mm.stp

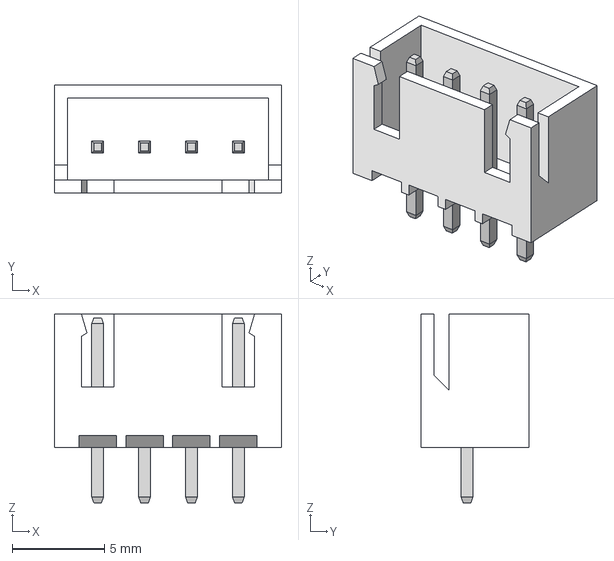
[picture p294: CAD file, 2022-01-05]
Electronics/jst-xh-2-54mm-generic-connector-set-1.snapshot.31/Thru Vertical/JST - XH - Thru (V) - 4Pin - 2.54mm.stp
12.3 x 5.84 x 10.2 mm
