unlegitGurke/RC-Car/Electronics/Raspberry Pi/Raspberry Pi 4 3D Model/2X USB3.0 PORTS, RPi4ModelB.SLDPRT

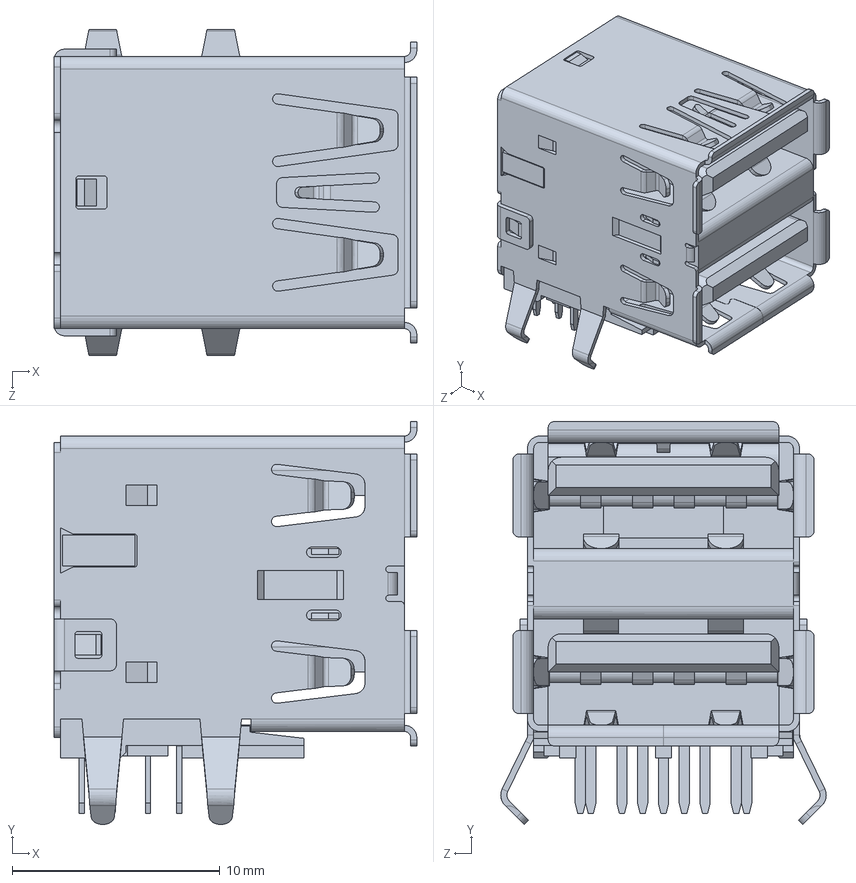
[picture p295: CAD file, 2021-02-07]
Electronics/Raspberry Pi/Raspberry Pi 4 3D Model/2X USB3.0 PORTS, RPi4ModelB.SLDPRT
17.5 x 19.4 x 15.7 mm
