unlegitGurke/RC-Car/Electronics/RaspberryPI_Shield/Connector Pi/models3d/PBD/PBD-26R.step

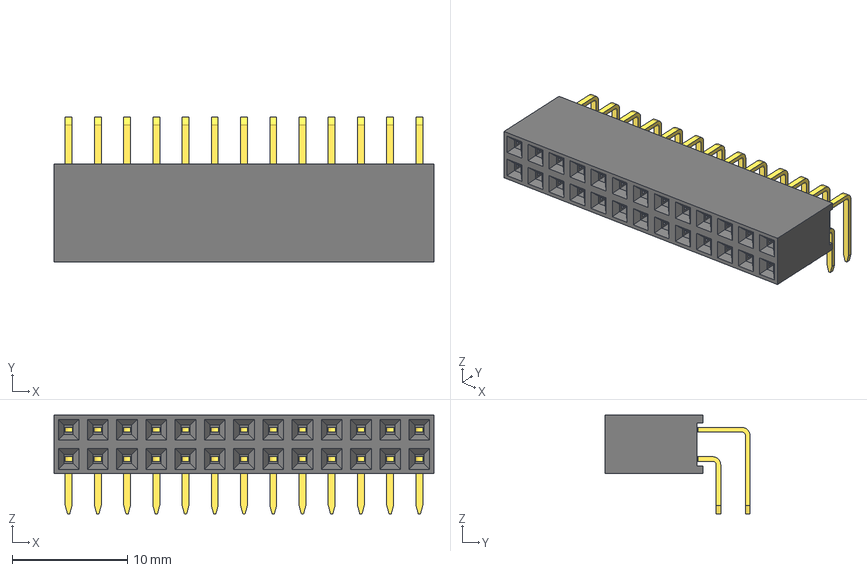
[picture p296: CAD file, 2021-04-19]
Electronics/RaspberryPI_Shield/Connector Pi/models3d/PBD/PBD-26R.step
33.0 x 12.6 x 8.58 mm
