unlegitGurke/RC-Car/Electronics/RaspberryPI_Shield/Connector Pi/models3d/PBS/PBS-15R.step

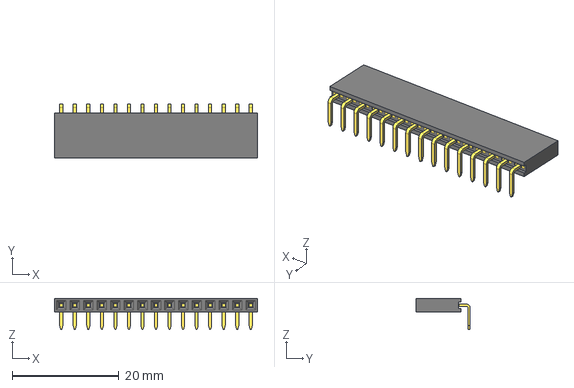
[picture p297: CAD file, 2021-04-19]
Electronics/RaspberryPI_Shield/Connector Pi/models3d/PBS/PBS-15R.step
38.1 x 10.2 x 5.84 mm
