unlegitGurke/RC-Car/Electronics/RaspberryPI_Shield/NEW_Shield/fan-header-4pin-2-54mm-1.snapshot.6/Fan Header/Fan Header, 4Pin, 2.54mm, Vertical.STEP

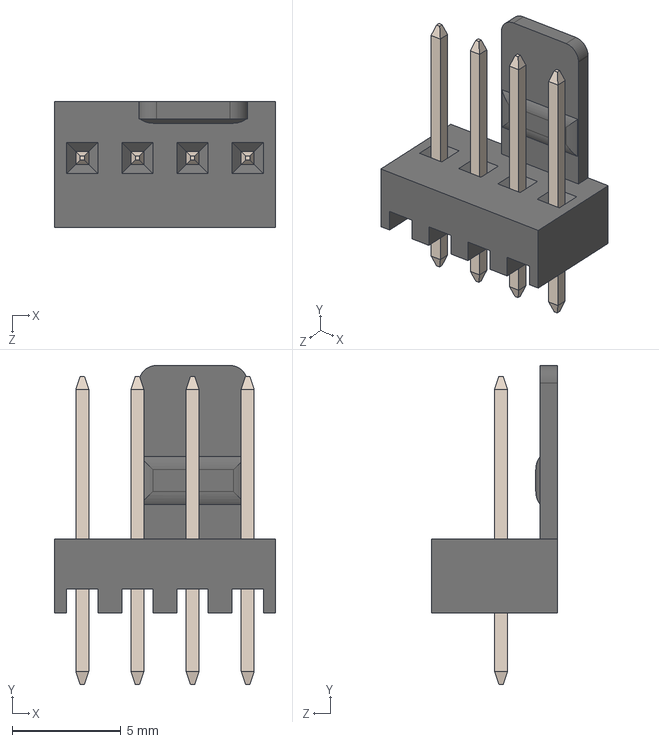
[picture p298: CAD file, 2021-12-27]
Electronics/RaspberryPI_Shield/NEW_Shield/fan-header-4pin-2-54mm-1.snapshot.6/Fan Header/Fan Header, 4Pin, 2.54mm, Vertical.STEP
10.2 x 14.7 x 5.80 mm
Fan Header 4Pin-Body
Fan Header-Pin Vertical x 4
