unlegitGurke/RC-Car/Exportierte Dateien/Aufhängung/3-teilige-Felge/Mitte.3mf

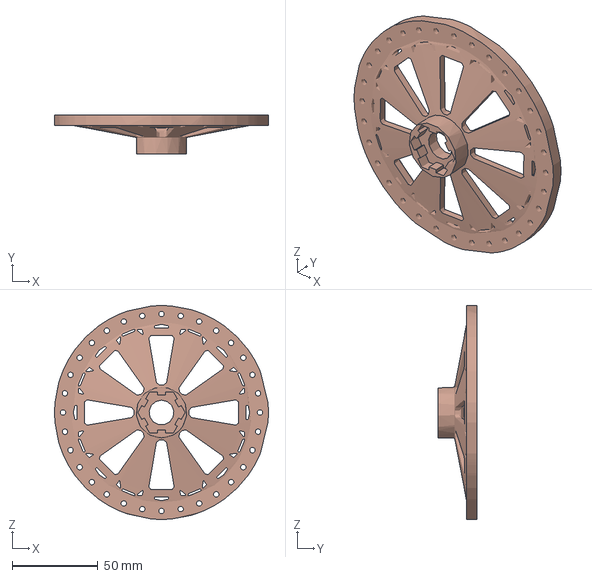
[picture p300: CAD file, 2021-10-25]
Exportierte Dateien/Aufhängung/3-teilige-Felge/Mitte.3mf
125.0 x 23.0 x 125.0 mm
