unlegitGurke/RC-Car/Exportierte Dateien/Body/Body 3d print/Body_vorne_mitte_Bambu.stp

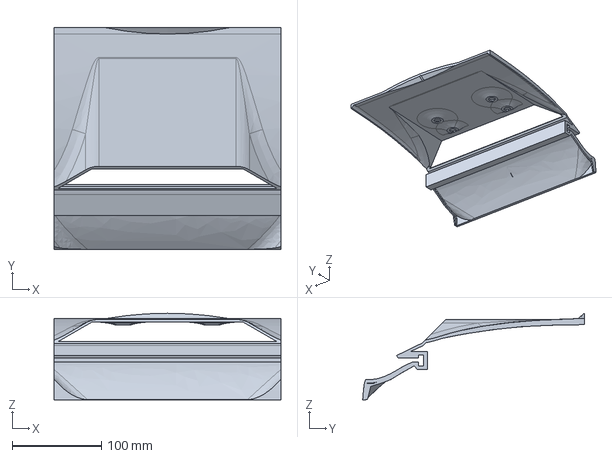
[picture p301: CAD file, 2024-03-08]
Exportierte Dateien/Body/Body 3d print/Body_vorne_mitte_Bambu.stp
255.0 x 249.0 x 97.2 mm
