unlegitGurke/RC-Car/Exportierte Dateien/Body/Body_Bambulab/Body_hinten_links_3row_print.stp

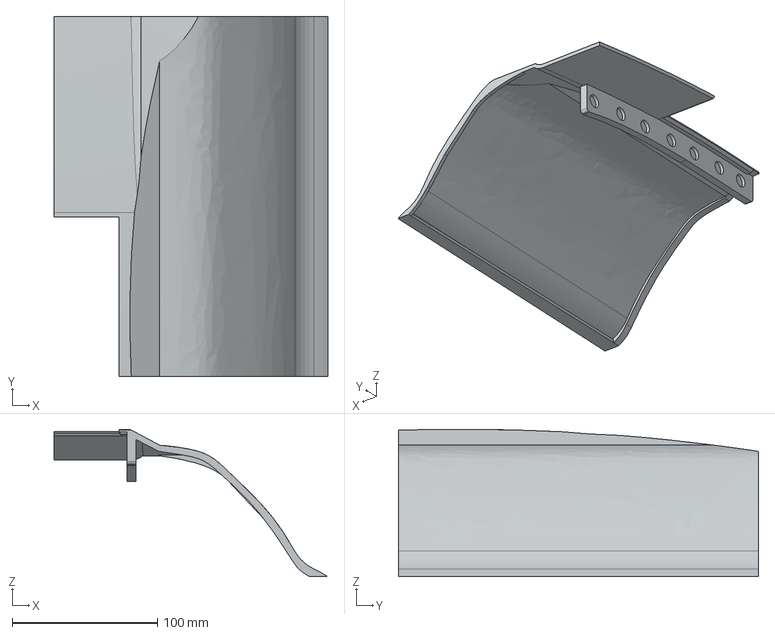
[picture p302: CAD file, 2024-05-13]
Exportierte Dateien/Body/Body_Bambulab/Body_hinten_links_3row_print.stp
188.5 x 248.0 x 101.5 mm
