unlegitGurke/RC-Car/Exportierte Dateien/Body/Bodymount_hinten_print/Bodymount_hinten_adapter/Adapter_2_2.stp

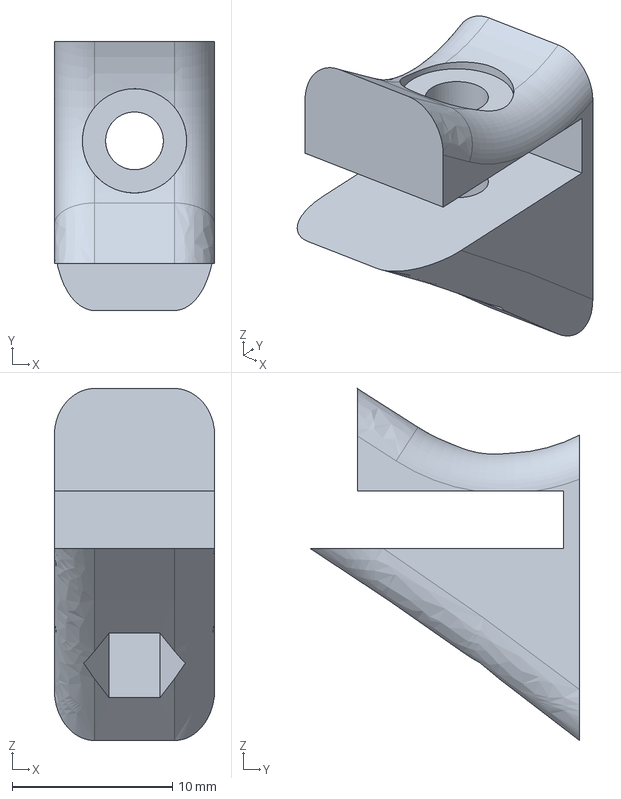
[picture p303: CAD file, 2024-02-23]
Exportierte Dateien/Body/Bodymount_hinten_print/Bodymount_hinten_adapter/Adapter_2_2.stp
10.0 x 16.8 x 21.9 mm
