unlegitGurke/RC-Car/Exportierte Dateien/Body/Bumper_front_2_3.stp

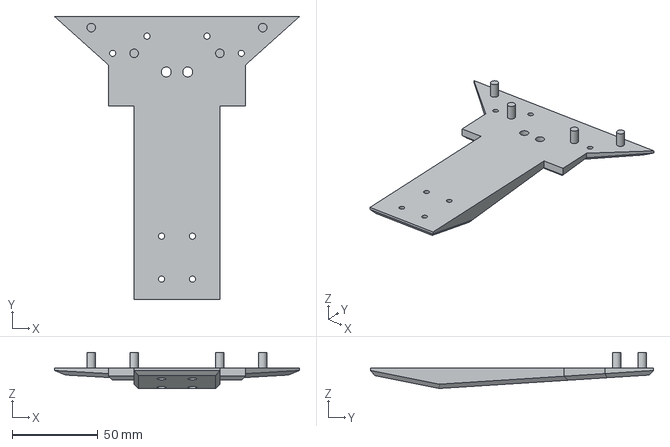
[picture p304: CAD file, 2024-03-13]
Exportierte Dateien/Body/Bumper_front_2_3.stp
142.9 x 165.0 x 21.0 mm
