unlegitGurke/RC-Car/Exportierte Dateien/Body/Kotflügel/Extreme_Kotflügel 2 gespiegelt.stp

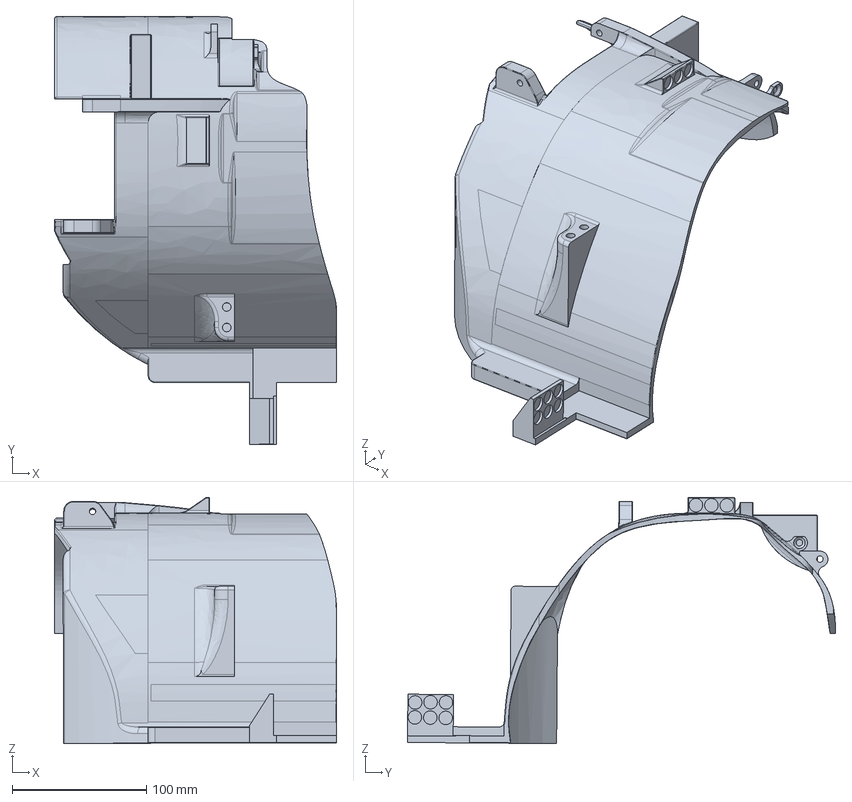
[picture p305: CAD file, 2024-02-26]
Exportierte Dateien/Body/Kotflügel/Extreme_Kotflügel 2 gespiegelt.stp
210.5 x 319.1 x 183.6 mm
