unlegitGurke/RC-Car/(list of files, cad)

Other CAD files:
Electronics/LattePanda_3_Delta/LattePanda-3D-Models-master/LattePanda-3D-Models-master/LattePanda Case related file/Official Case CAD/Acrylic Case/Acrylic_Main_01.dwg
Electronics/LattePanda_3_Delta/LattePanda-3D-Models-master/LattePanda-3D-Models-master/LattePanda Case related file/Official Case CAD/Plywood Case/Plywood_Main_02.dwg
Electronics/LattePanda_3_Delta/LattePanda-3D-Models-master/LattePanda-3D-Models-master/LattePanda Case related file/Official Case CAD/Acrylic Case/Acrylic_Main_02.dwg
Electronics/LattePanda_3_Delta/LattePanda-3D-Models-master/LattePanda-3D-Models-master/LattePanda Case related file/Official Case CAD/Plywood Case/Plywood_Main_01.dwg
Electronics/LattePanda_3_Delta/LattePanda-3D-Models-master/LattePanda-3D-Models-master/7-21-3.dwg
Electronics/LattePanda_3_Delta/LattePanda-3D-Models-master/LattePanda-3D-Models-master/Accessories/7 inches display/touch pane7inchl.dwg
Electronics/LattePanda_3_Delta/LattePanda-3D-Models-master/LattePanda-3D-Models-master/LattePanda Case related file/LattePandaCase_Fan by Dong.dwg
Electronics/LattePanda_3_Delta/LattePanda-3D-Models-master/LattePanda-3D-Models-master/Mechanical Distance/Mechanical Distance.dwg
Electronics/LattePanda_3_Delta/LattePanda-3D-Models-master/LattePanda-3D-Models-master/Mechanical Size/Mechanical Size.dwg
Electronics/LattePanda_3_Delta/LattePanda-3D-Models-master/LattePanda-3D-Models-master/Accessories/7 inches display/7inchdisplay .dwg
Exportierte Dateien/Buck Converter/Buck_converter_Adapter.3mf
Exportierte Dateien/Chassis/Mounting/Getriebe_Mount_V3/GetriebeMount_Vorne_Unten_mir.3mf
Exportierte Dateien/Electronics/Ultrasonic_Sensor/PcbMount.3mf
Getriebe/clutch/claw-clutch/SPRZĘGŁO KŁOWE GE-T 48-A 60-B Fi40.SLDPRT
Electronics/LattePanda_3_Delta/LattePanda-3D-Models-master/LattePanda-3D-Models-master/LattePanda Case related file/Official Case CAD/Plywood Case/Light Guide.dwg
Exportierte Dateien/Aufhängung/A-Arm_Mount_Hinten_Rechts.stp
Exportierte Dateien/Body/SensorMount/Sensor hinten_mir2.3mf
Chassis/Mounting/Chassis_Brace.psm
Chassis/Mounting/ruthex+Step-Data+threaded+inserts+M2-M8/files/RX-M2.5x5.7.step
Chassis/Mounting/ruthex+Step-Data+threaded+inserts+M2-M8/files/RX-M6x12.7.step
Chassis/Mounting/ruthex+Step-Data+threaded+inserts+M2-M8/files/ruthex_RX-M3x5.7.step
Chassis/Mounting/ruthex+Step-Data+threaded+inserts+M2-M8/files/ruthex_RX-M5x9.5.step
Drafts/Chassis/Grundplatte_V4.0.dxf
Drafts/Chassis/Grundplatte_V4.0.stl
Electronics/12mm_push_button/12mm_push_button.f3d
Electronics/4-pin-pwm-connector-1.snapshot.1/4-PIN-PWM-female.SLDPRT
Electronics/4pin-magnetic-pogo-connector-plug-female-1.snapshot.2/4pin_magnetic_connector_female v4.f3d
Electronics/4pin-magnetic-pogo-connector-plug-female-1.snapshot.2/4pin_magnetic_connector_male v5.f3d
Electronics/Akku/Cell Cage/holder 21.SLDPRT
Electronics/Akku/nf-a6x25-noctua-fan-60mm-1.snapshot.3/NF A6x25.f3d
Electronics/Buck Converter/LM2596 DC to DC Buck Converter 3 A.x_t
Electronics/Buck Converter/LM2596 DC to DC Buck Converter 3 A/IC Cooler.SLDPRT
Electronics/Buck Converter/LM2596 DC to DC Buck Converter 3 A/LM2596S.SLDPRT
Electronics/Buck Converter/LM2596 DC to DC Buck Converter 3 A/TrimmerW203.SLDPRT
Electronics/Buck Converter/LM2596 DC to DC Buck Converter 3 A/smbInductor470.SLDPRT
Electronics/Buck Converter/LM2596 DC to DC Buck Converter 3 A/smd100uF.SLDPRT
Electronics/Buck Converter/LM2596 DC to DC Buck Converter 3 A/smd220uF.SLDPRT
Electronics/Buck Converter/LM2596 DC to DC Buck Converter 3 A/smdLED.SLDPRT
Electronics/Buck Converter/LM2596 DC to DC Buck Converter 3 A/smdResistor102.SLDPRT
Electronics/Buck Converter/LM2596 DC to DC Buck Converter 3 A/smdResistor331.SLDPRT
Electronics/Buck Converter/LM2596 DC to DC Buck Converter 3 A/smdS537diode.SLDPRT
Electronics/Buck Converter/LM2596 DC to DC Buck Converter 3 A/smdceramiccapacitor.SLDPRT
Electronics/Buck Converter/dc-dc-buck-converter-step-down-15-90vdc-in-out-12vdc-20a-1.snapshot.1/FULREE DC-DC CONVERTER 15-90V IN 12V 20A OUT.SLDPRT
Electronics/Buck Converter/dc-dc-buck-converter-step-down-15-90vdc-in-out-12vdc-20a-1.snapshot.1/FULREE DC-DC CONVERTER 15-90V IN 12V 20A OUT.STL
Electronics/ESC/FSESC75200/fsesc75200-1.snapshot.6/FSESC75200 v7.step
Electronics/LED/WS2812B Black 60leds_m v7.f3d
Electronics/LED/WS2812B Black 60leds_m v7.iges
Electronics/LattePanda_3_Delta/LatteCase/bottom.3mf
Electronics/LattePanda_3_Delta/LatteCase/bottom.stl
Electronics/Raspberry Pi/Raspberry Pi 4 3D Model/2X USB2.0 PORTS, RPi4ModelB.SLDPRT
Electronics/Raspberry Pi/Raspberry Pi 4 3D Model/Broadcom BCM54213PE Gigabit Ethernet Transceiver, RPi4ModelB.SLDPRT
Electronics/Raspberry Pi/Raspberry Pi 4 3D Model/Cypress CYW43455 Wireless Module Cover, RPi4ModelB.SLDPRT
Electronics/Raspberry Pi/Raspberry Pi 4 3D Model/Female Micro HDMI Connector, RPi4ModelB.SLDPRT
Electronics/Raspberry Pi/Raspberry Pi 4 3D Model/Female USB Type C Connector, RPi4ModelB.SLDPRT
Electronics/Raspberry Pi/Raspberry Pi 4 3D Model/Microphone Plug, RPi4ModelB.SLDPRT
Electronics/Raspberry Pi/Raspberry Pi 4 3D Model/VIA VL805 PCIe USB 3.0 controller, RPi4ModelB.SLDPRT
Electronics/RaspberryPI_Shield/Connector Pi/models3d/PBD/PBD-10.step
Electronics/RaspberryPI_Shield/Connector Pi/models3d/PBD/PBD-10R.step
Electronics/RaspberryPI_Shield/Connector Pi/models3d/PBD/PBD-12.step
Electronics/RaspberryPI_Shield/Connector Pi/models3d/PBD/PBD-12R.step
Electronics/RaspberryPI_Shield/Connector Pi/models3d/PBD/PBD-14.step
Electronics/RaspberryPI_Shield/Connector Pi/models3d/PBD/PBD-14R.step
Electronics/RaspberryPI_Shield/Connector Pi/models3d/PBD/PBD-16.step
Electronics/RaspberryPI_Shield/Connector Pi/models3d/PBD/PBD-16R.step
Electronics/RaspberryPI_Shield/Connector Pi/models3d/PBD/PBD-18.step
Electronics/RaspberryPI_Shield/Connector Pi/models3d/PBD/PBD-18R.step
Electronics/RaspberryPI_Shield/Connector Pi/models3d/PBD/PBD-2.step
Electronics/RaspberryPI_Shield/Connector Pi/models3d/PBD/PBD-20.step
Electronics/RaspberryPI_Shield/Connector Pi/models3d/PBD/PBD-20R.step
Electronics/RaspberryPI_Shield/Connector Pi/models3d/PBD/PBD-22R.step
Electronics/RaspberryPI_Shield/Connector Pi/models3d/PBD/PBD-24.step
Electronics/RaspberryPI_Shield/Connector Pi/models3d/PBD/PBD-24R.step
Electronics/RaspberryPI_Shield/Connector Pi/models3d/PBD/PBD-26.step
Electronics/RaspberryPI_Shield/Connector Pi/models3d/PBD/PBD-28.step
Electronics/RaspberryPI_Shield/Connector Pi/models3d/PBD/PBD-28R.step
Electronics/RaspberryPI_Shield/Connector Pi/models3d/PBD/PBD-2R.step
Electronics/RaspberryPI_Shield/Connector Pi/models3d/PBD/PBD-30.step
Electronics/RaspberryPI_Shield/Connector Pi/models3d/PBD/PBD-30R.step
Electronics/RaspberryPI_Shield/Connector Pi/models3d/PBD/PBD-32.step
Electronics/RaspberryPI_Shield/Connector Pi/models3d/PBD/PBD-32R.step
Electronics/RaspberryPI_Shield/Connector Pi/models3d/PBD/PBD-34.step
Electronics/RaspberryPI_Shield/Connector Pi/models3d/PBD/PBD-34R.step
Electronics/RaspberryPI_Shield/Connector Pi/models3d/PBD/PBD-36.step
Electronics/RaspberryPI_Shield/Connector Pi/models3d/PBD/PBD-36R.step
Electronics/RaspberryPI_Shield/Connector Pi/models3d/PBD/PBD-38.step
Electronics/RaspberryPI_Shield/Connector Pi/models3d/PBD/PBD-38R.step
Electronics/RaspberryPI_Shield/Connector Pi/models3d/PBD/PBD-4.step
Electronics/RaspberryPI_Shield/Connector Pi/models3d/PBD/PBD-40.step
Electronics/RaspberryPI_Shield/Connector Pi/models3d/PBD/PBD-40R.step
Electronics/RaspberryPI_Shield/Connector Pi/models3d/PBD/PBD-44.step
Electronics/RaspberryPI_Shield/Connector Pi/models3d/PBD/PBD-4R.step
Electronics/RaspberryPI_Shield/Connector Pi/models3d/PBD/PBD-6.step
Electronics/RaspberryPI_Shield/Connector Pi/models3d/PBD/PBD-6R.step
Electronics/RaspberryPI_Shield/Connector Pi/models3d/PBD/PBD-8.step
Electronics/RaspberryPI_Shield/Connector Pi/models3d/PBD/PBD-8R.step
Electronics/RaspberryPI_Shield/Connector Pi/models3d/PBS/PBS-1.step
Electronics/RaspberryPI_Shield/Connector Pi/models3d/PBS/PBS-10.step
Electronics/RaspberryPI_Shield/Connector Pi/models3d/PBS/PBS-10R.step
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
