unlegitGurke/RC-Car/Chassis/Mounting/ruthex+Step-Data+threaded+inserts+M2-M8/README.txt

ruthex Step-Data threaded inserts M2-M8 by ruthex on Thingiverse: https://www.thingiverse.com/thing:4682424
