unlegitGurke/RC-Car/Chassis/Mounting/ruthex+Step-Data+threaded+inserts+M2-M8/images/Anleitung_Gewindeeinsatz.jpg

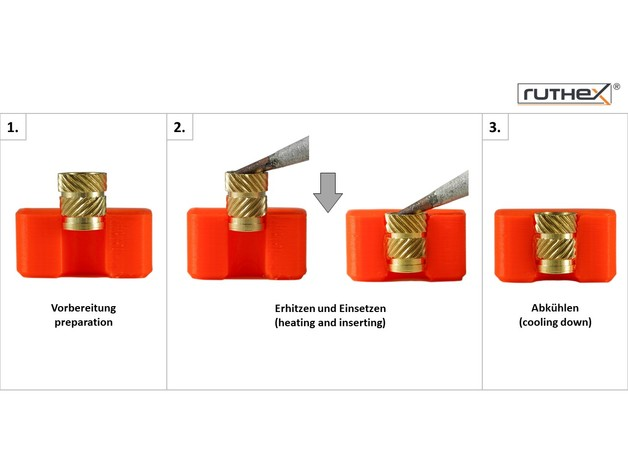
Chassis/Mounting/ruthex+Step-Data+threaded+inserts+M2-M8/images/Anleitung_Gewindeeinsatz.jpg
