unlegitGurke/RC-Car/Chassis/Mounting/ruthex+Step-Data+threaded+inserts+M2-M8/images/Benefit_Gewindeeinsatz_k_.jpg

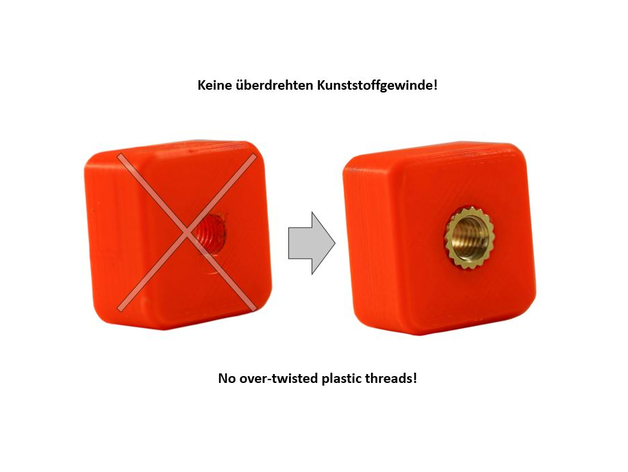
Chassis/Mounting/ruthex+Step-Data+threaded+inserts+M2-M8/images/Benefit_Gewindeeinsatz_k_.jpg
