unlegitGurke/RC-Car/Chassis/Mounting/ruthex+Step-Data+threaded+inserts+M2-M8/images/Gewindeeinsatz.JPG

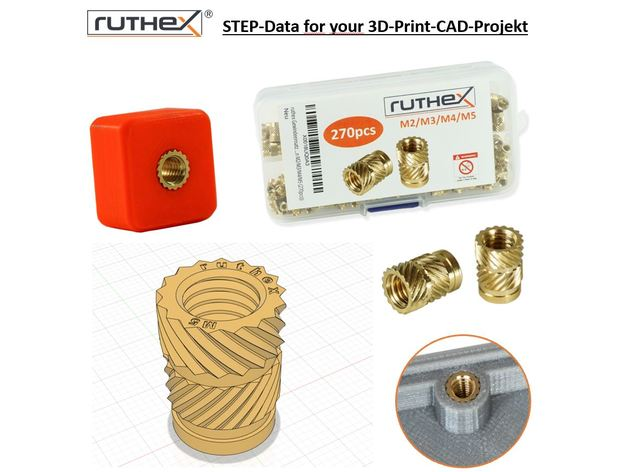
Chassis/Mounting/ruthex+Step-Data+threaded+inserts+M2-M8/images/Gewindeeinsatz.JPG
