unlegitGurke/RC-Car/Chassis/Mounting/ruthex+Step-Data+threaded+inserts+M2-M8/images/ruthex_RX-M5-9.5.png

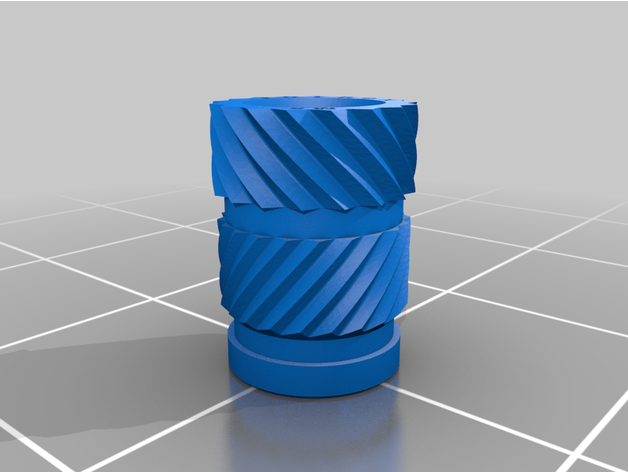
Chassis/Mounting/ruthex+Step-Data+threaded+inserts+M2-M8/images/ruthex_RX-M5-9.5.png
