unlegitGurke/RC-Car/Diplomarbeit/Athena/4_Mechanik/Abbildungen/Aufbau_Anleitung_render/Athena_fertig_1.jpg

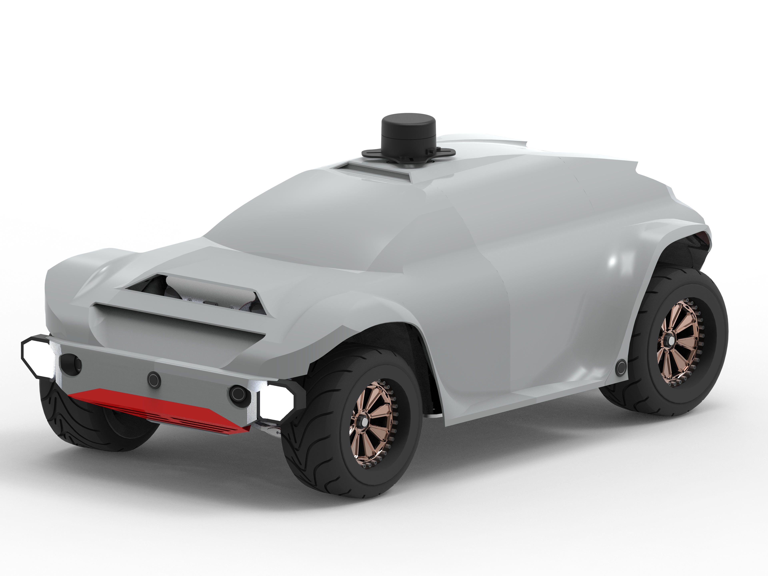
Diplomarbeit/Athena/4_Mechanik/Abbildungen/Aufbau_Anleitung_render/Athena_fertig_1.jpg
