unlegitGurke/RC-Car/Diplomarbeit/Athena/4_Mechanik/Abbildungen/Aufbau_Anleitung_render/Elektronik3.52.jpg

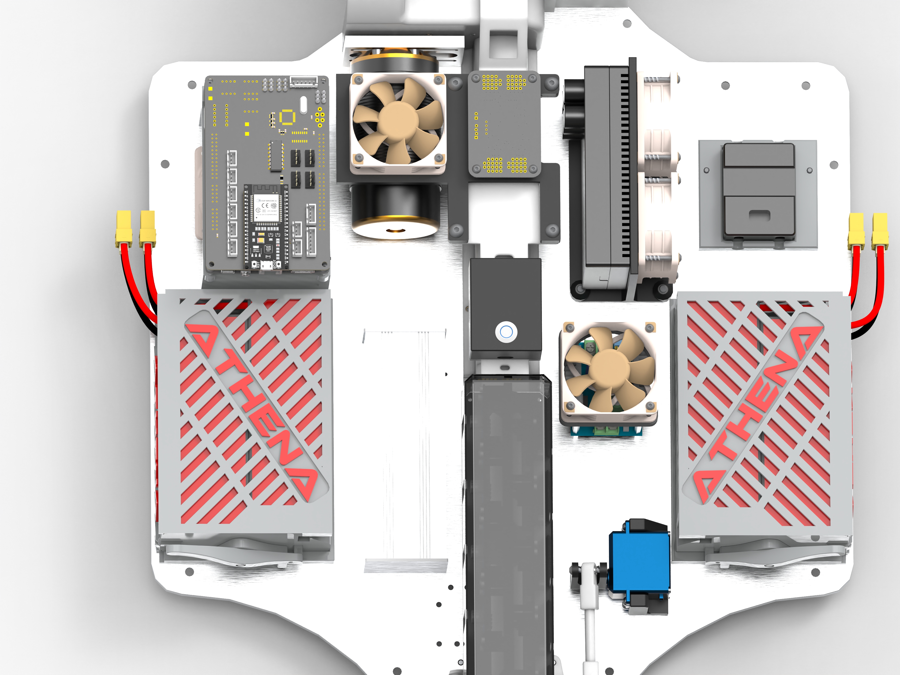
Diplomarbeit/Athena/4_Mechanik/Abbildungen/Aufbau_Anleitung_render/Elektronik3.52.jpg
