unlegitGurke/RC-Car/Diplomarbeit/Athena/4_Mechanik/Abbildungen/Aufbau_Anleitung_render/Motor.46.jpg

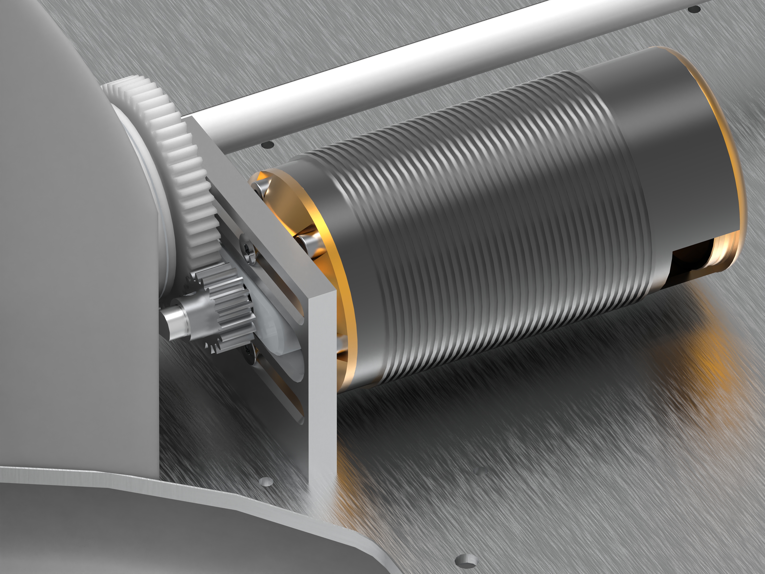
Diplomarbeit/Athena/4_Mechanik/Abbildungen/Aufbau_Anleitung_render/Motor.46.jpg
