unlegitGurke/RC-Car/Chassis/Code/Python/tf-obj-detection-test/images_leg/6.png

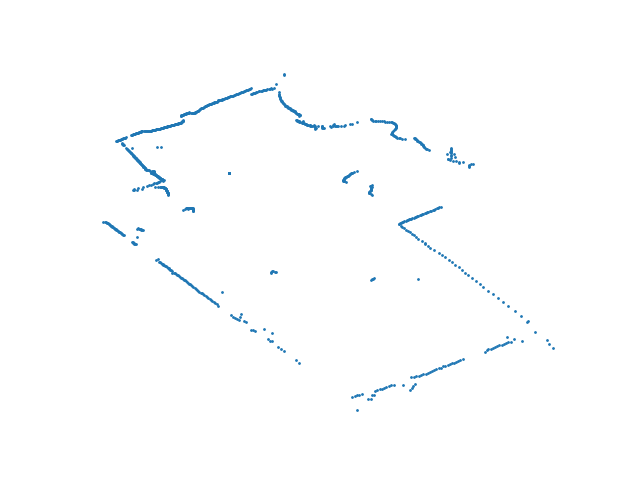
Chassis/Code/Python/tf-obj-detection-test/images_leg/6.png
