unlegitGurke/RC-Car/Chassis/Code/Python/tf-obj-detection-test/images_leg/10.png

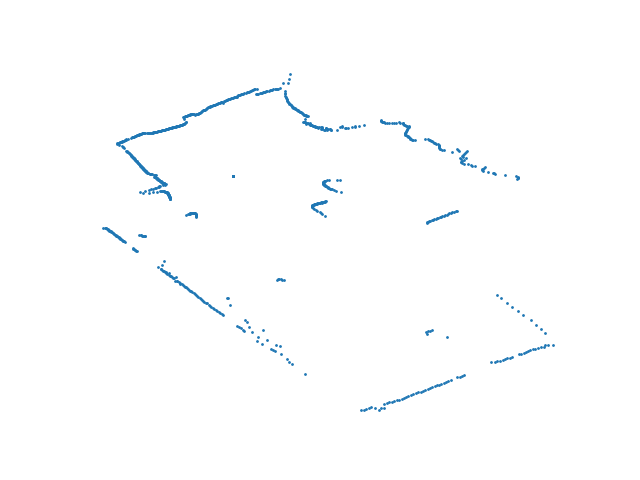
Chassis/Code/Python/tf-obj-detection-test/images_leg/10.png
