unlegitGurke/RC-Car/Chassis/Code/Python/tf-obj-detection-test/images_leg/image_11.png

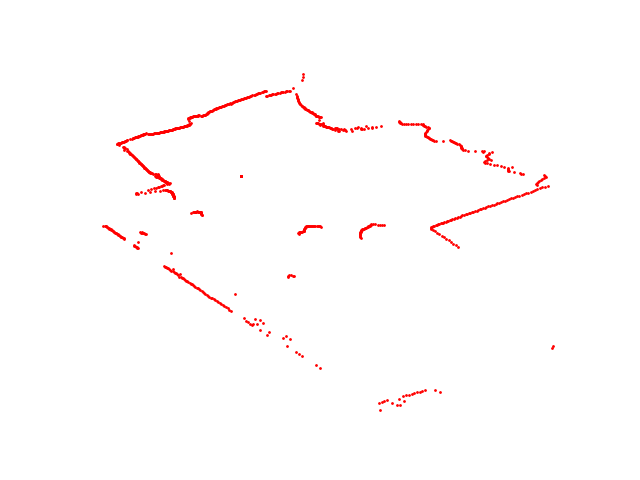
Chassis/Code/Python/tf-obj-detection-test/images_leg/image_11.png
