unlegitGurke/RC-Car/Chassis/Code/Python/training data/images_leg/validate/1.png

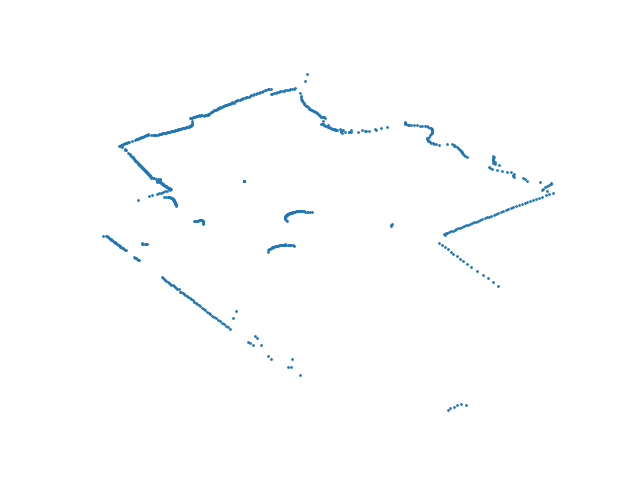
Chassis/Code/Python/training data/images_leg/validate/1.png
