unlegitGurke/RC-Car/Chassis/Code/Python/training data/images_leg/validate/image_20.png

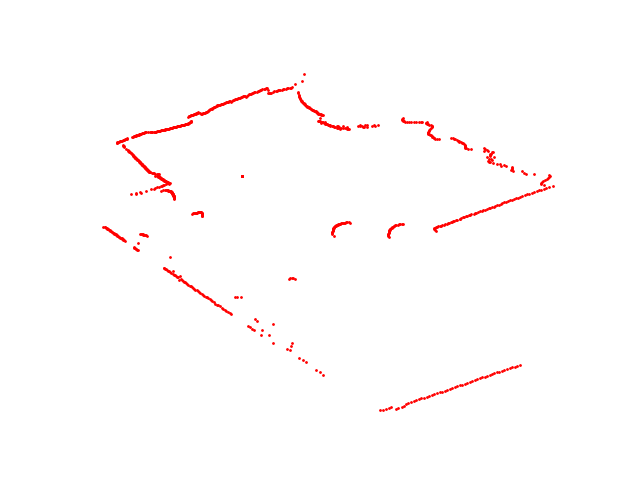
Chassis/Code/Python/training data/images_leg/validate/image_20.png
