unlegitGurke/RC-Car/Code/Python/tf-obj-detection-test/images_leg/image_10.png

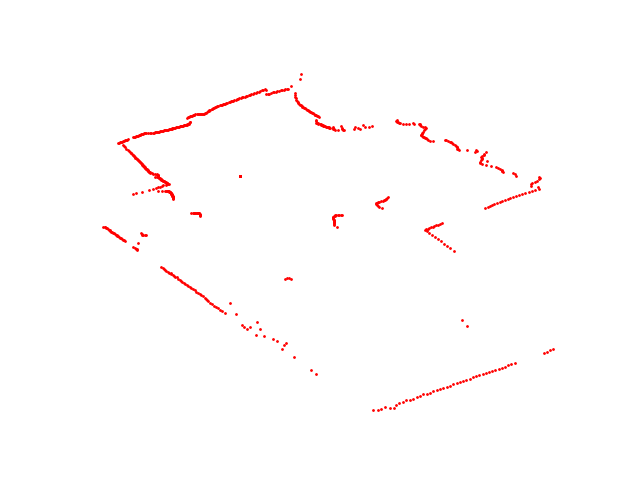
Code/Python/tf-obj-detection-test/images_leg/image_10.png
