unlegitGurke/RC-Car/Code/Python/training data/images_leg/validate/5.png

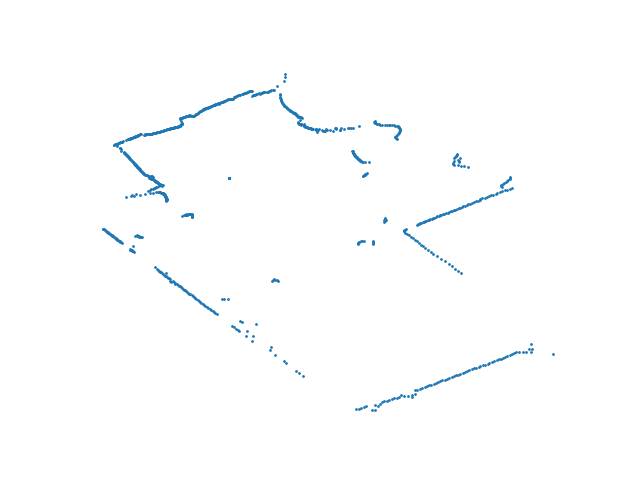
Code/Python/training data/images_leg/validate/5.png
