unlegitGurke/RC-Car/Drafts/Chassis/Grundplatte.pdf

B B

A A

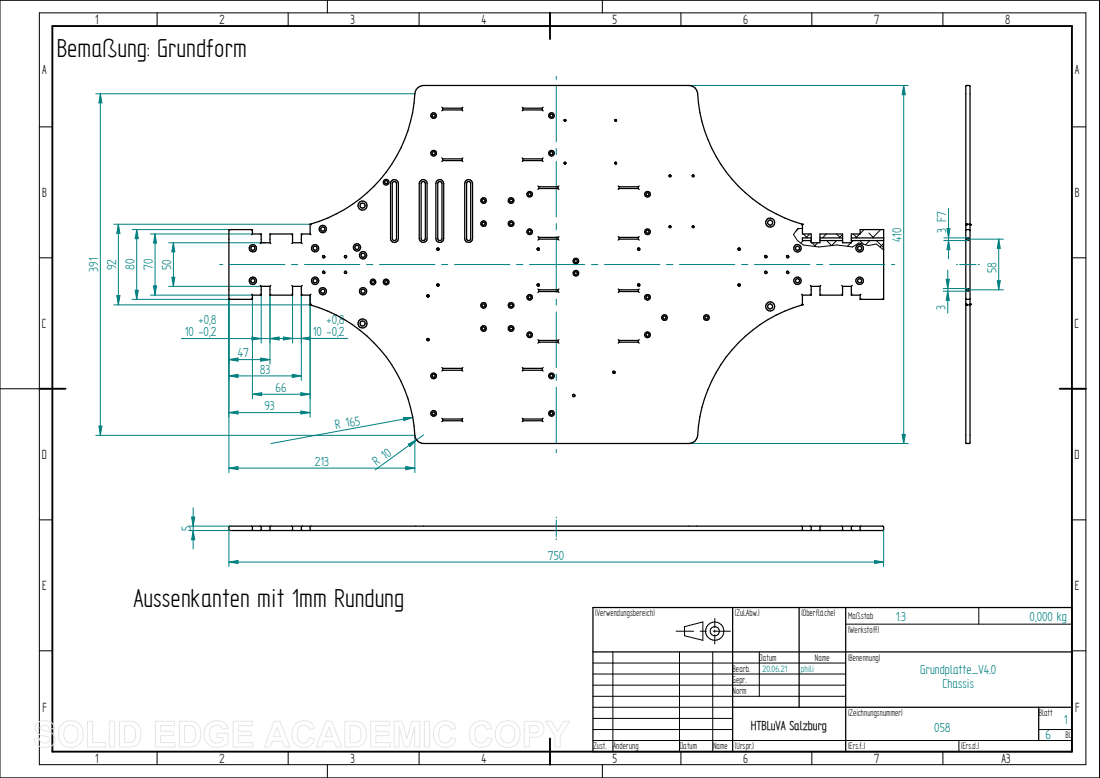
[picture p426: page 1]
Maßstab; Blatt; (Zeichnungsnummer); 0,000 kg ⁽Zul.Abw.); (Oberfläche); (Werkstoff); (Verwendungsbereich); HTBLuVA Salzburg; 213 R 10 ³⁹¹; Bemaßung: Grundform; Aussenkanten mit 1mm Rundung

Datum | Name | (Benennung) Grundplatte_V4.0 Chassis
Bearb. | 20.06.21 phili
Gepr.
Norm

Zust. | Änderung | Datum | Name | (Urspr.) | (Ers.f.:) | (Ers.d.:)

B B

A A

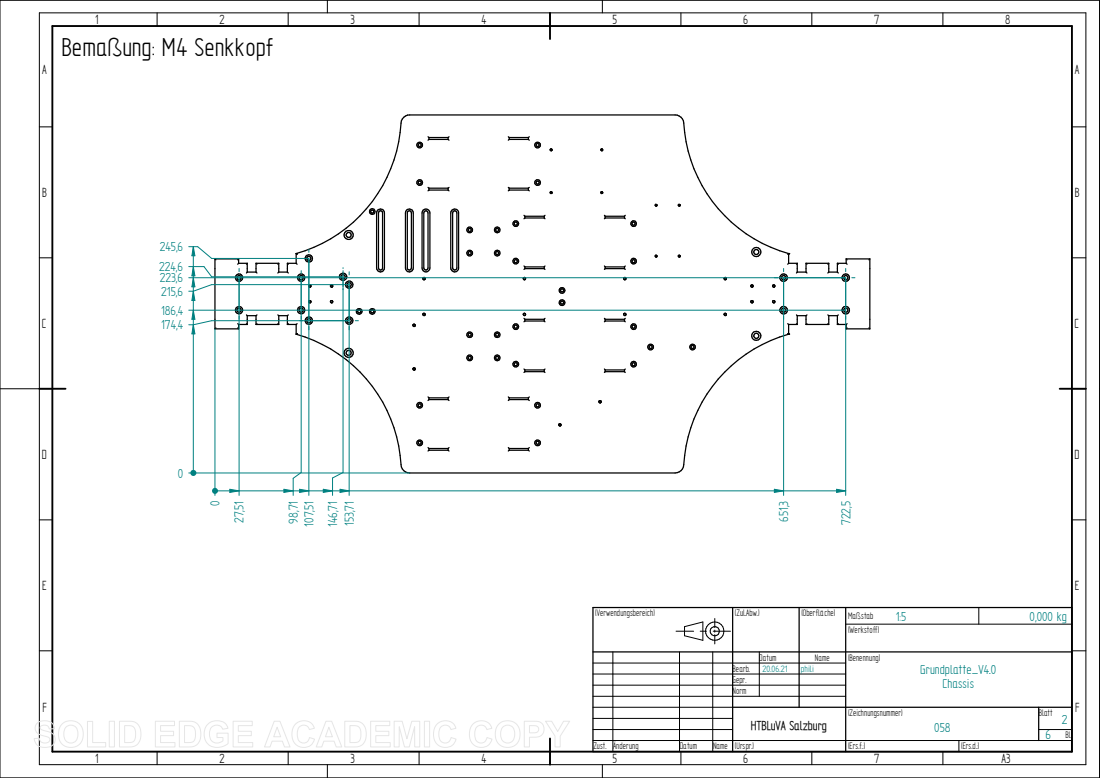
[picture p427: page 2]
Maßstab; Blatt; (Zeichnungsnummer); 0,000 kg ⁽Zul.Abw.); (Oberfläche); (Werkstoff); (Verwendungsbereich); Bemaßung: M4 Senkkopf

Datum | Name | (Benennung) Grundplatte_V4.0 Chassis
Bearb. | 20.06.21 phili
Gepr.
Norm

B B

A A

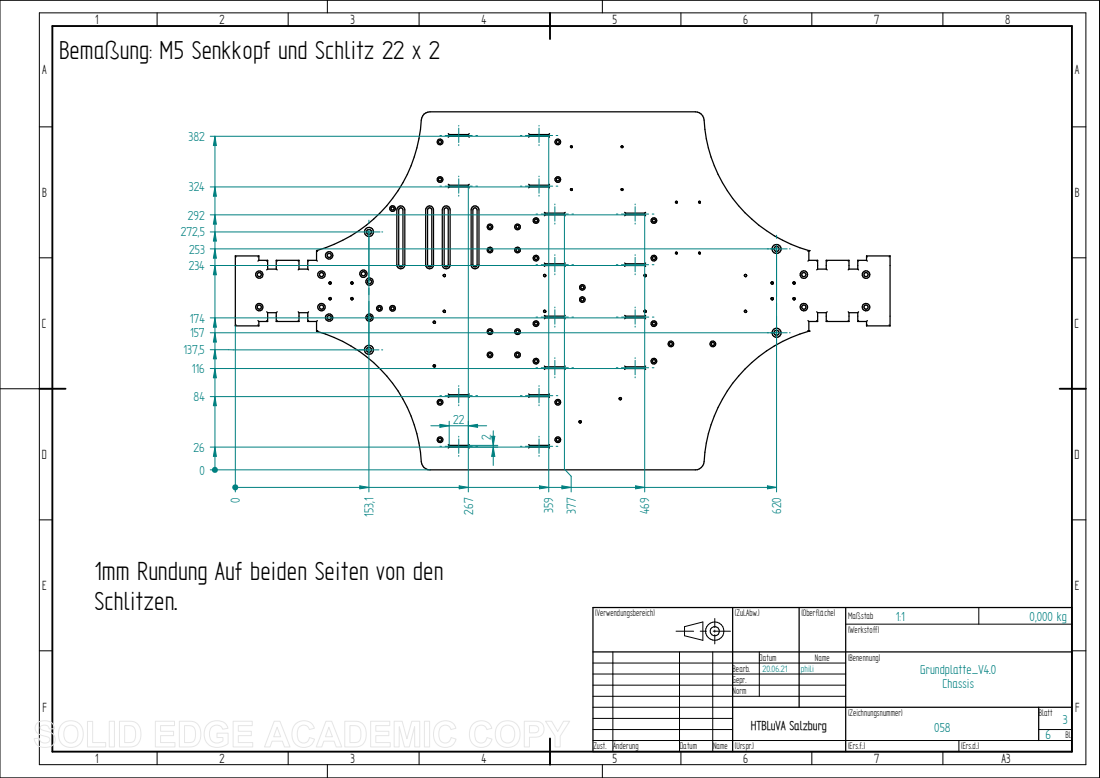
[picture p428: page 3]
Maßstab; Blatt; (Zeichnungsnummer); 0,000 kg ⁽Zul.Abw.); (Oberfläche); (Werkstoff); (Verwendungsbereich); Bemaßung: M5 Senkkopf und Schlitz 22 x 2 267

1mm Rundung Auf beiden Seiten von den
Schlitzen.

Datum | Name | (Benennung) Grundplatte_V4.0 Chassis
Bearb. | 20.06.21 phili
Gepr.
Norm

B B

A A

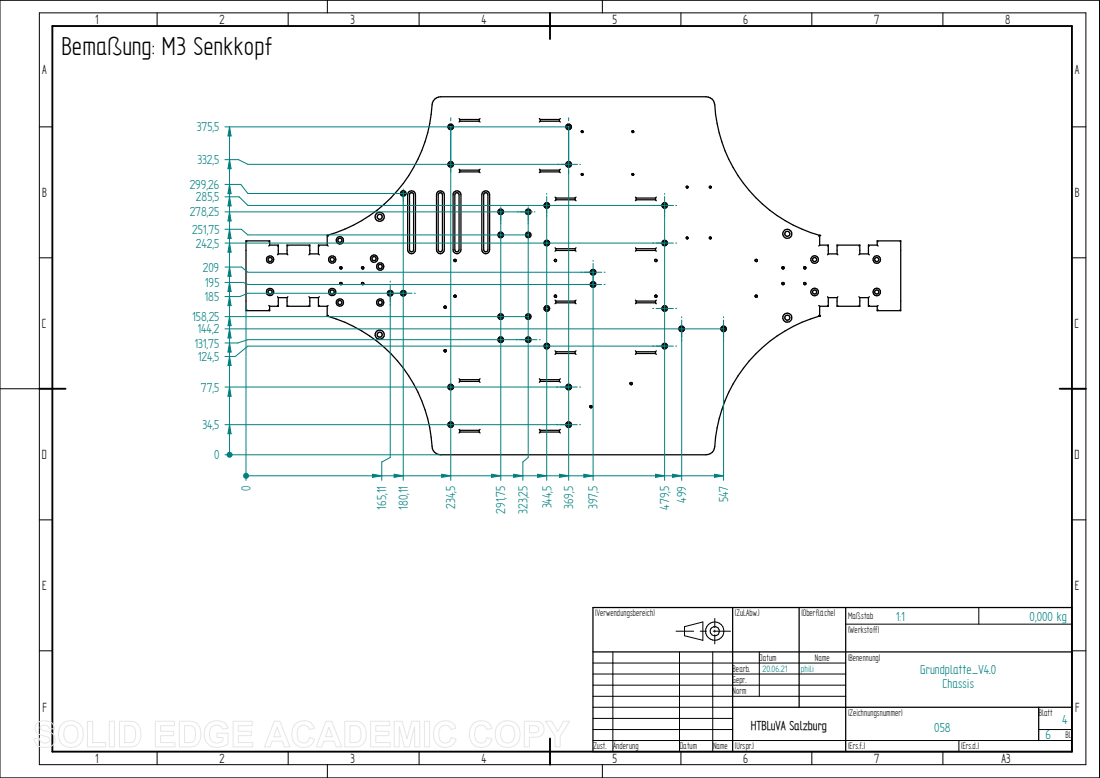
[picture p429: page 4]
Maßstab; Blatt; (Zeichnungsnummer); 0,000 kg ⁽Zul.Abw.); (Oberfläche); (Werkstoff); (Verwendungsbereich); Bemaßung: M3 Senkkopf

Datum | Name | (Benennung) Grundplatte_V4.0 Chassis
Bearb. | 20.06.21 phili
Gepr.
Norm

B B

A A

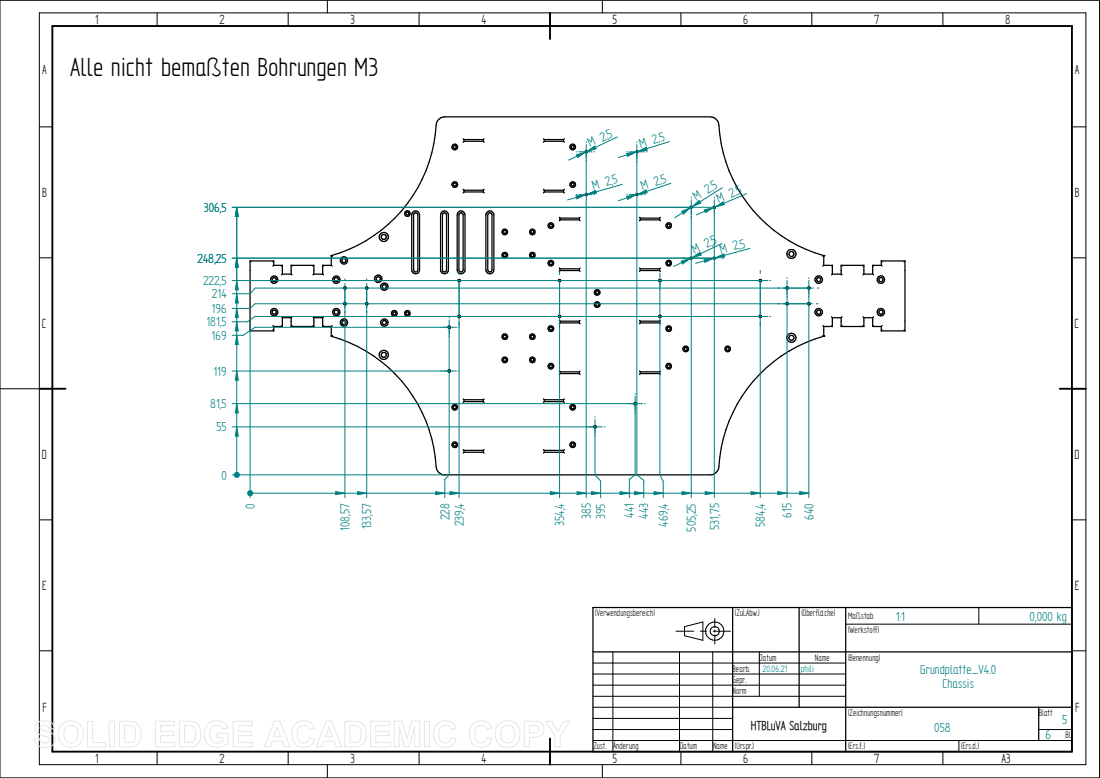
[picture p430: page 5]
Maßstab; Blatt; (Zeichnungsnummer); 0,000 kg ⁽Zul.Abw.); (Oberfläche); (Werkstoff); (Verwendungsbereich)

Alle nicht bemaßten Bohrungen M3

Datum | Name | (Benennung) Grundplatte_V4.0 Chassis
Bearb. | 20.06.21 phili
Gepr.
Norm

B B

A A

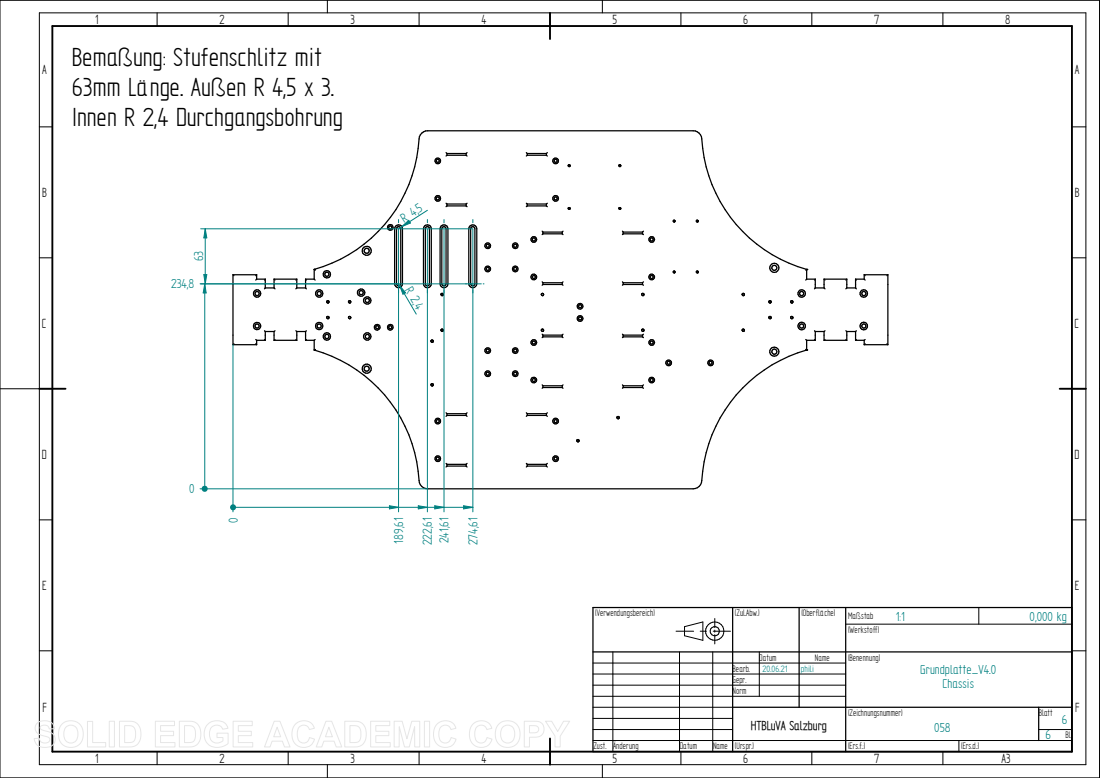
[picture p431: page 6]
Maßstab; Blatt; (Zeichnungsnummer); 0,000 kg ⁽Zul.Abw.); (Oberfläche); (Werkstoff); (Verwendungsbereich)

Bemaßung: Stufenschlitz mit
63mm Länge. Außen R 4,5 x 3.
Innen R 2,4 Durchgangsbohrung

HTBLuVA Salzburg ⁶³

Datum | Name | (Benennung) Grundplatte_V4.0 Chassis
Bearb. | 20.06.21 phili
Gepr.
Norm
