unlegitGurke/RC-Car/Exportierte Dateien/Electronics/Motor/Motor_mount_vorne_2.pdf

B

A

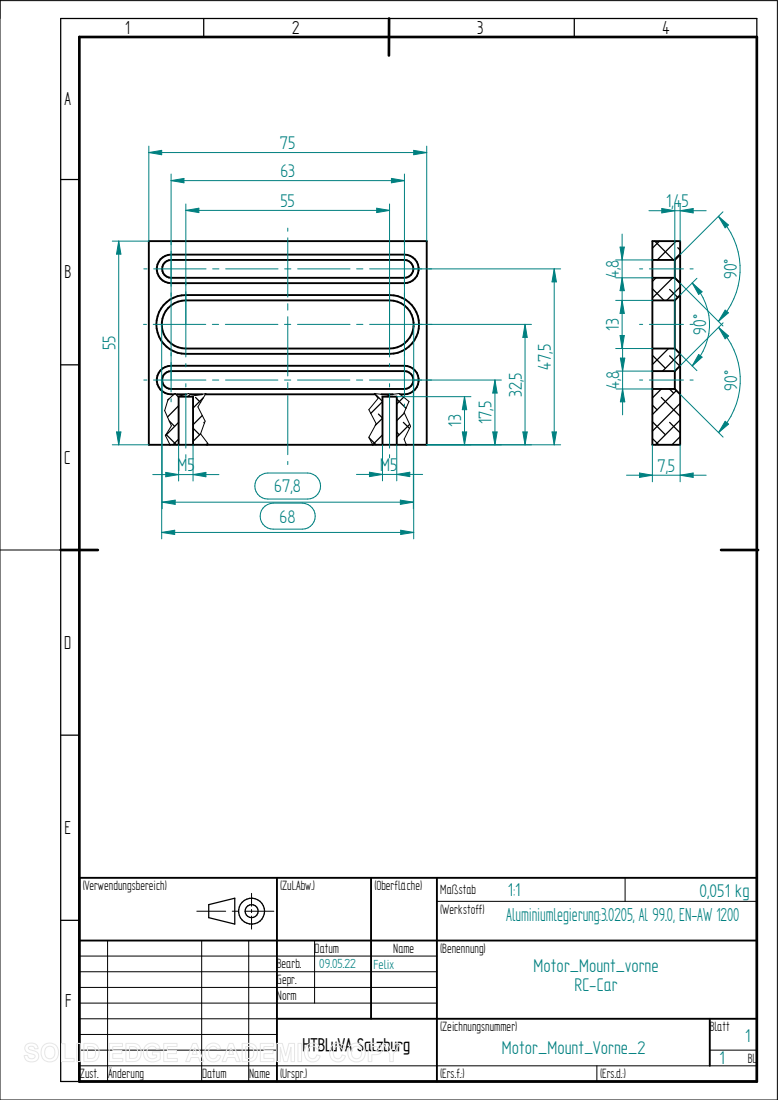
[picture p432: page 1]
Maßstab; Blatt; (Zeichnungsnummer); Motor_Mount_Vorne_2; 0,051 kg ⁽Zul.Abw.); (Oberfläche); (Werkstoff); (Urspr.); (Ers.f.:); (Ers.d.:); (Verwendungsbereich); Zust.; Änderung; Datum; Name; HTBLuVA Salzburg

Aluminiumlegierung:3.0205, Al 99.0, EN-AW 1200

Datum | Name | (Benennung) Motor_Mount_vorne RC-Car
Bearb. | 09.05.22 Felix
Gepr.
Norm
