unlegitGurke/RC-Car/Exportierte Dateien/Chassis/Mounting/Chassis_Brace_Fertigung.pdf

B B

A A

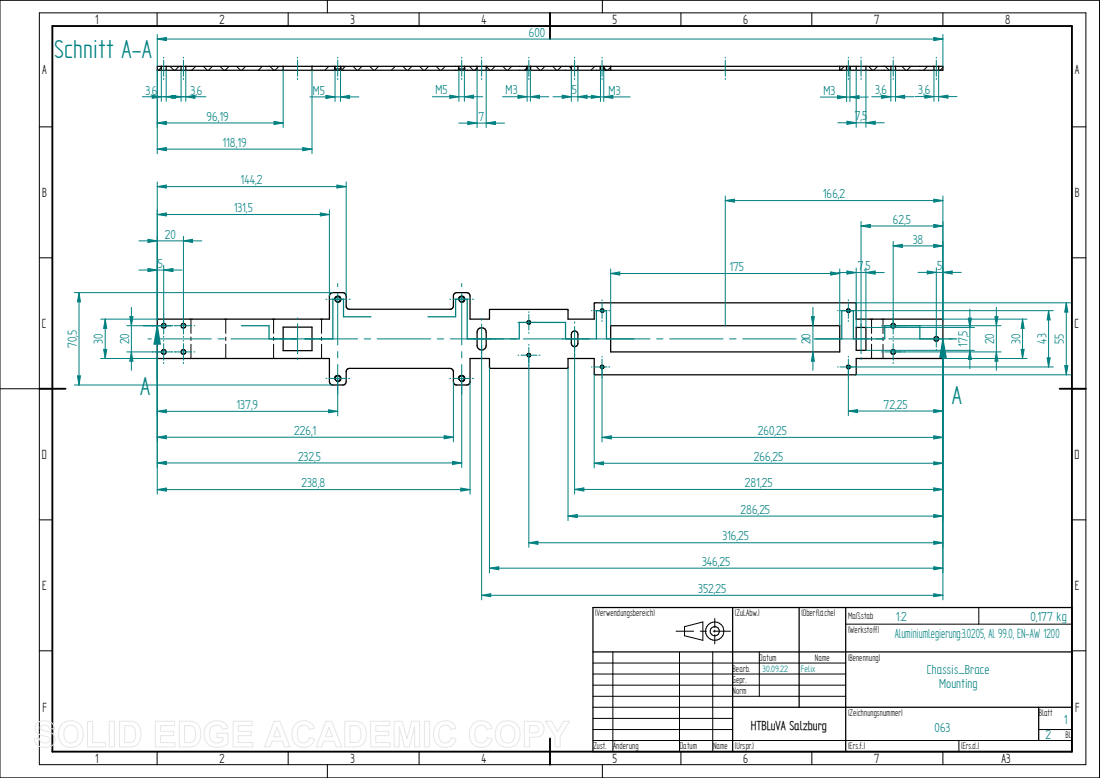
[picture p433: page 1]
Blatt; (Zeichnungsnummer); 0,177 kg ⁽Zul.Abw.); (Oberfläche); (Urspr.); (Ers.f.:); (Ers.d.:); (Verwendungsbereich); Zust.; Änderung; Datum; Name; HTBLuVA Salzburg ³⁰; Schnitt A-A

Maßstab
(Werkstoff)
Aluminiumlegierung:3.0205, Al 99.0, EN-AW 1200

Datum | Name | (Benennung) Chassis_Brace Mounting
Bearb. | 30.09.22 Felix
Gepr.
Norm

B B

A A

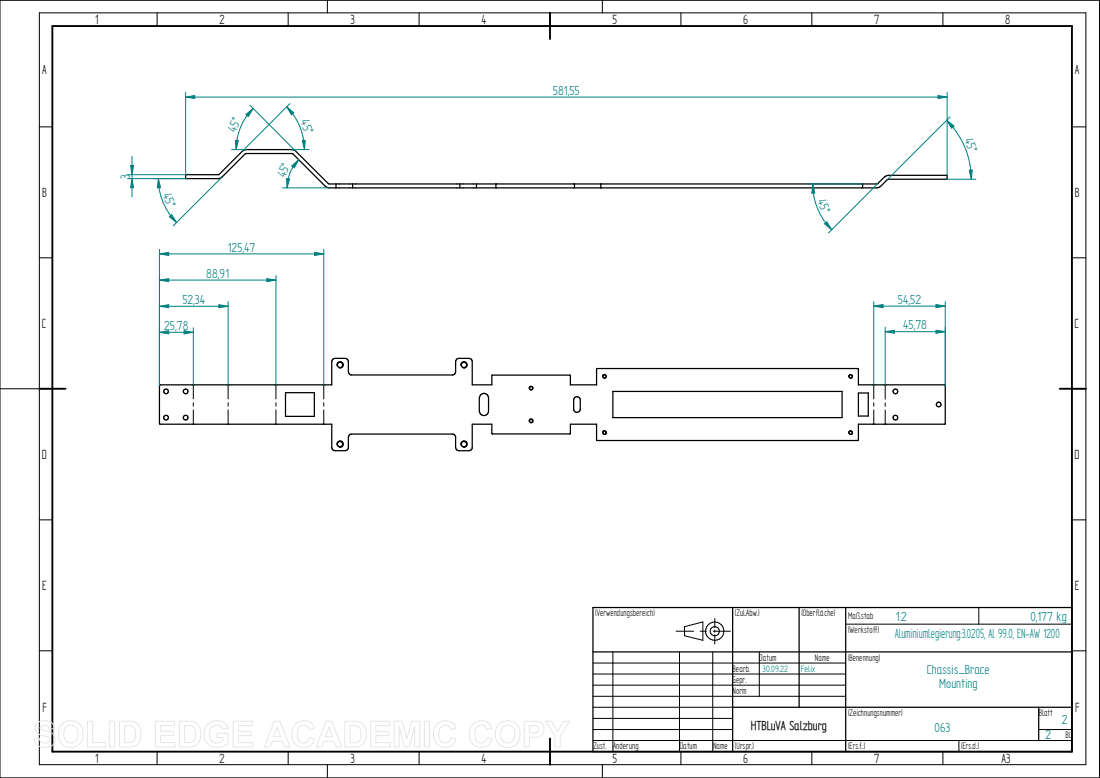
[picture p434: page 2]
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

Maßstab
(Werkstoff)
Aluminiumlegierung:3.0205, Al 99.0, EN-AW 1200

Datum | Name | (Benennung) Chassis_Brace Mounting
Bearb. | 30.09.22 Felix
Gepr.
Norm
