unlegitGurke/RC-Car/Drafts/Aufhängung/Abdeckplatte_Hinten2_1_1.pdf

B

A

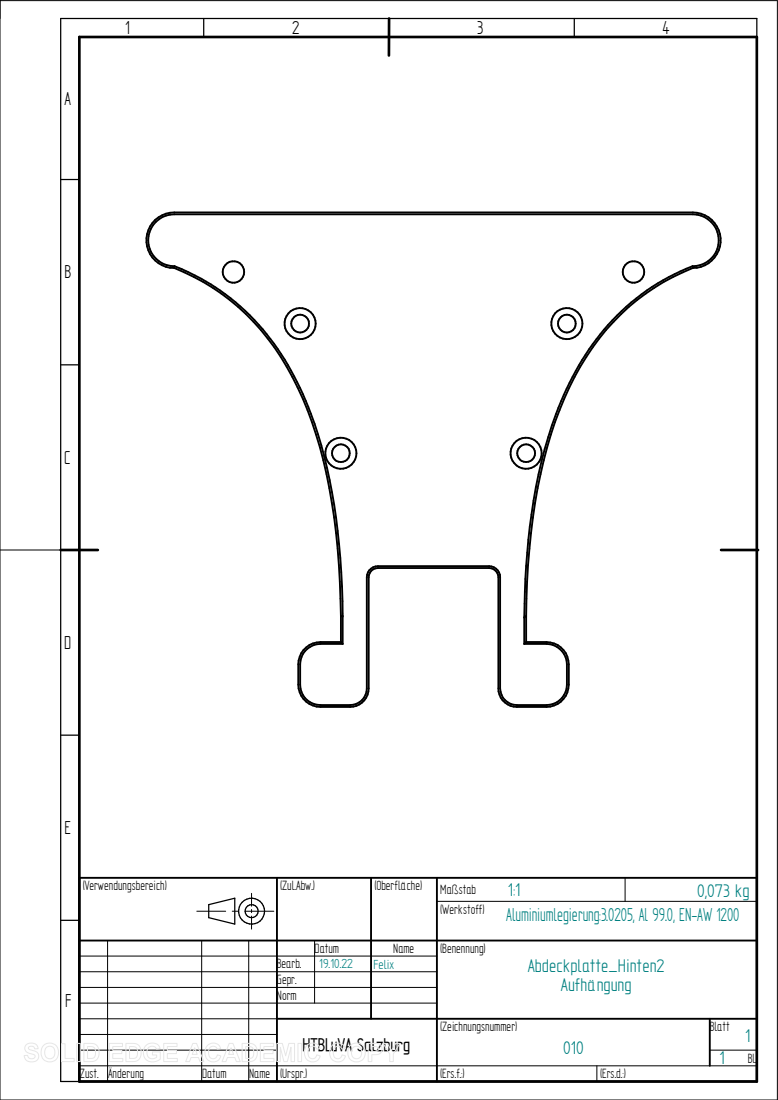
[picture p435: page 1]
Maßstab; Blatt; (Zeichnungsnummer); 0,073 kg ⁽Zul.Abw.); (Oberfläche); (Werkstoff); (Urspr.); (Ers.f.:); (Ers.d.:); (Verwendungsbereich); Zust.; Änderung; Datum; Name; HTBLuVA Salzburg

Aluminiumlegierung:3.0205, Al 99.0, EN-AW 1200

Datum | Name | (Benennung) Abdeckplatte_Hinten2 Aufhängung
Bearb. | 19.10.22 Felix
Gepr.
Norm
