unlegitGurke/RC-Car/Exportierte Dateien/Aufhängung/Abdeckplatte_Hinten1.pdf

B

A

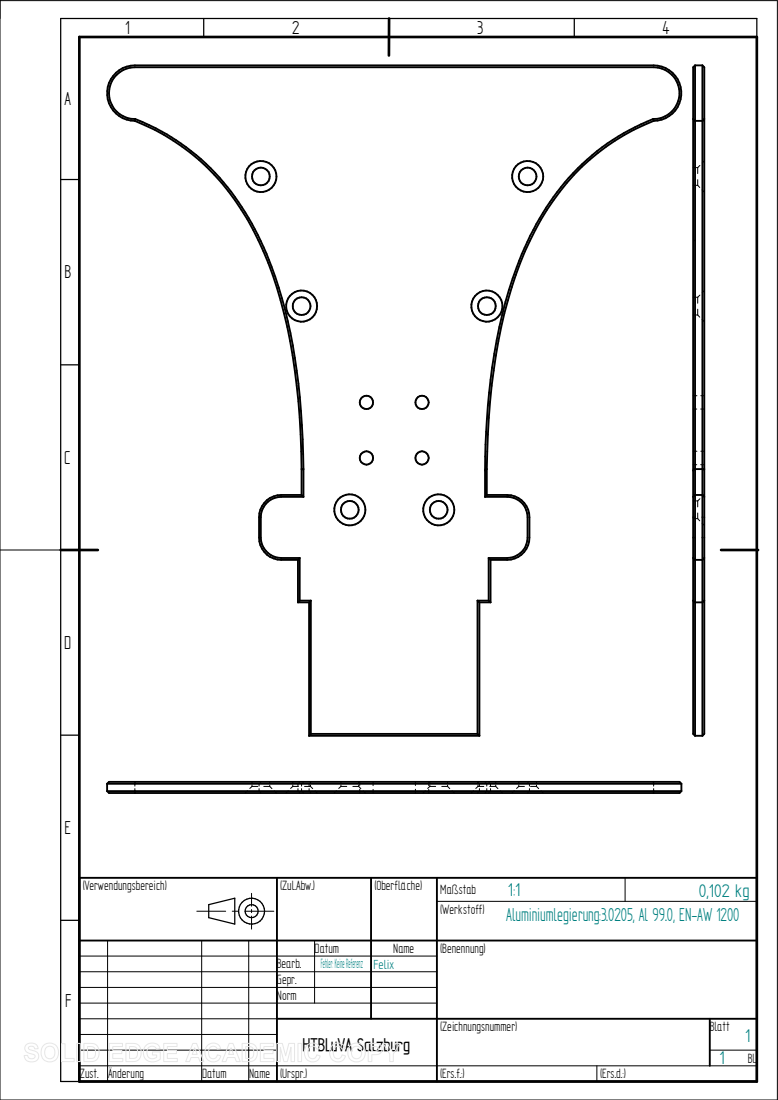
[picture p436: page 1]
Maßstab; Blatt; (Zeichnungsnummer); 0,102 kg ⁽Zul.Abw.); (Oberfläche); (Werkstoff); (Urspr.); (Ers.f.:); (Ers.d.:); (Verwendungsbereich); Zust.; Änderung; Datum; Name; HTBLuVA Salzburg

Aluminiumlegierung:3.0205, Al 99.0, EN-AW 1200

Datum | Name | (Benennung)
Bearb. | Fehler: Keine Referenz | Felix
Gepr.
Norm
