unlegitGurke/RC-Car/Exportierte Dateien/Aufhängung/Feder_Mount_Final.pdf

B B

A A

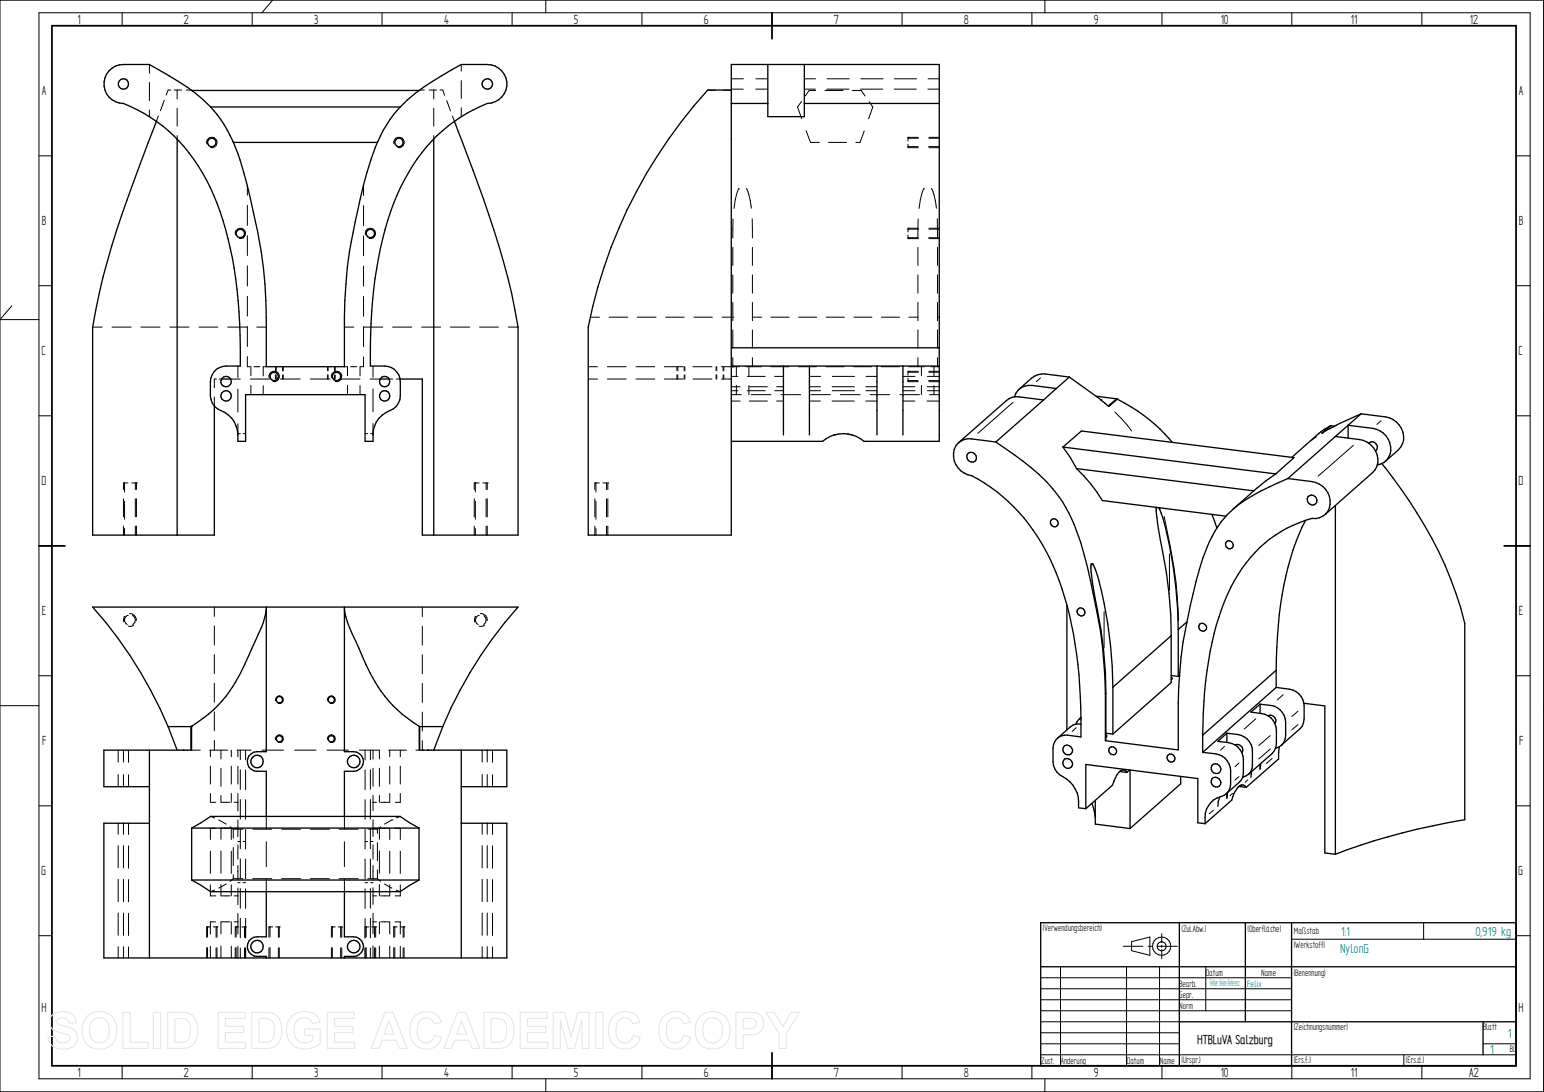
[picture p437: page 1]
Bearb.; Datum; Name Gepr. Norm; 0,919 kg ⁽Zul.Abw.); (Oberfläche); (Werkstoff) (Urspr.); (Ers.f.:); (Ers.d.:); NylonG Zust.; Änderung; Name

(Verwendungsbereich)

Maßstab Blatt Bl. (Benennung) 1 Fehler: Keine Referenz

Felix

HTBLuVA Salzburg | (Zeichnungsnummer)
