unlegitGurke/RC-Car/Diplomarbeit/Athena/9_Anhang/Bemassung/PDF/30_AbdeckungDrive_2.pdf

B

A

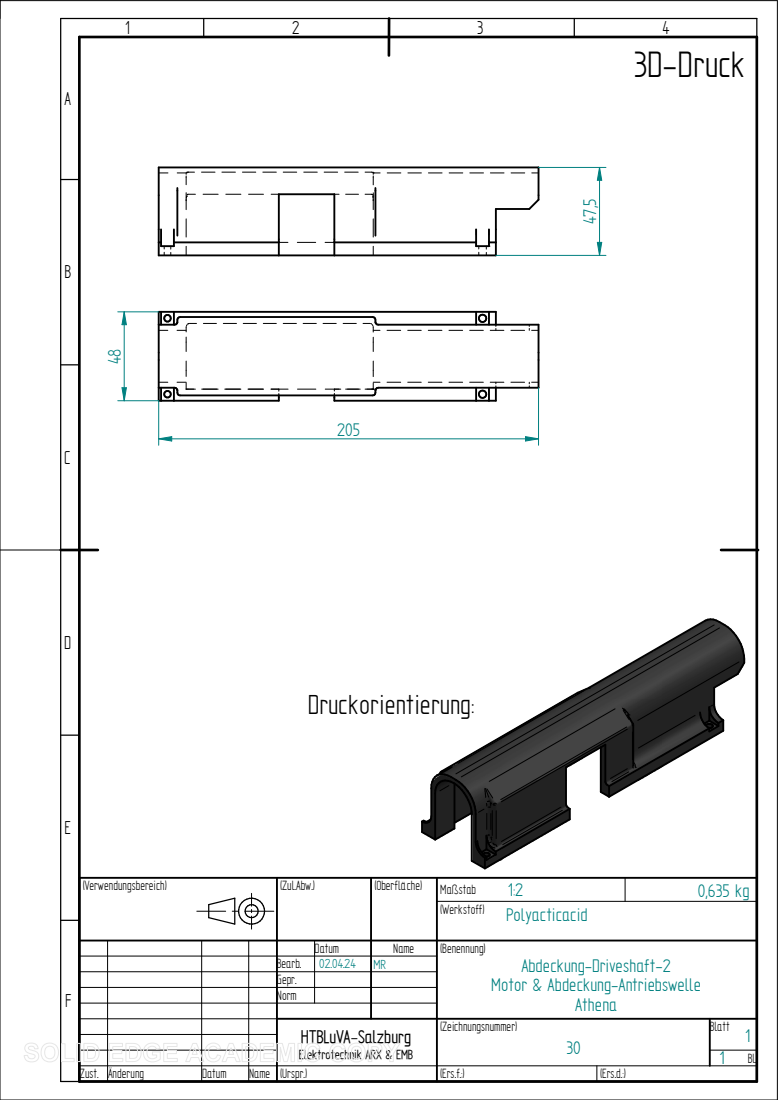
[picture p438: page 1]
Maßstab; Blatt; (Zeichnungsnummer); 0,635 kg ⁽Zul.Abw.); (Oberfläche); (Werkstoff); (Urspr.); (Ers.f.:); (Ers.d.:); (Verwendungsbereich); Polyacticacid; Zust.; Änderung; Datum; Name; HTBLuVA-Salzburg; Elektrotechnik ARX & EMB; Druckorientierung:; 3D-Druck

Datum | Name | (Benennung) Abdeckung-Driveshaft-2 Motor & Abdeckung-Antriebswelle Athena
Bearb. | 02.04.24 MR
Gepr.
Norm
