unlegitGurke/RC-Car/Diplomarbeit/Athena/9_Anhang/Bemassung/PDF/31_AbdeckungDrive_1.pdf

B

A

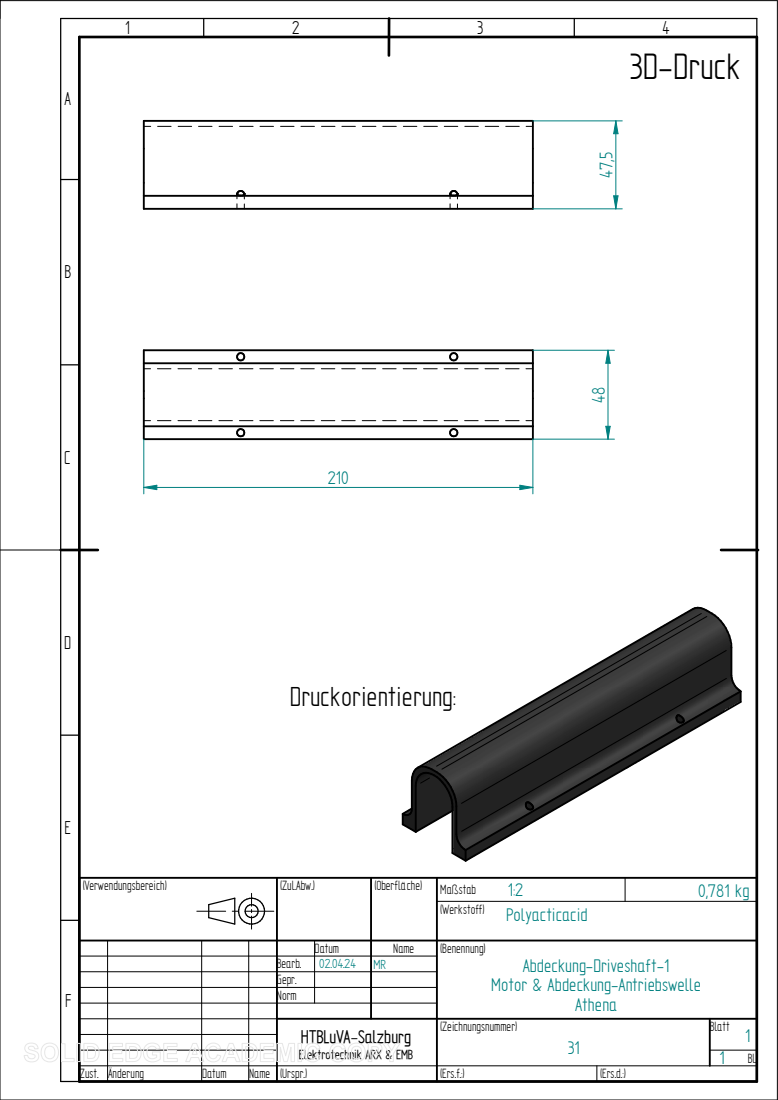
[picture p439: page 1]
Maßstab; Blatt; (Zeichnungsnummer); 0,781 kg ⁽Zul.Abw.); (Oberfläche); (Werkstoff); (Urspr.); (Ers.f.:); (Ers.d.:); (Verwendungsbereich); Polyacticacid; Zust.; Änderung; Datum; Name; HTBLuVA-Salzburg; Elektrotechnik ARX & EMB; 3D-Druck; Druckorientierung:

Datum | Name | (Benennung) Abdeckung-Driveshaft-1 Motor & Abdeckung-Antriebswelle Athena
Bearb. | 02.04.24 MR
Gepr.
Norm
