unlegitGurke/RC-Car/Diplomarbeit/Athena/9_Anhang/Bemassung/PDF/32_Clutch_mount_unten.pdf

B

A

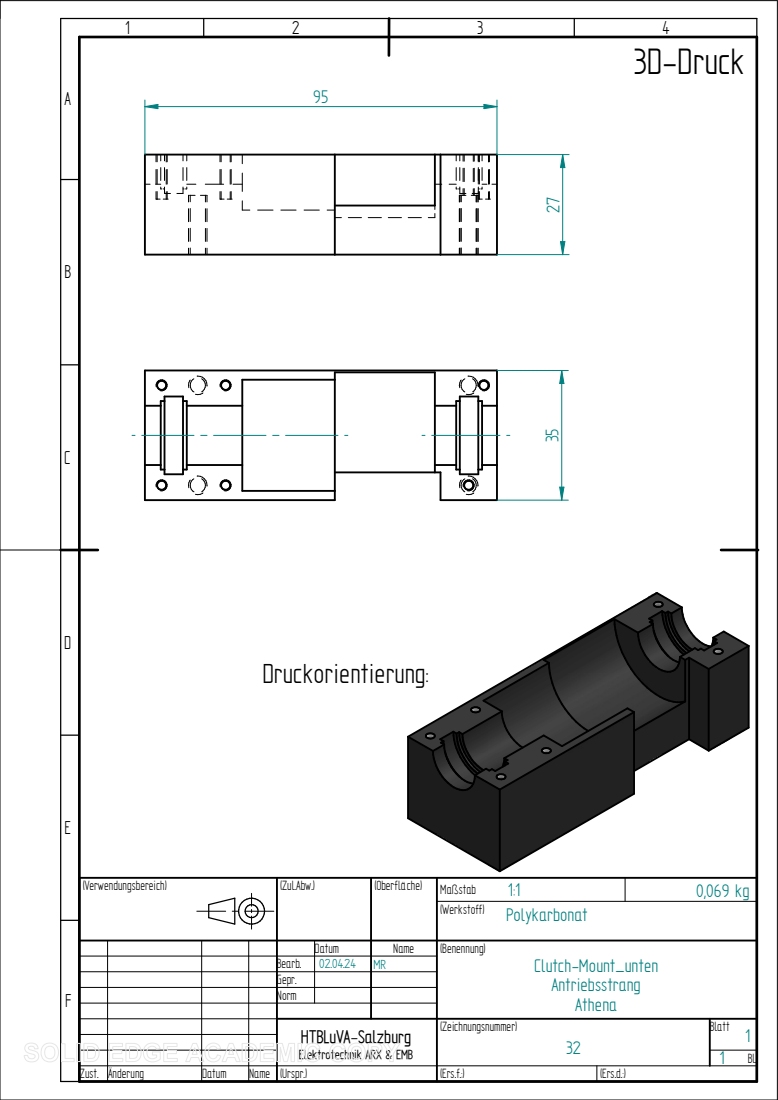
[picture p440: page 1]
Maßstab; Blatt; (Zeichnungsnummer); 0,069 kg ⁽Zul.Abw.); (Oberfläche); (Werkstoff); (Urspr.); (Ers.f.:); (Ers.d.:); (Verwendungsbereich); Polykarbonat; Zust.; Änderung; Datum; Name; Druckorientierung:; 3D-Druck

Datum | Name | (Benennung) Clutch-Mount_unten Antriebsstrang Athena
Bearb. | 02.04.24 MR
Gepr.
Norm

HTBLuVA-Salzburg
Elektrotechnik ARX & EMB
