unlegitGurke/RC-Car/Diplomarbeit/Athena/9_Anhang/Bemassung/PDF/33_Clutch_mount_oben.pdf

B

A

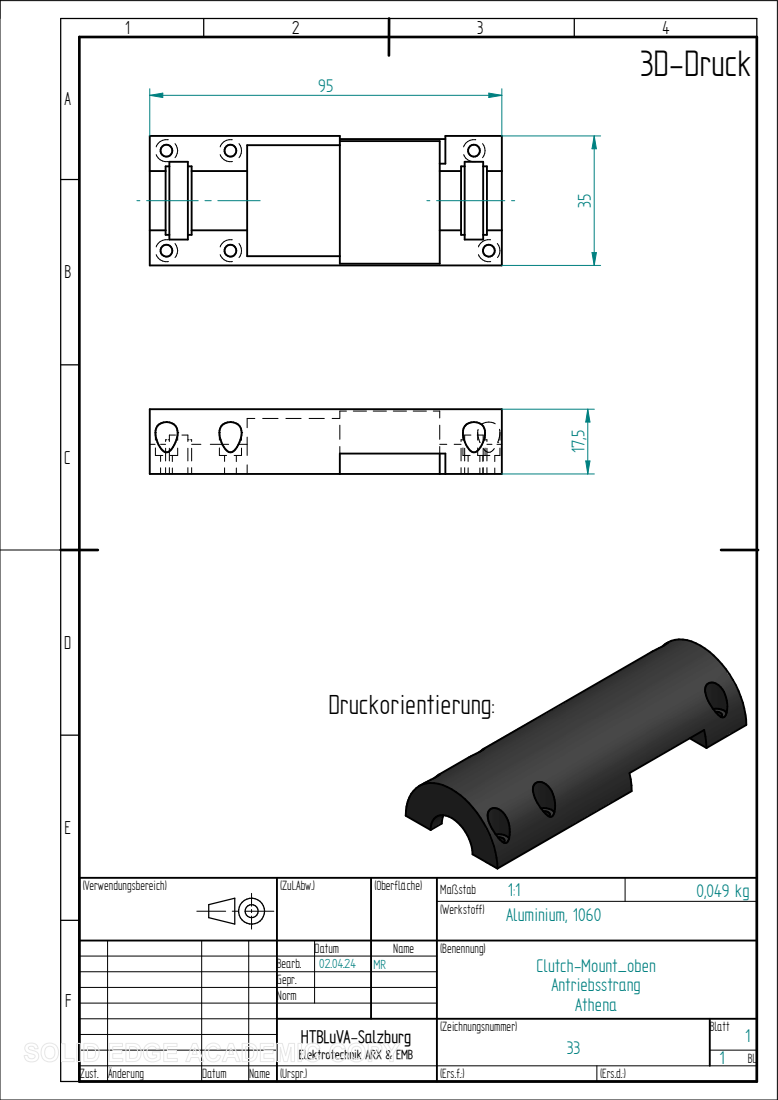
[picture p441: page 1]
Maßstab; Blatt; (Zeichnungsnummer); 0,049 kg ⁽Zul.Abw.); (Oberfläche); (Werkstoff); (Urspr.); (Ers.f.:); (Ers.d.:); (Verwendungsbereich); Aluminium, 1060; Zust.; Änderung; Datum; Name; HTBLuVA-Salzburg; Elektrotechnik ARX & EMB; Druckorientierung:; 3D-Druck

Datum | Name | (Benennung) Clutch-Mount_oben Antriebsstrang Athena
Bearb. | 02.04.24 MR
Gepr.
Norm
