unlegitGurke/RC-Car/Diplomarbeit/Athena/9_Anhang/Bemassung/PDF/34_Getriebeabdeckung.pdf

B

A

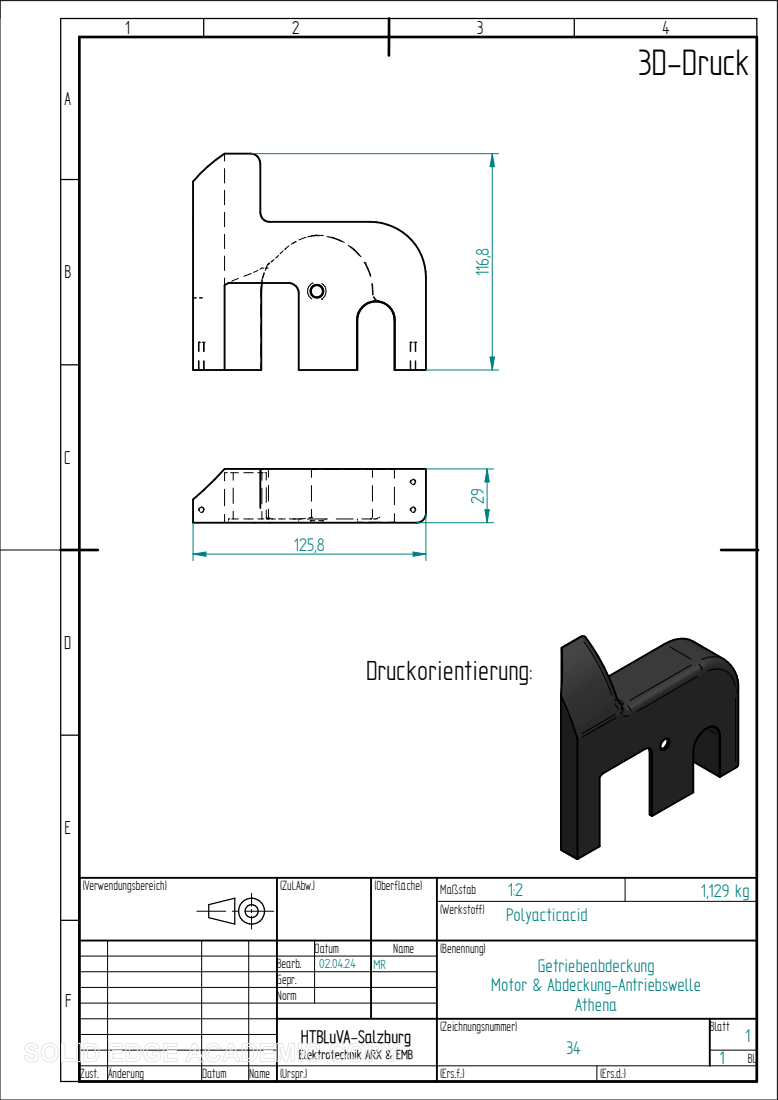
[picture p442: page 1]
Maßstab; Blatt; (Zeichnungsnummer); 1,129 kg ⁽Zul.Abw.); (Oberfläche); (Werkstoff); (Urspr.); (Ers.f.:); (Ers.d.:); (Verwendungsbereich); Polyacticacid; Zust.; Änderung; Datum; Name; HTBLuVA-Salzburg; Elektrotechnik ARX & EMB; Druckorientierung:; 3D-Druck

Datum | Name | (Benennung) Getriebeabdeckung Motor & Abdeckung-Antriebswelle Athena
Bearb. | 02.04.24 MR
Gepr.
Norm
