unlegitGurke/RC-Car/Diplomarbeit/Athena/9_Anhang/Bemassung/PDF/35_Luefter_mount_Lattepanda.pdf

B

A

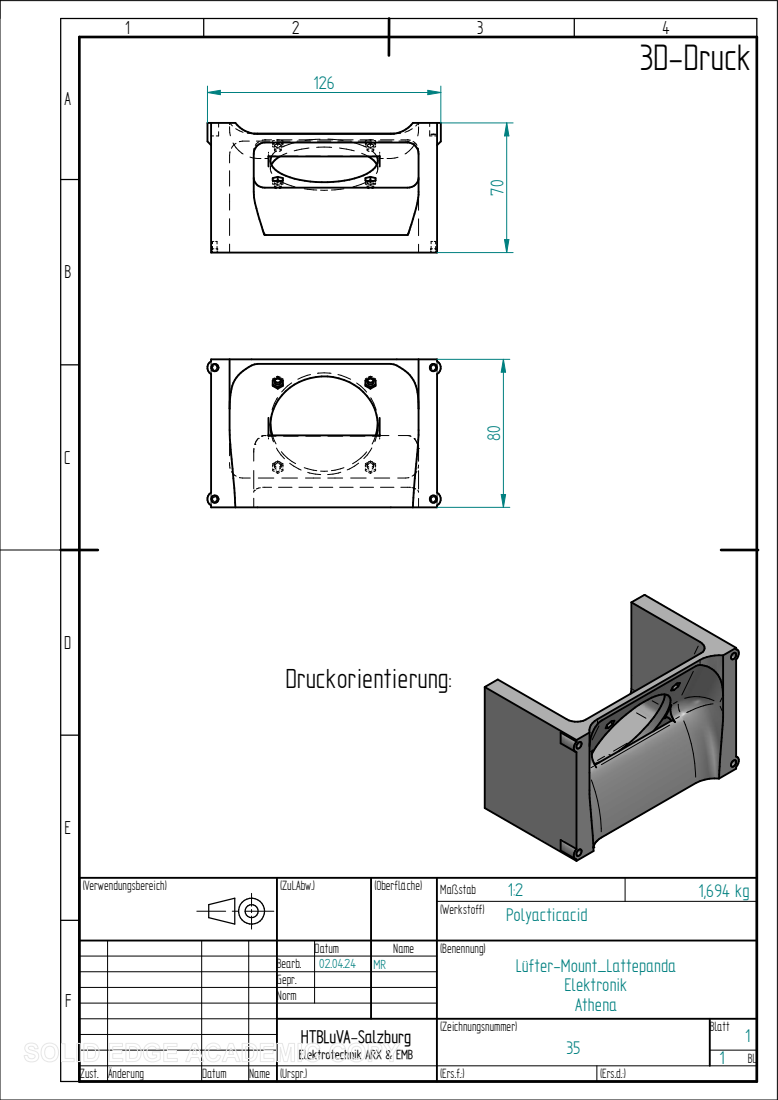
[picture p443: page 1]
Maßstab; Blatt; (Zeichnungsnummer); 1,694 kg ⁽Zul.Abw.); (Oberfläche); (Werkstoff); (Urspr.); (Ers.f.:); (Ers.d.:); (Verwendungsbereich); Polyacticacid; Zust.; Änderung; Datum; Name; Druckorientierung:; 3D-Druck 70

Datum | Name | (Benennung) Lüfter-Mount_Lattepanda Elektronik Athena
Bearb. | 02.04.24 MR
Gepr.
Norm

HTBLuVA-Salzburg
Elektrotechnik ARX & EMB
