unlegitGurke/RC-Car/Diplomarbeit/Athena/9_Anhang/Bemassung/PDF/36_ESC_Mount.pdf

B

A

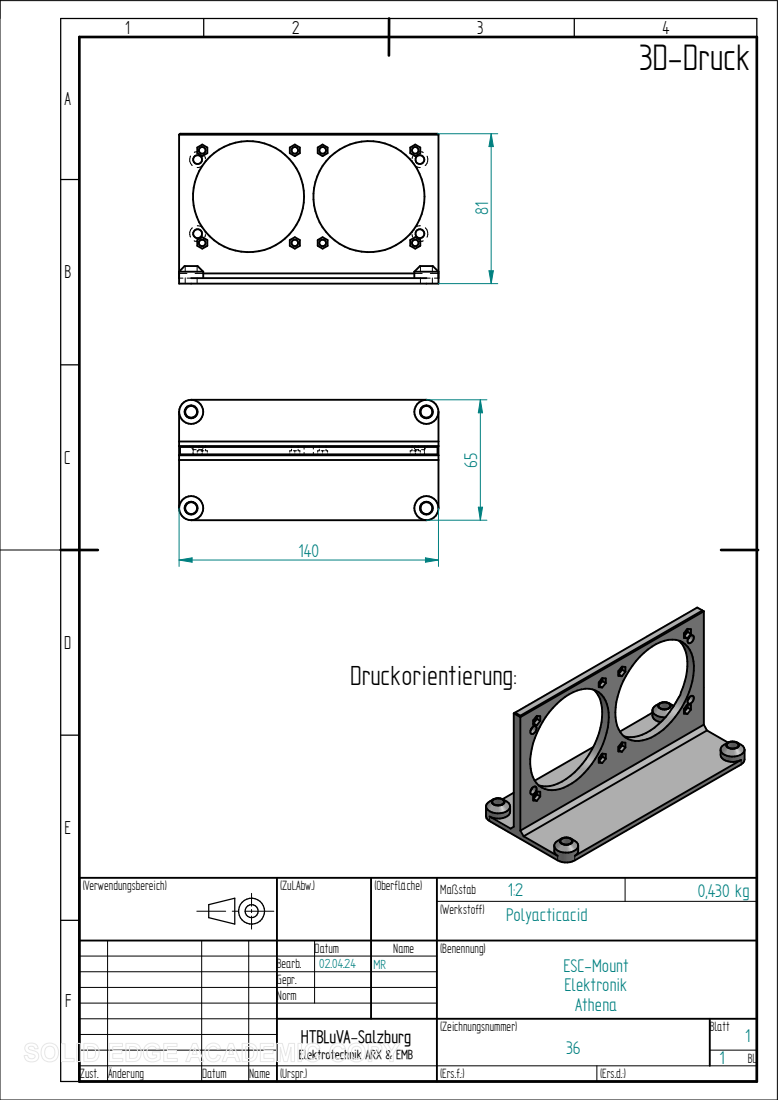
[picture p444: page 1]
Maßstab; Blatt; (Zeichnungsnummer); 0,430 kg ⁽Zul.Abw.); (Oberfläche); (Werkstoff); (Urspr.); (Ers.f.:); (Ers.d.:); (Verwendungsbereich); Polyacticacid; Zust.; Änderung; Datum; Name; HTBLuVA-Salzburg; Elektrotechnik ARX & EMB; 3D-Druck; Druckorientierung:

Datum | Name | (Benennung) ESC-Mount Elektronik Athena
Bearb. | 02.04.24 MR
Gepr.
Norm
