unlegitGurke/RC-Car/Diplomarbeit/Athena/9_Anhang/Bemassung/PDF/37_LiPo_Mount_mount.pdf

B

A

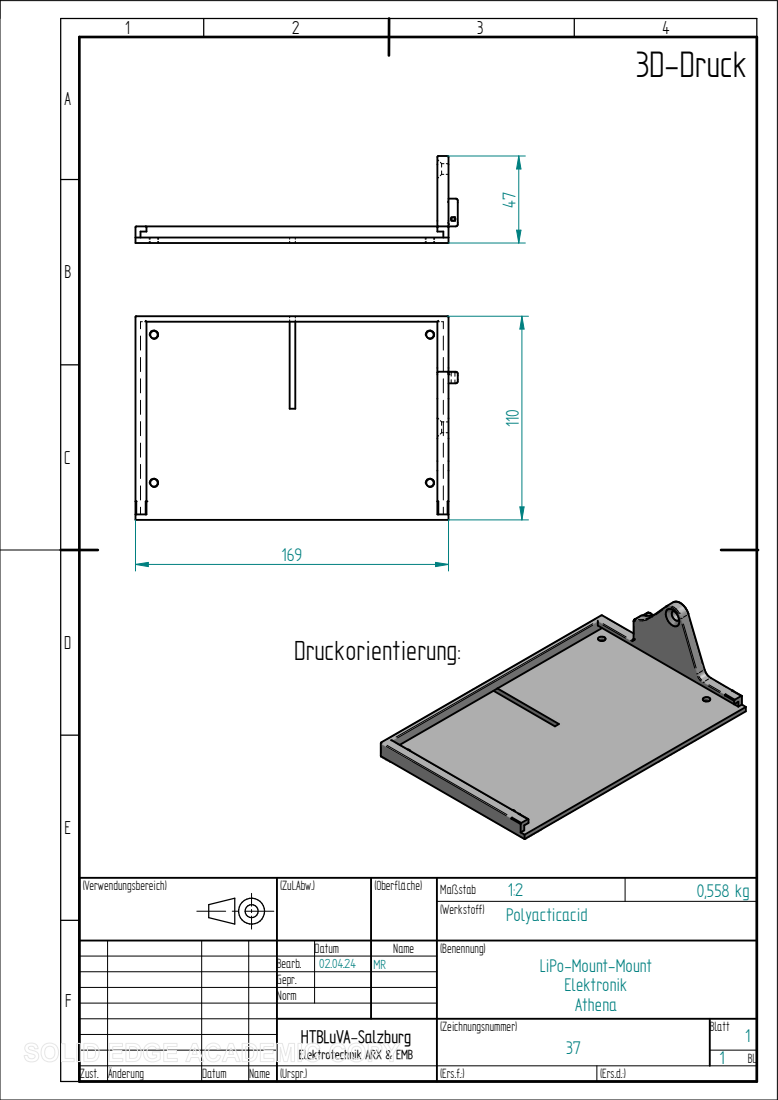
[picture p445: page 1]
Maßstab; Blatt; (Zeichnungsnummer); 0,558 kg ⁽Zul.Abw.); (Oberfläche); (Werkstoff); (Urspr.); (Ers.f.:); (Ers.d.:); (Verwendungsbereich); Polyacticacid; Zust.; Änderung; Datum; Name; HTBLuVA-Salzburg; Elektrotechnik ARX & EMB; Druckorientierung:; 3D-Druck

Datum | Name | (Benennung) LiPo-Mount-Mount Elektronik Athena
Bearb. | 02.04.24 MR
Gepr.
Norm
