unlegitGurke/RC-Car/Diplomarbeit/Athena/9_Anhang/Bemassung/PDF/38_LiPo_Mount_gehäuse.pdf

B

A

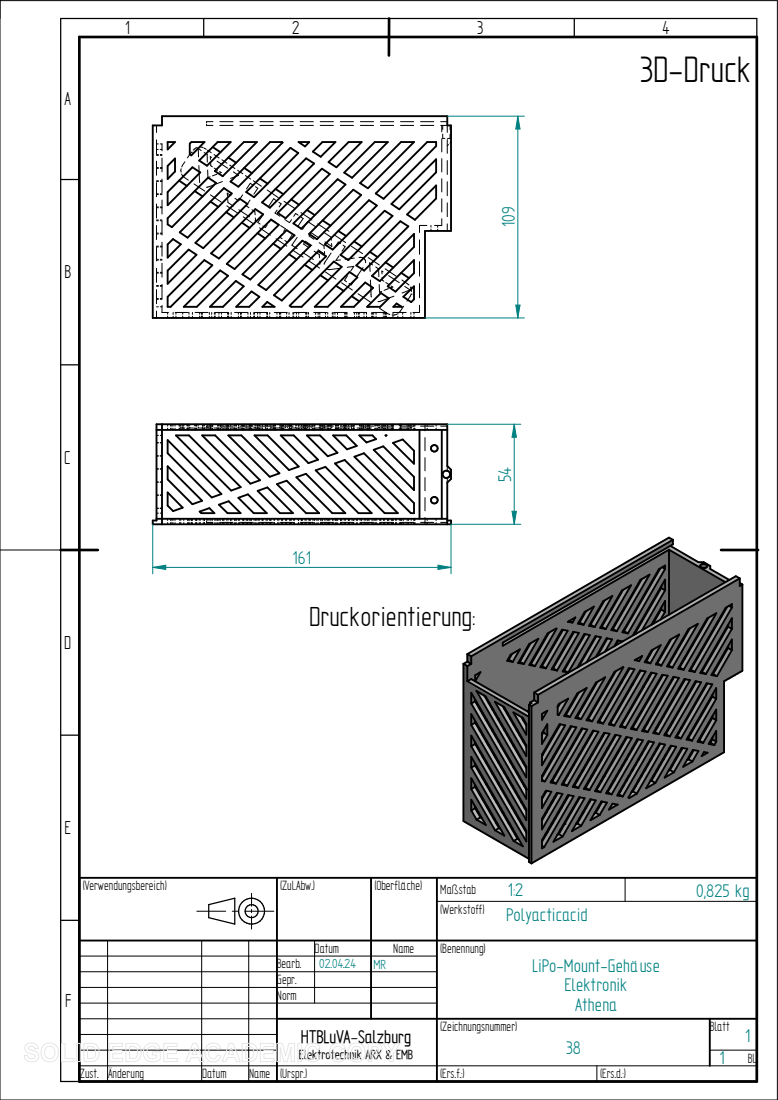
[picture p446: page 1]
Maßstab; Blatt; (Zeichnungsnummer); 0,825 kg ⁽Zul.Abw.); (Oberfläche); (Werkstoff); (Urspr.); (Ers.f.:); (Ers.d.:); (Verwendungsbereich); Polyacticacid; Zust.; Änderung; Datum; Name; HTBLuVA-Salzburg; Elektrotechnik ARX & EMB; 3D-Druck; Druckorientierung:

Datum | Name | (Benennung) LiPo-Mount-Gehäuse Elektronik Athena
Bearb. | 02.04.24 MR
Gepr.
Norm
