unlegitGurke/RC-Car/Diplomarbeit/Athena/9_Anhang/Bemassung/PDF/39_liPo_Mount_Deckel.pdf

B

A

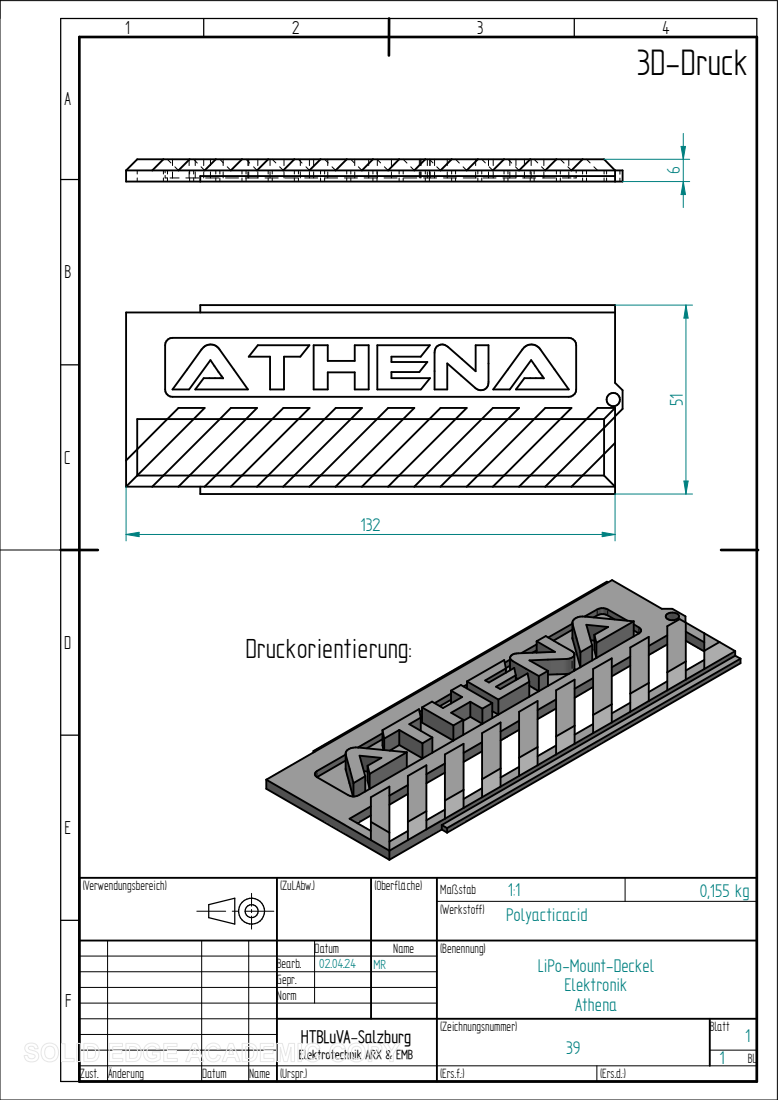
[picture p447: page 1]
Maßstab; Blatt; (Zeichnungsnummer); 0,155 kg ⁽Zul.Abw.); (Oberfläche); (Werkstoff); (Urspr.); (Ers.f.:); (Ers.d.:); (Verwendungsbereich); Polyacticacid; Zust.; Änderung; Datum; Name; Druckorientierung:; 3D-Druck

Datum | Name | (Benennung) LiPo-Mount-Deckel Elektronik Athena
Bearb. | 02.04.24 MR
Gepr.
Norm

HTBLuVA-Salzburg
Elektrotechnik ARX & EMB
