unlegitGurke/RC-Car/Diplomarbeit/Athena/9_Anhang/Bemassung/PDF/40_LiPo_Mount_Adapter.pdf

B

A

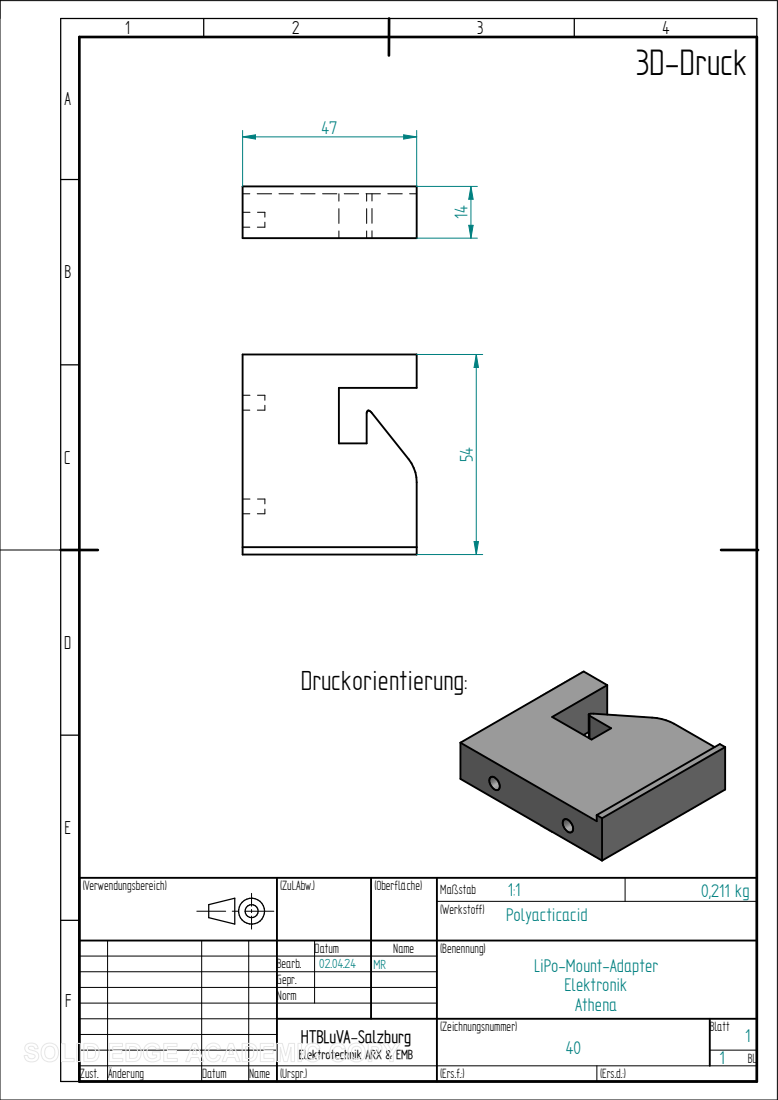
[picture p448: page 1]
Maßstab; Blatt; (Zeichnungsnummer); 0,211 kg ⁽Zul.Abw.); (Oberfläche); (Werkstoff); (Urspr.); (Ers.f.:); (Ers.d.:); (Verwendungsbereich); Polyacticacid; Zust.; Änderung; Datum; Name; 3D-Druck; Druckorientierung:

Datum | Name | (Benennung) LiPo-Mount-Adapter Elektronik Athena
Bearb. | 02.04.24 MR
Gepr.
Norm

HTBLuVA-Salzburg
Elektrotechnik ARX & EMB
