unlegitGurke/RC-Car/Diplomarbeit/Athena/9_Anhang/Bemassung/PDF/41_LiPo_Mount_Hebel.pdf

B

A

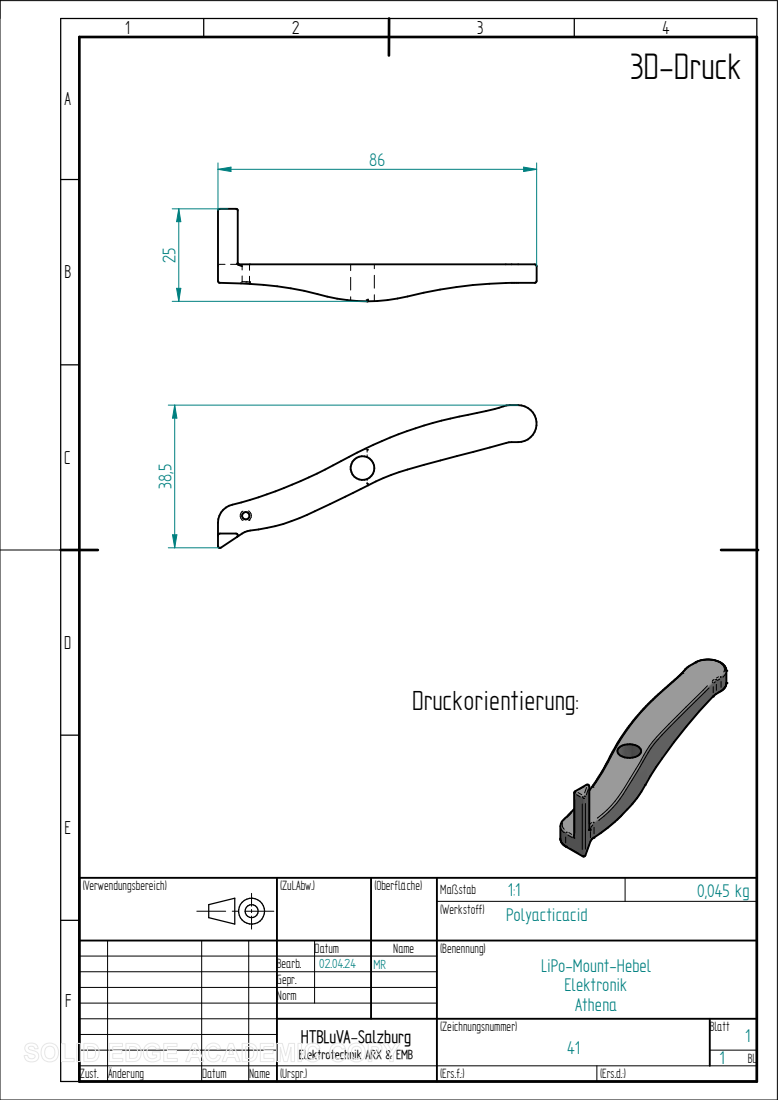
[picture p449: page 1]
Maßstab; Blatt; (Zeichnungsnummer); 0,045 kg ⁽Zul.Abw.); (Oberfläche); (Werkstoff); (Urspr.); (Ers.f.:); (Ers.d.:); (Verwendungsbereich); Polyacticacid; Zust.; Änderung; Datum; Name; 3D-Druck

Druckorientierung: ²⁵ ³⁸,5

Datum | Name | (Benennung) LiPo-Mount-Hebel Elektronik Athena
Bearb. | 02.04.24 MR
Gepr.
Norm

HTBLuVA-Salzburg
Elektrotechnik ARX & EMB
