unlegitGurke/RC-Car/Drafts/Aufhängung/Abdeckplatte_Hinten1.pdf

B

A

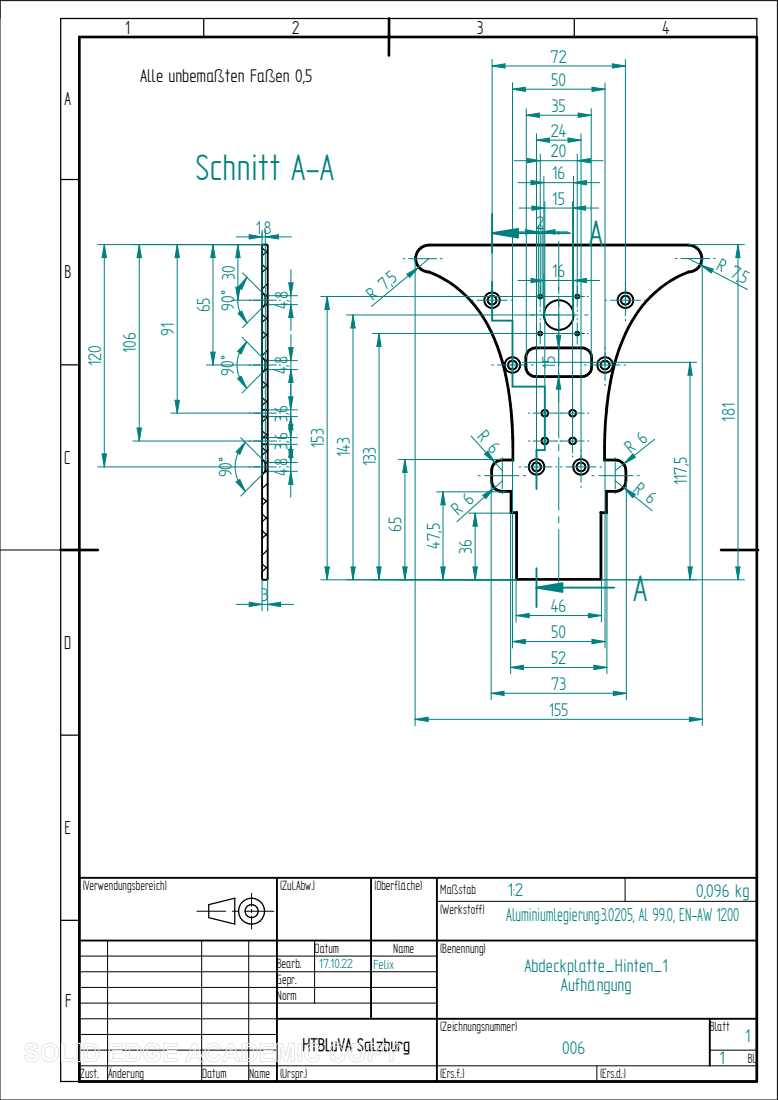
[picture p450: page 1]
Maßstab; Blatt; (Zeichnungsnummer); 0,096 kg ⁽Zul.Abw.); (Oberfläche); (Werkstoff); (Urspr.); (Ers.f.:); (Ers.d.:); (Verwendungsbereich); Zust.; Änderung; Datum; Name; HTBLuVA Salzburg; Schnitt A-A; Alle unbemaßten Faßen 0,5 4,8 4,8 3,6 3,6 4,8 ³0 65 9¹ 106 120

15

Aluminiumlegierung:3.0205, Al 99.0, EN-AW 1200

Datum | Name | (Benennung) Abdeckplatte_Hinten_1 Aufhängung
Bearb. | 17.10.22 Felix
Gepr.
Norm
