unlegitGurke/RC-Car/Drafts/Aufhängung/Abdeckplatte_Hinten2.pdf

B

A

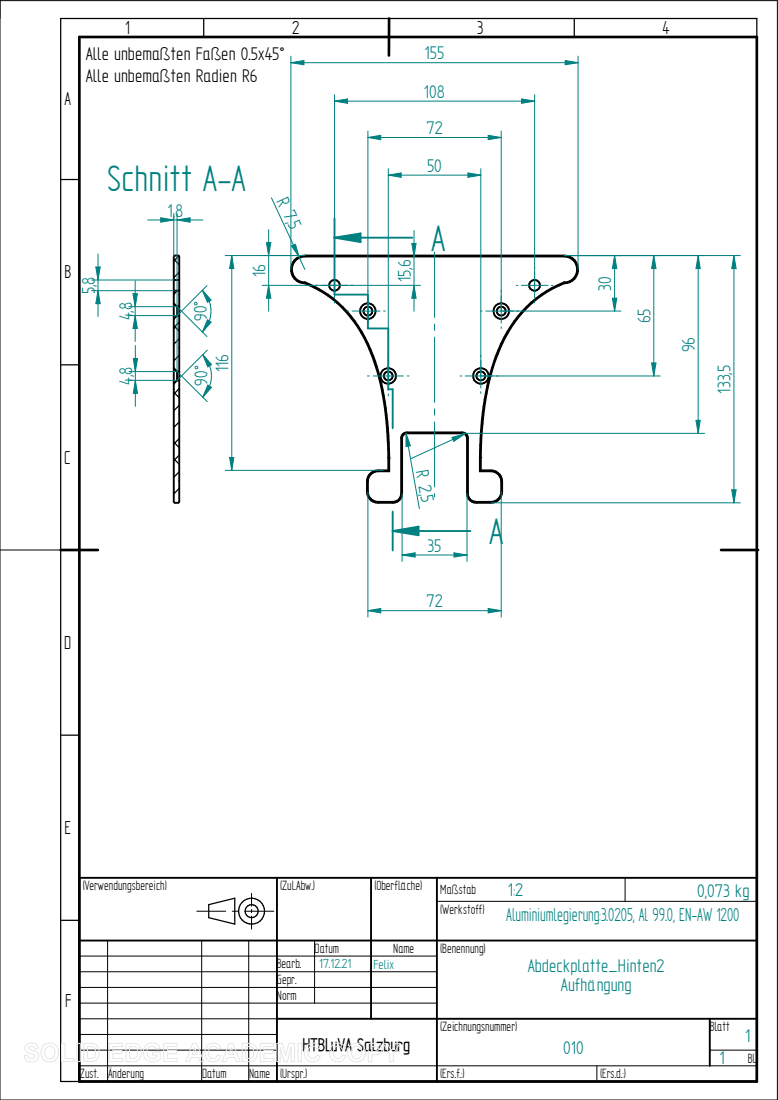
[picture p451: page 1]
Maßstab; Blatt; (Zeichnungsnummer); 0,073 kg ⁽Zul.Abw.); (Oberfläche); (Werkstoff); (Urspr.); (Ers.f.:); (Ers.d.:); (Verwendungsbereich); Zust.; Änderung; Datum; Name; HTBLuVA Salzburg; Schnitt A-A 4,8 4,8 ⁵,8

Alle unbemaßten Faßen 0.5x45°
Alle unbemaßten Radien R6 116

Aluminiumlegierung:3.0205, Al 99.0, EN-AW 1200

Datum | Name | (Benennung) Abdeckplatte_Hinten2 Aufhängung
Bearb. | 17.12.21 Felix
Gepr.
Norm
