unlegitGurke/RC-Car/Rechnungen/Ausgaben/Amazon_Rechnung_2.pdf

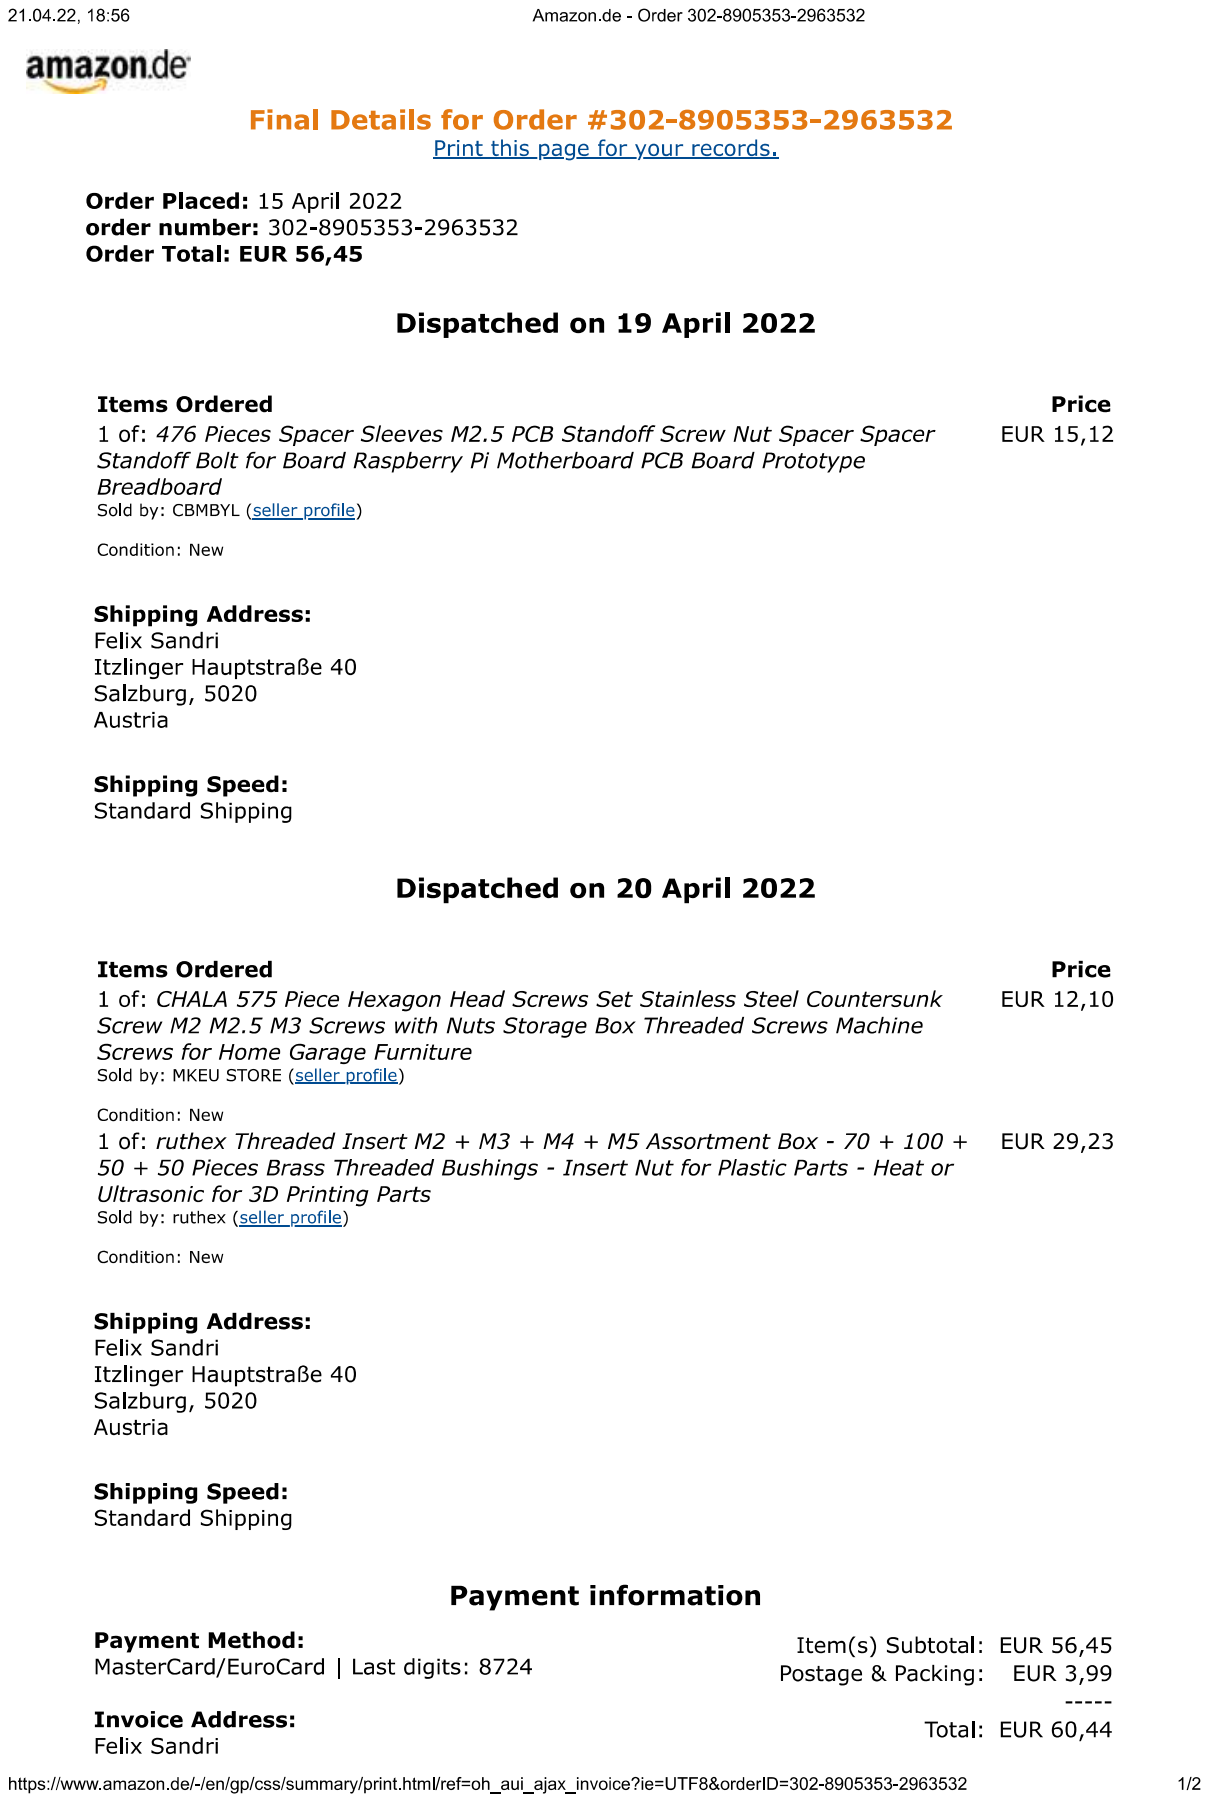
[picture p452: page 1]

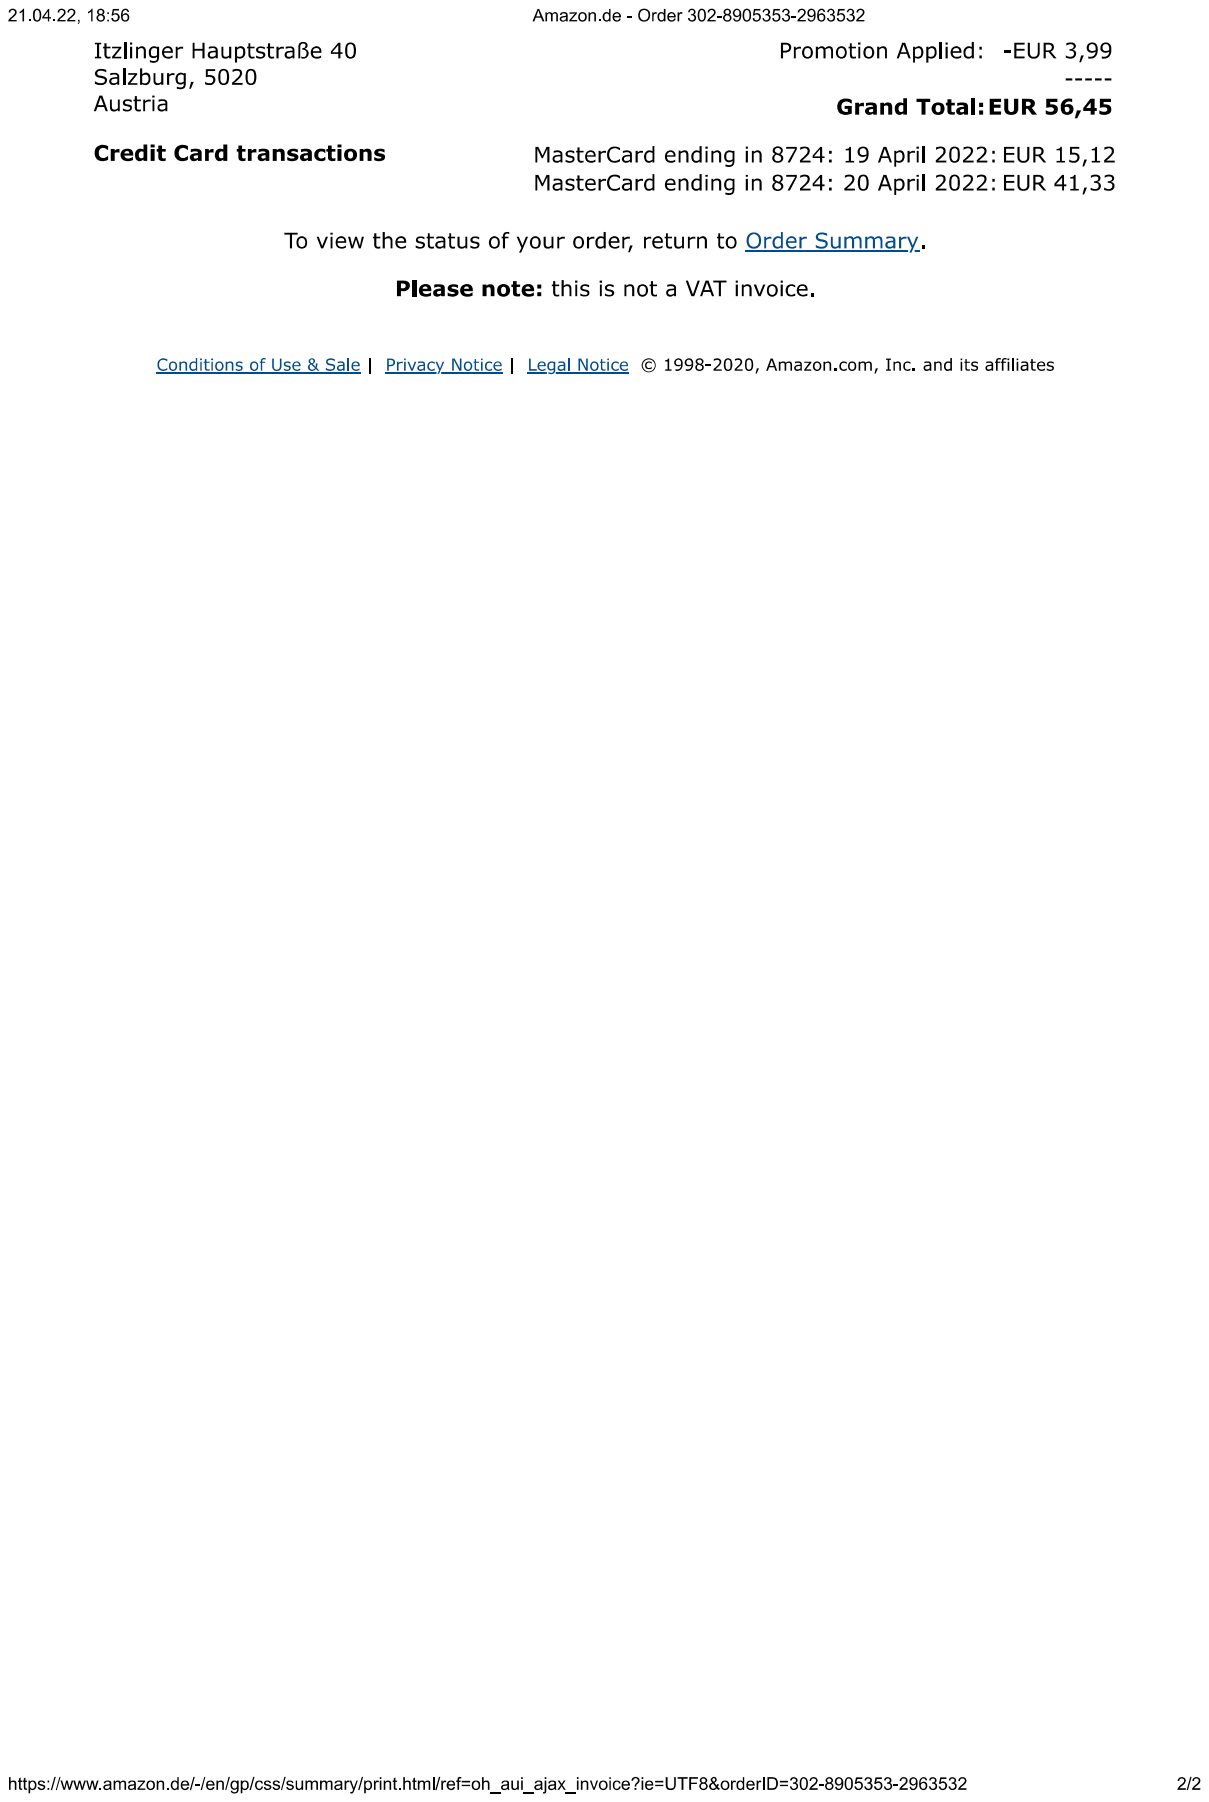
[picture p453: page 2]
