unlegitGurke/RC-Car/(list of files, drawings)

Other design files:
Drafts/Elektroschaltplan.spl7
