unlegitGurke/RC-Car/Electronics/Octosonar/OctoSonar-master/extras/eagle/hcsr04bracket/hcsr04bracket.brd

## EAGLE design Electronics/Octosonar/OctoSonar-master/extras/eagle/hcsr04bracket/hcsr04bracket.brd (2021-07-09)

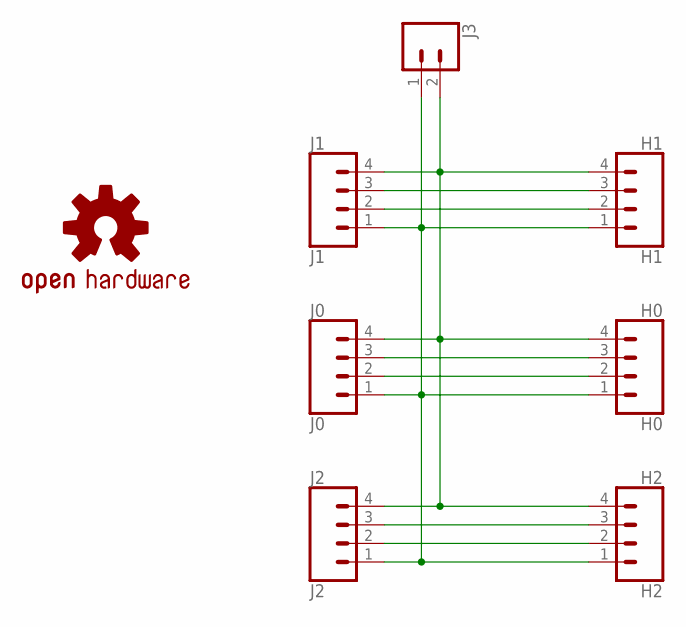
[picture p454: schematic hcsr04bracket.sch]

Parts:
H0: H0; 1X04
H1: H1; 1X04
H2: H2; 1X04
J0: J0; 1X04
J1: J1; 1X04
J2: J2; 1X04
J3: CONN_02; 1X02
LOGO1: OSHW-LOGOS; OSHW-LOGO-S

Connections:
E1: H1.3, J1.3
E2: H0.3, J0.3
E3: H2.3, J2.3
GND: H0.4, H1.4, H2.4, J0.4, J1.4, J2.4, J3.2
T1: H1.2, J1.2
T2: H0.2, J0.2
T3: H2.2, J2.2
VCC: H0.1, H1.1, H2.1, J0.1, J1.1, J2.1, J3.1

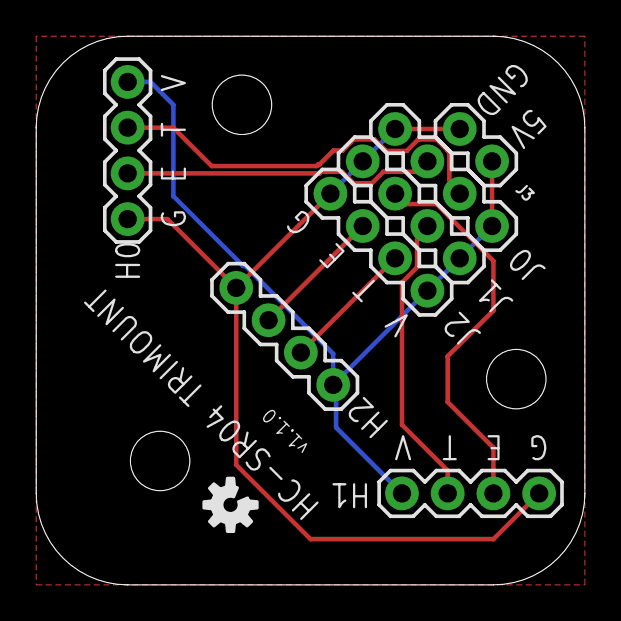
[picture p455: board hcsr04bracket.brd from above]

Board: 2 copper layers, 30.5 x 30.5 mm, 11 parts (1 on the bottom side), 8 nets.

Other parts of the board:
U$1, U$2, U$3: STAND-OFF
