unlegitGurke/RC-Car/Electronics/Octosonar/OctoSonar-master/extras/eagle/octosonar-feather/octosonar-feather.brd

## EAGLE design Electronics/Octosonar/OctoSonar-master/extras/eagle/octosonar-feather/octosonar-feather.brd (2021-07-09)

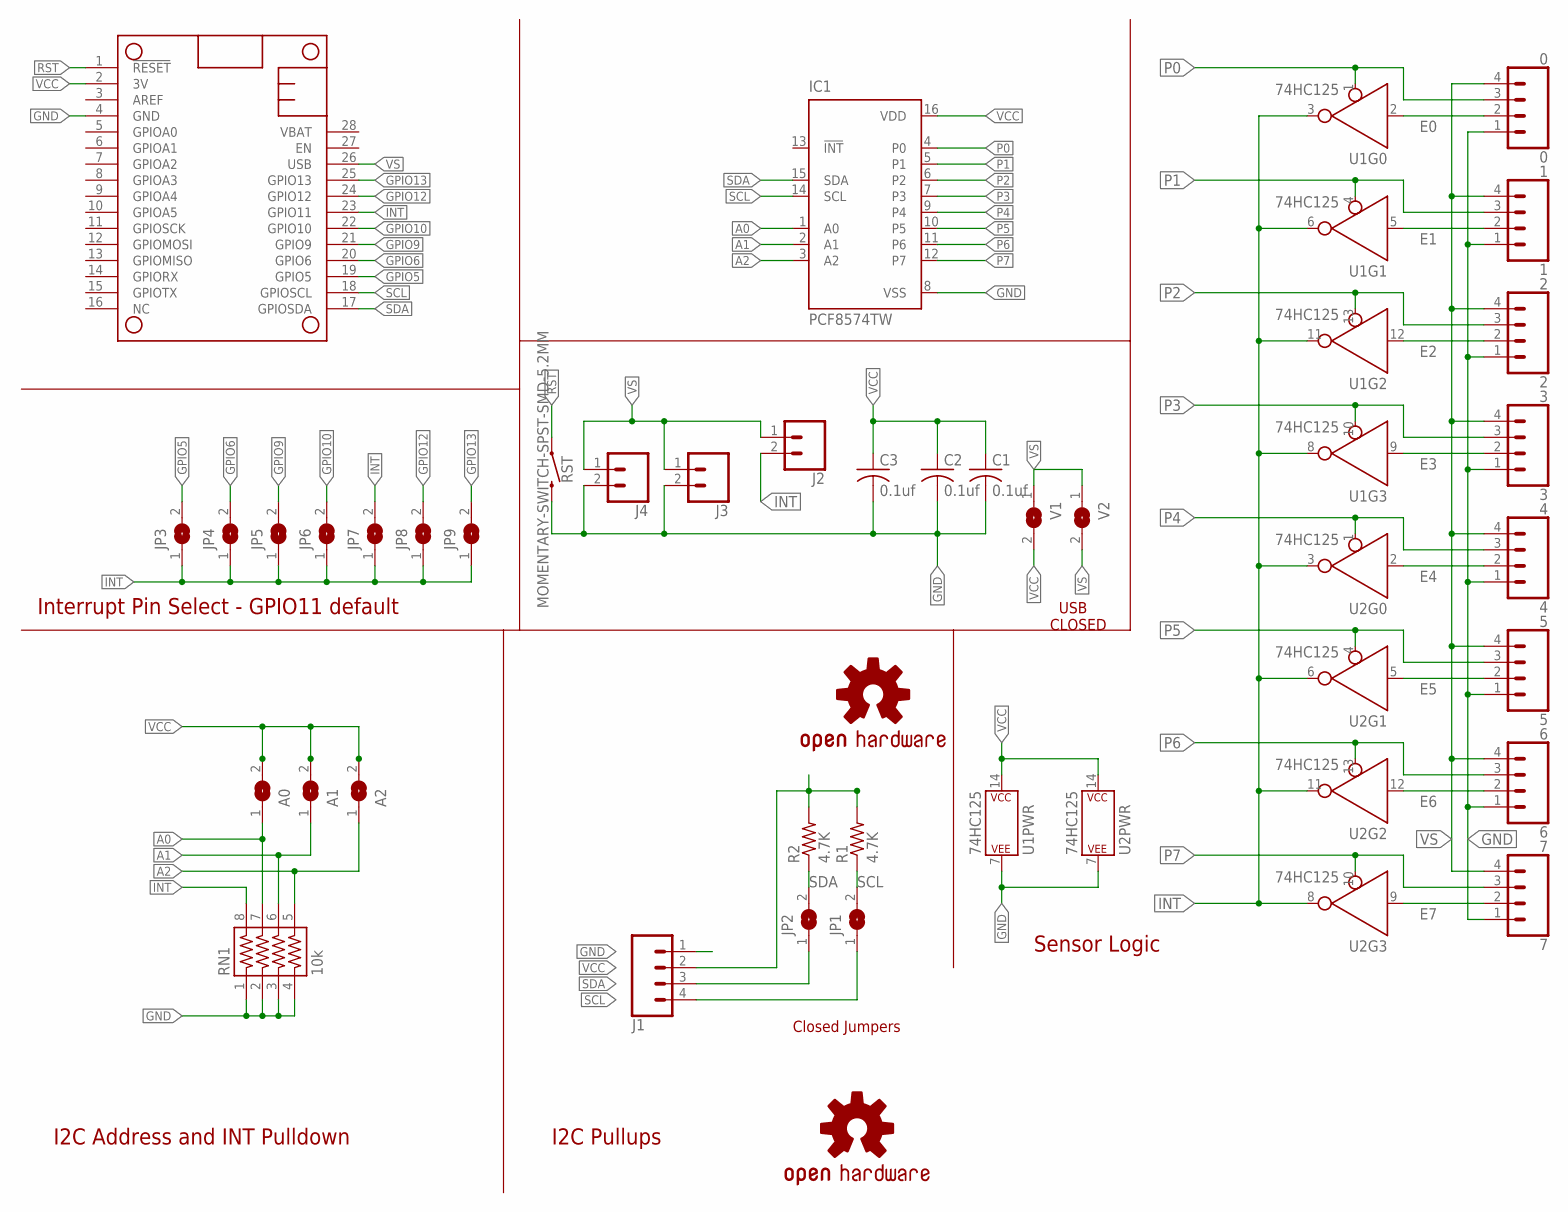
[picture p456: schematic octosonar-feather.sch]

Parts:
0: 0; 1X04_NO_SILK
1: 1; 1X04_NO_SILK
2: 2; 1X04_NO_SILK
3: 3; 1X04_NO_SILK
4: 4; 1X04_NO_SILK
5: 5; 1X04_NO_SILK
6: 6; 1X04_NO_SILK
7: 7; 1X04_NO_SILK
A0, A1, A2: SJSJ-NOCREAM; SJ-NOCREAM
C1, C2, C3: 0.1uf; C0603
IC1: PCF8574TW; SO16W
J1: CONN_041X04_NO_SILK; 1X04_NO_SILK
J2, J3, J4: CONN_021X02_NO_SILK; 1X02_NO_SILK
JP1, JP2, JP3, JP4, JP5, JP6, JP7, JP8, JP9: SJSJ-NOCREAM; SJ-NOCREAM
LOGO1: OSHW-LOGOL-COPPER; OSHW-LOGO-L_COPPER
LOGO2: OSHW-LOGOL; OSHW-LOGO-L
MS1: FEATHERWINGFEATHERWING_LONG; FEATHERWING_LONG
R1, R2: 4.7K; R0603
RN1: 10k; 743-8
RST: MOMENTARY-SWITCH-SPST-SMD-5.2MM; TACTILE_SWITCH_SMD_5.2MM
U1, U2: 74HC125; SO14
V1, V2: SJSJ-NOCREAM; SJ-NOCREAM

Connections:
A0: A0.1, IC1.1 (A0), RN1.7
A1: A1.1, IC1.2 (A1), RN1.6
A2: A2.1, IC1.3 (A2), RN1.5
E0: 0.2, U1.2 (A)
E1: 1.2, U1.5 (A)
E2: 2.2, U1.12 (A)
E3: 3.2, U1.9 (A)
E4: 4.2, U2.2 (A)
E5: 5.2, U2.5 (A)
E6: 6.2, U2.12 (A)
E7: 7.2, U2.9 (A)
GND: 0.1, 1.1, 2.1, 3.1, 4.1, 5.1, 6.1, 7.1, C1.2, C2.2, C3.2, IC1.8 (VSS), J1.1, J3.2, J4.2, MS1.4 (GND), RN1.1, RN1.2, RN1.3, RN1.4, RST.3 (2), U1.7 (P$V-), U2.7 (P$V-)
GPIO5: JP3.2, MS1.19 (GPIO5)
GPIO6: JP4.2, MS1.20 (GPIO6)
GPIO9: JP5.2, MS1.21 (GPIO9)
GPIO10: JP6.2, MS1.22 (GPIO10)
GPIO12: JP8.2, MS1.24 (GPIO12)
GPIO13: JP9.2, MS1.25 (GPIO13)
INT: J2.2, JP3.1, JP4.1, JP5.1, JP6.1, JP7.1, JP7.2, JP8.1, JP9.1, MS1.23 (GPIO11), RN1.8, U1.3 (Y), U1.6 (Y), U1.8 (Y), U1.11 (Y), U2.3 (Y), U2.6 (Y), U2.8 (Y), U2.11 (Y)
P0: 0.3, IC1.4 (P0), U1.1 (!EN)
P1: 1.3, IC1.5 (P1), U1.4 (!EN)
P2: 2.3, IC1.6 (P2), U1.13 (!EN)
P3: 3.3, IC1.7 (P3), U1.10 (!EN)
P4: 4.3, IC1.9 (P4), U2.1 (!EN)
P5: 5.3, IC1.10 (P5), U2.4 (!EN)
P6: 6.3, IC1.11 (P6), U2.13 (!EN)
P7: 7.3, IC1.12 (P7), U2.10 (!EN)
RST: MS1.1 (!RESET), RST.1
SCL: IC1.14 (SCL), J1.4, JP1.1, JP1.2, MS1.18 (GPIOSCL), R1.1
SDA: IC1.15 (SDA), J1.3, JP2.1, JP2.2, MS1.17 (GPIOSDA), R2.1
VCC: A0.2, A1.2, A2.2, C1.1, C2.1, C3.1, IC1.16 (VDD), J1.2, MS1.2 (3V), R1.2, R2.2, U1.14 (P$V+), U2.14 (P$V+), V1.2
VS: 0.4, 1.4, 2.4, 3.4, 4.4, 5.4, 6.4, 7.4, J2.1, J3.1, J4.1, MS1.26 (USB), V1.1, V2.1, V2.2

Notes on the sheet:
Sensor Logic
I2C Pullups
I2C Address and INT Pulldown
Interrupt Pin Select - GPIO11 default
USB CLOSED
Closed Jumpers

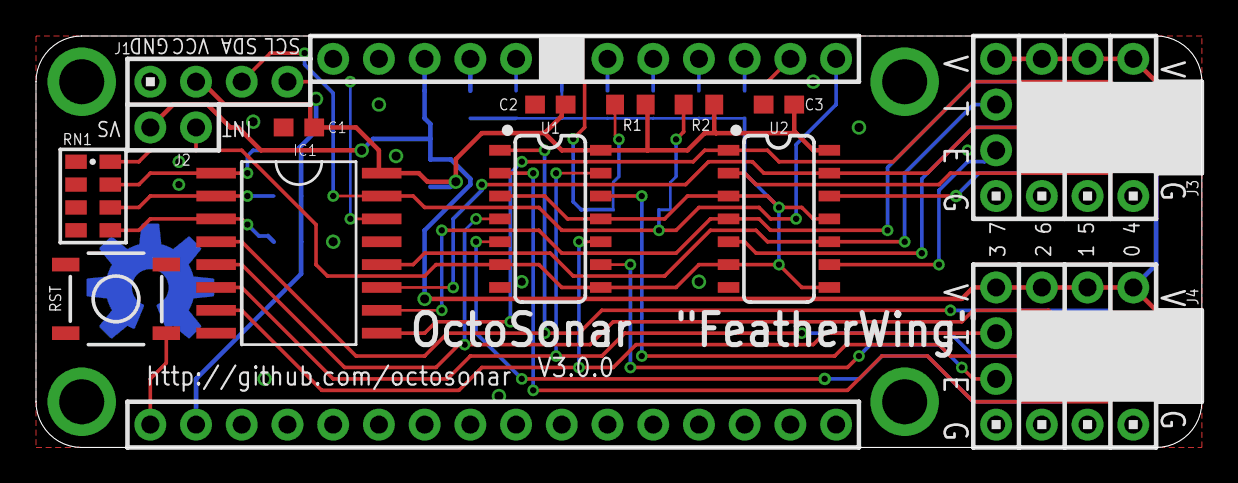
[picture p457: board octosonar-feather.brd from above]

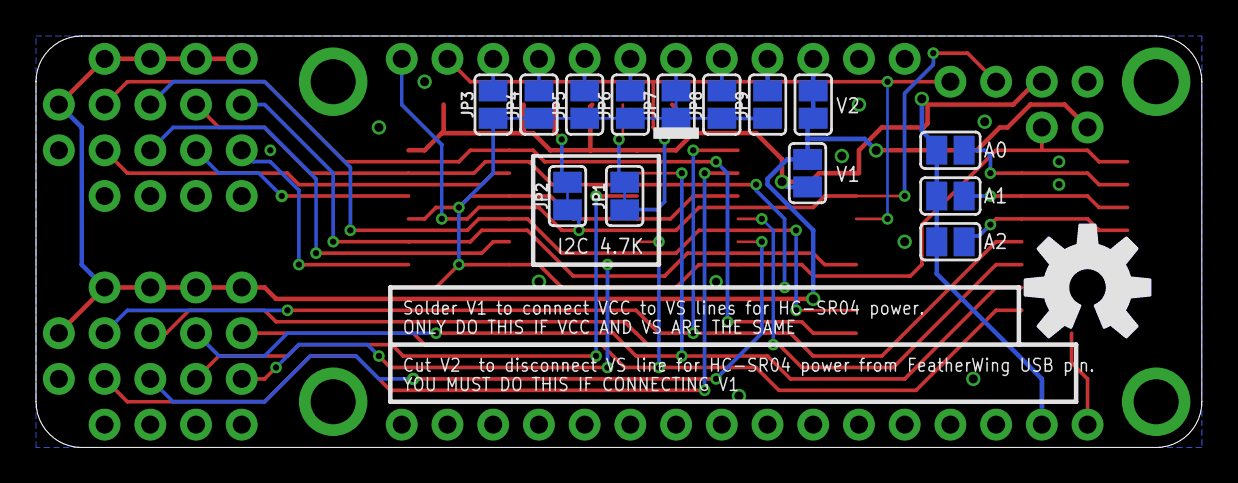
[picture p458: board octosonar-feather.brd from below]

Board: 2 copper layers, 64.8 x 22.9 mm, 39 parts (16 on the bottom side), 32 nets.
