unlegitGurke/RC-Car/Electronics/Octosonar/OctoSonar-master/extras/eagle/octosonar/octosonar.brd

## EAGLE design Electronics/Octosonar/OctoSonar-master/extras/eagle/octosonar/octosonar.brd (2021-07-09)

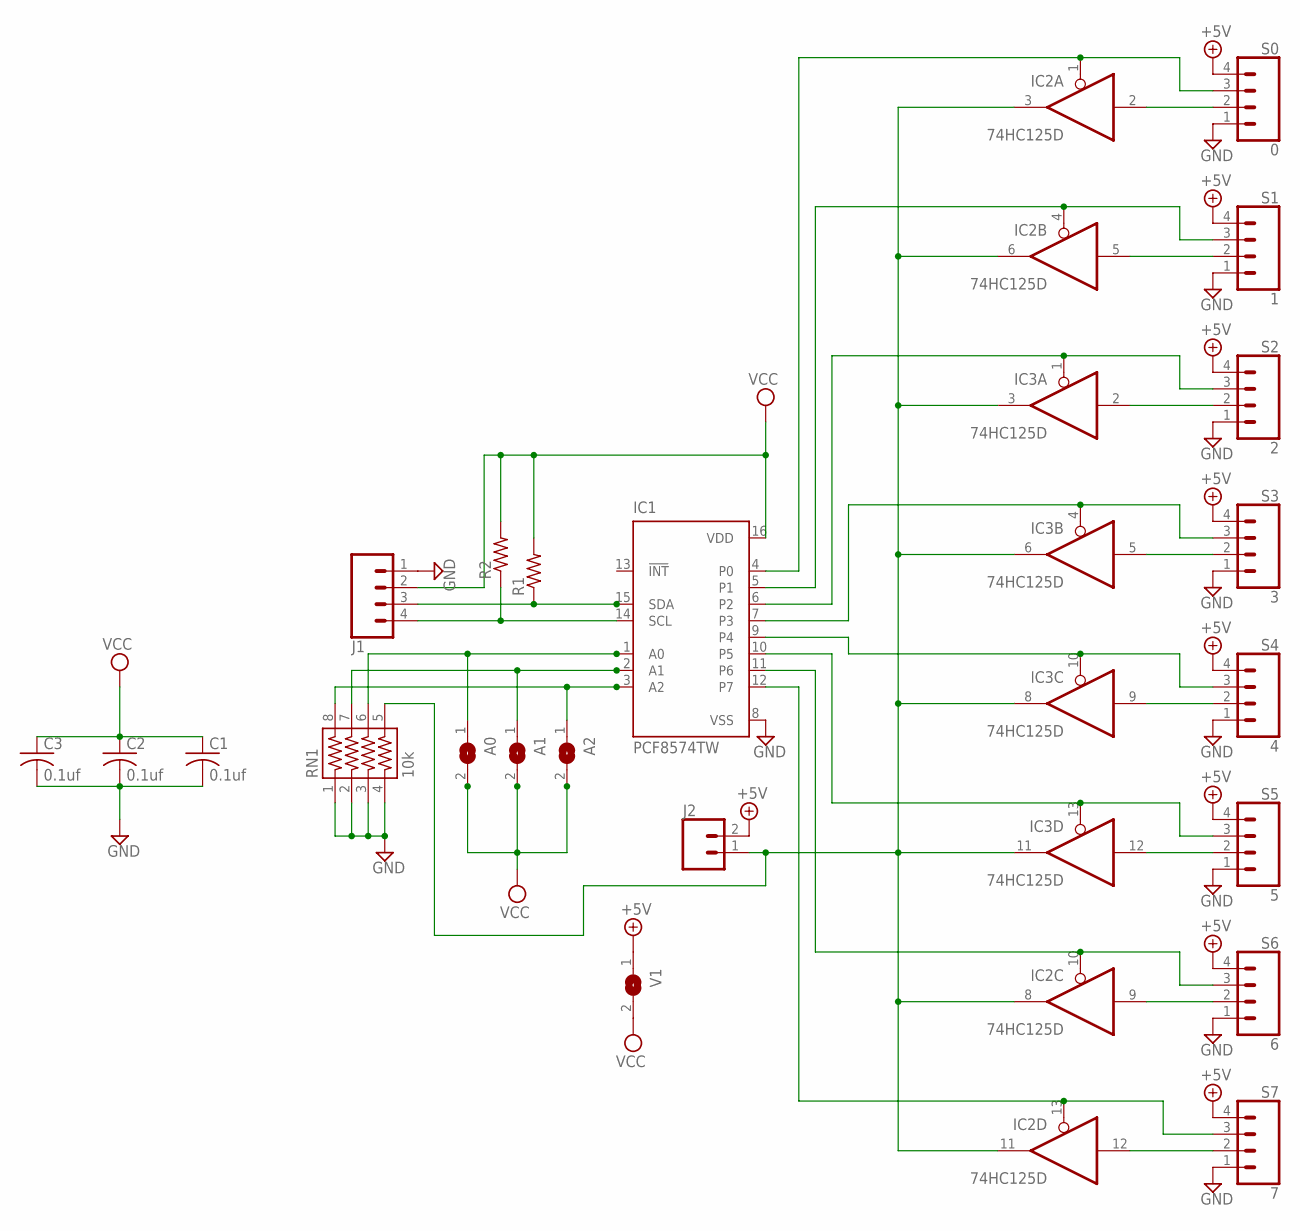
[picture p459: schematic octosonar.sch]

Parts:
A0, A1, A2: SJ
C1, C2, C3: 0.1uf; C0805
IC1: PCF8574TW; SO16W
IC2, IC3: 74HC125D; SO14
J1: CONN_04POLAR_LOCK; MOLEX-1X4_LOCK
J2: CONN_02POLAR_LOCK; MOLEX-1X2_LOCK
R1, R2: R-US_0204/2V; 0204V
RN1: 10k; 743-8
S0: 0; MOLEX-1X4_LOCK
S1: 1; MOLEX-1X4_LOCK
S2: 2; MOLEX-1X4_LOCK
S3: 3; MOLEX-1X4_LOCK
S4: 4; MOLEX-1X4_LOCK
S5: 5; MOLEX-1X4_LOCK
S6: 6; MOLEX-1X4_LOCK
S7: 7; MOLEX-1X4_LOCK
V1: SJ

Connections:
+5V: J2.2, S0.4, S1.4, S2.4, S3.4, S4.4, S5.4, S6.4, S7.4, V1.1
GND: C1.2, C2.2, C3.2, IC1.8 (VSS), IC2.7 (GND), IC3.7 (GND), J1.1, RN1.1, RN1.2, RN1.3, RN1.4, S0.1, S1.1, S2.1, S3.1, S4.1, S5.1, S6.1, S7.1
unnamed: IC1.4 (P0), IC2.1 (OE), S0.3
unnamed: IC1.5 (P1), IC2.4 (OE), S1.3
unnamed: IC1.6 (P2), IC3.1 (OE), S2.3
unnamed: IC1.7 (P3), IC3.4 (OE), S3.3
unnamed: IC1.9 (P4), IC3.10 (OE), S4.3
unnamed: IC1.10 (P5), IC3.13 (OE), S5.3
unnamed: IC1.11 (P6), IC2.10 (OE), S6.3
unnamed: IC1.12 (P7), IC2.13 (OE), S7.3
unnamed: IC2.2 (I), S0.2
unnamed: IC2.5 (I), S1.2
unnamed: IC3.2 (I), S2.2
unnamed: IC3.5 (I), S3.2
unnamed: IC3.12 (I), S5.2
unnamed: IC2.9 (I), S6.2
unnamed: IC2.12 (I), S7.2
unnamed: IC3.9 (I), S4.2
unnamed: IC2.3 (O), IC2.6 (O), IC2.8 (O), IC2.11 (O), IC3.3 (O), IC3.6 (O), IC3.8 (O), IC3.11 (O), J2.1, RN1.5
unnamed: A2.1, IC1.3 (A2), RN1.8
unnamed: A1.1, IC1.2 (A1), RN1.7
unnamed: A0.1, IC1.1 (A0), RN1.6
unnamed: IC1.14 (SCL), J1.4, R2.1
unnamed: IC1.15 (SDA), J1.3, R1.1
VCC: A0.2, A1.2, A2.2, C1.1, C2.1, C3.1, IC1.16 (VDD), IC2.14 (VCC), IC3.14 (VCC), J1.2, R1.2, R2.2, V1.2

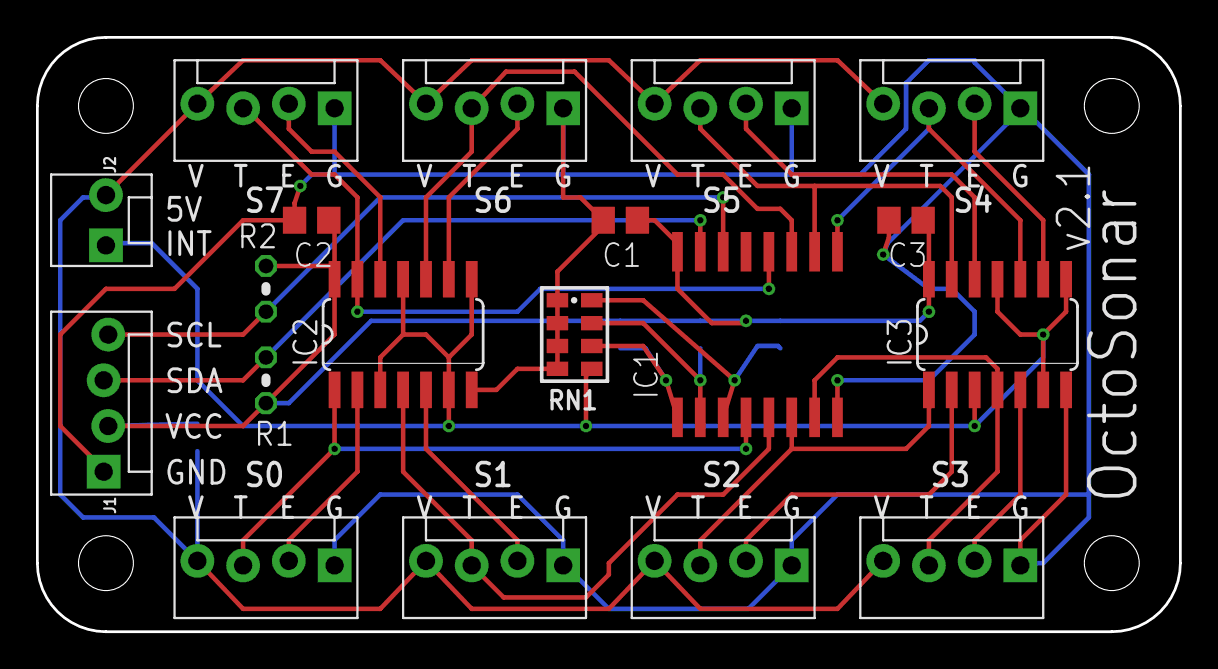
[picture p460: board octosonar.brd from above]

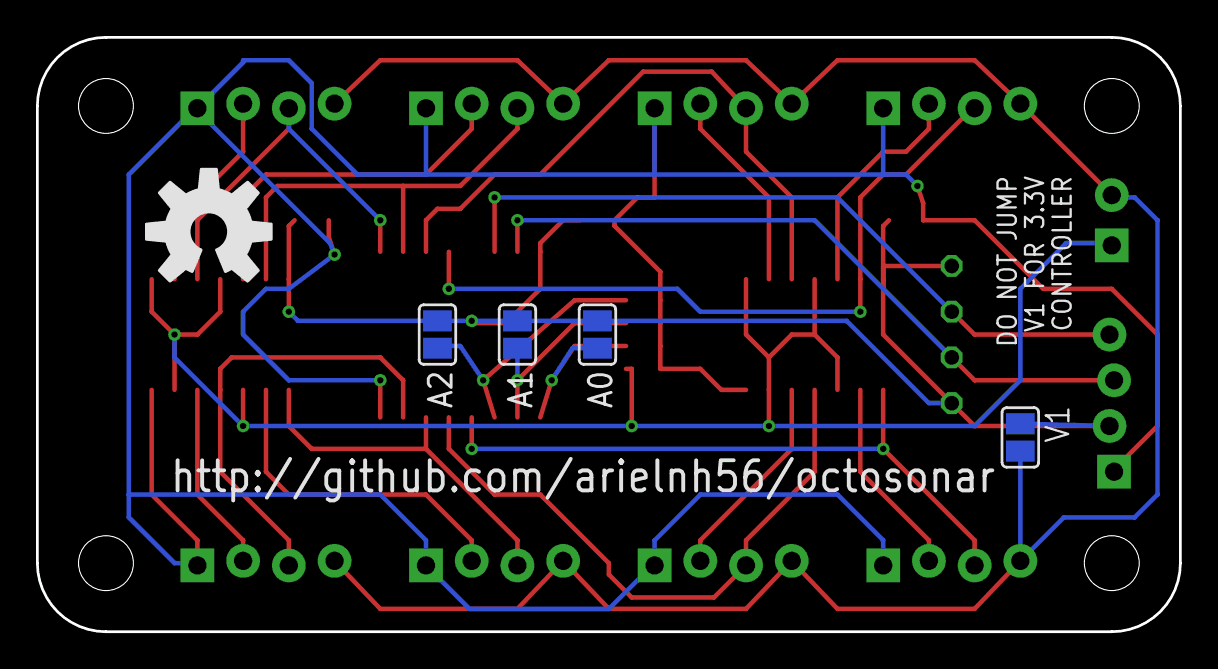
[picture p461: board octosonar.brd from below]

Board: 2 copper layers, 63.5 x 33.0 mm, 28 parts (5 on the bottom side), 25 nets.

Other parts of the board:
U$1, U$2, U$3, U$4: STAND-OFF-TIGHT
U$5: OSHW-LOGO-L
