unlegitGurke/RC-Car/Electronics/Octosonar/OctoSonar-master/extras/eagle/octosonarX2/octosonarX2.brd

## EAGLE design Electronics/Octosonar/OctoSonar-master/extras/eagle/octosonarX2/octosonarX2.brd (2021-07-09)

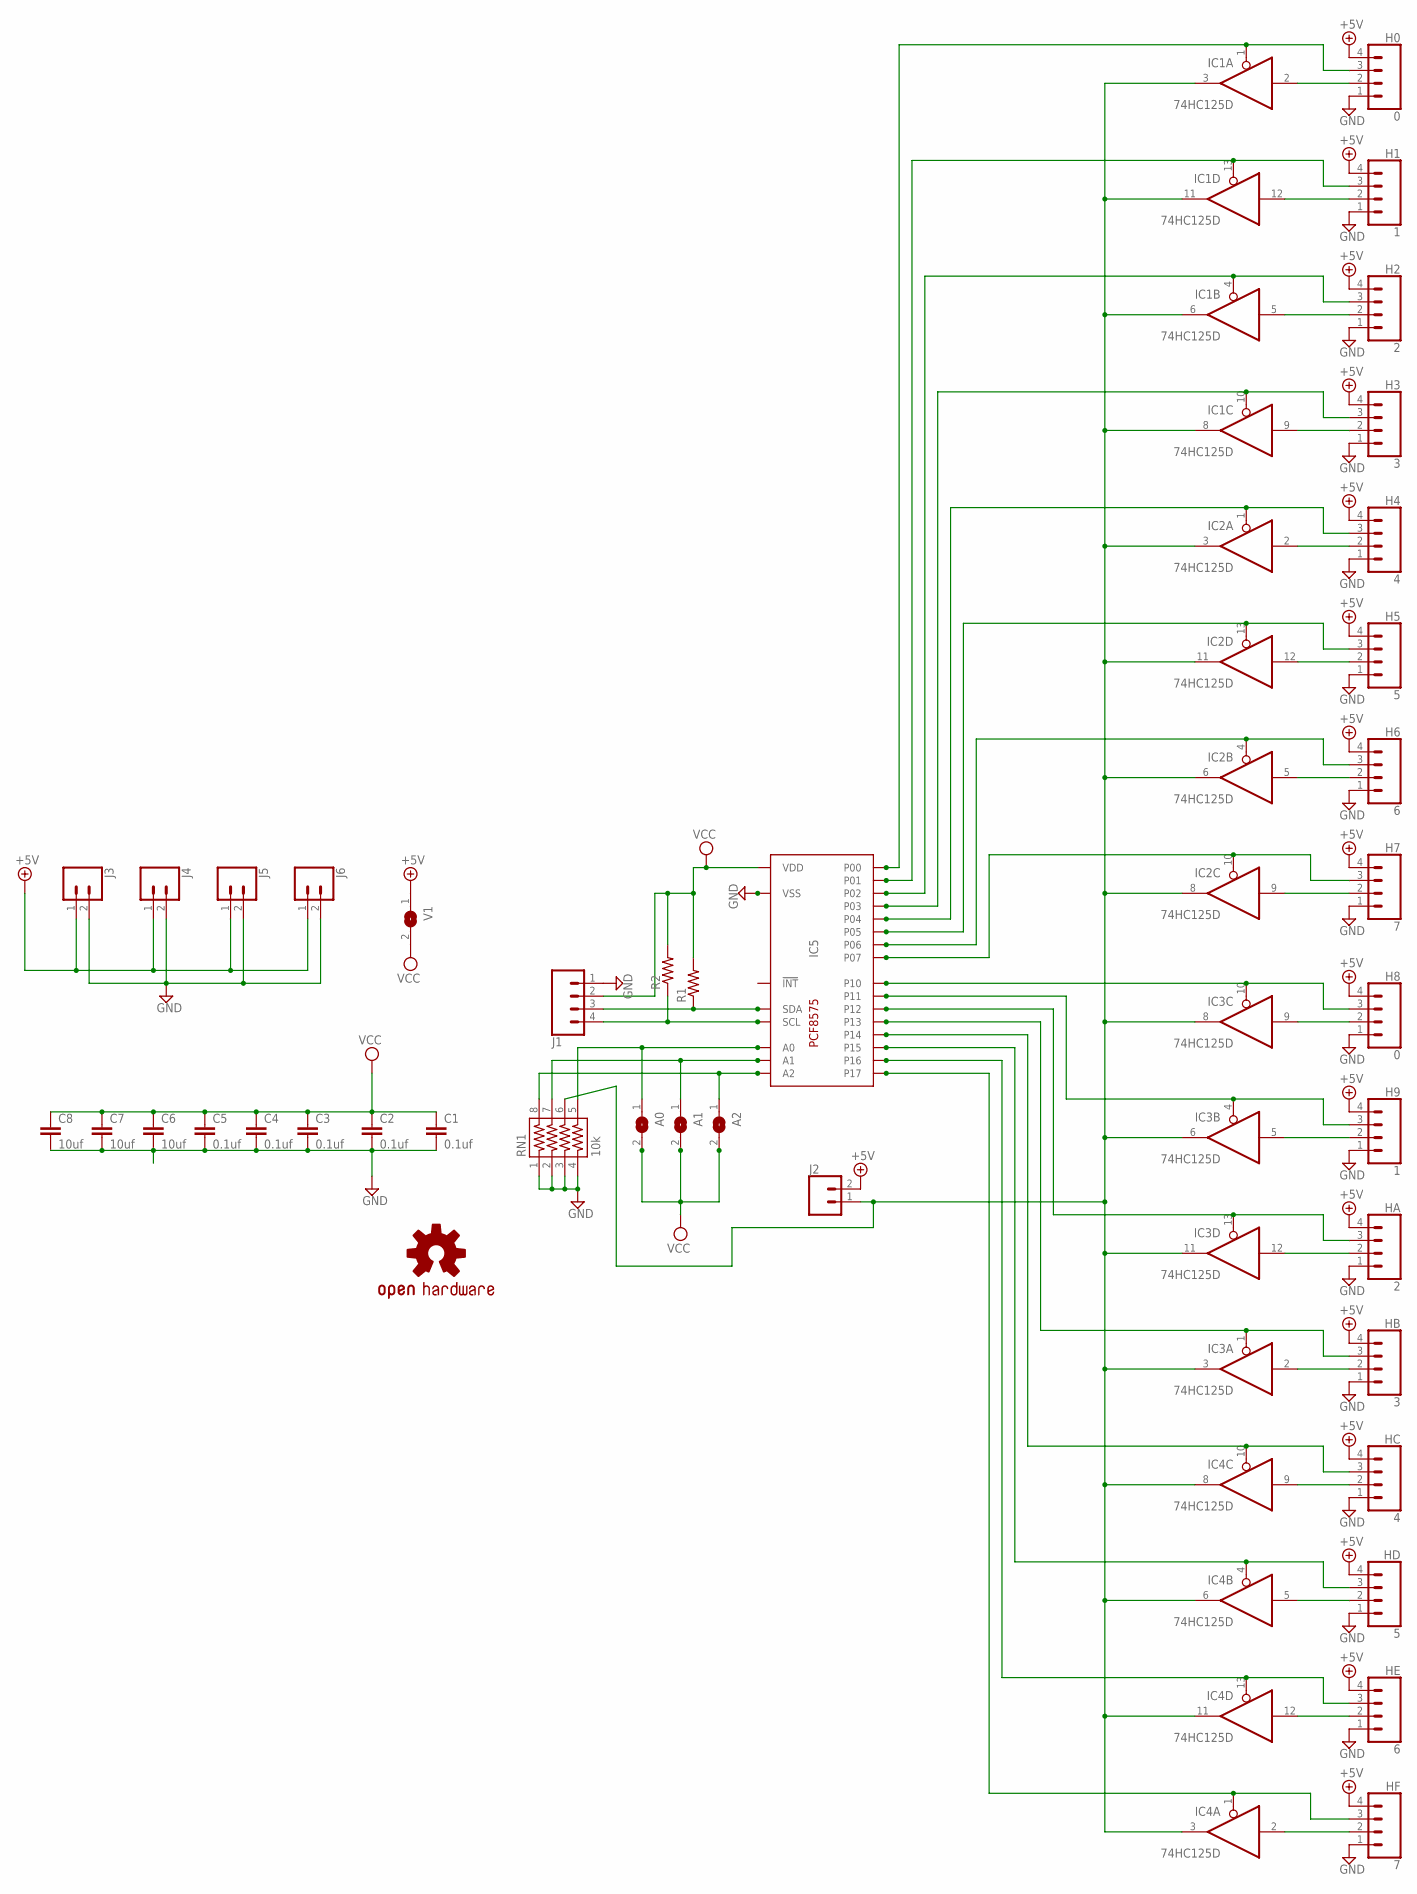
[picture p462: schematic octosonarX2.sch]

Parts:
A0, A1, A2: SJ
C1, C2, C3, C4, C5: 0.1uf; C0603
C6: 10uf; C0603
C7, C8: 10uf; C0805
H0, H8: 0; 1X04
H1, H9: 1; 1X04
H2: 2; 1X04
H3: 3; 1X04
H4: 4; 1X04
H5: 5; 1X04
H6: 6; 1X04
H7: 7; 1X04
HA: 2; 1X04
HB: 3; 1X04
HC: 4; 1X04
HD: 5; 1X04
HE: 6; 1X04
HF: 7; 1X04
IC1, IC2, IC3, IC4: 74HC125D; SO14
IC5: PCF8575C; SOP24
J1: CONN_04POLAR_LOCK; MOLEX-1X4_LOCK
J2: CONN_02POLAR_LOCK; MOLEX-1X2_LOCK
J3, J4, J5, J6: CONN_02; 1X02
LOGO1: OSHW-LOGOL; OSHW-LOGO-L
R1, R2: R-US_0204/2V; 0204V
RN1: 10k; 743-8
V1: SJ

Connections:
+5V: H0.4, H1.4, H2.4, H3.4, H4.4, H5.4, H6.4, H7.4, H8.4, H9.4, HA.4, HB.4, HC.4, HD.4, HE.4, HF.4, J2.2, J3.1, J4.1, J5.1, J6.1, V1.1
GND: C1.2, C2.2, C3.2, C4.2, C5.2, C6.2, C7.2, C8.2, H0.1, H1.1, H2.1, H3.1, H4.1, H5.1, H6.1, H7.1, H8.1, H9.1, HA.1, HB.1, HC.1, HD.1, HE.1, HF.1, IC1.7 (GND), IC2.7 (GND), IC3.7 (GND), IC4.7 (GND), IC5.P$12 (VSS), J1.1, J3.2, J4.2, J5.2, J6.2, RN1.1, RN1.2, RN1.3, RN1.4
INT: IC1.3 (O), IC1.6 (O), IC1.8 (O), IC1.11 (O), IC2.3 (O), IC2.6 (O), IC2.8 (O), IC2.11 (O), IC3.3 (O), IC3.6 (O), IC3.8 (O), IC3.11 (O), IC4.3 (O), IC4.6 (O), IC4.8 (O), IC4.11 (O), J2.1, RN1.6
unnamed: H8.3, IC3.10 (OE), IC5.P$13 (P10)
unnamed: H9.3, IC3.4 (OE), IC5.P$14 (P11)
unnamed: HA.3, IC3.13 (OE), IC5.P$15 (P12)
unnamed: HB.3, IC3.1 (OE), IC5.P$16 (P13)
unnamed: HC.3, IC4.10 (OE), IC5.P$17 (P14)
unnamed: HD.3, IC4.4 (OE), IC5.P$18 (P15)
unnamed: HE.3, IC4.13 (OE), IC5.P$19 (P16)
unnamed: HF.3, IC4.1 (OE), IC5.P$20 (P17)
unnamed: H8.2, IC3.9 (I)
unnamed: H9.2, IC3.5 (I)
unnamed: HA.2, IC3.12 (I)
unnamed: HB.2, IC3.2 (I)
unnamed: HD.2, IC4.5 (I)
unnamed: HE.2, IC4.12 (I)
unnamed: HF.2, IC4.2 (I)
unnamed: HC.2, IC4.9 (I)
unnamed: A2.1, IC5.P$3 (A2), RN1.8
unnamed: A1.1, IC5.P$2 (A1), RN1.7
unnamed: A0.1, IC5.P$21 (A0), RN1.5
unnamed: H0.3, IC1.1 (OE), IC5.P$4 (P00)
unnamed: H1.3, IC1.13 (OE), IC5.P$5 (P01)
unnamed: H2.3, IC1.4 (OE), IC5.P$6 (P02)
unnamed: H3.3, IC1.10 (OE), IC5.P$7 (P03)
unnamed: H4.3, IC2.1 (OE), IC5.P$8 (P04)
unnamed: H5.3, IC2.13 (OE), IC5.P$9 (P05)
unnamed: H6.3, IC2.4 (OE), IC5.P$10 (P06)
unnamed: H7.3, IC2.10 (OE), IC5.P$11 (P07)
unnamed: H0.2, IC1.2 (I)
unnamed: H1.2, IC1.12 (I)
unnamed: H2.2, IC1.5 (I)
unnamed: H3.2, IC1.9 (I)
unnamed: H5.2, IC2.12 (I)
unnamed: H6.2, IC2.5 (I)
unnamed: H7.2, IC2.9 (I)
unnamed: H4.2, IC2.2 (I)
SCL: IC5.P$22 (SCL), J1.4, R2.1
SDA: IC5.P$23 (SDA), J1.3, R1.1
VCC: A0.2, A1.2, A2.2, C1.1, C2.1, C3.1, C4.1, C5.1, C6.1, C7.1, C8.1, IC1.14 (VCC), IC2.14 (VCC), IC3.14 (VCC), IC4.14 (VCC), IC5.P$24 (VDD), J1.2, R1.2, R2.2, V1.2

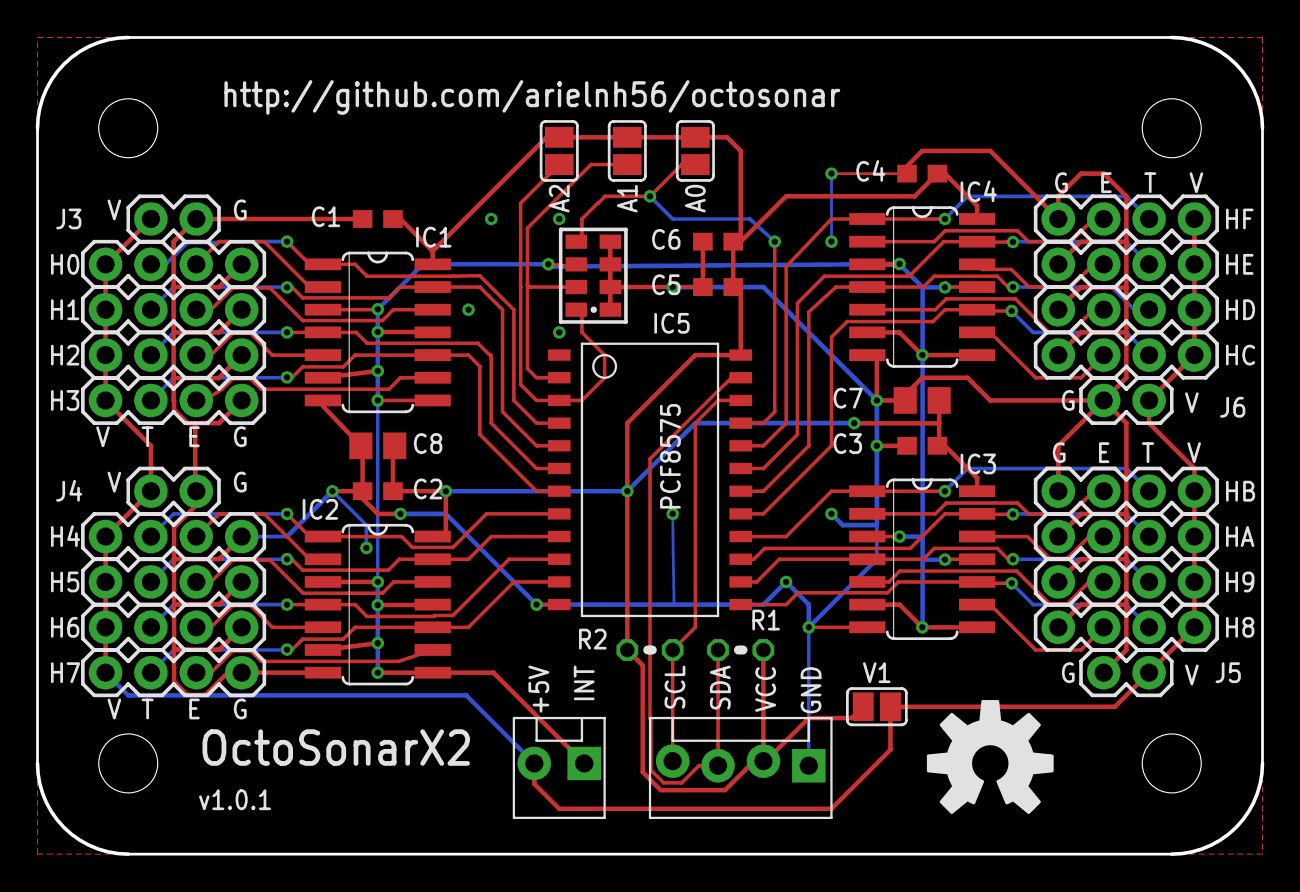
[picture p463: board octosonarX2.brd from above]

Board: 2 copper layers, 68.6 x 45.7 mm, 47 parts (0 on the bottom side), 41 nets.

Other parts of the board:
U$2, U$3, U$4, U$5: STAND-OFF
