unlegitGurke/RC-Car/(commit log)

2020-09-25 V1.1
    V1.1
    [Motor__Mount.cfg]
2020-09-29 V.1.2
    V.1.2
    [Motor__Mount.cfg, Servo.cfg]
2020-10-13 V1.4
    V1.4
    [Asm1.cfg, Motor__Mount.cfg, Servo.cfg]
2020-10-13 V1.5
    V1.5
    [Asm1.cfg]
2020-10-16 V1.6
    V1.6
    [Asm1.cfg]
2020-10-16 V1.12
    V1.12
    [Asm1.cfg]
2020-10-24 V1.14
    V1.14
    [Asm1.cfg, Cybertruck Full-scale Eng CAD.stl]
2020-10-26 V1.15
    V1.15
    [Asm1.cfg]
2020-10-26 V1.16
    V1.16
    [Asm1.cfg]
2020-10-27 V1.19
    V1.19
    [Asm1.cfg]
2020-10-27 V1.20
    V1.20
    [Slipclutch.cfg]
2020-10-28 V1.22
    V1.22
    [Asm1.cfg, Differntial.cfg, MotorGearing.cfg]
2020-10-28 V1.23
    V1.23
    [Asm1.cfg]
2020-10-28 V1.24
    V1.24
    [Asm1.cfg, Cable_Box_Top.3mf, Cable_Box_Top.stl, Reciever_Box_Bottom.3mf, Reciever_Box_Bottom.stl, Reciever_Box_Top.3mf, Reciever_Box_Top.stl, Stöpsel.3mf]
2020-10-28 V1.26
    V1.26
    [Slipclutch.cfg]
2020-10-29 V1.32
    V1.32
    [Slipclutch.cfg]
2020-10-29 V1.34
    V1.34
    [MotorGearing.cfg, Slipclutch.cfg]
2020-10-30 V1.38
    V1.38
    [Differntial.cfg, MotorGearing.cfg]
2020-10-31 V1.41
    V1.41
    [MotorGearing.cfg, Slipclutch.cfg]
2020-10-31 V1.42
    V1.42
    [MotorGearing.cfg]
2020-11-01 V1.43
    V1.43
    [Chassis.cfg]
2020-11-01 V1.44
    V1.44
    [Chassis.cfg, Drivetrain.cfg, MotorGearing.cfg]
2020-11-01 V1.45
    V1.45
    [Chassis.cfg]
2020-11-02 V1.47
    V1.47
    [Chassis.cfg]
2020-11-02 V1.48
    V1.48
    [Chassis.cfg, MotorGearing.cfg]
2020-11-02 V1.49
    V1.49
    [Chassis.cfg]
2020-11-02 V1.50
    V1.50
    [Chassis.cfg]
2020-11-02 V1.51
    V1.51
    [Chassis.cfg]
2020-11-02 V1.53
    V1.53
    [Chassis.cfg]
2020-11-02 V1.54
    V1.54
    [Chassis.cfg]
2020-11-02 V1.55
    V1.55
    [Chassis.cfg]
2020-11-03 V1.57
    V1.57
    [Chassis.cfg]
2020-11-05 V1.58
    V1.58
    [Chassis.cfg]
2020-11-06 V1.59
    V1.59
    [Chassis.cfg]
2021-01-07 V1.60
    V1.60
    [Chassis.cfg]
2021-01-08 V1.61
    V1.61
    [Cybertruck Full-scale Eng CAD.stl]
2021-01-08 V1.62
    V1.62
    [Chassis.cfg, Chassis_Neu.cfg]
2021-01-08 V1.63
    V1.63
    [Asm1.cfg]
2021-01-08 V1.64
    V1.64
    [Chassis.cfg, Chassis_Neu.cfg]
2021-01-08 V1.65
    V1.65
    [Asm1.cfg, Differntial.cfg]
2021-01-08 V1.66
    V1.66
    [Asm1.cfg]
2021-01-08 V1.67
    V1.67
    [Asm1.cfg, Differntial.cfg]
2021-01-08 V1.68
    V1.68
    [Differntial.cfg]
2021-01-08 V1.69
    V1.69
    [Asm1.cfg]
2021-01-08 V1.73
    V1.73
    [Asm1.cfg, Chassis_Neu.cfg, Drivetrain.cfg]
2021-01-08 V1.77
    V1.77
    [Differntial.cfg]
2021-01-08 V1.79
    V1.79
    [Differntial.cfg]
2021-01-09 V1.80
    V1.80
    [Differntial.cfg]
2021-01-09 V1.81
    V1.81
    [Differntial.cfg, Spider_Gears.cfg]
2021-01-09 V1.83
    V1.83
    [Differntial.cfg]
2021-01-09 V1.85
    V1.85
    [Differntial.cfg]
2021-01-09 V1.87
    V1.87
    [Differntial.cfg]
2021-01-09 V1.88
    V1.88
    [Differntial.cfg]
2021-01-09 V1.89
    V1.89
    [Differntial.cfg, Differnzial.cfg]
2021-01-09 V1.90
    V1.90
    [Differnzial.cfg]
2021-01-10 V1.91
    V1.91
    [Drivetrain.cfg]
2021-01-10 V1.92
    V1.92
    [Drivetrain.cfg]
2021-01-10 V1.93
    V1.93
    [Achse.cfg]
2021-01-10 V1.94
    V1.94
    [Drivetrain.cfg]
2021-01-14 V1.98
    V1.98
    [Achse.cfg]
2021-01-20 V1.99
    V1.99
    [Chassis.cfg, Chassis_Neu.cfg, Chassis_V2.0.cfg, Chassis_V3.0.cfg, Drivetrain.cfg]
2021-01-20 V2.0
    V2.0
    [Chassis.cfg, Chassis_V3.0.cfg, Motor__Mount.cfg]
2021-01-28 V2.1
    V2.1
    [Chassis_V3.0.cfg]
2021-01-28 V2.2
    V2.2
    [Chassis_V3.0.cfg]
2021-02-07 V2.3
    V2.3
    [Chassis_V3.0.cfg]
2021-02-07 V2.5
    V2.5
    [Chassis.cfg, Chassis_V3.0.cfg]
2021-02-07 V2.6
    V2.6
    [Chassis_V3.0.cfg]
2021-02-07 V2.7
    V2.7
    [2.54 mm DUPONT MALE PIN HEADER, IO, 2X20, RPi4ModelB.SLDPRT, 2.54 mm DUPONT MALE PIN HEADER, IO, 2X40, RPi4ModelB.SLDPRT, 2.54 mm DUPONT MALE PIN HEADER, POE, 2X2, RPi4ModelB.SLDPRT, 2X USB2.0 PORTS, RPi4ModelB.SLDPRT, 2X USB3.0 PORTS, RPi4ModelB.SLDPRT, 91D77 D9WHV 778K, 4 GB LPDDR4 SDRAM, RPi4ModelB.SLDPRT, Broadcom BCM2711B0 CPU, RPi4ModelB.SLDPRT, Broadcom BCM54213PE Gigabit Ethernet Transcei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]
2021-02-08 V3.0
    V3.0
    [Chassis_V3.0.cfg]
2021-02-08 V3.1
    V3.1
    Sandri is ein kek
    [Chassis_V3.0.cfg]
2021-02-08 V2.12
    V2.12
    [Chassis_V3.0.cfg]
2021-02-08 V2.13
    V2.13
    [Chassis_V3.0.cfg]
2021-02-09 V2.14
    V2.14
    [Chassis_V3.0.cfg, Chassis_V4.0.cfg, IC Cooler.SLDPRT, LM2596 DC to DC Buck Converter 3 A.x_t, LM2596 with and without cooler.SLDASM, LM2596S.SLDPRT, TrimmerW203.SLDPRT, converterLM2596.SLDASM]
2021-02-10 V2.15
    V2.15
    [Chassis_V4.0.cfg]
2021-02-11 V2.16
    V2.16
    [Chassis_V4.0.cfg, Getriebe_Mount_Top.cfg, Getriebemount.cfg]
2021-02-11 V2.17
    V2.17
    [Chassis_V4.0.cfg]
2021-02-11 V2.18
    V2.18
    [Chassis_V4.0.cfg]
2021-02-11 V2.21
    V2.21
    [Chassis_V4.0.cfg]
2021-02-14 V2.24
    V2.24
    [Chassis_V4.0.cfg]
2021-02-15 V2.25
    V2.25
    [Chassis_V4.0.cfg]
2021-02-15 V2.26
    V2.26
    [Chassis_V4.0.cfg]
2021-02-15 V2.27
    V2.27
    [Chassis_V4.0.cfg]
2021-02-15 V2.28
    V2.28
    [Chassis_V4.0.cfg]
2021-02-16 V2.29
    V2.29
    [Chassis_V4.0.cfg]
2021-02-16 V2.30
    V2.30
    [Chassis_V4.0.cfg]
2021-02-16 V2.31
    V2.31
    [Chassis_V4.0.cfg]
2021-02-17 V2.32
    V2.32
    [Dämpfung.cfg]
2021-02-18 V2.33
    V2.33
    [Chassis_V4.0.cfg, Dämpfung.cfg]
2021-02-18 V2.34
    V2.34
    [Chassis_V4.0.cfg]
2021-02-18 V2.35
    V2.35
    [Chassis_V4.0.cfg]
2021-02-18 V2.36
    V2.36
    [Chassis_V4.0.cfg]
2021-02-21 V2.37
    V2.37
    [Chassis_V4.0.cfg]
2021-02-23 V2.38
    V2.38
    [Chassis_V4.0.cfg]
2021-02-24 V2.39
    V2.39
    [Chassis_V4.0.cfg]
2021-02-26 V2.41
    V2.41
    [Chassis_V4.0.cfg]
2021-02-27 V2.42
    V2.42
    [A-Arm_Mount_Top.3mf, Chassis_V4.0.cfg, Feder_Mount_Final.3mf, Feder_mount.cfg]
2021-02-27 V2.43
    V2.43
    [Chassis_V4.0.cfg, Feder_mount.cfg]
2021-02-27 V2.44
    V2.44
    [Chassis_V4.0.cfg]
2021-02-28 V2.45
    V2.45
    [Chassis_V4.0.cfg]
2021-02-28 V2.46
    V2,46
    [Chassis_V4.0.cfg, Wheel Hub.cfg]
2021-03-01 V2.47
    V2.47
    [Achse.cfg]
2021-03-03 V2.48
    V2.48
    [Chassis_V4.0.cfg]
2021-03-03 V2.49
    V2.49
    [Chassis_V4.0.cfg, Dämpfung.cfg]
2021-03-05 V2.50
    V2.50
    [Chassis_V4.0.cfg, Dämpfung.cfg]
2021-03-05 V2.51
    V2.51
    [Chassis_V4.0.cfg, Dämpfung.cfg, XT90 Connector v5.cfg]
2021-03-06 V2.52
    V2.52
    [Chassis_V4.0.cfg]
2021-03-06 V2.53
    V2.53
    [Chassis_V4.0.cfg]
2021-03-07 V2.54
    V2.54
    [Chassis_V4.0.cfg]
2021-03-07 V2.55
    V2.55
    [Chassis_V4.0.cfg]
2021-03-08 V2.56
    V2.56
    [Chassis_V4.0.cfg]
2021-03-08 V2.58
    V2.58
    [Chassis_V4.0.cfg, DC-DC CC CV Buck Converter Step-down Power Supply Module 7-40V to 1-35V 12A.cfg, Raspberry Pi 4 Model B.cfg]
2021-03-08 V2.59
    V2.59
    [Chassis_V4.0.cfg]
2021-03-09 V2.60
    V2.60
    [Chassis_V4.0.cfg]
2021-03-10 V2.61
    V2.61
    [Chassis_V4.0.cfg]
2021-03-13 V2.62
    V2.62
    [Chassis_V4.0.cfg]
2021-03-14 V2.63
    V2.63
    [Chassis_V4.0.cfg, DC-DC CC CV Buck Converter Step-down Power Supply Module 7-40V to 1-35V 12A.cfg]
2021-03-14 V2.64
    V2.64
    [Chassis_V4.0.cfg]
2021-03-18 V2.66
    V2.66
    [Chassis_V4.0.cfg]
2021-03-20 V2.67
    V2.67
    [Chassis_V4.0.cfg]
2021-03-20 V2.68
    V2.68
    [Chassis_V4.0.cfg]
2021-03-21 V2.69
    V2.69
    [Chassis_V4.0.cfg]
2021-03-22 V2.70
    V2.70
    [Chassis_V4.0.cfg]
2021-03-22 V2.71
    V2.71
    [Chassis_V4.0.cfg, Feder_Mount_Vorne.cfg]
2021-03-22 V2.72
    V2.72
    [Chassis_V4.0.cfg]
2021-03-22 V2.73
    V2.73
    [Chassis_V4.0.cfg]
2021-03-23 V2.74
    V2.74
    [Chassis_V4.0.cfg]
2021-03-23 V2.75
    V2.75
    [Chassis_V4.0.cfg]
2021-04-08 V2.76
    V2.76
    [Chassis_V4.0.cfg, Servo_50KG.cfg]
2021-04-09 V2.77
    V2.77
    [Chassis_V4.0.cfg, Servo_50KG.cfg]
2021-04-11 V2.78
    V2.78
    [Abdeckung_Driveshaft.3mf, Abdeckung_Driveshaft.stl, Chassis_V4.0.cfg]
2021-04-12 V2.79
    V2.79
    [Chassis_V4.0.cfg]
2021-04-15 V2.80
    V2.80
    [Chassis_V4.0.cfg]
2021-04-15 V2.81
    V2.81
    [Chassis_Brace.psm, Chassis_V4.0.cfg]
2021-04-16 V2.82
    V2.82
    [Chassis_Brace.psm, Chassis_V4.0.cfg]
2021-04-16 V2.83
    V2.83
    [Chassis_V4.0.cfg]
2021-04-17 V2.85
    V2.85
    [Brezel+Bumper.cfg]
2021-04-17 V2.86
    V2.86
    [Chassis_V4.0.cfg]
2021-04-17 V2.88
    V2.88
    [Chassis_V4.0.cfg]
2021-04-17 V2.89
    V2.89
    [Chassis_V4.0.cfg]
2021-04-17 V2.91
    V2.91
    [Chassis_V4.0.cfg]
2021-04-17 V2.93
    V2.93
    [Chassis_V4.0.cfg]
2021-04-18 V2.94
    V2.94
    [Chassis_V4.0.cfg]
2021-04-18 V2.95
    V2.95
    [Chassis_V4.0.cfg]
2021-04-18 V2.96
    V2.96
    [Chassis_V4.0.cfg]
2021-04-18 V2.97
    V2.97
    [Chassis_V4.0.cfg]
2021-04-19 V2.98
    V2.98
    [Arduino Nano R3 ATmega 328P.cfg, Chassis_V4.0.cfg, Contacts.psm, Contacts_1.psm, Engagement.psm, Leiterplatte v4.cfg, PBD-10.step, PBD-10R.step]
2021-04-19 V2.99
    V2.99
    [Arduino Nano R3 ATmega 328P.cfg, Bumper_back_2.3mf, Chassis_V4.0.cfg, xhp-3.stl]
2021-04-21 V3.03
    V3.03
    [Chassis_V4.0.cfg]
2021-04-21 V3.03
    Completed Felgen
    [Felge.cfg]
2021-04-21 Revert "Merge branch 'master' of https://github.com/unlegitGurke/RC-Car"
    This reverts commit ddf1e47bf963c3316aad6ae7b0fb9c56f44eb91d, reversing
    changes made to 7a6e1e06bd52dd397cf48d815fbd9433f069b4bd.
    [Chassis_V4.0.cfg]
2021-04-21 V3.04
    V3.04
    [Chassis_V4.0.cfg, WS2812B Black 60leds_m v7.cfg]
2021-04-21 V3.05
    V3.05
    [Chassis_V4.0.cfg, WS2812B_neu.cfg]
2021-04-22 V3.06
    V3.06
    [Chassis_V4.0.cfg]
2021-04-23 V3.07
    V3.07
    [Chassis_V4.0.cfg]
2021-04-23 V3.08
    Felge is fertig
    LESSS GOOOOOOOOOO
    [Felge.cfg]
2021-04-23 V3.09
    Felgen Blanks
    [Felge.cfg]
2021-04-23 V3.10
    V3.10
    [Chassis_V4.0.cfg]
2021-04-23 V3.11
    V3.11
    [Chassis_V4.0.cfg]
2021-04-23 V3.12
    Felge 2.0 und Felgen Blanks
    [Felge.cfg]
2021-04-23 V3.13
    V3.13
    [Bumper_front.3mf, Chassis_V4.0.cfg]
2021-04-23 V3.14
    V3.14
    [Felge.cfg]
2021-04-23 V3.15
    V3.15
    [Chassis_V4.0.cfg, Felge.cfg]
2021-04-23 V3.16
    V3.16
    [Chassis_V4.0.cfg, Dateieigenschaften.xlsx]
2021-04-23 V3.15
    Neues Felgendesign
    Mittelpart nach vorne verschoben
    [Felge.cfg]
2021-04-24 V3.17
    V3.17
    [Chassis_V4.0.cfg]
2021-04-24 V3.18
    felge go vrrrrr
    [Felge.cfg]
2021-04-24 V3.19
    V3.19
    [Chassis_V4.0.cfg, Felge.cfg]
2021-04-24 V3.20
    V3.20
    [Chassis_V4.0.cfg, Feder_Mount_Final.stl]
2021-04-24 V3.20
    Felge fertiggestellt!
    Render wurden hinzugefügt im Keyshot Ordner.
    Bilder wurden hinzugefügt im /Keyshot/Bilder Ordner.
    Quickstart Guide ist im Keyshot Ordner.
    [Felge.cfg]
2021-04-24 V3.22
    V3.22
    [Chassis_V4.0.cfg, Felge.cfg]
2021-04-24 V3.23
    V3.23
    [Chassis_V4.0.cfg, WS2812B_neu.cfg]
2021-04-24 V3.24
    V3.24
    [Chassis_V4.0.cfg]
2021-04-24 V3.25
    V3.25
    [Felge.cfg]
2021-04-25 V3.26
    V3.26
    [Chassis_V4.0.cfg, Dateieigenschaften.xlsx, Felge.cfg]
2021-04-25 V3.27
    V3.27
    [A-Arm_Mount_Top.3mf, Abdeckung_Driveshaft.3mf, Bumper_back_2.3mf, Bumper_front.3mf, Cable_Box_Top.3mf, Cable_Box_Top.stl, Feder_Mount_Final.3mf, Reciever_Box_Bottom.3mf]
2021-04-25 V3.28
    V3.28
    [Chassis_V4.0.cfg]
2021-04-25 V3.29
    V3.29
    [Bumper_back_2.3mf, Bumper_front.3mf, Chassis_V4.0.cfg, Leiterplatte v4.cfg, Leiterplatte v6.cfg, Leiterplatte_Final.cfg]
2021-04-25 V3.30
    V3.30
    [Chassis_V4.0.cfg]
2021-04-26 V3.31
    V3.31
    [Chassis_V4.0.cfg]
2021-04-27 V3.32
    V3.32
    [Chassis_V4.0.cfg]
2021-04-29 V3.33
    V3.33
    [Chassis_V4.0.cfg]
2021-04-30 V3.34
    V3.34
    [Chassis_V4.0.cfg, Dateieigenschaften.xlsx]
2021-04-30 V3.38
    V3.38
    [Chassis_V4.0.cfg]
2021-05-01 V3.41
    V3.41
    [Chassis_V4.0.cfg, Dateieigenschaften.xlsx, Motor__Mount.cfg]
2021-05-11 V3.42
    V3.42
    [Chassis_V4.0.cfg, Dateieigenschaften.xlsx, Servoarm.3mf]
2021-05-11 V3.45
    V3.45
    [Chassis_V4.0.cfg]
2021-05-11 V3.46
    V3.46
    [Dateieigenschaften.xlsx]
2021-05-12 V3.47
    V3.47
    [Chassis_V4.0.cfg, Felge.cfg]
2021-05-14 V3.51
    V3.51
    [Chassis_V4.0.cfg]
2021-05-23 V3.52
    V3.52
    [Chassis_V4.0.cfg]
2021-05-23 V3.53
    V3.53
    [Chassis_V4.0.cfg, Dateieigenschaften.xlsx]
2021-05-24 V3.55
    V3.55
    [Asm1.cfg, Chassis_Brace.psm, Chassis_V4.0.cfg, Dateieigenschaften.xlsx]
2021-05-28 V3.58
    V3.58
    [Chassis_Brace.psm, Chassis_V4.0.cfg, Dateieigenschaften.xlsx]
2021-05-28 V3.59
    V3.59
    [Chassis_Brace.psm, Chassis_V4.0.cfg]
2021-05-28 V3.60
    V3.60
    [Chassis_Brace.psm]
2021-06-05 V3.61
    VV3.61
    [Chassis_V4.0.cfg]
2021-06-05 V3.62
    V3.62
    [Chassis_V4.0.cfg]
2021-06-05 V3.63
    V3.63
    [Chassis_V4.0.cfg]
2021-06-05 V3.44
    getriebe mount final gezeichnet
    pressfits fehlen
2021-06-06 V3.66
    V3.66
    [Bauteileigenschaften.xlsx, Chassis_V4.0.cfg, Dateieigenschaften.xlsx]
2021-06-06 V3.68
    V3.68
    [Chassis_V4.0.cfg]
2021-06-07 V3.69
    V3.69
    [Chassis_V4.0.cfg]
2021-06-09 V3.71
    V3.71
    [Chassis_V4.0.cfg]
2021-06-10 V3.72
    getriebe mount final dtf ohne rauheit
2021-06-10 V3.73
    getriebe mount final fertig
2021-06-10 V3.74
    V3.74
    [Chassis_V4.0.cfg]
2021-06-11 V3.76
    V3.76
    [Asm1.cfg, Bauteileigenschaften.xlsx, Chassis_Brace.psm, Chassis_V4.0.cfg, Motor__Mount.cfg]
2021-06-12 V3.77
    V3.77
    [Chassis_V4.0.cfg]
2021-06-12 V3.78
    V3.78
    [Chassis_V4.0.cfg, Elektroschaltplan.spl7]
2021-06-14 V3.79
    V3.79
    [Chassis_V4.0.cfg]
2021-06-14 V3.81
    V3.81
    [Asm1.cfg, Bauteileigenschaften.xlsx, Chassis_Brace.psm, Chassis_V4.0.cfg, Motor__Mount.cfg]
2021-06-15 V3.83
    V3.83
    [Bauteileigenschaften.xlsx, Chassis_V4.0.cfg]
2021-06-16 V3.84
    V3.84
    [Chassis_V4.0.cfg]
2021-06-16 V3.87
    V3.87
    [Chassis_V4.0.cfg, Dämpfung.cfg]
2021-06-17 V3.91
    A arm oben bemaßt
    getriebe mount final finalisiert
2021-06-17 V3.90
    V3.90
    [Chassis_V4.0.cfg]
2021-06-18 V3.93
    V3.93
    [Chassis_V4.0.cfg, Differnzial.cfg]
2021-06-18 V3.97
    V3.97
    [Chassis_V4.0.cfg]
2021-06-18 V4.01
    V4.01
    [Bauteileigenschaften.xlsx, Chassis_V4.0.cfg]
2021-06-19 4.02
    A arm oben und unten rdy
2021-06-19 V4.03
    V4.03
    [Chassis_V4.0.cfg, Slipclutch_Explosion.cfg]
2021-06-20 V4.08
    V4.08
    [Chassis_Brace.psm]
2021-06-20 V4.11
    V4.11
    [Castle Neu 2028 Motor.cfg, Maytech_VESC6_200a_1644410363.214.cfg]
2021-06-20 V4.14
    V4.14
    [Castle Neu 2028 Motor.STEP, Castle Neu 2028 Motor.cfg, Chassis_V4.0.cfg, Maytech VESC6 200a.stp]
2021-06-22 V4.16
    V4.16
    [Chassis_Brace.psm, Chassis_V4.0.cfg, Maytech_VESC6_200a_1644410363.214.cfg]
2021-06-22 V4.17
    V4.17
    [Maytech_VESC6_200a_1644410363.214.cfg]
2021-06-22 V4.18
    V4.18
    [Castle Neu 2028 Motor.cfg, Chassis_V4.0.cfg, Motor__Mount.cfg]
2021-06-22 V4.20
    NICE
    [Castle Neu 2028 Motor.STEP, Castle Neu 2028 Motor.cfg, Chassis_V4.0.cfg]
2021-06-23 V4.21
    V4.21
    [Chassis_V4.0.cfg, Grundplatte_V4.0.3mf, Grundplatte_V4.0.dxf, Grundplatte_V4.0.stl, Maytech_VESC6_200a_1644410363.214.cfg]
2021-06-23 V4.22
    V4.22
    [Chassis_V4.0.cfg]
2021-06-23 V4.23
    V4.23
    [Abdeckplatte_Hinten1.dxf, Abdeckplatte_Hinten2.dxf, Chassis_V4.0.cfg]
2021-07-04 V4.24
    V4.24
    [Chassis_V4.0.cfg]
2021-07-04 V4.26
    V4.26
    [Chassis_V4.0.cfg]
2021-07-05 V4.27
    V4.27
    [Chassis_V4.0.cfg]
2021-07-09 V4.28
    V4.28
    [Chassis_V4.0.cfg, hcsr04bracket.brd, hcsr04bracket.sch, octosonar-feather.brd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]
2021-07-19 V4.29
    V4.29
    [Chassis_V4.0.cfg]
2021-07-22 V4.30
    V4.30
    [Chassis_Brace.psm, Chassis_V4.0.cfg]
2021-08-04 V4.31
    V4.31
    [Chassis_V4.0.cfg]
2021-09-09 V4.32
    V4.32
    [Chassis_V4.0.cfg]
2021-09-10 V4.33
    V4.33
    [copper_bottom.gbr, copper_top.gbr, drill_1_16.xln, gerber_job.gbrjob, profile.gbr, silkscreen_bottom.gbr, silkscreen_top.gbr, soldermask_bottom.gbr]
2021-09-10 V4.34
    V4.34
    [Chassis_V4.0.cfg]
2021-09-10 V4.35
    V4.35
    [Chassis_V4.0.cfg, test Kotflügel.cfg]
2021-09-11 V4.36
    V4.36
    [Chassis_V4.0.cfg]
2021-09-14 V4.37
    V4.37
    [Chassis_V4.0.cfg]
2021-09-18 V4.38
    V4.38
    [Chassis_V4.0.cfg, Einkaufsliste.xlsx]
2021-10-21 V4.39
    V4.39
    [Chassis_V4.0.cfg, Einkaufsliste.xlsx]
2021-10-23 V4.40
    V4.40
    [Chassis_V4.0.cfg]
2021-10-25 V4.41
    V4.41
    [Felgen Horn.3mf, Felgen Rohr.3mf, LipoMount.3mf, Mitte.3mf, Reciever_Box_Bottom.3mf, Servo_Mount.3mf]
2021-10-25 V4.42
    V4.42
    [Chassis_V4.0.cfg]
2021-10-25 V4.43
    V4.43
    [Chassis_Brace.psm, Chassis_V4.0.cfg]
2021-10-26 V4.44
    V4.44
    [Chassis_V4.0.cfg, RX-M2.5x5.7.step, RX-M6x12.7.step, RX-M8x12.7.step, ruthex_RX-M2x4.step, ruthex_RX-M3x5.7.step, ruthex_RX-M4x8.1.step, ruthex_RX-M5x9.5.step]
2021-10-27 V4.45
    V4.45
    [4pin_magnetic_connector_female v4.f3d, 4pin_magnetic_connector_male v5.f3d, Chassis_V4.0.cfg, Pogo_$pin_Female.step, Pogo_$pin_Male.step]
2021-10-29 V4.46
    V4.46
    [Bodymount_hinten.x_t, Chassis_V4.0.cfg]
2021-10-29 V4.47
    V4.47
    [Chassis_V4.0.cfg]
2021-10-29 V4.48
    V4.48
    [Chassis_V4.0.cfg]
2021-10-29 V4.49
    V4.49
    [Chassis_V4.0.cfg]
2021-11-12 V4.50
    V4.50
    [Chassis_V4.0.cfg]
2021-11-25 V4.51
    V4.51
    [Chassis_V4.0.cfg]
2021-11-25 V4.53
    V4.53
    [Chassis_V4.0.cfg]
2021-11-27 V4.54
    V4.54
    [Chassis_V4.0.cfg]
2021-12-06 V4.56
    V4.56
    [Chassis_V4.0.cfg]
2021-12-06 V4.57
    V4.57
    [Chassis_V4.0.cfg]
2021-12-09 V4.58
    V4.58
    [Chassis_V4.0.cfg, octosonarX2 v2.cfg]
2021-12-10 V4.59
    V4.59
    [Chassis_V4.0.cfg]
2021-12-10 V4.60
    V4.60
    [Cam V2.1 v1.step, Chassis_V4.0.cfg, Einkaufsliste.xlsx]
2021-12-11 V4.61
    V4.61
    [Chassis_V4.0.cfg]
2021-12-12 V4.62
    V4.62
    [Chassis_V4.0.cfg]
2021-12-12 V4.63
    V4.63
    [Chassis_V4.0.cfg, Cooler 40x40x10 SBORKA.cfg]
2021-12-12 V4.64
    V4.64
    [Chassis_Brace.psm, Chassis_V4.0.cfg, PCBMount.cfg, Spacer M2 M F 05mm.stp, Spacer M2 M F 06mm.stp, Spacer M2 M F 07mm.stp, Spacer M2 M F 08mm.stp, Spacer M2 M F 09mm.stp]
2021-12-13 V4.65
    V4.65
    [Chassis_Brace.psm, Chassis_V4.0.cfg, PCBMount.cfg]
2021-12-13 V4.66
    V4.66
    [Sensor Range.cfg]
2021-12-13 V4.67
    V4.67
    [Chassis_V4.0.cfg]
2021-12-15 V4.68
    V4.68
    [Chassis_V4.0.cfg]
2021-12-16 V4.69
    V4.69
    [Chassis_V4.0.cfg, JST XHP-2 Housing.step]
2021-12-17 V4.70
    V4.70
    [Chassis_V4.0.cfg, JSN20.stp]
2021-12-17 V4.71
    V4.71
    [Chassis_V4.0.cfg]
2021-12-25 V4.72
    V4.72
    [Chassis_Brace.psm, Chassis_V4.0.cfg]
2021-12-26 V4.73
    V4.73
    [Chassis_V4.0.cfg]
2021-12-26 V4.74
    V4.74
    [Chassis_V4.0.cfg]
2021-12-27 V4.75
    V4.75
    [Chassis_V4.0.cfg]
2021-12-27 V4.76
    V4.76
    [Chassis_V4.0.cfg, Fan Header 4Pin-Body.SLDPRT, Fan Header, 4Pin, 2.54mm, Horizontal.SLDASM, Fan Header, 4Pin, 2.54mm, Horizontal.STEP, Fan Header, 4Pin, 2.54mm, Vertical.SLDASM, Fan Header, 4Pin, 2.54mm, Vertical.STEP, Fan Header, 4Pin, 2.54mm, Vertical.cfg, Fan Header-Pin Horizontal.SLDPRT]
2021-12-27 V4.77
    V4.77
    [4-PIN-PWM-female.SLDPRT, 4-Pin-PWM-female.SLDASM, 4-Pin-PWM-female.cfg, Chassis_V4.0.cfg, Kabelstueck-500┬Ám.SLDPRT, Maytech_VESC6_200a_1644410363.214.cfg, PWM-Crimp.SLDPRT]
2021-12-27 V4.78
    V4.78
    [Asm9.cfg, SPRZĘGŁO KŁOWE GE-T 48-A 60-B Fi35.SLDPRT, SPRZĘGŁO KŁOWE GE-T 48-A 60-B Fi40.SLDPRT, SPRZĘGŁO KŁOWE GE-T 48.SLDASM, SPRZĘGŁO KŁOWE GE-T 48.STEP, SPRZĘGŁO KŁOWE GE-T 48.cfg, clutch.cfg]
2021-12-28 V4.79
    V4.79
    [Chassis_V4.0.cfg]
2021-12-28 V4.80
    V4.80
    [Chassis_V4.0.cfg]
2021-12-28 V4.81
    V4.81
    [Chassis_V4.0.cfg]
2021-12-28 V4.82
    V4.82
    [Chassis_V4.0.cfg]
2021-12-29 V4.83
    V4.83
    [Chassis_V4.0.cfg]
2021-12-29 V4.84
    V4.84
    [Chassis_V4.0.cfg]
2021-12-29 V4.85
    V4.85
    [Chassis_V4.0.cfg, Packages.cfg, Shield_Assembled.cfg, fan header 2.54 3pin.STEP]
2021-12-29 V4.86
    V4.86
    [Chassis_V4.0.cfg]
2021-12-31 V4.87
    V4.87
    [Chassis_V4.0.cfg]
2022-01-01 V4.89
    V4.89
    [Chassis_Brace.psm, Chassis_V4.0.cfg]
2022-01-05 V4.99
    V4.99
    [12mm_Switch.cfg, 12mm_Switch.step, 12mm_push_button.f3d, 12mm_push_button.step, Chassis_V4.0.cfg, FSESC75200 v7.step, FSESC75200_With_Connectors.cfg, JST - PH - SMD (R) - 10Pin - 2.00mm.stp]
2022-01-06 V5.00
    V5.00
    [12mm_Switch.cfg, Chassis_V4.0.cfg]
2022-01-08 V5.02
    V5.02
    [Castle Neu 2028 Motor.cfg, Chassis_V4.0.cfg]
2022-01-09 V5.03
    V5.03
    [Asm2.cfg, Chassis_V4.0.cfg]
2022-01-14 V5.04
    V5.04
    [Einkaufsliste.xlsx]
2022-01-23 V5.05
    V5.05
    [6s 4P halter.cfg, Akku.cfg, Sony US21700VTC6A.STEP, holder 21 hf.SLDPRT, holder 21.SLDPRT, holder 21250.SLDPRT, holder 3cell.SLDASM]
2022-01-26 V5.06
    V5.06
    [Akku.cfg, Chassis_V4.0.cfg, F9.STEP, NF A6x25.f3d, NF A6x25.step]
2022-01-27 V5.07
    V5.07
    [Akku.cfg]
2022-01-29 V5.08
    V5.08
    [Chassis_V4.0.cfg]
2022-02-03 V5.09
    V5.09
    [Car.cfg, Chassis_V4.0.cfg, Grundplatte.dxf, Raspberry Pi 4 Model B.cfg]
2022-02-04 V5.10
    V5.10
    [Chassis_V4.0.cfg]
2022-02-04 V5.11
    V5.11
    [Chassis_V4.0.cfg]
2022-02-05 V5.12
    V5.12
    [Chassis_V4.0.cfg]
2022-02-06 V5.13
    V5.13
    [Chassis_V4.0.cfg]
2022-02-09 V5.14
    V5.14
    [Camera_Mount.dxf, Car.cfg, Ebene_2.dxf, Seitenplatte.dxf, Sensor_Mount.dxf, Vorderplatte.dxf]
2022-02-14 V5.15
    V5.15
    [Chassis_V4.0.cfg, Normteile.xlsx]
2022-02-14 V5.16
    V5.16
    [Chassis_V4.0.cfg, Getriebemount.cfg, Normteile.xlsx]
2022-02-24 V5.17
    V5.17
    [Chassis_V4.0.cfg]
2022-03-01 V5.18
    V5.18
    [Getriebegehäuse.cfg]
2022-03-01 V5.19
    V5.19
    [Chassis_V4.0.cfg, Normteile.xlsx]
2022-03-01 V5.20
    V5.20
    [Chassis_V4.0.cfg, Getriebegehäuse.cfg, Getriebegehäuse_Hinten.cfg]
2022-03-03 V5.21
    V5.21
    [Chassis_V4.0.cfg, Getriebegehäuse_Hinten.cfg]
2022-03-04 V5.23
    V5.23
    [Chassis_V4.0.cfg, Getriebegehäuse_Hinten.cfg, Slipclutch.cfg]
2022-03-07 V5.24
    V5.24
    [EA_Rechnung.xlsx]
2022-03-07 V5.25
    V5.25
    [EA_Rechnung.xlsx]
2022-03-07 V5.26
    V5.26
    [Chassis_V4.0.cfg, Differnzial.cfg, EA_Rechnung.xlsx, Getriebegehäuse_Hinten.cfg, Getriebegehäuse_Vorne.cfg]
2022-03-07 V5.27
    V5.27
    [Chassis_Brace.psm, Chassis_V4.0.cfg, EA_Rechnung.xlsx]
2022-03-08 V5.28
    V5.28
    [Chassis_V4.0.cfg, EA_Rechnung.xlsx]
2022-03-09 V5.29
    V5.29
    [Chassis_V4.0.cfg]
2022-03-09 V5.30
    V5.30
    [EA_Rechnung.xlsx]
2022-03-09 V5.31
    V5.31
    [Chassis_V4.0.cfg, Normteile.xlsx]
2022-03-10 V5.32
    V5.32
    [Normteile.xlsx]
2022-04-04 V5.33
    Réchnungen für des kleingeld
2022-04-10 V5.34
    V5.34
    [EA_Rechnung.xlsx]
2022-04-12 V5.35
    V5.35
    [Chassis_V4.0.cfg, EA_Rechnung.xlsx, Grundplatte_V4.0.dxf, TestCut.dxf]
2022-04-14 V5.36
    V5.36
    [Einkaufsliste.xlsx]
2022-04-15 V5.38
    V5.38
    [Chassis_V4.0.cfg]
2022-04-21 V5.40
    V5.40
    [Chassis_V4.0.cfg, EA_Rechnung.xlsx]
2022-04-24 V5.41
    V5.41
    [Chassis_V4.0.cfg]
2022-05-08 V5.42
    V5.42
    [Chassis_V4.0.cfg, EA_Rechnung.xlsx, Einkaufsliste.xlsx, Schweighofer.xlsx]
2022-05-08 V5.43
    V5.43
    [Chassis_V4.0.cfg]
2022-05-09 V5.44
    V5.44
    [A-Arm_Mount_Hinten_Links.3mf, A-Arm_Mount_Hinten_Rechts.3mf, Wheel_Hub.3mf]
2022-05-09 V5.45
    V5.45
    [Chassis_V4.0.cfg]
2022-05-10 V5.46
    V5.46
    [Chassis_V4.0.cfg, Getriebegehäuse_Hinten.cfg, Getriebegehäuse_Vorne.cfg]
2022-07-16 V5.50
    V5.50
    [Chassis_V5.0.cfg, Getriebegehäuse_Hinten.cfg, Getriebegehäuse_Vorne.cfg]
2022-07-16 V5.51
    V5.51
    [Chassis_V5.0.cfg]
2022-07-19 V5.52
    V5.52
    [A-Arm_unten.3mf, Chassis_V4.0.cfg, Feder_Mount_Final.3mf, Feder_Mount_Final_Vorne.3mf, Rutex_Test.3mf, Rutex_Test_2.3mf, Rutex_Test_3.3mf, Rutex_Test_4.3mf]
2022-07-22 V5.53
    V5.53 // Letzte Version vor Getriebeänderung
    [Bearing_Fake_18_12_4.3mf, Bearing_Fake_26_17_4.3mf, Chassis_V4.0.cfg, Getriebegehäuse_Vorne.cfg]
2022-07-23 V5.54
    V5.54
    [Abdeckplatte_Hinten2.dxf, Abdeckplatte_Vorne1.dxf]
2022-07-23 V5.55
    V5.55
    [Bearing_Fake_18_12_4.3mf, Chassis_V4.0.cfg, Getriebegehäuse_Vorne.cfg, Lagermount_4.3mf, Wheel_Hub_Vorne_Pin_Mount_1.3mf]
2022-07-23 V5.56
    V5.56
    [Chassis_V4.0.cfg]
2022-07-25 V5.57
    V5.57
    [Chassis_V4.0.cfg, Stifttest_4mm_5mm.3mf]
2022-07-28 V5.58
    V5.58
    [Bearing_Fake_24_15_5.3mf, Brezel+Bumper.cfg, Chassis_V4.0.cfg, Getriebegehäuse_Hinten.cfg, Lagermount_1.3mf, Lagermount_2.3mf, Lagermount_3.3mf, Wheel_Hub_vorne_2.3mf]
2022-07-28 V5.59
    V5.59
    [Bumper.3mf, Chassis_V4.0.cfg, Chassis_V5.0.cfg, Getriebegehäuse_Hinten.cfg]
2022-08-01 V5.60
    V5.60
    [Chassis_V4.0.cfg, Chassis_V5.0.cfg, Getriebegehäuse_Hinten.cfg, Lagermount_1.3mf, Slipclutch.cfg]
2022-08-04 V5.61
    V5.61
    [Achse.cfg, Chassis_V4.0.cfg, Chassis_V5.0.cfg, Dämpfung.cfg]
2022-08-05 V5.62
    V5.62
    [Castle Neu 2028 Motor.cfg, Chassis_V4.0.cfg, Chassis_V5.0.cfg, DriveshaftV2.0.cfg, Servo_50KG.cfg]
2022-08-06 V5.63
    V5.63
    [Asm1.cfg, Chassis_V5.0.cfg, Raspberry_PI_Shield_Assembled.cfg, Reciever.cfg]
2022-08-08 V5.64
    V5.64
    [Bearing_fake_14_9_3,5.3mf, Bumper.3mf, Drehbolzen.3mf, Halterung.3mf, Lemkmittelarm.3mf, Lenkwinkel.3mf, Lenkwinkel2.2.3mf, Servo-Arm-Winkel.3mf]
2022-08-08 V5.65
    V6.65
    [Chassis_V4.0.cfg, Chassis_V5.0.cfg]
2022-09-10 V5.66
    V5.66
    [Castle Neu 2028 Motor.cfg, Chassis_Brace.psm, Chassis_V4.0.cfg, Chassis_V5.0.cfg, Cooler 40x40x10 SBORKA.cfg, DC-DC Step Down Buck Converter CC-CV 300W 20A.cfg, DC-DC Step Down Buck Converter CC-CV 300W 20A.step, FULREE DC-DC CONVERTER 15-90V IN 12V 20A OUT.SLDPRT]
2022-09-11 V5.67
    V5.67
    [Chassis_V5.0.cfg]
2022-09-18 V5.70
    V5.70
    [Asm1.cfg, Bearing_fake_14_9_3,5.3mf, Bode Floefd.cfg, Body sim.cfg, Body_3dprint.cfg, Bumper.3mf, Castle Neu 2028 Motor.cfg, Chassis_Brace.psm]
2022-09-26 V5.78
    V5.78
    [Body_3dprint.cfg, Chassis_V5.0.cfg]
2022-09-26 V5.79
    V5.79
    [Body_3dprint.cfg, Chassis_V5.0.cfg]
2022-09-27 V5.81
    V5.81
    [Extreme_E 2_Lichter.3mf]
2022-09-27 V5.82
    V5.82
    [Chassis_V4.0.cfg, Chassis_V5.0.cfg]
2022-09-29 V5.83
    V5.83
    [Body sim.cfg, Chassis_Brace_Fertigung.psm, Chassis_V5.0.cfg]
2022-10-03 V5.84
    V5.84
    [Chassis_V5.0.cfg, KyoceraAVX.xlsx]
2022-10-07 V5.85
    V5.85
    [Body_3dprint.cfg, Chassis_V4.0.cfg, Chassis_V5.0.cfg]
2022-10-17 V5.88
    V5.88
    [7-21-3.dwg, 7inchdisplay .dwg, Acrylic_Main_01.dwg, Acrylic_Main_02.dwg, Chassis_V5.0.cfg, KyoceraAVX.xlsx, LattePanda 3 Delta V1.0 202203.cfg, LattePandaCase_Fan by Dong.dwg]
2022-10-17 V5.90
    V5.90
    [Chassis_V4.0.cfg, Chassis_V5.0.cfg, LattePanda 3 Delta V1.0 202203.cfg]
2022-10-18 V5.91
    V5.91
    [Chassis_V5.0.cfg]
2022-10-20 V5.92
    V5.92
    [Chassis_V5.0.cfg]
2022-10-24 V5.93
    V5,93
    [Abdeckplatte_Hinten2_GCODE.3mf]
2022-10-24 V5.94
    V5.94
    [Chassis_V5.0.cfg]
2022-11-17 V5.96
    V5.96
    [Chassis_Brace.psm, Chassis_V5.0.cfg, Driveshaft_ausschnitt1.3mf, KyoceraAVX.xlsx, KyoceraAVX_V2.0.xlsx, PcbMount.3mf]
2022-12-02 V5.97
    V5.97
    [Chassis_V5.0.cfg]
2022-12-03 V5.98
    V5.98
    [Chassis_V5.0.cfg]
2022-12-10 V6.0
    V6.0
    [Buck_converter_Adapter.3mf, Chassis_V4.0.cfg, Chassis_V5.0.cfg, Fanmount_Buck_Converter.3mf, Wheel_Hub_V2.3mf]
2022-12-14 V6.1
    V6.1
    [Lattepanda_Shield.cfg]
2022-12-14 V6.2
    V6.2
    [Chassis_V5.0.cfg, Sensor_Size_Test.3mf]
2022-12-14 V6.3
    V6.3
    [Body_3dprint.cfg]
2022-12-14 V6.4
    V6.4
    [Extreme_E 2_Lichter_print.3mf, Extreme_Kotflügel vorne rechts.3mf]
2022-12-14 V6.5
    V6.5
    [LattePanda_Shield.cfg, Lattepanda_Shield.cfg]
2022-12-15 V6.6
    V6.6
    [Chassis_V5.0.cfg, LattePanda_Shield.cfg]
2022-12-26 V6.8
    V6.8
    [Body_with_grill1.cfg, Body_with_grill2asm.cfg]
2022-12-26 V6.9
    V6.9
    [Body_with_grill1.cfg, Chassis_V4.0.cfg, Chassis_V5.0.cfg]
2022-12-28 V6.10
    Lattepanda case + bein datensatz
    [Latte Case.cfg, LattePanda 3 Delta V1.0 202203.cfg, Mappe1(Automatisch wiederhergestellt).xlsx, Mappe8.csv, bottom.stl, bottom.stp, m1.csv, m2.csv]
2023-01-03 V6.11
    V6.11
    [Wheel_Hub_vorne_2_V2.3mf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]
2023-01-08 V6.13
    V6.13
    [Chassis_V4.0.cfg, Chassis_V5.0.cfg, Clutch halter_3DPrint.3mf, Clutch halter_top.3mf, Sensor hinten.3mf, Sensor hinten_mir2.3mf, Sensor mount seitlichlinks.3mf, Sensor mount seitlichlinks_mir2.3mf]
2023-01-08 V6.14
    Personen lidar bilder gemacht + gelabeled.
    Librarys importiert. .tflite datei erstellt.
    [Mappe1(Automatisch wiederhergestellt).xlsx, Mappe8.csv, m1.csv, m1.xlsx, m10.csv, m10.xlsx, m11.csv, m11.xlsx]
2023-01-10 V6.20
    V6.20
    [Bumper_LED_Abdeckung_Vorne.dxf]
2023-01-10 V6.21
    V6.21
    [Bode Floefd.cfg, global_parameters.txt]
2023-01-11 V6.24
    V6.24
    [Chassis_V5.0.cfg, Wheel_Hub_V2.3mf]
2023-01-12 V6.25
    V6.25
    [Chassis_V5.0.cfg]
2023-01-16 V6.27
    V6.27
    [Chassis_V4.0.cfg, Chassis_V5.0.cfg, Felge.cfg]
2023-01-17 V6.28
    V6.28
    [Grundplatte_V4.0.dxf]
2023-01-17 V6.29
    V6.29
    [Chassis_V5.0.cfg, Chassis_V6.0.cfg]
2023-01-18 V6.30
    V6.30
    [Chassis_V6.0.cfg]
2023-01-22 V6.31
    V6.31
    [Abdeckung_Driveshaft.stl, Chassis_V6.0.cfg, LipoMount_V2.0.3mf]
2023-01-23 V6.32
    V6.32
    [Chassis_V6.0.cfg, LipoMount_V2.0.3mf]
2023-01-31 V6.33
    V6.33
    [Chassis_V6.0.cfg, Fan Header, 4Pin, 2.54mm, Vertical.cfg, LattePanda_Shield.cfg, Shield_Assembled.cfg]
2023-03-26 V6.38
    V6.38
    [Chassis_V6.0.cfg, LipoMount_V2.0.3mf, LipoMount_V2.0_Deckel.3mf]
2023-03-29 V6.39
    V6.39
    [Chassis_V6.0.cfg]
2023-04-01 V6.40
    V6.40
    [Chassis_V6.0.cfg]
2023-04-13 V6.41
    V6.41
    [Chassis_V6.0.cfg, LipoMount.cfg]
2023-04-13 V6.42
    V6.42
    [Chassis_V6.0.cfg, LipoMount.cfg, LipoMountMount.3mf, LipoMount_Adapter.3mf]
2023-04-18 V6.43
    V6.43
    [Chassis_V6.0.cfg, LipoMount.cfg, LipoMount_Adapter.3mf, LipoMount_mirrored.cfg]
2023-04-19 V6.44
    V6.44
    [Chassis_V6.0.cfg, ESC.cfg]
2023-04-19 V6.45
    V6.45
    [Chassis_V5.0.cfg, Chassis_V6.0.cfg]
2023-04-20 V6.46
    V6.46
    [Chassis_V6.0.cfg]
2023-04-20 V6.47
    V6.47
    [Chassis_V5.0.cfg, Chassis_V6.0.cfg]
2023-05-12 V6.48
    V6.48
    [Chassis_V6.0.cfg, wheelhub_test.cfg]
2023-05-18 V6.49
    V6.49
    [LipoMount_V2.0.3mf, LipoMount_V2.0_Deckel.3mf]
2023-05-18 V6.50
    V6.50
    [Chassis_V6.0_lenkung test.cfg]
2023-05-19 V6.51
    V6.51
    [Chassis_V6.0.cfg, Chassis_V6.0_lenkung test.cfg]
2023-08-25 V6.55
    V6.55
    [Chassis_V6.0.cfg, LipoMount.cfg, LipoMount_mirrored.cfg]
2023-10-01 V6.57
    V6.57
    [Chassis_V6.0.cfg]
2023-10-01 V6.58
    V6.58
    [Chassis_V6.0.cfg]
2023-10-02 V6.59
    V6.59
    [Bearing_fake_14_9_3,5.3mf, Chassis_V6.0.cfg, Drehbolzen.3mf, Halterung.3mf, Lemkmittelarm.3mf, Lenkung_BambuStudio.3mf, Lenkwinkel.3mf, Lenkwinkel2.0.3mf]
2023-10-02 V6.60
    V6.60
    [Chassis_V6.0.cfg]
2023-10-03 V6.61
    V6.61
    [A-Arm_unten.3mf, A-Arm_unten_rechts.3mf, A-Arm_unten_vorne.3mf, A-Arm_unten_vorne_links.3mf, Bestellliste_Schule_V2.0.xlsx, Einkaufsliste.xlsx, KyoceraAVX_V2.0.xlsx, LipoMountMount.3mf]
2023-10-08 V6.62
    V6.62
    [Chassis_V6.0.cfg, DriveshaftV2.0.cfg]
2023-10-08 V6.63
    V6.63
    [Body_with_grill1.cfg]
2023-10-09 V6.64
    V6.64
    [Wheel_Hub_vorne_1_V3.3mf, Wheel_Hub_vorne_1_V3_rechts.3mf, Wheel_Hub_vorne_2_V3.3mf, Wheel_Hub_vorne_2_V3_rechts.3mf]
2023-10-10 V6.65
    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
    [Chassis_V6.0.cfg]
2023-10-15 V6.66
    V6.66
    [Abdeckung_Driveshaft_Teil 1.3mf]
2023-10-16 V6.67
    V6.67
    [Body_3dprint.cfg, Brezel+Bumper.cfg, Chassis_V6.0.cfg]
2023-10-16 V6.68
    V6.68
    [A-Arm_oben.3mf, A-Arm_oben_vorne.3mf]
2023-10-16 V6.73
    V6.73
    [Chassis_V6.0.cfg]
2023-10-22 V6.74
    V6.74
    [Chassis_V6.0.cfg, Differnzial.cfg, GetriebeMount_Hinten.cfg, GetriebeMount_Hinten_Oben.3mf, GetriebeMount_Hinten_Unten.3mf]
2023-10-23 V6.75
    V6.75
    [Chassis_V6.0.cfg, GetriebeMount_Hinten.cfg, GetriebeMount_Hinten_Oben.3mf, GetriebeMount_Hinten_Unten.3mf]
2023-11-05 V6.77
    V6.77
    [A-Arm_oben_vorne.3mf, A-Arm_unten_vorne.3mf, Bestellliste_Schule_V2.0.xlsx, Chassis_V6.0.cfg, Feder_Mount_Vorne.cfg, Feder_mount.cfg, Grundplatte_V5.0_Laser.dxf]
2023-11-07 V6.78
    V6.78
    [Body_1vorne_mitte.cfg, Body_2_mitte.cfg, Body_Bambu_08_11.cfg, Body_with_grill1.cfg, Chassis_V6.0.cfg, Feder_Mount_Vorne.cfg]
2023-11-14 V6.79
    V6.79
    [Bestellliste_Schule_V2.0.xlsx, Bestellung_Partsforstudents.xlsx]
2023-11-16 V6.80
    V6.80
    [Body_Bambu_08_11.cfg]
2023-11-16 V6.81
    Lidar CAD hinzugefügt und in der asm platziert
    [Chassis_V6.0.cfg, YDLidar G2.step]
2023-11-20 V6.81
    V6.81
    [Bestellung_WG_Global.xlsx]
2023-11-28 V6.82
    V6.82
    [A-Arm_Mount_Hinten_Links.3mf, A-Arm_Mount_Hinten_Rechts.3mf, GetriebeMount_Hinten.cfg, GetriebeMount_Vorne.cfg, GetriebeMount_Vorne_Oben.3mf, GetriebeMount_Vorne_Unten.3mf, Getriebegehäuse_Vorne.cfg]
2023-11-28 V6.83
    V6.83
    [GetriebeMount_Vorne_Oben.3mf, GetriebeMount_Vorne_Unten.3mf]
2023-11-29 V6.84
    V6.84
    [GetriebeMount_Vorne_Oben.3mf, GetriebeMount_Vorne_Unten.3mf]
2023-11-29 V6.85
    V6.85
    [ESC_Mount_V2.0.3mf, GetriebeMount_Vorne_Oben_mir.3mf, GetriebeMount_Vorne_Unten_mir.3mf]
2023-11-30 V6.86
    V6.86
    [GetriebeMount_Vorne_Oben_mir.3mf]
2023-12-01 V6.87
    V6.87
    [Abdeckung_Driveshaft_Teil 1.3mf, Wheel_Hub_vorne_1_V3.3mf, Wheel_Hub_vorne_1_V3_rechts.3mf]
2023-12-05 V6.88
    V6.88
    [Bestellliste_Schule_V3.0.xlsx, ESC_Mount_V2.0.3mf, Feder_Mount_Final_Vorne.3mf, Feder_Mount_Vorne.cfg]
2023-12-07 V6.89
    V6.89
    [LipoMountMount.3mf, LipoMountMount_mirrored.3mf, LipoMount_V2.0.3mf, LipoMount_V2.0_mirrored_2.3mf]
2023-12-11 V6.90
    V6.90
    [Chassis_V6.0.cfg]
2023-12-12 V6.91
    V6.91
    [Feder_mount.cfg, GetriebeMount_Hinten.cfg]
2023-12-12 V6.92
    V6.92
    [Chassis_V6.0.cfg]
2023-12-12 V6.93
    V6.93
    [Chassis_V6.0.cfg]
2023-12-12 V6.94
    V6.94
    [A-Arm_unten.3mf]
2023-12-16 V6.96
    V6.96
    [ESC_Mount_V2.0.3mf, Servo_Mount.3mf]
2023-12-17 V6.97
    V6.97
    [Bodymount_hinten.x_t, Bumper_LED_Abdeckung_Vorne.dxf, Bumper_back_2.3mf, Bumper_back_4_1.3mf, Bumper_front.3mf, Chassis_V6.0.cfg, Connector_Test.3mf, LipoMount.cfg]
2023-12-18 V6.98
    V6.98
    [Bumper_back_4.cfg, Bumper_back_4_2.3mf, Bumper_back_4_3.3mf, Chassis_V6.0.cfg]
2023-12-20 V7.01
    V7.01
    [Bumper_back_4.cfg, Bumper_back_4_4.3mf, Chassis_V6.0.cfg, LipoMount_V2.0_Deckel.3mf, LipoMount_V2.0_Deckel_mirrored_2.3mf]
2023-12-24 V7.02
    V7.02
    [A-Arm_oben.3mf, A-Arm_oben_vorne.3mf, Chassis_V6.0.cfg]
2023-12-26 V7.03
    V7.03
    [Chassis_V6.0.cfg]
2024-01-04 V7.04
    V7.04
    [Motor.cfg, Motor_Halterung_Fix.3mf]
2024-01-07 V7.05
    V7.05
    [Chassis_V6.0.cfg]
2024-01-08 V7.06
    V7.06
    [Chassis_V6.0.cfg]
2024-01-18 V7.07
    V7.07
    [Bearing_fake_14_9_3,5.3mf, Bodymount_hinten.stp, Chassis_V6.0.cfg, Drehbolzen.stp, Lemkmittelarm.stp, Lenkwinkel2.0.stp, Lenkwinkel2.20.2_verbessert.stp, Motor.cfg]
2024-01-19 V7.08
    V7.08
    [Chassis_V6.0.cfg, Wheel_Hub_vorne_1_V3.3mf, Wheel_Hub_vorne_1_V3_rechts.3mf]
2024-01-28 V7.09
    V7.09
    [Body_Bambu_08_11.cfg, Chassis_V6.0.cfg]
2024-01-29 V7.10
    V7.10
    [A-Arm_unten_vorne.3mf, A-Arm_unten_vorne_rechts.3mf, Chassis_V6.0.cfg]
2024-01-29 V7.11
    V7.11
    [Chassis_V6.0.cfg, bodymount_hinten_print1.cfg]
2024-01-29 V7.12
    V7.12
    [Body_Bambu_08_11.cfg, Chassis_V6.0.cfg, bodymount_hinten_print1.cfg]
2024-02-20 V7.13
    V7.13
    [Body_Bambu_08_11.cfg, Chassis_V6.0.cfg, bodymount_hinten_print1.cfg]
2024-02-20 V7.14
    V7.14
    [Chassis_V6.0.cfg]
2024-02-22 V7.18
    V7.18
    [Chassis_V6.0.cfg]
2024-02-23 V7.20
    V7.20
    [Abdeckung_Driveshaft_Teil 2.stp, Antisparkswitchmount.stp]
2024-02-23 V7.21
    V7.21
    [Adapter_1_1.stp, Adapter_1_2.stp, Adapter_2_1.stp, Adapter_2_2.stp, Bodymount_hinten_1.stp, Bodymount_hinten_2.stp, LipoMount_V2.0_Orca_Slicer.3mf, Servosave_rad.stp]
2024-02-25 V7.22
    V7.22
    [Body_hinten_links_4row_links.stp, Body_hinten_links_4row_print.stp, Body_rearend_left_print.stp]
2024-02-26 V7.24
    V7.24
    [Body_1vorne_mitte.cfg, Chassis_V6.0.cfg]
2024-02-26 V7.25
    V7.25
    [Extreme_Kotflügel 2 gespiegelt.stp, Extreme_Kotflügel 2 gespiegelt_ORCA.3mf]
2024-02-27 V7.27
    V7.27
    [Chassis_V6.0.cfg]
2024-03-04 V7.29
    V7.29
    [Chassis_V6.0.cfg]
2024-03-04 V7.30
    V7.30
    [Chassis_V6.0.cfg, Lenkwinkel_3.0_non_save_verbessert.stp, Servosleeve2.stp]
2024-03-05 V7.31
    V7.31
    [Chassis_V6.0.cfg, Lenkwinkel2.20.2_verbessert.stp]
2024-03-07 V7.32
    V7.32
    [A-Arm_Mount_Hinten_Links.stp, A-Arm_Mount_Hinten_Rechts.stp, Bodymount_hinten_1.stp, Bumper_back_4_3.stp, Bumper_front_2_1.stp, Chassis_V6.0.cfg]
2024-03-08 V7.33
    V7.33
    [Body_2_links.stp, Body_2_mitte_Bambu.stp, Body_2_rechts.stp, Body_hinten_links_3row_links.stp, Body_hinten_links_3row_print.stp, Body_hinten_links_4row_links.stp, Body_hinten_links_4row_print.stp, Body_rearend_right_print.stp]
2024-03-09 V7.29
    added excel
    [dataTypen_Arduino_Comms.xlsx]
2024-03-10 V7.34
    V7.34
    [dataTypen_Arduino_Comms.xlsx]
2024-03-10 V7.35
    Modified sensorcase
    [Chassis_V6.0.cfg, PcbMount.stp, Sensorcase.3mf, Sensorcase.stp]
2024-03-10 V7.36
    V7.36
    [dataTypen_Arduino_Comms.xlsx]
2024-03-11 V7.38
    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
    [Chassis_V6.0.cfg]
2024-03-13 V7.39
    V7.39
    [Bumper_front_2.cfg, Bumper_front_2_2.stp, Bumper_front_2_3.stp, Bumper_front_2_4.stp]
2024-03-13 V7.40
    V7.40
    [Bumper_front_2.cfg, Bumper_front_2_3.stp, Bumper_front_2_4.stp]
2024-03-18 V7.44
    V7.44
    [Chassis_Brace.psm, Chassis_V6.0.cfg]
2024-03-20 V7.49
    V7.49
    [Achse.cfg, Antriebsstrang.cfg, Bumper_back_4.cfg, Chassis_Achsen.cfg, Chassis_V6.0.cfg, Chassis_V7.0.cfg, Chassis_V7.1.cfg, DriveshaftV3.0.cfg]
2024-03-20 V7.50
    V7.50
    [Chassis_V7.1.cfg]
2024-03-20 V7.52
    V7.52
    [12mm_Switch.cfg, Chassis_V7.1.cfg]
2024-03-26 V.54
    gerber file added
2024-03-31 V7.58
    V7.58
    [Chassis_V7.1.cfg]
2024-03-31 V7.62
    V7.62
    [Body_Bambu_08_11.cfg, Bumper_front_2.cfg, Chassis_V7.1.cfg]
2024-04-01 V7.64
    V7.64
    [Chassis_Brace.psm, Chassis_V7.1.cfg, PCBMount.cfg]
2024-04-01 V7.66
    V7.66
    [Chassis_V7.1.cfg, LipoMount_mirrored.cfg]
2024-04-01 V7.69
    Zwischenstand diplomarbeit und bilder
2024-04-02 V7.75
    V7.75
    [Chassis_Brace.psm, Chassis_V7.1.cfg]
2024-04-02 V7,78
    V7.78
    [Chassis_V7.1.cfg, LipoMount.cfg, Mappe1(Automatisch wiederhergestellt).xlsx, m1.csv, m1.xlsx, m10.csv, m10.xlsx, m11.csv]
2024-04-02 V7.79
    V7.79
    [Mappe1(Automatisch wiederhergestellt).xlsx, m1.csv, m1.xlsx, m10.csv, m10.xlsx, m11.csv, m11.xlsx, m12.csv]
2024-04-26 V7.91
    V7.91
    [dataTypen_Arduino_Comms.xlsx]
2024-05-12 V7.94
    V7.94
    [Body_Bambu_08_11.cfg, Chassis_V7.1.cfg]
2024-05-12 V7.95
    V.95
    [Chassis_V7.1.cfg]
2024-05-12 V7.96
    V7.96
    [Body_Bambu_08_11.cfg, Chassis_V7.1.cfg]
2024-05-13 V7.97
    V7.97
    [Body_2_links.stp, Body_2_rechts.stp, Body_hinten_links_3row_links.stp, Body_hinten_links_3row_print.stp, Body_hinten_links_4row_print.stp, Body_hinten_links__unten_3row_print.stp, Body_hinten_rechts_3row_print.stp, Body_hinten_rechts_3row_rechts.stp]
2024-05-13 V7.98
    V7.98
    [Chassis_V7.1.cfg]
2024-05-13 V7.99
    V7.99
    [Chassis_V7.1_simply.cfg]
2024-05-13 V8.00
    V8.00
    [Chassis_V7.1.cfg]
2024-05-13 V8.01
    V8.01
    [dataTypen_Arduino_Comms.xlsx]
2024-05-14 V8.02
    V8.02
    [Body_2_mitte_Bambu.stp, Body_front_mount.stp, LattePandaShield_Complete_Assembly.cfg, Leiterplatte v5.cfg, MULTIPLEX CONNECTOR.cfg]
2024-05-14 V8.04
    V8.04
    [Chassis_V7.1_simply.cfg, Chassis_V8.cfg]
2024-05-23 V8.05
    V8.05
    [Chassis_V7.1.cfg]
