unlegitGurke/RC-Car/(notices)

Notices in the files:
parts and their libraries:
resistor-array: Copyright (C) 2008, Bob Starr
SparkFun-IC-Logic: Licensing: Creative Commons ShareAlike 4.0 International - https://creativecommons.org/licenses/by-sa/4.0
